12romis/esp32-elrs-rover/README.md

# ESP32-ELRS-Rover
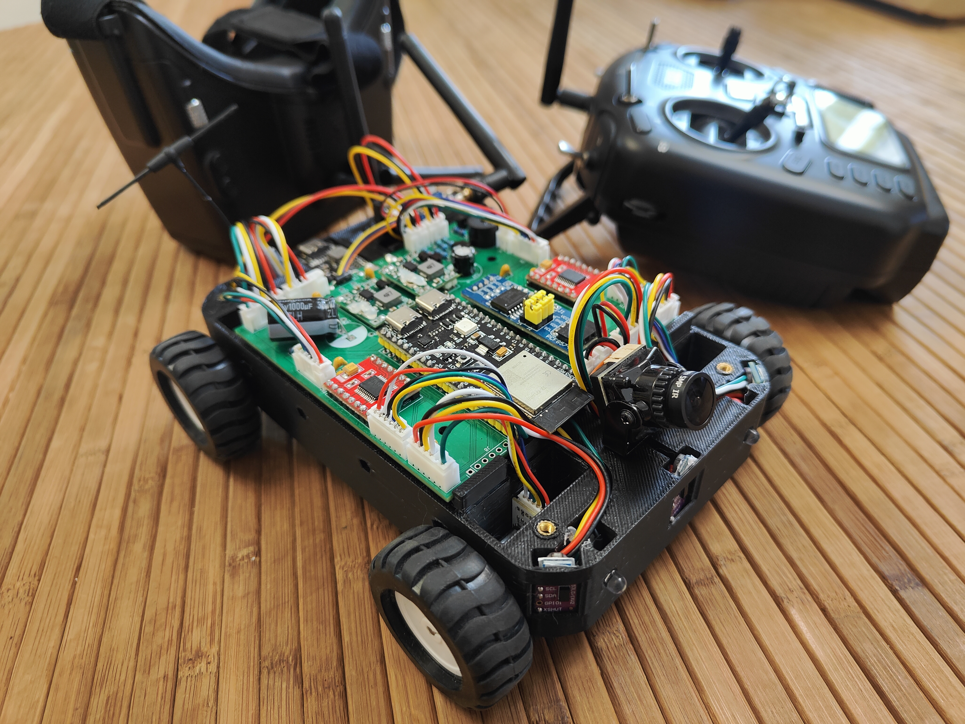
[picture p1: IMG20261026125321.jpg]

Ровер на ESP32-S3 (YD-ESP32-S3 N16R8) з керуванням через ExpressLRS/CRSF. ESP-IDF v6.1, C. Танковий привід: два борти по два колеса,
енкодери на кожному колесі, регулятор швидкості бортів, чотири далекоміри VL53L0X, світло, зумер, вбудований RGB-індикатор плати.

## Що вміє ровер

- Їде за правим стіком пульта (тяга й поворот), озброюється тумблером (канал 5), тримає швидкість бортів регулятором.
- Зупиняється при втраті звʼязку довше за 0.5 с, при напрузі акумулятора нижче 6.0 В і перед перешкодою (стан OBSTACLE_HOLD).
- Повертає на пульт напругу акумулятора (телеметрія) і показує стан утримання звуком, кольором індикатора й блиманням світла.
- Тумблер CH9 вмикає й вимикає контроль перешкод; зеленуватий індикатор плати показує, що контроль ввімкнений і реально охороняє.
- Після кожної сесії (озброєння → вихід з руху) надсилає на сервер власника звіт (JSON, MQTT поверх TLS) лише в DISARMED; невдалі
  звіти (до двох) зберігаються в пам'яті плати.
- Консоль через USB: стан, команди руху (стендовий режим), світло, зумер, енкодери, регулятор, далекоміри, звіти.

## Структура репозиторію

- `docs/` — контекст заліза й прошивки (`01-ASSEMBLY-BRINGUP.md`, `02-FIRMWARE-CONTEXT.md`), конституція (`constitution.md`),
  журнал вимірювань (`measured.md`), блок-схема (`architecture.md`), чекліст самоперевірки (`self-check.md`), дорожня карта
  (`roadmap.md`), специфікації фаз у `docs/features/<фаза>/`.
- `kicad-rover/` — схема й плата (лише читання).
- `main/`, `components/` — прошивка. Кожен компонент ділиться на `<name>_core.c` (чиста логіка, без ESP-IDF) і `<name>_hal.c`.
- `test/host/` — хостові тести чистої логіки і перевірки правил проєкту.
- `tools/bringup/` — діагностичні прошивки P0–P7 (результати — у `docs/measured.md`).

Усі номери ліній GPIO — лише в `components/board/include/board_pins.h`.

## Збірка, прошивка, тести

Збірка (потрібне середовище ESP-IDF v6.1):

```bash
source ~/.espressif/tools/activate_idf_v6.1.sh
idf.py build
```

Прошивку на плату робить Розробник через розширення ESP-IDF у VS Code (ціль `esp32s3`); агент лише збирає. Після прошивки відкрити
монітор, консоль відповідає на `help`.

Хостові тести й перевірки правил (звичайний gcc, без плати):

```bash
test/host/run_tests.sh
```

Опис перевірок — у `test/host/README.md`. Перевірки з правками захищених файлів на гілці фази: `ALLOW_PROTECTED=1 test/host/check_protected.sh`.

## Інтерфейси

### Консоль (USB)

Повний список — команда `help`. Права команд залежать від стану автомата (`status` показує стан і історію переходів).

| Команда | Призначення |
|---|---|
| `help`, `status` | довідка; стан, час роботи, пам'ять, причина скидання, сховище, світло, індикатор, пульт, **час кроку керування**, енкодери, історія переходів |
| `arm`, `drive <тяга> <поворот>` | озброєння і рух (`drive` діє 2 с) — з консолі лише в стендовому режимі, до появи пульта |
| `disarm` | роззброєння — у будь-якому стані |
| `light`, `beep` | світло й зумер: `light` у DISARMED (в ARMED лише `light head`), `beep` у DISARMED і ARMED; в OBSTACLE_HOLD обидві відхиляються |
| `enc [reset]` | знімок енкодерів |
| `pid ...` | регулятор швидкості бортів |
| `tof [reinit]` | далекоміри, сектори, поріг; `reinit` лише в DISARMED |
| `report` | звіти сесій: черга (до двох), режим контролю перешкод, мережа; у DISARMED запускає спробу передачі негайно, в інших станах лише показує стан. Пароль і SSID не друкуються: «задано / не задано» |
| `reboot`, `wdt-test` | службові (лише в безпечних станах) |

### Пульт

Канали CRSF: 1 — поворот, 2 — тяга, 5 — ARM/DISARM (тумблер), **9 — режим контролю перешкод** (див. нижче), 8 — трипозиційний перемикач, за P5 призначений під фари (у прошивці поки не використовується; докладно: `docs/02-FIRMWARE-CONTEXT.md` §1.3 і `docs/measured.md`).

**CH9 — контроль перешкод.** Значення каналу вище середини (> 992) — контроль **увімкнено**, інакше — **вимкнено** (далекоміри лише міряють,
ровер не зупиняється перед перешкодою; відсічка по напрузі, втрата зв'язку, STBY, I²C діють без змін). Поки пульт не передав
кадр або зв'язок втрачено — контроль **увімкнено** (`status` пише «за замовчуванням, пульт не підтвердив»). У мікшері EdgeTX
виведіть вибраний тумблер (SB, SC, SE чи SF) на канал CH9. Два положення цього тумблера **ще не виміряні**: Розробник записує їх у
`docs/measured.md` (spec OQ-6); до заміру канал без призначеного тумблера стоїть на 992 і вимикає захист.

### Телеметрія на пульт

Раз на 200 мс ровер надсилає кадр датчика батареї CRSF: **напруга з розв'язністю 0.1 В**. **Струм, ємність і відсоток заряду нульові
й означають «немає даних»** (датчиків немає): пульт може показувати «0 А» чи «0 %» — це не вимір. Якщо свіжого виміру напруги немає,
кадр не надсилається. На пульті датчик має знайтися автоматично (на модулі передавача співвідношення телеметрії не «вимкнено»).

### Індикація станів

| Стан | Зумер | Індикатор плати | Світло |
|---|---|---|---|
| DISARMED | короткий сигнал на вході | **зеленуватий**, якщо контроль перешкод ввімкнений і хоч один далекомір охороняє; інакше погашений | задні ліхтарі червоні, фари вручну |
| ARMED | короткий сигнал на вході | те саме (зеленуватий лише за ввімкненого контролю й охорони) | фари автоматично, задні ліхтарі: жовтий уперед, зелений назад |
| OBSTACLE_HOLD | подвійний біп на вході; на виході в ARMED — один сигнал 200 мс | **жовтий** | передній сектор зайнятий — блимають фари; задній — блимають задні ліхтарі |
| FAILSAFE | сигнал на вході, писк кожні 2 с | червоний | задні ліхтарі блимають червоним |

Пріоритет кольорів: червоний (FAILSAFE) > жовтий (OBSTACLE_HOLD) > зеленуватий > погашений. У BOOT, SELFTEST і FAULT індикатор
погашений. Консоль при вході в утримання називає **кожен** датчик сектора, що бачить перешкоду, з відстанню.

### Звіт сесії

Сесія — від озброєння до виходу з ARMED/OBSTACLE_HOLD у DISARMED чи FAILSAFE. Після неї ровер у DISARMED вмикає Wi-Fi лише на
коротку спробу (до 30 с), публікує один JSON-звіт на сервер (`rover/<mac>/session`, QoS 1) і одразу вимикає Wi-Fi. Озброєння
перериває спробу. Якщо доставити не вдалось, до двох останніх звітів лежать у пам'яті плати (переживають перезапуск, зокрема FAILSAFE
через напругу) і йдуть при наступному DISARMED або командою `report`. Поля звіту — [contracts/events.md](docs/features/phase8-session-report/contracts/events.md).

Налаштування мережі (**секрети не потрапляють у git**):

1. Скопіюйте `components/report/report_secrets.example.h` у `components/report/report_secrets.h` (файл у `.gitignore`) і заповніть
   SSID та пароль Wi-Fi, адресу й порт сервера (8883), ім'я користувача й пароль сервера. Пароль із чату вважайте скомпрометованим.
2. Покладіть кореневий сертифікат власника в `components/report/certs/root_ca.pem` (публічний, може бути в git). Дані не
   надсилаються без перевірки сертифіката сервера.
3. Після появи файлів виконайте `idf.py fullclean`. Без них збірка проходить, а передача вимкнена з одним поясненням у журналі.

Після оновлення `sdkconfig.defaults` (більший розділ застосунку, lwip на core 0) видаліть згенерований `sdkconfig` і зберіть та прошийте
заново — таблиця розділів змінюється (NVS лишається на місці).

### Відомі обмеження звіту сесії

- TP3 під Wi-Fi **не виміряно** (spec OQ-5): до заміру спроби передачі проводьте на повному акумуляторі чи живленні, що тримає межу.
- Положення CH9 на TX12 **не виміряні** (spec OQ-6, див. вище).
- Час підключення Wi-Fi і TLS, тривалість запису в пам'ять, вплив на `crc_fail` приймача **не виміряні** — чекліст приймання:
  [acceptance.md](docs/features/phase8-session-report/acceptance.md).
- Абсолютного часу немає: звіти без дат, сервер ставить мітку отримання.
- Пробіг рахується за лічильниками коліс при діаметрі 44 мм; проковзування не враховано.
## Безпека

Інваріанти (конституція, п. 7): STBY піднімається тільки в стані руху й свідомо; втрата кадрів CRSF довше за 0.5 с — ШІМ у нуль і
STBY вниз; перша операція на шині I²C — запис нуля в розширювач; напруга нижче 6.0 В — мотори не запускаються. Телеметрія й індикація
їх не змінюють і не затримують керування.

## Статус перевірки

Що перевірено на залізі, а що ні, — у `docs/self-check.md`. Приймання на залізі записує Розробник.
