12romis/esp32-elrs-rover/docs/features/phase8-session-report/_review/review-2026-10-22.md

# Рев'ю phase8-session-report — 2026-10-22

**Scope:** робоче дерево гілки `feature/phase8-session-report` проти `main` (зміни не закомічені), 55 змінених файлів + нові `components/session`, `components/report`, чотири нові хостові тести.
**Рецензент:** sdd:reviewer, чистий контекст, лише читання.
**Хостові перевірки рецензента:** `run_tests.sh` 15601/15601; усі `check_*.sh` чисті.
**Gate:** PASS (усі stage-1 розв'язано; єдина відкладена знахідка — stage-2 № 5, OQ-7). Після виправлень: `run_tests.sh` 15610/15610, усі `check_*.sh` чисті, `idf.py build` без попереджень компіляції, окрема збірка з TLS-гілкою — теж.

## Знахідки

| # | Стадія | Заголовок | Вердикт |
|---|---|---|---|
| 1 | stage-1 | Гонка: підсумок сесії з'являється на ~20 мс пізніше за вхід у DISARMED — звіт не надсилається (AC-10, AC-24) | Fixed: `report_entry_pending/ready` у `report_queue_core` (+тест), `report_hal` розв'язує вхід, коли сесія закрита; `session_hal` ставить `active=false` після відправки підсумку |
| 2 | stage-1 | OQ-6: положення CH9 не записані; 992 = «вимкнено» (AC-01, AC-04, AC-05) | Fixed (у межах агента): AC-01…AC-05 позначено у `acceptance.md` і spec OQ-6 як неприйнятні до заміру; сам замір — за Розробником (п. 13 конституції) |
| 3 | stage-1 | events.md: `mac` у таблиці на верхньому рівні, у прикладах і SAD §5 — у `fw{}` (AC-11) | Fixed: events.md (приклади) і SAD §5 вирівняно за кодом (`mac` — верхній рівень); запис в api-sync-report |
| 4 | stage-1 | AC-21/A9 «звіт це пояснює» — лише `null`, пробіг за одним бортом не позначено | Fixed: поле `encoders{left,right}` у звіті (+тести), events.md; `schema_version` лишено 1 (адитивна зміна) |
| 5 | stage-2 | Спробу не перервати озброєнням під час TCP-з'єднання/DNS (блокуючий select до 10 с) (AC-18, AC-19) | Deferred: spec §8 OQ-7, owner Розробник/Агент, due before acceptance; перевірка в кроках 12 і 20 acceptance |
| 6 | stage-2 | Класифікація «сертифікат не довірений» порівнює не ту змінну (AC-22) | Fixed: класифікація за `esp_err_t last` з `esp_tls_get_and_clear_last_error`; збірка з сертифікатом чиста |
| 7 | stage-2 | Стрибок пробігу, коли колесо стає недоступним посеред сесії (AC-20) | Fixed: приріст пробігу по колесах, доступних на двох кроках поспіль (`session_hal.c`) |
| 8 | stage-2 | Хибний рядок журналу при виході з утримання вимкненням CH9 (AC-02) | Fixed: рядок «контроль перешкод вимкнено — повернення в ARMED» |
| 9 | stage-2 | Правки bc4aedd і measured.md:17 (170 мм) змішані з фазою 8 | Fixed: measured.md:17 виправлено; відокремлення правок bc4aedd — окремим комітом під час коміту (див. handoff) |

Деталі, `file:line` і пропозиції — у звіті рецензента (див. розмову); кожна знахідка нижче доповнюється вердиктом після розв'язання.
