12romis/esp32-elrs-rover/docs/roadmap.md

---
status: living
updated_at: "2026-10-21"
---

# Roadmap — ESP32-ELRS-Rover

> **Декомпозиція, а не обіцянка.** Ідея розбита на інкрементальні кроки: що кожен крок собою являє, звідки походить, наскільки великий, і в якому порядку їх проходити. **Без дат** (крім історії завершеного), **без оцінок пріоритету** — порядок і є пріоритетом. *Рішення* для кожного кроку живе у його специфікації `docs/features/<slug>/spec.md`, не тут. Джерело вимог — `docs/02-FIRMWARE-CONTEXT.md`, розділ 7.

## Destination

Ровер на ESP32-S3 їде за стіками пульта ELRS танковим приводом з регулюванням швидкості, зупиняється при втраті звʼязку, розряді батареї чи перед перешкодою й повертає телеметрію на пульт.

## Pre-phases (P0–P7) — outside SDD

<!-- Це НЕ кроки SDD: діагностичні прошивки, вимірювальні інструменти. Для них немає ні специфікації, ні плану, ні задач; не проходять рев'ю якості коду. Живуть у `tools/bringup/` (перемикач BRINGUP_TEST). Результат — число в `docs/measured.md`; передфаза пройдена, лише коли число записане там. -->

Це діагностичні прошивки. Вони **не проходять цикл SDD**: у них немає специфікації, плану й задач. Їхній єдиний результат — числа в `docs/measured.md`, які закривають «?» у розділі 9 документа 02 (`docs/02-FIRMWARE-CONTEXT.md`, §7.0).

| ID | Передфаза | Залізо | Що закриває | Стан |
|---|---|---|---|---|
| P0 | тулчейн, чіп, PSRAM | плата з U3, USB | `sdkconfig` під N16R8 | пройдено |
| P1 | скан I²C | + U6, далекоміри від'єднані | `PCF8574_ADDR` | пройдено |
| P2 | виходи PCF8574 і світло | + фари J2/J3, ліхтарі J5/J6 | карта бітів §2.1 | пройдено |
| P3 | ADC батареї, двоточкове калібрування | акумулятор або блок на J1 | `VBAT_SCALE`, `VBAT_OFFSET`, `VBAT_CUTOFF_MV` | одна точка з двох знята (8.26 В), друга потрібна до фази 1 |
| P4 | далекоміри і перепризначення адрес | + U7…U10 на шлейфах | `TOF_OBSTACLE_MM`, драйвер VL53L0X (§10.3) | пройдено (послідовність 10/10, драйвер підтверджено); `TOF_OBSTACLE_MM` — на шасі |
| P5 | приймання CRSF | + приймач у J7 | `CRSF_BAUD`, карта каналів §1.3 | пройдено (420000, карта каналів підтверджена, CH8 = фари) |
| P6 | енкодери, обертання рукою | + мотори на шлейфах | `ENC_PULSES_PER_REV`, `ENC_NEEDS_PULLUP` | пройдено (2772 імп/оберт, підтяжки не потрібні) |
| P7 | мотори на мінімальному ШІМ і знак енкодера | усе, колеса в повітрі | `ENC_DIR_SIGN[4]`, прив'язка §2.2 | пройдено (знак +1, −1, +1, −1); FR повільний, причину перевірити |

Без прошивки вимірюються `WHEEL_DIAMETER_MM` і `WHEEL_BASE_MM` (штангенциркуль, лінійка); `MOTOR_MAX_PWM` лишається 0.75 до фази 5.

### Gates

Яка фаза не починається, доки не пройдено які передфази (`docs/02-FIRMWARE-CONTEXT.md`, §7.0):

| Фаза | Не починати, доки не пройдено |
|---|---|
| Фаза 0 — скелет | P0 |
| Фаза 1 — мотори | P0, P3, P7 |
| Фаза 2 — I²C, світло | P1, P2 |
| Фаза 3 — ELRS | P5 |
| Фази 4–5 — енкодери, PID | P6, P7 |
| Фаза 6 — далекоміри | P4 |

Фаза 7 власних воріт не має, її обмежують залежності від фаз 3, 5 і 6 (див. граф).

## Steps

<!-- Фази прошивки: проходять цикл SDD, одна фаза = одна фіча зі своїм слагом і специфікацією в docs/features/<slug>/. Слаг у колонці Step. -->

| # | Step | Source | Size | Status |
|---|---|---|:---:|---|
| 0 | `phase0-skeleton` — прошивається, консоль відповідає, WDT зареєстрований, стан BOOT друкується | `docs/02-FIRMWARE-CONTEXT.md` §7, «Фаза 0 — скелет» | S | shipped — [spec](features/phase0-skeleton/spec.md) |
| 1 | `phase1-drive` — `drive 0.3 0` крутить борти, `disarm` зупиняє, при VBAT < 6.0 В мотори не стартують | `docs/02-FIRMWARE-CONTEXT.md` §7, «Фаза 1 — живлення і мотори» | M | shipped — [spec](features/phase1-drive/spec.md) |
| 2 | `phase2-io` — світло й зумер керуються з консолі, при старті світла немає | `docs/02-FIRMWARE-CONTEXT.md` §7, «Фаза 2 — I²C, PCF8574, світло, зумер» | S | shipped — [spec](features/phase2-io/spec.md) |
| 3 | `phase3-crsf` — стіки пульта рухають мотори, вимкнення пульта зупиняє за 500 мс | `docs/02-FIRMWARE-CONTEXT.md` §7, «Фаза 3 — ELRS / CRSF» | S | shipped — [spec](features/phase3-crsf/spec.md) |
| 4 | `phase4-encoders` — чотири лічильники дають стабільні оберти зі знаком і без зривів | `docs/02-FIRMWARE-CONTEXT.md` §7, «Фаза 4 — енкодери» | S | shipped — [spec](features/phase4-encoders/spec.md) |
| 5 | `phase5-pid` — борт тримає задану швидкість під навантаженням, коефіцієнти міняються з консолі | `docs/02-FIRMWARE-CONTEXT.md` §7, «Фаза 5 — PID» | S | shipped — [spec](features/phase5-pid/spec.md) |
| 6 | `phase6-tof` — ровер зупиняється перед перешкодою, дозволяє здати назад, переживає відмову сенсора | `docs/02-FIRMWARE-CONTEXT.md` §7, «Фаза 6 — далекоміри й протизіткнення» | S | shipped — [spec](features/phase6-tof/spec.md) |
| 7 | `phase7-telemetry` — пульт бачить напругу батареї, OBSTACLE_HOLD чути й видно (подвійний біп, жовтий індикатор, блимання фар і ліхтарів), є README, блок-схема й заповнений чекліст | `docs/02-FIRMWARE-CONTEXT.md` §7, «Фаза 7 — телеметрія, інтеграція, документація»; запит Розробника 2026-10-21 (індикація OBSTACLE_HOLD) | S | shipped — [spec](features/phase7-telemetry/spec.md) |
| 8 | `phase8-session-report` — тумблер CH9 вмикає/вимикає контроль перешкод (зеленуватий індикатор), консоль називає всі датчики, що бачать перешкоду; після роззброєння ровер надсилає звіт сесії (JSON) через Wi-Fi і MQTT, Wi-Fi вимикається одразу, при невдачі лишаються дві останні сесії | запит Розробника 2026-10-22 | M | spec'd — [spec](features/phase8-session-report/spec.md) |

## Not yet specified

<!-- Туман з'явився 2026-10-20: захист від заклинення і підняття межі потужності винесено з фази 5. -->

| Area | What we'd have to learn | Blocks | How it gets sharpened |
|---|---|:---:|---|
| Захист від заклинення борту і підняття межі потужності вище 0.75 | поріг часу заклинення на 0.75 і безпечну межу вище 0.75 (заміри OQ-1, OQ-2 зі `features/phase5-pid/spec.md`); межа не піднімається, доки захисту немає | — | винесено з фази 5 рішенням Розробника 2026-10-20; оформити окремим кроком після фази 5 через `/sdd:roadmap`, коли Розробник візьметься за заміри |

## Out of scope

- — (джерела нічого не виносять за межі проєкту)

## Open decisions

| # | Question | Type | Owner | Blocks |
|---|---|:---:|:---:|:---:|
| D2 | `CRSF_BAUD`: 420000 чи 416666 (§10.2) | prototype | human | 3 |

## Decisions so far

- `PCF8574_ADDR` = `0x20`, на шині рівно один пристрій → [`docs/measured.md`](measured.md)
- Конституція проєкту з 14 пунктів (core/HAL, заборона вигадувати константи, інваріанти безпеки) → [`docs/constitution.md`](constitution.md)
- Передфази P0–P7 поза циклом SDD, один проєкт `tools/bringup` з перемикачем → [`docs/02-FIRMWARE-CONTEXT.md`](02-FIRMWARE-CONTEXT.md) §7.0
- Поточна архітектура: 1 реальний компонент і 9 заглушок → [`docs/architecture-map.md`](architecture-map.md)
- Прозвонка моторних шлейфів пройдена (піни 1–2 обмотка ≈ 12 Ом, ізоляція до пінів 3–6) → [`docs/measured.md`](measured.md)
- D3 закрито: вихід енкодера не відкритий колектор, усі чотири енкодери рахують без підтяжок, переробка плати не потрібна (`ENC_NEEDS_PULLUP` = 0, P6, 2026-10-17) → [`docs/measured.md`](measured.md)
- D4 закрито: драйвер VL53L0X — мінімальний власний (варіант 3 з §10.3), підтверджено P4 (2026-10-16) і реалізовано у `components/tof/tof_hal.c` → [`docs/measured.md`](measured.md)
- `TOF_OBSTACLE_MM` = 170 мм (вибіг ≤ 30 мм + реакція ≈ 86 + похибка датчика ≈ 12, рішення Розробника, 2026-10-21) → [`docs/measured.md`](measured.md)

## Dependency graph

```mermaid
flowchart LR
  P0["P0 · chip psram"]
  P1["P1 · i2c scan"]
  P2["P2 · pcf light"]
  P3["P3 · adc vbat"]
  P4["P4 · tof"]
  P5["P5 · crsf"]
  P6["P6 · encoders"]
  P7["P7 · motors sign"]
  s0["0 · skeleton"]
  s1["1 · drive"]
  s2["2 · io"]
  s3["3 · crsf"]
  s4["4 · encoders"]
  s5["5 · pid"]
  s6["6 · tof"]
  s7["7 · telemetry"]
  s8["8 · session report"]
  P0 -->|sdkconfig N16R8| s0
  P0 -->|sdkconfig N16R8| s1
  P3 -->|VBAT cutoff| s1
  P7 -->|ENC_DIR_SIGN, wiring| s1
  P1 -->|PCF8574_ADDR| s2
  P2 -->|bit map| s2
  P5 -->|CRSF_BAUD, channel map| s3
  P6 -->|pulses per rev, pullup| s4
  P7 -->|ENC_DIR_SIGN| s4
  P6 -->|pulses per rev| s5
  P7 -->|ENC_DIR_SIGN| s5
  P4 -->|TOF driver, threshold| s6
  P1 -->|needs working I2C scan| P4
  P6 -->|wheel to connector map| P7
  s0 -->|board_pins, build, WDT, states| s1
  s0 -->|board_pins, build, WDT, states| s2
  s1 -->|drive_set and arm disarm| s3
  s2 -->|buzzer for failsafe| s3
  s1 -->|motors wired| s4
  s4 -->|speed feedback| s5
  s2 -->|PCF8574 XSHUT, I2C mutex| s6
  s1 -->|obstacle limits drive| s6
  s3 -->|CRSF telemetry back| s7
  s5 -->|loop timing in telemetry| s7
  s6 -->|integration| s7
  s7 -->|indicator, hold line| s8
  s3 -->|CH9 switch| s8
  s5 -->|board speeds| s8
  s6 -->|ToF off switch, sensors| s8
```

## Execution path

Хвилі йдуть послідовно, одна фаза за раз, без паралельних ліній (рішення власника). Передфази з колонки Gates мають бути пройдені до початку відповідної хвилі.

| Wave | Steps | Zone per step (why parallel-safe) | Unlocks |
|:---:|---|---|---|
| 1 | 0 | 0: `main/`, `components/board/` | 1, 2 |
| 2 | 1 | 1: `components/drive/`, `components/battery/`, `main/` | 3, 4 |
| 3 | 2 | 2: `components/ioexp/`, `components/ui/` | 3, 6 |
| 4 | 3 | 3: `components/crsf/` | 7 |
| 5 | 4 | 4: `components/encoders/` | 5 |
| 6 | 5 | 5: `components/pid/` | 7 |
| 7 | 6 | 6: `components/tof/` | 7 |
| 8 | 7 | 7: `components/telemetry/`, `README.md` | 8 |
| 9 | 8 | 8: нові компоненти сесії й звіту (назви визначить design), `components/ui/`, `components/tof/`, `components/drive/`, `components/rover_console/` | — |

## Shipped

| Step | Shipped | Link |
|---|---|---|
| 0 `phase0-skeleton` | 2026-10-18 | [changelog](features/phase0-skeleton/changelog.md) |
| 1 `phase1-drive` | 2026-10-18 | [changelog](features/phase1-drive/changelog.md) (AC-13, AC-15, AC-22 чекають OQ-1) |
| 2 `phase2-io` | 2026-10-18 | [changelog](features/phase2-io/changelog.md) (AC-14, AC-15 на залізі не перевірені: розширювач запаяний) |
| 3 `phase3-crsf` | 2026-10-18 | [changelog](features/phase3-crsf/changelog.md) (AC-14 і NFR ≤ 50 мс на залізі не показані; T13–T18 на залізі не прогнані) |
| 4 `phase4-encoders` | 2026-10-19 | [changelog](features/phase4-encoders/changelog.md) (крок 2 для FL і RL поза ±2 % — прийнято як похибку ручного обертання) |
| 5 `phase5-pid` | 2026-10-20 | [changelog](features/phase5-pid/changelog.md) (приймання на залізі AC-01, -02, -05, -06, -10, -13, -14 і KPI відкладено Розробником — `acceptance.md`) |
| 6 `phase6-tof` | 2026-10-21 | [changelog](features/phase6-tof/changelog.md) (приймання на залізі AC-01…AC-12, AC-14…AC-16, KPI і OQ-2 відкладено Розробником — `acceptance.md`) |
| 7 `phase7-telemetry` | 2026-10-21 | [changelog](features/phase7-telemetry/changelog.md) (приймання на залізі AC-01…AC-16, KPI, OQ-1, OQ-3, OQ-4 чекають Розробника — `acceptance.md`) |
