12romis/esp32-elrs-rover/docs/self-check.md

# Чекліст самоперевірки

Складений за таблицею документа 02 §5 «Обсяг прошивки — що має бути реалізовано» (phase7-telemetry, AC-18). Кожен рядок має статус і
посилання на доказ. Статуси:

- **виконано** — властивість не залежить від заліза й доведена статичною перевіркою чи хостовим тестом (структура коду, таблиця переходів, правила проєкту), або поведінку на залізі прийнято Розробником (запис у журналі вимірювань);
- **частково** — частина доведена, решта названа у стовпці «Доказ і застереження»; «лише хост» означає, що поведінку на залізі не перевіряли;
- **не перевірено на залізі** — код і хостові тести є, приймання на залізі Розробник ще не записав.

Жоден пункт не позначено виконаним без доказу. Приймання на залізі записує лише Розробник.

| # | Підсистема (документ 02 §5) | Статус | Доказ і застереження |
|---|---|---|---|
| 1 | Задачі: FreeRTOS, розділення по ядрах | виконано | `control` (core 1), `crsf_rx` (core 1), `sensors`, `ui`, `battery`, `telemetry` (core 0), задача трасування `pid`: `components/*/*_hal.c`; документ 02 §6.1. Приймання фаз 0–4 — у журналі вимірювань; фази 5–7 на залізі не перевірені |
| 2 | Планування: без блокуючих затримок | виконано | `test/host/check_delays.sh` чистий; винятки (очікування готовності регістра в `battery_hal.c`, `tof_hal.c`) названо в `test/host/README.md` |
| 3 | Стани: таблиця переходів, лог переходів | виконано | `components/app_state/app_state_core.c`, 12 дозволених пар із 49, `test/host/test_app_state.c`; історія переходів у `status`. Приймання фаз 0–3 на залізі — [phase0](features/phase0-skeleton/changelog.md), [phase3](features/phase3-crsf/changelog.md) |
| 4 | Модульність: компонент на підсистему, GPIO лише в `board_pins.h` | виконано | `test/host/check_pins.sh`, `check_core_headers.sh`; `components/board/include/board_pins.h` |
| 5 | Аналогове: ADC батареї, LEDC (мотори, зумер) | частково | ADC: двоточкове калібрування в `docs/measured.md` (P3), `test/host/test_battery.c`. Мотори: [phase1](features/phase1-drive/changelog.md) — AC-13, AC-15, AC-22 чекають OQ-1. Зумер: прийнято на залізі у фазі 2 (`docs/measured.md`) |
| 6 | Цифрове: UART (CRSF), I²C (ToF, PCF8574) | частково | UART: приймання фази 3 — [changelog](features/phase3-crsf/changelog.md) (AC-14 і NFR ≤ 50 мс на залізі не показані). I²C 100 кГц: `check_bus_rules.sh`; розширювач запаяний, кроки 13–14 фази 2 не виконані ([phase2](features/phase2-io/changelog.md)); далекоміри на залізі — [phase6](features/phase6-tof/acceptance.md), не перевірено |
| 7 | Переривання: PCNT watch-point, UART event queue | частково | PCNT: приймання фази 4 — [changelog](features/phase4-encoders/changelog.md) (крок 2 для FL і RL поза ±2 % прийнято як похибку ручного обертання). Подієва черга UART — фаза 3 |
| 8 | Обмін між задачами: черги, без глобальних змінних | частково | Для знімків використано `portMUX` (ADR-0001 фази 4), для команд моторів — черга; це відступ від «лише черги» документа 02, зафіксований у ADR фаз 1–6 ([phase4 ADR-0001](features/phase4-encoders/adr/)) |
| 9 | Синхронізація: мʼютекс шини, спільна памʼять під захистом | виконано | `i2c_bus_lock` (ADR-0001 фази 2), `m_ui` у `ui_hal.c`, знімки під `portMUX`; `check_bus_rules.sh` |
| 10 | Зворотний звʼязок: енкодери → швидкість борту | не перевірено на залізі | Фаза 4 прийнято на залізі ([changelog](features/phase4-encoders/changelog.md)); використання в регуляторі — фаза 5, приймання відкладено ([changelog](features/phase5-pid/changelog.md)) |
| 11 | Регулювання: PID по швидкості на борт | не перевірено на залізі | `test/host/test_pid.c`; приймання AC-01, -02, -05, -06, -10, -13, -14 і KPI відкладено Розробником ([phase5 acceptance](features/phase5-pid/acceptance.md)) |
| 12 | Налаштування: коефіцієнти PID у NVS + консольні команди | не перевірено на залізі | `pid ...` у `help`, тести `test_console.c`; збереження в NVS на залізі не показано ([phase5](features/phase5-pid/changelog.md)) |
| 13 | Граничні умови: saturation, anti-windup, PCNT, кліп CRSF | частково (лише хост) | На залізі не перевірено (PID — фаза 5, відкладено). Хостові тести `test_pid.c`, `test_encoders.c`, `test_crsf.c` (межі, кліп, переповнення лічильників) |
| 14 | Watchdog: Task WDT, підписані періодичні задачі | частково | Фаза 0: перезавантаження після `wdt-test` ≈ 4.67 с (`docs/measured.md`). Задача `sensors` свідомо без Task WDT ([phase6 SAD §1](features/phase6-tof/sad.md)); `ui` і `telemetry` працюють і без нього, якщо підписка не вдалася |
| 15 | Помилки периферії: `esp_err_t` скрізь, деградація, таймаут CRSF | частково | Деградація без розширювача й відмова далекоміра покриті хостовими тестами; на залізі не перевірено ([phase2](features/phase2-io/changelog.md), [phase6](features/phase6-tof/acceptance.md)) |
| 16 | Валідація вводу: CRC8, довжина, діапазон каналів, відсів викидів ToF | частково (лише хост) | CRC8 і довжина кадру CRSF прийнято на залізі у фазі 3; відсів викидів ToF на залізі не перевірено (фаза 6). Хостові тести: `test_crsf.c`, `test_tof.c` (медіана з трьох, відлік «поза діапазоном») |
| 17 | Поведінка при збої: FAILSAFE/FAULT, ніколи `abort()` | частково | FAILSAFE: приймання фази 3 (кроки 4–12, «ок»). OBSTACLE_HOLD і відмова далекоміра на ходу — не перевірено на залізі |

## Що додає фаза 7

| Пункт | Статус | Доказ і застереження |
|---|---|---|
| Телеметрія напруги на пульт | не перевірено на залізі | `test/host/test_telemetry.c`; приймання — [acceptance.md](features/phase7-telemetry/acceptance.md), spec OQ-1 |
| Час кроку керування в `status` | не перевірено на залізі | `test_telemetry.c`; значення після 60 с руху — у `acceptance.md` |
| Індикація OBSTACLE_HOLD (подвійний біп, жовтий, блимання) | не перевірено на залізі | `test/host/test_ui.c`; колір і дребезг — spec OQ-3, OQ-4 |
| README, блок-схема, чекліст | виконано | `README.md`, [architecture.md](architecture.md), цей файл |

## Відкладені приймання фаз 1–6 (за дорожньою картою)

Фаза 1: AC-13, AC-15, AC-22 · фаза 2: AC-14, AC-15 · фаза 3: AC-14 і NFR ≤ 50 мс, кроки T13–T18 · фаза 4: крок 2 для FL і RL поза ±2 % ·
фаза 5: AC-01, -02, -05, -06, -10, -13, -14 і KPI · фаза 6: AC-01…AC-12, AC-14…AC-16, KPI і OQ-2. Джерело: розділ «Shipped» у
`docs/roadmap.md`. Цим чекліст їх не закриває.
