12romis/esp32-elrs-rover/docs/constitution.md

# Конституція проєкту ESP32-ELRS-Rover

Правила, які **не підлягають обговоренню агентом** ні на якій стадії SDD. Пункти 1–9 — з `docs/02-FIRMWARE-CONTEXT.md`, розділ 7.0.2, «Проєкт конституції»; пункти 10–14 додані за погодженням із користувачем. Ці правила підключені в `CLAUDE.md` (`@docs/constitution.md`), тож їх читає кожна сесія і кожна стадія.

1. Джерело істини про залізо — `kicad-rover/kicad-rover.net`. Якщо документ і нетліст розходяться, правий нетліст, і про розходження треба сказати вголос.

2. Номери GPIO існують рівно в одному файлі: `components/board/include/board_pins.h`. Літерал номера піна будь-де ще — дефект, навіть якщо значення правильне.

3. Величини з розділу 9 документа `02-FIRMWARE-CONTEXT.md` не вигадуються. Якщо потрібна константа, якої немає в `docs/measured.md` — зупинитись і назвати, якого заміру бракує. Підставити «типове значення» заборонено.

4. Специфікація фази не пишеться, доки її вхідні константи невідомі.

5. ESP-IDF v6.1, тільки нові драйвери: `esp_adc`, `gptimer`, `pulse_cnt`, `i2c_master`. Legacy-заголовки `driver/adc.h`, `driver/timer.h`, `driver/pcnt.h` у v6.0 видалені; `driver/i2c.h` застарілий. Код, що їх використовує, не компілюється — це не стильова преференція.

6. Кожен компонент ділиться на `<name>_core.c` (без жодного заголовка ESP-IDF) і `<name>_hal.c`. Логіка живе в core і покривається тестами на хості. Для HAL тести на моках не пишуться: критерій приймання — перевірка на залізі, записана в журнал bring-up.

7. Інваріанти безпеки, сильніші за будь-яку функціональність:
   - STBY піднімається тільки в стані ARMED і тільки свідомо;
   - втрата кадрів CRSF довша за 500 мс → ШІМ у нуль, STBY вниз;
   - перша операція по I²C після старту — запис `0x00` у PCF8574;
   - VBAT < 6.0 В → мотори не запускаються.

8. Будь-яка задача вважається завершеною лише якщо `idf.py build` проходить без помилок і без нових попереджень.

9. Мова коментарів і комітів — українська; ідентифікатори — англійська.

10. Канонічні файли проєкту не змінюються без явної згоди користувача: кореневий `CMakeLists.txt`, `.vscode/`, `sdkconfig.defaults`. Від них залежать IntelliSense (розширення ESP-IDF) і конфігурація octal PSRAM.

11. Каталог `kicad-rover/` агент не редагує: залізо читається, але не змінюється. Розбіжність між документом і нетлістом озвучується (пункт 1), а не «виправляється» правкою файлів проєкту плати.

12. Мотори вмикаються лише після прозвонювання розпіновки моторних шлейфів (розділ 4 документа `01-ASSEMBLY-BRINGUP.md`). До того жодна діагностична чи основна прошивка не подає ШІМ і не піднімає STBY.

13. Результат кожної передфази записується в `docs/measured.md` до того, як будь-який код чи специфікація використає це значення. Незаписане число для пунктів 3 і 4 не існує.

14. Шина I²C працює на 100 кГц, підвищувати до 400 кГц заборонено (розділ 4.6 документа `02-FIRMWARE-CONTEXT.md`). Усі періодичні задачі використовують `vTaskDelayUntil`, а не `vTaskDelay` (розділ 8.5).
