12romis/esp32-elrs-rover/docs/features/phase5-pid/_review/review-2026-10-20-r3.md

---
feature: phase5-pid
stage: review
date: 2026-10-20
round: 3
feature_size: "S"
route: quick
gate: CHANGES REQUESTED
---

# Review — phase5-pid (2026-10-20, раунд 3)

## Scope

Повторне рев'ю після виправлень T17–T20 за раундом 2 (`review-2026-10-20-r2.md`, N1–N4). Незакомічене робоче дерево на гілці `feature/phase5-pid` поверх `df1e5f0` (`git diff HEAD` + невідстежувані файли); трейлерів `SDD-AC` немає, заявлені AC — з `tasks.json`. Рев'юер: `sdd:reviewer` (opus), чистий контекст, обидві стадії, уся фіча.

Перевірки рев'юера:
- `test/host/run_tests.sh`: 6689 з 6689, 4.36 с (NFR — 5 с); покриття пар станів 49/49, команда×стан 63/63, форма pid×стан 49/49, команда×стан×режим 140/140, light канал×стан 21/21.
- `check_*.sh` (7 скриптів) і `selftest_tools.sh` — чисті.
- `idf.py build` начисто в окремий каталог: rc=0, жодного `warning:` компілятора; 5 попереджень CMake `component_validation` — з ESP-IDF, існували до фази 5.

Трасування: US-01…US-09 → AC → потоки 1–5 `sad.md` §6 — повне; US-07, AC-11, AC-17 винесено (§3). Апаратні AC (AC-01, -02, -05, -06, -10, -13, -14) приймаються лише через T10/`acceptance.md` (AC-20). Інваріанти конституції п. 7 і межа 0.75 не змінені. Регресій F1–F9 немає.

### Стан N1–N4

| # | Вердикт | Доказ |
|---|---|---|
| N1 | FIXED | `tasks.json`: T12 `["AC-03","AC-12"]`, T15 `["AC-16","AC-18"]`, T10 містить AC-05 і AC-06; `acceptance.md:3`, `:22` узгоджені |
| N2 | FIXED | `pid_core.c:456-464` (`pid_save_mark`); тест `test_pid.c:474-481` зі стартовим `saved=true` |
| N3 | FIXED | `pid_hal.c:160-164`: під `s_mux` лише позначка й `s_load`, текст — поза секцією |
| N4 | FIXED | `pid_hal.c:103-127`: ознака під `s_mux`, `app_state_get` поза секцією під ознакою, рішення в `pid_mode_change` (`pid_core.c:76-81`), ознака знімається на кожному шляху; тест `test_pid.c:535-553` |

## Findings

- **R1 [stage-2] Ознаку «триває збереження» тримає й зміна режиму, а тексти відмови й коментарі описують лише збереження.** `components/pid/pid_hal.c:105-108`; `components/drive/drive_core.c:159`, `:471`, `:549`, `:650`; `components/drive/drive_hal.c:350`, `:355`; `components/pid/include/pid_hal.h:15`, `:20`, `:27`, `:30`; `components/pid/include/pid_core.h:92-99`. AC: AC-15.
  - Сценарій: `pid off` у DISARMED і в ту ж мить тумблер ARM → озброєння відхиляється з текстом «триває збереження набору регулятора», хоча в памʼять нічого не пишеться; фронт тумблера витрачено (`drive_core.c:545`). Безпечно (DISARMED, вікно — мікросекунди), але текст неточний; коментарі заголовків застарілі (`pid_hal.h:20`, `:27`, сирота `:30`; `pid_core.h:92`).
  - **Verdict: Fix now:** окрема ознака зміни режиму в `pid_guard_t` і окрема причина відмови озброєння («триває зміна режиму регулятора»); оновити коментарі в `pid_hal.h` і `pid_core.h`.

## Gate

**CHANGES REQUESTED.** Stage-1 зауважень немає; N1–N4 виправлено, регресій F1–F9 немає. Єдине зауваження R1 [stage-2] — з рішенням Fix now. Відкладених немає, `spec.md` не змінено.

Після виправлення (`/sdd:implement phase5-pid`) треба повторно переглянути змінене: `pid_core.c`/`pid_core.h` (ознака), `pid_hal.c`/`pid_hal.h`, `drive_core.c`/`drive_hal.c` (причина відмови озброєння), `test_pid.c`, `test_drive.c`.
