12romis/esp32-elrs-rover/docs/features/phase5-pid/_review/review-2026-10-20-r4.md

---
feature: phase5-pid
stage: review
date: 2026-10-20
round: 4
feature_size: "S"
route: quick
gate: CHANGES REQUESTED
---

# Review — phase5-pid (2026-10-20, раунд 4)

## Scope

Повторне рев'ю після T21 за раундом 3 (`review-2026-10-20-r3.md`, R1). Незакомічене робоче дерево на гілці `feature/phase5-pid` поверх `3fd8c33` (`git diff HEAD` + невідстежувані файли); заявлені AC — з `tasks.json`. Рев'юер: `sdd:reviewer` (opus), чистий контекст, обидві стадії, уся фіча.

Перевірки рев'юера:
- `test/host/run_tests.sh`: 6697 з 6697, 4.27 с (NFR — 5 с); покриття пар станів 49/49, команда×стан 63/63, форма pid×стан 49/49, команда×стан×режим 140/140, light канал×стан 21/21.
- `check_*.sh` (7 скриптів) і `selftest_tools.sh` (28 перевірок) — чисті.
- `idf.py build` начисто в окремий каталог: rc=0, жодного `warning:` компілятора; 5 попереджень CMake `component_validation` — з ESP-IDF, існували до фази 5; `rover.bin` 0x54c60, 67 % розділу вільно.

Трасування: US-01…US-09 → AC → потоки 1–5 `sad.md` §6 — повне; US-07, AC-11, AC-17 винесено (§3). Апаратні AC (AC-01, -02, -05, -06, -10, -13, -14) — лише в T7, T8, T10 (`review`) і `acceptance.md` (AC-20). Інваріанти конституції п. 7 і межа 0.75 не змінені. Регресій F1–F9, N1–N4 немає.

### Стан R1

| # | Вердикт | Доказ |
|---|---|---|
| R1 | FIXED | `pid_core.h:94` (`changing`), `pid_core.c:213`, `:223-241` (`pid_guard_try_mode`, `pid_busy_t` у `pid_guard_try_arm`); `pid_hal.c:103-127`; `drive_hal.c:351`, `:356`; тексти `drive_core.c:160`, `:653-655`; коментарі `pid_hal.h:15-33`, `pid_core.h:88-108`; тест `test_pid.c:518-545` ловить мутації ознак |

## Findings

- **S1 [stage-2] Логіка відмови озброєння (зокрема вибір причини SAVE/MODE) живе в HAL і на хості не перевіряється.** `components/drive/drive_hal.c:346-357`. Правило: конституція п. 6; AC-15, AC-18.
  - Сценарій: мутація, що міняє гілки тернарних операторів у `:351`/`:356` чи губить `out.events &= ~DRIVE_EVT_REMOTE_ARMED`, проходить усі 6697 тестів і збірку; мікросекундну гонку на залізі не відтворити. `test_pid_mode_change_reason` (`test_drive.c:1284-1292`) перевіряє лише тексти.
  - **Verdict: Fix now:** винести блок у `drive_core` (`drive_arm_refused(o, have_req, busy)`), HAL лише викликає; тест на обидва `pid_busy_t` × консоль/пульт.
- **S2 [stage-2] Застарілі коментарі й цифра після R1.** `components/pid/pid_hal.c:25`, `components/pid/pid_core.c:202` (немає зміни режиму у взаємному виключенні); `docs/features/phase5-pid/acceptance.md:24` (образ 0x54510, збірка дає 0x54c60).
  - **Verdict: Fix now:** дописати «…і зміна режиму», оновити розмір образу.

## Gate

**CHANGES REQUESTED.** Stage-1 зауважень немає; R1 виправлено, регресій немає. S1 і S2 [stage-2] — з рішенням Fix now. Відкладених немає, `spec.md` не змінено.

Після виправлень (`/sdd:implement phase5-pid`) треба повторно переглянути змінене: `drive_core.c`/`drive_core.h` (`drive_arm_refused`), `drive_hal.c`, `test_drive.c`, `pid_hal.c:25`, `pid_core.c:202`, `acceptance.md`.
