12romis/esp32-elrs-rover/docs/features/phase5-pid/_review/review-2026-10-20-r5.md

---
feature: phase5-pid
stage: review
date: 2026-10-20
round: 5
feature_size: "S"
route: quick
gate: PASS
---

# Review — phase5-pid (2026-10-20, раунд 5)

## Scope

Повторне рев'ю після T22–T23 за раундом 4 (`review-2026-10-20-r4.md`, S1, S2). Незакомічене робоче дерево на гілці `feature/phase5-pid` поверх `fa5f885` (`git diff HEAD` + невідстежувані файли); заявлені AC — з `tasks.json`. Рев'юер: `sdd:reviewer` (opus), чистий контекст, обидві стадії, уся фіча.

Перевірки рев'юера:
- `test/host/run_tests.sh`: 6704 з 6704, 4.45 с (NFR — 5 с); покриття пар станів 49/49, команда×стан 63/63, форма pid×стан 49/49, команда×стан×режим 140/140, light канал×стан 21/21.
- `check_*.sh` (7 скриптів) і `selftest_tools.sh` — чисті.
- `idf.py build` начисто в новий каталог: rc=0, 1051 C-обʼєкт, жодного `warning:` компілятора; 5 попереджень CMake `component_validation` — з ESP-IDF, існували до фази 5; `rover.bin` 0x54c70, 67 % розділу вільно.

Трасування: US-01…US-09 → AC → потоки `sad.md` §6 — повне; US-07, AC-11, AC-17 винесено (§3). Апаратні AC (AC-01, -02, -05, -06, -10, -13, -14) — лише в T7, T8, T10 (`review`), приймаються за `acceptance.md` (AC-20). `tasks.json`, `tracker.md` і frontmatter T1–T23 узгоджені. Інваріанти конституції п. 7 і межа 0.75 (`DRIVE_PWM_MAX_PERMILLE 750`) не змінені. Регресій F1–F9, N1–N4, R1 немає.

### Стан S1, S2

| # | Вердикт | Доказ |
|---|---|---|
| S1 | FIXED | `drive_arm_refused` — `drive_core.c:698-711`, `drive_core.h:193-196`; HAL лише викликає (`drive_hal.c:342-349`); тест `test_pid_arm_refused` (`test_drive.c:1294-1320`) ловить мутації: переставлені гілки причини/`arm_block`, вилучене зняття події, запиту чи `accepted` |
| S2 | FIXED | `pid_hal.c:25`, `pid_core.c:202` згадують зміну режиму; `acceptance.md:22`, `:24` — 6704 тести, образ 0x54c70 |

## Findings

REVIEW_CLEAN — нових зауважень немає.

## Gate

**PASS.** Stage-1 і stage-2 зауважень немає; усі зауваження раундів 1–4 закриті (F7 — Not an issue). Відкладених немає, `spec.md` не змінено.

Лишається поза рев'ю коду: апаратне приймання T7, T8, T10 Розробником за `acceptance.md` (AC-20); реалізація й правка `docs/constitution.md` (F7) досі не закомічені — за рішенням Розробника.
