12romis/esp32-elrs-rover/docs/features/phase4-encoders/_review/review-2026-10-19-r2.md

# Review (повторний) — phase4-encoders — 2026-10-19

- **Gate:** PASS — F1–F5 закрито (F4 — разом з OQ-2); нові N1, N2 виправлено
- **Reviewer:** незалежний `sdd:reviewer` (clean context, read-only), модель opus, effort high (розмір S, маршрут quick)
- **Base:** `0dcca1c` (HEAD першого огляду, `review-2026-10-19.md`) → `033a786` (HEAD гілки `feature/phase4-encoders`)

## Scope

Diff `0dcca1c..033a786`: 17 файлів, +431 / −31. Задачі-виправлення T9–T12 (знахідки F1–F5 першого огляду).

Код і тести: `components/encoders/encoders_core.c`, `encoders_hal.c`, `include/encoders_core.h`, `components/rover_console/console_core.c`, `console_hal.c`, `include/console_core.h`, `test/host/test_encoders.c`, `test_console.c`. Документи: `acceptance.md`, `spec.md` (лише §8), `tasks.json`, `tasks/`, `_review/review-2026-10-19.md`.

Перевірено рецензентом: `run_tests.sh` тричі — 5622/5622, 140/140 пар, 3.20–3.32 с; усі `check_*.sh` і `selftest_tools.sh` чисті; чиста `idf.py build` у scratch — exit 0, 0 попереджень компілятора (5 попереджень CMake з ESP-IDF, були до фази); `git status` чистий. Крім діапазону фіксів, ще раз пройдено весь ланцюжок US-01…US-07 → AC-01…AC-12 на `2870d32..033a786` — жоден AC не випав.

## Статус знахідок першого огляду

| # | Статус | Підстава |
|---|---|---|
| F1 | RESOLVED | `encoders_core.c:36` (інтервал лише за `dt ≥ ENC_MIN_INTERVAL_US`), `:43-47` (рух у `pending`, швидкість = `pending / dt`), `:52` (мітка лише на інтервалі); тест `test_speed_catchup_burst` (`test_encoders.c:264-299`) |
| F2 | RESOLVED | `console_core.c:477-492` (`console_parse_enc`), `:137-152` (`console_msg_enc_error` — текст за причиною з обома формами), `console_hal.c:206`; тест `test_enc_error_reason` (`test_console.c:523-547`) |
| F3 | RESOLVED | `acceptance.md`, крок 13 — AC-03 у FAILSAFE |
| F4 | DEFERRED-OK | spec §8 OQ-2 (owner, due); час прогону в `acceptance.md` |
| F5 | RESOLVED | `encoders_core.h:20` (`const char *reason`), `encoders_core.c:72`; усі виклики — рядки статичного часу життя (`encoders_hal.c:106,134,143`); `_Static_assert` `encoders_hal.c:36`, 184 байти на цілі; тест `test_reason_not_copied` |

## Findings

<!-- Знахідки дописуються по одній після рішення власника. -->

### N1 — [stage-2] SAD не описує правило мінімального інтервалу

- **Де:** `docs/features/phase4-encoders/sad.md:113`; `encoders_core.c:36,43-52`, ADR-0001.
- **Суть:** SAD досі каже «швидкість = приріст останнього інтервалу / (мітка − попередня мітка)»; після T9 вибірка з `dt < ENC_MIN_INTERVAL_US` інтервалом не є, її рух іде в наступний інтервал, мітка й лічильник інтервалів не змінюються. Фаза 5 проєктуватиме регулятор за SAD.
- **Verdict:** Fix now (документ) — sad.md §4 доповнено порогом `ENC_PERIOD_US / 2`, накопиченням у `pending` і тим, що мітка й лічильник змінюються лише на інтервалі (посилання на F1, T9).

### N2 — [stage-2] Коментар `last_us` неточний

- **Де:** `components/encoders/include/encoders_core.h:31`; пов'язане `contracts/cli.md:26`.
- **Суть:** «мітка попередньої вибірки», а тепер це мітка останнього інтервалу; різниця в заголовку знімка ≤ 10 мс, на допуски не впливає.
- **Verdict:** Fix now (коментар) — «мітка останнього інтервалу вимірювання … (короткі вибірки її не змінюють)»; контракт без змін. Раннер 5622/5622, `idf.py build` без попереджень.

### OQ-2 — час хостового прогону (рішення власника поза знахідками)

- **Суть:** повторний огляд намірив 3.20–3.32 с, Агент — 3.3–3.7 с при NFR «≤ 5 с»; 6.1 с першого огляду — навантаження машини.
- **Verdict:** spec §8 OQ-2 закрито виміром; поріг і раннер без змін; `acceptance.md` оновлено.

## Gate

**PASS** — F1, F2, F3, F5 RESOLVED; F4 закрито разом з OQ-2; N1 і N2 виправлено (документ і коментар). Відкритих знахідок stage-1 немає.

## Залишки приймання на залізі (не блокують огляд)

- Кроки 1–13 `acceptance.md`, зокрема скидання апаратного лічильника на ±30000 (крок 5, ADR-0002) і AC-03 у FAILSAFE (крок 13). T5, T6, T8 лишаються `review` до запису Розробника.
