12romis/esp32-elrs-rover/docs/features/phase4-encoders/tasks/t1-encoders-core-accumulate.md

---
id: T1
title: "Створити encoders_core: приріст за модулем 30000, знак колеса, 64-бітний накопичувач, обнулення через зсув"
layer: "domain"
deps: []
blocks: ["T2"]
acs: ["AC-04", "AC-09"]
files_hint: ["components/encoders/encoders_core.c", "components/encoders/include/encoders_core.h", "components/encoders/include/encoders_calib.h", "test/host/test_encoders.c", "components/encoders/CMakeLists.txt"]
owner: "Агент"
estimate: "M"
context_budget: "M"
status: "done"
step: "COMMIT"
---

<!-- To the executing agent: work from what is inlined here. If a slice is insufficient, ambiguous, or contradicts the code in front of you, open the named file for the full text and follow that. Do not invent the missing part. -->

# T1 — Створити encoders_core: приріст за модулем 30000, знак колеса, 64-бітний накопичувач, обнулення через зсув

## Place in the sequence

- **Blocked by:** — · **Blocks:** T2 — Додати в encoders_core швидкість колеса: приріст на фактичний час, нуль на порожньому інтервалі, лічильник інтервалів · **Wave:** 1.
- **Lane:** спільні файли з T2, T3, T5 — серіалізовано.

## Why (user story)

> **As a** Розробник
> **I want** щоб лічильник колеса рахував без стрибків і втрат на найбільшій дозволеній потужності й довгому русі, а нерухоме колесо не набирало хибних імпульсів
> **So that** швидкість, на яку спиратиметься фаза 5, правдива
>
> — `spec.md §4, US-03, verbatim` · full text: [spec.md](../spec.md)

Чиста функція, яка робить лічильник колеса безперервним через межу апаратного лічильника і дає знак «вперед = плюс».

## Inlined context

> Накопичення — різниця за модулем у core — апаратний лічильник з межами ±30000 сам скидається в нуль; `encoders_core` обчислює приріст за модулем 30000 у межах (−15000, 15000], множить на знак колеса і додає до 64-бітного накопичувача. Без переривань і без watch-point (ADR-0002).
>
> — `sad.md §4, стратегічний вибір 2, verbatim` · full text: [sad.md](../sad.md)

> `encoders_calib.h`: `ENC_PULSES_PER_REV 2772`, `ENC_DIR_SIGN {+1, −1, +1, −1}` (FL, FR, RL, RR), `WHEEL_DIAMETER_MM 44` — кожна з позначкою «виміряно: дата» і посиланням на `docs/measured.md`.
> Обнулення: `encoders_reset()` під `portMUX` встановлює зсув = накопичувач для доступних коліс (накопичувач і швидкість не змінюються, тож стрибка швидкості немає, spec AC-09); показ = накопичувач − зсув.
>
> — `sad.md §4, журнал припущень, abridged` · full text: [sad.md](../sad.md)

> | Діапазон накопичення | без переповнення щонайменше 10^15 імпульсів у кожен бік (на 20 000 імпульсів/с — понад 1500 років безперервного обертання) | хостовий тест накопичення біля граничних значень |
>
> — `spec.md §6, «Діапазон накопичення», verbatim` · full text: [spec.md](../spec.md)

> **Chosen:** варіант 1. Уся логіка переходу через межу стає чистою функцією з вичерпними тестами на хості (перехід вгору й вниз, багаторазовий, з одночасним рухом, граничні значення накопичувача), без переривань і без спільного стану з ISR.
>
> — `adr/0002, Decision outcome, abridged` · full text: [0002-accumulate-counts-by-modular-difference-in-encoders-core.md](../adr/0002-accumulate-counts-by-modular-difference-in-encoders-core.md)

> **Hard rule:** Кожен компонент ділиться на `<name>_core.c` (без жодного заголовка ESP-IDF) і `<name>_hal.c`. Логіка живе в core і покривається тестами на хості.
>
> — `constitution.md, п. 6, abridged` · full text: [constitution.md](../../../constitution.md)

> **Hard rule:** Величини з розділу 9 документа `02-FIRMWARE-CONTEXT.md` не вигадуються. Якщо потрібна константа, якої немає в `docs/measured.md` — зупинитись і назвати, якого заміру бракує.
>
> — `constitution.md, п. 3, abridged` · full text: [constitution.md](../../../constitution.md)

**Fallback:** insufficient or contradicted by the code → read the named file in full ([spec.md](../spec.md) · [sad.md](../sad.md) · [contracts/cli.md](../contracts/cli.md) · [adr/](../adr/)) and follow it. Do not guess.

## Data delta

No DB changes.

## API contract

Internal — no API surface.

## Acceptance criteria

### AC-04 (US-03) — domain invariant

> **Given** ровер озброєний з пульта, колеса в повітрі, лічильники обнулено
> **When** Розробник тримає стік повністю вперед (обидва борти на обмеженні потужності 0.75) безперервно, доки лічильник кожного колеса не перевищить 100 000 імпульсів (понад три повні діапазони апаратного лічильника ±32767), але не менше 10 с і не довше 60 с, кілька разів показуючи знімок енкодерів, а потім так само повністю назад
> **Then** лічильник кожного колеса за час руху вперед лише зростає і проходить 100 000 імпульсів без стрибка, скидання чи зміни знака (колесо, що за 60 с не набрало 100 000, — несправність заліза за AC-02, записується в журнал bring-up); приріст лічильника між сусідніми знімками дорівнює середньому швидкостей цих двох знімків, помноженому на різницю часу від старту між ними, з точністю 5 %; під час руху назад лічильник так само лише спадає; швидкість у жодному знімку не має «викидів» понад 10 % від сусідніх знімків при незмінному стіку
>
> — `spec.md §5, AC-04, verbatim` · full text: [spec.md](../spec.md)

### AC-09 (US-02) — domain invariant

> **Given** ровер у будь-якому стані, зокрема в ARMED під час руху з пульта
> **When** Розробник обнуляє лічильники командою енкодерів
> **Then** лічильники й пройдена відстань усіх чотирьох коліс стають нулем одночасно, а консоль це підтверджує; швидкість не стрибає (вона рахується з різниці за інтервал), стан автомата, озброєння й команди бортам не змінюються; обнулити лічильники можна лише з консолі — пульт такої дії не має, а жодна консольна команда не змінює виміряні величини (імпульси на оберт, знак коліс, діаметр)
>
> — `spec.md §5, AC-09, verbatim` · full text: [spec.md](../spec.md)

## Checklist

- [ ] Створити `encoders_calib.h` з трьома константами, датами виміру й посиланням на `docs/measured.md` — `components/encoders/include/encoders_calib.h`
- [ ] Оголосити стан колеса (накопичувач `int64_t`, зсув, попереднє сире значення, ознака першої вибірки) і функції кроку та обнулення — `components/encoders/include/encoders_core.h`
- [ ] Реалізувати приріст за модулем 30000 у (−15000, 15000], множення на знак колеса, накопичення; перша вибірка лише запам'ятовує сире значення — `components/encoders/encoders_core.c`
- [ ] Реалізувати обнулення через зсув (показ = накопичувач − зсув), без зміни накопичувача — `encoders_core.c`
- [ ] Додати `encoders_core.c` у SRCS компонента — `components/encoders/CMakeLists.txt` (лише SRCS core; HAL — T5)
- [ ] Тести: перехід вгору й вниз через межу, багаторазовий перехід, рух 14999 і 15000 за вибірку, знак кожного колеса, накопичувач біля ±10^15, обнулення без зміни накопичувача — `test/host/test_encoders.c`

## Edge cases

| Case | Behaviour |
|---|---|
| приріст рівно +15000 чи −15000 | +15000 (межа включена зверху), −15000 зводиться до +15000 — задокументувати в тесті |
| перша вибірка після старту | приріст 0, лише запам'ятовується сире значення |
| обнулення під час руху | показ стає 0, далі росте від нуля; накопичувач не змінюється |
| накопичувач понад 10^15 | без переповнення; тест біля граничних значень |

## Definition of Done

- [ ] `test/host/run_tests.sh` зелений, серед тестів — усі випадки з чекліста; `check_core_headers.sh` чистий для `encoders_core.c`; `idf.py build` без помилок і нових попереджень
- [ ] every Hard Rule inlined above still holds
- [ ] lint + vet clean (для C: збірка без нових попереджень і хостові скрипти)
