12romis/esp32-elrs-rover/docs/features/phase4-encoders/tasks/t5-encoders-hal-task.md

---
id: T5
title: "Створити encoders_hal: 4 блоки лічильника з watch-point без callback, фільтр 1000 нс, задача 20 мс, стан під portMUX"
layer: "infra"
deps: ["T3"]
blocks: ["T6"]
acs: ["AC-04", "AC-05", "AC-08"]
files_hint: ["components/encoders/encoders_hal.c", "components/encoders/include/encoders_hal.h", "components/encoders/CMakeLists.txt"]
owner: "Агент (код); Розробник (приймання на залізі)"
estimate: "M"
context_budget: "M"
status: "done"
step: "COMMIT"
---

<!-- To the executing agent: work from what is inlined here. If a slice is insufficient, ambiguous, or contradicts the code in front of you, open the named file for the full text and follow that. Do not invent the missing part. -->

# T5 — Створити encoders_hal: 4 блоки лічильника з watch-point без callback, фільтр 1000 нс, задача 20 мс, стан під portMUX

## Place in the sequence

- **Blocked by:** T3 — Додати в encoders_core одиниці (оберти, об/хв, см, см/с), доступність коліс і тексти знімка, enc reset та рядка status · **Blocks:** T6 — Підключити encoders_start у main і колбеки enc_snapshot, enc_reset, enc_status у консоль · **Wave:** 4.
- **Lane:** спільні файли з T1 — серіалізовано.

## Why (user story)

> **As a** Розробник
> **I want** щоб лічильник колеса рахував без стрибків і втрат на найбільшій дозволеній потужності й довгому русі, а нерухоме колесо не набирало хибних імпульсів
> **So that** швидкість, на яку спиратиметься фаза 5, правдива
>
> — `spec.md §4, US-03, verbatim` · full text: [spec.md](../spec.md)

Тонкий HAL, що читає апаратні лічильники кожні 20 мс і подає їх у `encoders_core`.

## Inlined context

> - Задача `encoders`: пріоритет 4, ядро 1 (поруч із `control` і `crsf_rx`, нижче за них), стек 3072 байти, період 20 мс через `vTaskDelayUntil`, підписана на Task WDT.
> - Блок лічильника на колесо: межі ±30000, без `accum_count`, з watch-point на +30000 і −30000 без callback (вони лише вмикають апаратні порівнювачі меж, як у P6, тож лічильник скидається в нуль на межі; переривань немає); два канали з діями фронтів і рівнів як у P6 (×4, той самий напрямок, що дав виміряні знаки); фільтр завад 1000 нс; підтяжки не вмикаються.
> - Якщо між двома вибірками минуло понад 0.75 с, задача пише рядок у журнал.
> - Недоступність по колесу: помилка створення блоку, каналу, фільтра чи старту позначає лише своє колесо; задача працює, поки доступне хоча б одне колесо. Якщо задачу не вдалося створити, усі колеса недоступні з причиною «задача encoders не запущена».
>
> — `sad.md §4, журнал припущень, abridged` · full text: [sad.md](../sad.md)

> Шаблон каналів і дій — `tools/bringup/main/p6_encoders.c`, `enc_init()` (без `accum_count`, з watch-point; `P6_PULLUP 0`).
>
> — `tools/bringup/main/p6_encoders.c, enc_init, abridged` · full text: [p6_encoders.c](../../../../tools/bringup/main/p6_encoders.c)

> **Chosen:** варіант 1 (рішення власника, 2026-10-19). Енкодери стають самостійною підсистемою: рахують і показуються, навіть якщо `control` не запустилася, а їх збій нічого не ламає в керуванні (spec AC-08).
>
> — `adr/0001, Decision outcome, abridged` · full text: [0001-sample-encoders-in-a-dedicated-20ms-task-and-publish-a-snapshot.md](../adr/0001-sample-encoders-in-a-dedicated-20ms-task-and-publish-a-snapshot.md)

> **Hard rule:** Номери GPIO існують рівно в одному файлі: `components/board/include/board_pins.h`. Літерал номера піна будь-де ще — дефект, навіть якщо значення правильне.
>
> — `constitution.md, п. 2, verbatim` · full text: [constitution.md](../../../constitution.md)

> **Hard rule:** Усі періодичні задачі використовують `vTaskDelayUntil`, а не `vTaskDelay` (розділ 8.5).
>
> — `constitution.md, п. 14, abridged` · full text: [constitution.md](../../../constitution.md)

**Fallback:** insufficient or contradicted by the code → read the named file in full ([spec.md](../spec.md) · [sad.md](../sad.md) · [contracts/cli.md](../contracts/cli.md) · [adr/](../adr/)) and follow it. Do not guess.

## Data delta

No DB changes.

## API contract

Internal — no API surface.

## Acceptance criteria

### AC-04 (US-03) — domain invariant

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

### AC-05 (US-03) — domain invariant

> **Given** ровер озброєний з консолі в стендовому режимі, колеса в повітрі, лічильники обнулено
> **When** Розробник командою руху з тягою 0.375 і поворотом 0.375 (лівий борт на 0.75, правий отримує нуль) протягом 10 с, повторюючи команду, крутить лише лівий борт і показує знімки до й після; потім так само з тягою 0.375 і поворотом −0.375 (правий борт на 0.75, лівий отримує нуль)
> **Then** сумарна зміна лічильника кожного колеса нерухомого борту між знімками до й після — не більше 4 імпульсів (один повний цикл енкодера), а його швидкість у знімках дорівнює нулю: наведення від моторних дротів у тому самому шлейфі не дає хибних імпульсів; якщо нерухоме колесо від вібрації помітно провернулось (видно оком), це справжній рух, а не дефект прошивки, — так і записують у журнал bring-up; колеса, що крутилися, показують швидкість і лічильник за AC-04
>
> — `spec.md §5, AC-05, verbatim` · full text: [spec.md](../spec.md)

### AC-08 (US-05) — error

> **Given** при старті плати хоча б один енкодер не вдалося налаштувати (збій ініціалізації лічильника чи фільтра завад)
> **When** плата завершує старт, а Розробник показує стан, знімок енкодерів і озброює ровер
> **Then** недоступним вважається лише колесо, енкодер якого не налаштувався: журнал старту називає це колесо і причину збою, показ стану — скільки енкодерів доступно і які колеса недоступні (без причини), а у знімку енкодерів рядок такого колеса пише недоступність і причину замість значень (жодних хибних нулів, що виглядають як виміряні), тоді як решта коліс показують свої значення як звичайно; обнулення лічильників обнуляє доступні колеса і нагадує, які недоступні; ровер не перезавантажується, озброюється й їздить як у фазі 3, бо в цій фазі енкодери не беруть участі в керуванні. Викликати такий збій на залізі нічим, тож цей критерій приймається хостовим тестом логіки показу й оглядом коду, а не на залізі
>
> — `spec.md §5, AC-08, verbatim` · full text: [spec.md](../spec.md)

## Checklist

- [ ] Оголосити `encoders_start()`, `encoders_state_get()`, `encoders_reset()` і текстові функції для консолі — `encoders_hal.h`
- [ ] Налаштувати 4 блоки за шаблоном P6 з лініями `PIN_ENC_*`; помилка — недоступне колесо з `esp_err_to_name` — `encoders_hal.c`
- [ ] Задача `encoders` (prio 4, core 1, стек 3072, Task WDT, `vTaskDelayUntil` 20 мс): читання 4 лічильників, мітка, крок core, публікація під `portMUX`, журнал пропуску понад 0.75 с — `encoders_hal.c`
- [ ] `encoders_reset()` під `portMUX` — `encoders_hal.c`
- [ ] Додати `encoders_hal.c` у SRCS, `REQUIRES board esp_driver_pcnt esp_timer` — `components/encoders/CMakeLists.txt`

## Edge cases

| Case | Behaviour |
|---|---|
| один блок не налаштувався | лише його колесо недоступне, решта працює |
| задачу не створено | усі колеса недоступні з причиною; `encoders_start` повертає помилку, `main` продовжує старт |
| Task WDT не прийняв підписку | рядок у журнал, задача працює без сторожового таймера (як `crsf_rx`) |

## Definition of Done

- [ ] `idf.py build` без помилок і нових попереджень; `check_pins.sh`, `check_delays.sh` чисті; приймання на залізі — у T8
- [ ] every Hard Rule inlined above still holds
- [ ] lint + vet clean (для C: збірка без нових попереджень і хостові скрипти)
