12romis/esp32-elrs-rover/docs/features/phase2-io/tasks/t1-i2c-bus-core.md

---
id: T1
title: "Створити i2c_bus_core: оцінка результату скану й рядок журналу"
layer: "domain"
deps: []
blocks: ["T6", "T13"]
acs: ["AC-01", "AC-02"]
files_hint: ["components/i2c_bus/i2c_bus_core.c", "components/i2c_bus/include/i2c_bus_core.h", "test/host/test_i2c_bus.c"]
owner: "Агент (код і хостові тести)"
estimate: "S"
context_budget: "S"
status: "done"
step: "COMMIT"
---

# T1 — Створити i2c_bus_core: оцінка результату скану й рядок журналу

## Place in the sequence

- **Blocked by:** — · **Blocks:** T6 — Створити i2c_bus_hal і ioexp_hal: шина 100 кГц, мʼютекс, нуль першим, скан, T13 — Зібрати хостовий раннер і перевірки конституції для phase2-io · **Wave:** 1, за графом залежностей.
- **Lane:** власна.

## Why (user story)

> **As a** Розробник
> **I want** щоб після кожного старту й перезапуску світло було вимкнене без жодної моєї команди
> **So that** плата не світить з першої секунди і я знаю стартовий стан розширювача
>
> — `spec.md §4, US-01, verbatim` · full text: [spec.md](../spec.md)

Цей task дає частину цієї історії: створити i2c_bus_core: оцінка результату скану й рядок журналу.

## Inlined context

> **Hard rule:** Кожен компонент ділиться на `<name>_core.c` (без жодного заголовка ESP-IDF) і `<name>_hal.c`. Логіка живе в core і покривається тестами на хості. Для HAL тести на моках не пишуться: критерій приймання — перевірка на залізі, записана в журнал bring-up.
>
> — `constitution.md, п. 6, verbatim` · full text: [constitution.md](../../../constitution.md)

> **ADR-0001 (окремий компонент):** Окремий компонент `i2c_bus`: HAL дає шину 100 кГц і мʼютекс `m_i2c`, `i2c_bus_core` розбирає результат скану (чи є очікувана адреса, рядок журналу) і тестується на хості.
>
> — `adr/0001-*.md, Decision outcome, abridged` · full text: [adr](../adr/)

> `i2c_bus_core.c` — результат скану: чи є очікувана адреса, рядок журналу. Сканування лише журналить знайдені адреси й перевіряє, що серед них є розширювач; адресу визначає виміряне значення, не скан.
>
> — `sad.md §5, §5 decomposition + §1 ¶4 spec, abridged` · full text: [sad.md](../sad.md)

**Fallback:** insufficient or contradicted by the code → read the named file in full ([spec.md](../spec.md) · [sad.md](../sad.md) · [cli.md](../contracts/cli.md) · [adr/](../adr/) · [constitution](../../../constitution.md)) and follow it. Do not guess.

## Data delta

No DB changes.

## API contract

Internal — no API surface.

## Acceptance criteria

### AC-01 — happy path

> **Given** плату щойно ввімкнено або перезапущено, розширювач портів на шині відповідає, а до цього моменту його виходи могли тримати світло ввімкненим
> **When** прошивка завершує старт
> **Then** усі три канали світла вимкнені, вбудований індикатор плати не світить (світло може горіти лише до першого запису нуля: це вікно прийнято, OQ-1), і так лишається, доки Розробник не ввімкне якийсь канал або ровер не опиниться в ARMED чи FAILSAFE; лінії скидання далекомірів утримуються в стані скидання; консоль повідомляє, що розширювач знайдено, і друкує адреси, знайдені на шині
>
> — `spec.md §5, AC-01, verbatim` · full text: [spec.md](../spec.md)

### AC-02 — domain invariant

> **Given** старт прошивки
> **When** прошивка вперше звертається до шини периферії
> **Then** першою операцією на шині є запис нульового значення в розширювач; жодного сканування, читання чи запису в інший пристрій до неї немає; сканування шини і журнал знайдених адрес виконуються лише після цього запису; адресу розширювача взято з виміряного значення (передфаза P1, журнал вимірювань), а не з результату сканування
>
> — `spec.md §5, AC-02, verbatim` · full text: [spec.md](../spec.md)

## Checklist

- [x] Створити `components/i2c_bus/` (CMakeLists, `include/i2c_bus_core.h`, `i2c_bus_core.c` без заголовків ESP-IDF).
- [x] Функція оцінки: вхід — масив знайдених адрес (діапазон `0x08`–`0x77`), очікувана адреса; вихід — чи знайдена, чи є інші адреси, рядок журналу з переліком.
- [x] Хостовий тест `test/host/test_i2c_bus.c`: порожній скан, лише очікувана, очікувана й сторонні, лише сторонні, межі діапазону.
- [x] Підключити тест у хостовий раннер `test/host/`.

## Edge cases

| Case | Behaviour |
|---|---|
| Скан нічого не знайшов | очікувана відсутня, рядок журналу це називає |
| Знайдено лише очікувану | очікувана присутня, сторонніх немає |
| Знайдено сторонні адреси | журналяться як інформація, не помилка |

## Definition of Done

- [x] Хостові тести `i2c_bus_core` проходять.
- [x] `i2c_bus_core.c` не підключає заголовків ESP-IDF.
- [x] Рішення про доступність розширювача скан не приймає (лише журнал).
- [x] lint + vet clean
