12romis/esp32-elrs-rover/docs/features/phase2-io/tasks/t6-i2c-bus-ioexp-hal.md

---
id: T6
title: "Створити i2c_bus_hal і ioexp_hal: шина 100 кГц, мʼютекс, нуль першим, скан"
layer: "infra"
deps: ["T1", "T2"]
blocks: ["T8", "T12", "T14"]
acs: ["AC-01", "AC-02", "AC-03", "AC-14"]
files_hint: ["components/i2c_bus/i2c_bus_hal.c", "components/i2c_bus/include/i2c_bus_hal.h", "components/i2c_bus/CMakeLists.txt", "components/ioexp/ioexp_hal.c", "components/ioexp/include/ioexp_hal.h", "components/ioexp/CMakeLists.txt"]
owner: "Агент (код), Розробник (приймання на залізі)"
estimate: "M"
context_budget: "M"
status: "done"
step: "COMMIT — AC-14, AC-15 апаратно не перевірені (кроки 13–14 пропущено)"
---

# T6 — Створити i2c_bus_hal і ioexp_hal: шина 100 кГц, мʼютекс, нуль першим, скан

## Place in the sequence

- **Blocked by:** T1 — Створити i2c_bus_core: оцінка результату скану й рядок журналу, T2 — Створити ioexp_core: тіньовий регістр, маска розрядів світла, підтвердження запису, доступність · **Blocks:** T8 — Створити ui_hal: задача ui, мʼютекс m_ui, опитування стану й бортів, запис розширювача, T12 — Підключити колбеки світла й зумера в console_hal і порядок старту в main, T14 — Підготувати чекліст приймання фази 2 на залізі і запис у журнал bring-up · **Wave:** 2, за графом залежностей.
- **Lane:** власна.

## Why (user story)

> **As a** Розробник
> **I want** щоб після кожного старту й перезапуску світло було вимкнене без жодної моєї команди
> **So that** плата не світить з першої секунди і я знаю стартовий стан розширювача
>
> — `spec.md §4, US-01, verbatim` · full text: [spec.md](../spec.md)

> **As a** Розробник
> **I want** щоб ровер стартував, озброювався й їхав навіть тоді, коли розширювач не відповідає
> **So that** несправний шлейф світла не позбавляє мене керування моторами й шляху «зупинити»
>
> — `spec.md §4, US-05, verbatim` · full text: [spec.md](../spec.md)

Цей task дає частину цієї історії: створити i2c_bus_hal і ioexp_hal: шина 100 кГц, мʼютекс, нуль першим, скан.

## Inlined context

> **Hard rule:** Кожен компонент ділиться на `<name>_core.c` (без жодного заголовка ESP-IDF) і `<name>_hal.c`. Логіка живе в core і покривається тестами на хості. Для HAL тести на моках не пишуться: критерій приймання — перевірка на залізі, записана в журнал bring-up.
>
> — `constitution.md, п. 6, verbatim` · full text: [constitution.md](../../../constitution.md)

> **Hard rule:** перша операція по I²C після старту — запис `0x00` у PCF8574; ШІМ обмежений 0.75 до завершення фази 5.
>
> — `constitution.md, п. 7, abridged` · full text: [constitution.md](../../../constitution.md)

> **Hard rule:** Шина I²C працює на 100 кГц, підвищувати до 400 кГц заборонено. Усі періодичні задачі використовують `vTaskDelayUntil`, а не `vTaskDelay`.
>
> — `constitution.md, п. 14, verbatim` · full text: [constitution.md](../../../constitution.md)

> **Hard rule:** Номери GPIO існують рівно в одному файлі: `components/board/include/board_pins.h`. Літерал номера піна будь-де ще — дефект, навіть якщо значення правильне.
>
> — `constitution.md, п. 2, verbatim` · full text: [constitution.md](../../../constitution.md)

> **ADR-0003 (нуль першим):** `main` викликає `ioexp_start` одразу після ліній моторів; до двох спроб; доступний лише за підтвердженням запису; скан після й лише журналиться; при відмові — деградація; скан при відмові пропускається.
>
> — `adr/0003-*.md, Decision outcome, abridged` · full text: [adr](../adr/)

> Шина: `i2c_master_bus` на `PIN_I2C_SCL`/`PIN_I2C_SDA`, 100 кГц, внутрішні підтяжки вимкнено; таймаут запису 20 мс, зонда скану 10 мс; один `i2c_master_dev` для розширювача. Старт: до двох спроб запису нуля, сума в межах 1 с від входу в `app_main`.
>
> — `sad.md §4, §4 ledger, abridged` · full text: [sad.md](../sad.md)

**Fallback:** insufficient or contradicted by the code → read the named file in full ([spec.md](../spec.md) · [sad.md](../sad.md) · [cli.md](../contracts/cli.md) · [adr/](../adr/) · [constitution](../../../constitution.md)) and follow it. Do not guess.

## Data delta

No DB changes.

## API contract

Internal — no API surface.

## Acceptance criteria

### AC-01 — happy path

> **Given** плату щойно ввімкнено або перезапущено, розширювач портів на шині відповідає, а до цього моменту його виходи могли тримати світло ввімкненим
> **When** прошивка завершує старт
> **Then** усі три канали світла вимкнені, вбудований індикатор плати не світить (світло може горіти лише до першого запису нуля: це вікно прийнято, OQ-1), і так лишається, доки Розробник не ввімкне якийсь канал або ровер не опиниться в ARMED чи FAILSAFE; лінії скидання далекомірів утримуються в стані скидання; консоль повідомляє, що розширювач знайдено, і друкує адреси, знайдені на шині
>
> — `spec.md §5, AC-01, verbatim` · full text: [spec.md](../spec.md)

### AC-02 — domain invariant

> **Given** старт прошивки
> **When** прошивка вперше звертається до шини периферії
> **Then** першою операцією на шині є запис нульового значення в розширювач; жодного сканування, читання чи запису в інший пристрій до неї немає; сканування шини і журнал знайдених адрес виконуються лише після цього запису; адресу розширювача взято з виміряного значення (передфаза P1, журнал вимірювань), а не з результату сканування
>
> — `spec.md §5, AC-02, verbatim` · full text: [spec.md](../spec.md)

### AC-03 — happy path

> **Given** фари (або, у DISARMED, червоний чи зелений задній ліхтар) ввімкнені командою, ровер у DISARMED
> **When** Розробник перезапускає плату командою перезапуску
> **Then** після нового старту світло вимкнене без жодної команди Розробника, хоча розширювач не скидається разом з керуючою платою: вимкнення забезпечує лише перший запис нуля (AC-02)
>
> — `spec.md §5, AC-03, verbatim` · full text: [spec.md](../spec.md)

### AC-14 — cross-context

> **Given** розширювач не відповідає при старті (шлейф відʼєднано або шина несправна)
> **When** прошивка проходить старт
> **Then** ровер доходить до DISARMED, як в AC-01 фази 0; консоль друкує, що розширювач не відповів, світло недоступне, решту функцій збережено; озброєння, команда руху й роззброєння працюють як у фазі 1 і не блокуються; команда світла відхиляється з поясненням, що розширювач недоступний, команда зумера працює; розширювач вважається доступним лише якщо перший запис нуля підтверджено (дозволено до двох спроб у межах 1 с), сканування шини цього не вирішує, а лише журналить знайдені адреси; не підтверджений на старті розширювач вважається недоступним до перезапуску плати
>
> — `spec.md §5, AC-14, verbatim` · full text: [spec.md](../spec.md)

## Checklist

- [x] `i2c_bus_hal`: створення шини `i2c_master` (100 кГц, без внутрішніх підтяжок), мʼютекс `m_i2c`, запис байта, зонд адреси; лише нові драйвери IDF, пін-номери з `board_pins.h`.
- [x] `ioexp_hal`: `ioexp_start` — нуль першим (дві спроби, ≤ 1 с від входу в основну функцію), статус із `ioexp_core`, скан `0x08`–`0x77` і журнал через `i2c_bus_core` лише після успіху, при відмові скан пропускається з причиною в журналі; запис байта під `m_ui`-незалежним мʼютексом шини.
- [x] Журнал: мітка часу першого запису, знайдені адреси, одне повідомлення на збій і одне на відновлення.
- [x] Оновити `CMakeLists` обох компонентів (`esp_driver_i2c`, `board`).

## Edge cases

| Case | Behaviour |
|---|---|
| Запис нуля не підтверджено двічі | розширювач недоступний до перезапуску, скан пропущено, старт не затримано понад 1 с |
| Перезапуск при ввімкненому світлі | світло гасне першим записом нуля |
| Скан знайшов сторонню адресу | журнал, не помилка |

## Definition of Done

- [x] `idf.py build` без помилок і нових попереджень.
- [x] Перша транзакція на шині — запис нуля (огляд коду), шина 100 кГц.
- [x] Приймання на залізі записує Розробник у журнал bring-up (AC-01, AC-02, AC-03, AC-14); Hard rules вище виконуються.
- [x] lint + vet clean
