12romis/esp32-elrs-rover/docs/features/phase1-drive/tasks/t1-battery-core.md

---
id: T1
title: "Створити battery_core: відліки в мВ, поріг 6000 мВ, свіжість знімка"
layer: "domain"
deps: []
blocks: ["T3", "T6"]
acs: ["AC-13", "AC-14", "AC-22"]
files_hint: ["components/battery/", "test/host/test_battery.c"]
owner: "Агент"
estimate: "M"
context_budget: "M"
status: "done"
step: "GATE (без коміту — за вказівкою)"
---

<!-- Самодостатня задача: працюй із вкладеного; джерело завжди перемагає (див. підпис кожного уривка). -->

# T1 — Створити battery_core: відліки в мВ, поріг 6000 мВ, свіжість знімка

## Place in the sequence

- **Blocked by:** — · **Blocks:** T3 — Додати drive_ctl: запити arm/disarm/drive, дозволи, причини відмов, T6 — Створити battery_hal: АЦП з калібруванням, задача battery, знімок напруги · **Wave:** 1.
- **Lane:** own lane (каталог battery спільний із T6 — послідовно).

## Why (user story)

> **As a** Розробник  
> **I want** щоб при напрузі нижче 6.0 В мотори не стартували, а в русі зупинялися  
> **So that** розряджений акумулятор не пошкоджується і не дає хибних результатів приймання
>
> — `spec.md §4, US-05, verbatim` · full text: [spec.md](../spec.md)

Дає чисту логіку вимірювання напруги: перерахунок усередненого відліку АЦП у мВ, перевірка порога 6000 мВ, свіжість знімка і «немає першого вимірювання». Рішення про озброєння й зупинку приймає `drive_core` (T3, T4), а не цей модуль.

## Inlined context

> Окрема задача `battery` (200 мс) публікує знімок «мВ, час, валідність»; `battery_core` рахує мВ і порівнює з порогом 6000 мВ. Знімок старший за 600 мс (три періоди) або невалідний: `arm` відхиляється, а в ARMED `control` зупиняє мотори й просить FAILSAFE.
>
> — `adr/0003, Decision outcome, abridged` · full text: [adr/0003](../adr/0003-measure-battery-in-own-task-with-stale-reading-failsafe.md)

> Калібрування напруги — константи в `battery_calib.h` з позначкою «виміряно: дата» (коефіцієнт 4.047, зсув 0, поріг 6000 мВ), без сховища налаштувань і команди перекалібрування. Усереднення — пакет з 16 відліків АЦП за такт, усереднення в core.
>
> — `sad.md §4, журнал припущень, abridged` · full text: [sad.md](../sad.md)

> Частота вимірювання напруги ≤ 5 Гц, усереднення 16–64 відліків. Затримка відсічки: вимкнення моторів ≤ 1 с після того, як напруга опустилася під 6.0 В; озброєння відхиляється, доки немає першого вимірювання.
>
> — `spec.md §6, NFR, abridged` · full text: [spec.md](../spec.md)

> VBAT_SCALE / VBAT_OFFSET (точка 1 з 2, попередньо): коефіцієнт k 4.033 → 4.047, зсув 0. Друга точка нижче 7 В ще не знята, приймання ±50 мВ на 6.0–8.4 В не закрите.
>
> — `measured.md, рядок P3, abridged` · full text: [measured.md](../../../measured.md)

> Величини з розділу 9 документа 02 не вигадуються. Якщо потрібна константа, якої немає в `docs/measured.md` — зупинитись і назвати, якого заміру бракує.
>
> — `constitution.md, п. 3, abridged` · full text: [constitution.md](../../../constitution.md)

> Файли `*_core.c` не підключають жодного заголовка ESP-IDF чи FreeRTOS; вся логіка тут, її тести — на звичайному gcc у `test/host/`; для HAL моки не пишуться, критерій приймання — перевірка на залізі, записана в журнал bring-up.
>
> — `constitution.md, п. 6, abridged` · full text: [constitution.md](../../../constitution.md)

> Будь-яка задача вважається завершеною лише якщо `idf.py build` проходить без помилок і без нових попереджень. Мова коментарів і комітів — українська; ідентифікатори — англійська.
>
> — `constitution.md, п. 8–9, abridged` · full text: [constitution.md](../../../constitution.md)

**Fallback:** недостатньо або суперечить коду → прочитати названий файл повністю ([spec.md](../spec.md) · [sad.md](../sad.md) · [adr/](../adr/)) і діяти за ним. Не вигадувати.

## Data delta

No DB changes.

## API contract

Internal — no API surface.

## Acceptance criteria

### AC-13 (US-05) — domain invariant

> **Given** автомат у DISARMED, а виміряна напруга акумулятора нижча за 6.0 В, або батареї немає (плата живиться лише від USB), або першого вимірювання напруги після старту ще немає
**When** Розробник вводить команду озброєння
**Then** озброєння відхилено з поясненням, яка напруга виміряна і який поріг (або що вимірювання ще немає), автомат лишається в DISARMED, а STBY низька
>
> — `spec.md §5, AC-13, verbatim` · full text: [spec.md](../spec.md)

### AC-14 (US-05) — cross-context

> **Given** ровер озброєно (їде за командою руху чи ще ні), а напруга акумулятора падає нижче 6.0 В
**When** вимірювання напруги фіксує значення нижче порога, і це відбувається не пізніше 1 с після того, як напруга опустилася під поріг
**Then** борти зупиняються (якщо їхали), STBY опускається, автомат переходить у FAILSAFE, консоль називає причину й виміряну напругу, а подальше озброєння відхиляється з поясненням, що вихід з FAILSAFE можливий лише апаратним скиданням плати або перемиканням живлення (команда перезавантаження в цьому стані не діє)
>
> — `spec.md §5, AC-14, verbatim` · full text: [spec.md](../spec.md)

### AC-22 (US-05) — cross-context

> **Given** автомат у DISARMED, а напруга акумулятора опускається нижче 6.0 В
**When** вимірювання напруги фіксує значення нижче порога
**Then** автомат лишається в DISARMED, моторів не запущено, а команда озброєння відхиляється з поясненням (AC-13); щойно напруга знову не нижча за поріг, озброєння знову можливе без скидання плати
>
> — `spec.md §5, AC-22, verbatim` · full text: [spec.md](../spec.md)

## Checklist

- [ ] `components/battery/CMakeLists.txt`: `idf_component_register(SRCS "battery_core.c" INCLUDE_DIRS "include")` (HAL-файл додасть T6)
- [ ] `components/battery/include/battery_calib.h`: `BATTERY_SCALE_PPM 4047`, `BATTERY_OFFSET_MV 0`, `BATTERY_CUTOFF_MV 6000`, `BATTERY_STALE_MS 600` з коментарем «виміряно: 2026-10-16, попередньо, spec OQ-1»
- [ ] `components/battery/include/battery_core.h` і `battery_core.c`: `battery_avg_mv(const uint16_t *samples, size_t n)`, `battery_adc_to_mv(adc_mv)`, `battery_is_below_cutoff(mv)`, `battery_snapshot_t {mv, t_ms, valid}`, `battery_snapshot_usable(snap, now_ms)` (валідний і не старший за 600 мс, віднімання беззнакове)
- [ ] `test/host/test_battery.c`: 5999/6000/6001 мВ; свіжість 600/601 мс; невалідний знімок; перехід лічильника мс через нуль; усереднення 16 відліків; k = 4.047
- [ ] `run_tests.sh` і `check_core_headers.sh` чисті

## Edge cases

| Case | Behaviour |
|---|---|
| Напруга рівно 6000 мВ | не нижче порога, озброєння дозволене |
| Знімок невалідний (вимірювання ще не було) | непридатний; озброєння відхиляється з поясненням «вимірювання ще немає» |
| Знімок 601 мс | застарілий, непридатний |
| Лічильник мс перетнув 2^32 | свіжість рахується беззнаковою різницею, без хибної застарілості |
| Нульова батарея (живлення лише від USB) | напруга значно нижча за поріг, непридатна для озброєння |

## Definition of Done

- [ ] Хостові тести battery_core проходять (межі порога, свіжість, усереднення)
- [ ] `check_core_headers.sh` чистий
- [ ] Константи калібрування мають позначку «виміряно: дата» і не вигадані
- [ ] `idf.py build` без помилок і без нових попереджень; Hard rules вище виконано
