12romis/esp32-elrs-rover/docs/features/phase1-drive/tasks/t8-console-hal-motor-commands.md

---
id: T8
title: "Підключити arm, disarm, drive і розширений status до console_hal"
layer: "ports"
deps: ["T5", "T7"]
blocks: ["T9"]
acs: ["AC-01", "AC-16"]
files_hint: ["components/rover_console/"]
owner: "Агент"
estimate: "S"
context_budget: "S"
status: "done"
step: "ПРИЙНЯТО на залізі (без коміту — за вказівкою)"
---

<!-- Самодостатня задача: працюй із вкладеного; джерело завжди перемагає (див. підпис кожного уривка). -->

# T8 — Підключити arm, disarm, drive і розширений status до console_hal

## Place in the sequence

- **Blocked by:** T5 — Розширити console_core: arm, disarm, drive, суворий розбір чисел, матриця дозволів, T7 — Створити drive_hal: LEDC і GPIO моторів, задача control, черга запитів, Task WDT · **Blocks:** T9 — Скласти main.c: порядок старту фази 1 і REQUIRES · **Wave:** 5.
- **Lane:** lane rover_console (T5 → T8 — послідовно).

## Why (user story)

> **As a** Розробник  
> **I want** бачити в консолі напругу, стан моторів і застосовані значення бортів  
> **So that** я розумію, чому ровер їде, стоїть або відмовив
>
> — `spec.md §4, US-06, verbatim` · full text: [spec.md](../spec.md)

Підключає виконання нових команд у задачі консолі: колбеки `arm`, `disarm`, `drive`, `motor_status`, `battery_mv` у `console_ops_t`, вивід відповіді control і розширеного `status`.

## Inlined context

> Задача `control` (`vTaskDelayUntil`, 20 мс, core 1, пріоритет 5) єдина пише в лінії моторів і єдина запитує переходи ARMED, DISARMED та FAILSAFE у фазі 1; консоль надсилає запити через чергу довжини 4 і чекає відповіді до 200 мс; запит старший за 150 мс `control` відкидає. Кожен такт задача перевіряє стан автомата й примусово вимикає виходи, якщо стан не ARMED.
>
> — `adr/0001, Decision outcome, abridged` · full text: [adr/0001](../adr/0001-run-motor-safety-logic-in-a-dedicated-control-task.md)

> Консоль не залежить від `drive` і `battery`: потрібні дії їй передає `main` колбеками. `console_ops_t` розширюється колбеками arm, disarm, drive і звіту про стан моторів; при тайм-ауті відповіді 200 мс консоль друкує «керування не відповіло» та вважає команду неприйнятою.
>
> — `sad.md §4–§5, abridged` · full text: [sad.md](../sad.md)

> `status` додатково до даних фази 0 виводить напругу акумулятора в мВ, рівень, який прошивка подала на лінію STBY, застосовані значення лівого й правого борту та скільки лишилося діяти команді руху.
>
> — `spec.md §5, AC-16, abridged` · full text: [spec.md](../spec.md)

> Будь-яка задача вважається завершеною лише якщо `idf.py build` проходить без помилок і без нових попереджень. Мова коментарів і комітів — українська; ідентифікатори — англійська.
>
> — `constitution.md, п. 8–9, abridged` · full text: [constitution.md](../../../constitution.md)

**Fallback:** недостатньо або суперечить коду → прочитати названий файл повністю ([spec.md](../spec.md) · [sad.md](../sad.md) · [adr/](../adr/)) і діяти за ним. Не вигадувати.

## Data delta

No DB changes.

## API contract

Командний інтерфейс консолі: `arm`, `disarm`, `drive <тяга> <поворот>`, розширений `status`, `help` із 7 командами — за матрицею дозволів і форматами з T5.

## Acceptance criteria

### AC-01 (US-01) — happy path

> **Given** автомат у стані DISARMED, напруга акумулятора не нижча за поріг, консоль активна
**When** Розробник вводить команду озброєння
**Then** консоль підтверджує, що ровер озброєно, записує перехід у ARMED, а колеса лишаються нерухомими, доки не надійде команда руху
>
> — `spec.md §5, AC-01, verbatim` · full text: [spec.md](../spec.md)

### AC-16 (US-06) — happy path

> **Given** автомат у довільному стані і консоль активна
**When** Розробник вводить команду показу стану, а потім команду довідки
**Then** показ стану додатково до даних фази 0 виводить напругу акумулятора в мВ (ціле число), рівень, який прошивка подала на лінію STBY, застосовані значення лівого й правого борту (два знаки після крапки, округлення до найближчого; 0.00 після зупинки) та скільки лишилося діяти команді руху в мс (0, якщо команди немає); довідка перелічує команди: help, status, reboot, wdt-test, arm, disarm, drive; дозволи команд reboot і wdt-test не змінюються (обидві відхиляються в ARMED із поясненням)
>
> — `spec.md §5, AC-16, verbatim` · full text: [spec.md](../spec.md)

## Checklist

- [ ] `console.h`: нові поля `console_ops_t` — `arm`, `disarm`, `drive`, `motor_status`, `battery_mv`
- [ ] `console_hal.c`: виконання `ARM`/`DISARM`/`DRIVE` через колбеки, друк відповіді (застосовані значення бортів, причина відмови), розширений `status`
- [ ] тайм-аут відповіді → «керування не відповіло»; reboot і wdt-test поведінка фази 0 без змін
- [ ] `CMakeLists.txt` без нових залежностей (консоль не залежить від `drive` і `battery`); `idf.py build` без нових попереджень

## Edge cases

| Case | Behaviour |
|---|---|
| control не відповів за 200 мс | «керування не відповіло», команда неприйнята |
| Колбек не заданий (NULL) | команда відхиляється з поясненням, без падіння |
| status у стані без команди руху | залишок 0 мс, значення бортів 0.00 |

## Definition of Done

- [ ] `idf.py build` без помилок і нових попереджень
- [ ] Приймання на залізі: `arm`, `drive 0.3 0`, `status`, `disarm` дають очікувані відповіді (запис у журнал bring-up)
- [ ] Консоль не підключає заголовки `drive` і `battery`
- [ ] `idf.py build` без помилок і без нових попереджень; Hard rules вище виконано
