12romis/esp32-elrs-rover/docs/features/phase0-skeleton/_review/review-2026-10-17.md

# Review — phase0-skeleton (2026-10-17)

**Scope:** `git diff 0a17531..HEAD`, гілка `feature/phase0-skeleton`, 54 файли, коміти T1–T9. Рецензент: `sdd:reviewer` (чистий контекст, лише читання). Перевірено: 450 хостових тестів, три скрипти перевірок, `idf.py build` (0 попереджень компілятора, 5 CMake-попереджень самого IDF — baseline). Ланцюжок spec → sad §6 → задача → код → тест пройдено для AC-01…AC-13 і US-01…US-07; блокерів немає.

## Знахідки і рішення

| # | Етап | Знахідка | Рішення |
|---|---|---|---|
| 1 | stage-1 | `watchdog_hal.c`: збій підписки heartbeat на TWDT мовчазний, `watchdog_start()` повертає OK, `wdt-test` обіцяє неіснуюче перезавантаження (AC-04) | Fix now: підписка з `watchdog_start()`, помилка → `main` лишає BOOT |
| 2 | stage-1 | Монітор шле CR LF → зайвий порожній рядок після кожної команди (AC-03) | Fix now: `console_core` ігнорує LF після CR; хостові тести |
| 3 | stage-1 | Драйвер USB-Serial-JTAG без `usb_serial_jtag_vfs_use_driver()`, ризик ехо/виводу перед рестартом (AC-01/02/13) | Fix now (рішення Розробника): увімкнено `usb_serial_jtag_vfs_use_driver()`, `usb_serial_jtag_wait_tx_done` перед рестартом; на залізі перевіряється за `acceptance.md` §2 |
| 4 | stage-2 | `check_protected.sh` бачить лише незакомічене (AC-10) | Fix now: додатково `git diff BASE...HEAD`, тест закоміченої зміни, `ALLOW_PROTECTED` |
| 5 | stage-2 | `check_pins.sh` пропускає каст, бітову маску, `#define *PIN*` (AC-11) | Fix now: розширені шаблони, фікстури в `selftest_tools.sh` |
| 6 | stage-2 | `main.c`: логіка форматування, спільний статичний буфер, прапорці без синхронізації | Fix now: `storage_status_report(buf,n)` у `storage_hal`, `volatile`-прапорці, `main.c` без логіки |
| 7 | stage-2 | Baseline попереджень ніде не записано (AC-08/09) | Fix now: записано в spec §7 |
| 8 | stage-2 | Імена в документах розходяться з кодом (`console`/`rover_console`, `storage_after_retry`) | Fix now: sad, T4, T7, T8 виправлено |

## Gate

**PASS** — стадія 1 без відкритих знахідок, усі вісім виправлено в цьому ж циклі (повторна перевірка: 456 хостових тестів, `selftest_tools` чисто, збірка без попереджень). Не перевірено на залізі: консоль через USB, TWDT, STBY — Розробник за `acceptance.md`.
