12romis/esp32-elrs-rover/docs/features/phase8-session-report/spec.md

---
status: Draft
owner: "Розробник проєкту"
reviewers: ["Розробник проєкту"]
updated_at: "2026-10-22"
feature_size: "M"
---

# Spec — phase8-session-report

> **Glossary:** [CONTEXT](../../../CONTEXT.md)
> **Reference module / docs / channels used:** `docs/constitution.md` (пп. 1–3, 5–10, 12–14), `docs/measured.md` (карта каналів CRSF, `WHEEL_DIAMETER_MM` = 44, P8: порядок байтів і рівень індикатора плати, вільна памʼять, `TOF_OBSTACLE_MM`), `docs/roadmap.md` (кроки 3, 6, 7), `docs/01-ASSEMBLY-BRINGUP.md` (§5.4–5.5: межі живлення при Wi-Fi), `docs/02-FIRMWARE-CONTEXT.md` (§6.1 розподіл задач по ядрах, Wi-Fi-стек на core 0), `docs/features/phase6-tof/spec.md` і `phase7-telemetry/spec.md` (OBSTACLE_HOLD, індикація, матриця дозволів), `docs/architecture-map.md`; код: `components/drive/` (`drive_core.c`, `drive_hal.c`), `components/tof/` (`tof_core.c`, `tof_view_t`, `tof_fmt_hold_line`), `components/ui/` (індикатор), `components/crsf/` (канали), `components/encoders/`, `components/pid/`, `components/battery/`, `components/storage/`, `components/app_state/`, `kicad-rover/kicad-rover.net` (лише читання: вхід напруги акумулятора на ADC1).

## 1. Context

Після фази 7 ровер їздить за пультом, зупиняється перед перешкодою й повідомляє про це звуком і світлом, але три речі лишаються незручними. По-перше, захист далекомірами завжди ввімкнений: щоб підʼїхати впритул до стіни, обʼїхати предмет чи виїхати з тісного місця, Розробник мусить роззброювати ровер або чекати, поки перешкода зникне, а вимкнути захист у польових умовах нічим. По-друге, коли спрацьовує утримання, консоль називає лише найближчий датчик сектора, тоді як спереду їх три (ліво-вперед, прямо, право-вперед) і Розробник хоче знати, які саме бачать перешкоду. По-третє, після виїзду ровер не лишає по собі жодних даних: напруга акумулятора до і після, скільки проїхав, чи не просідала одна сторона, скільки разів і чому зупинявся, зникають разом із живленням або разом із консоллю, якої на виїзді немає.

Тригер: Розробник перейшов від налагодження на стенді до виїздів і хоче бачити історію виїздів, не підключаючи USB, а також керувати захистом з пульта (запит від 2026-10-22).

Обраний підхід. (1) Окремий канал пульта вмикає й вимикає режим контролю перешкод; ввімкнений режим показує індикатор плати зеленуватим світлом; при вимкненому режимі далекоміри не зупиняють ровер. (2) При кожному утриманні перед перешкодою консоль називає всі датчики, що бачать перешкоду, з відстанями. (3) Ровер веде статистику сесії (від озброєння до виходу з озброєного стану) і після переходу в DISARMED на короткий час вмикає Wi-Fi, надсилає по одному повідомленню на сесію на сервер повідомлень власника, одразу вимикає Wi-Fi, а при невдачі зберігає не більше двох останніх сесій для наступного разу.

Traceability: вимоги — запит Розробника 2026-10-22. Рішення власника в цій сесії: розмір M, маршрут standard, глибина easy; канал режиму — CH9; секрети (SSID і пароль Wi-Fi, пароль MQTT) — у локальному файлі поза git; один JSON на сесію; Wi-Fi вимикається одразу після передачі; при невдачі зберігаються дві сесії; склад даних звіту — шість груп із запиту (див. нижче). Мережеві вимоги власника, що мають вигляд технологій (формат JSON, протокол MQTT із захищеним з'єднанням, порт 8883, адреса сервера), зафіксовані як обмеження власника, а не як рішення цієї специфікації. Список припущень агента (A1–A22) нижче; власник може скасувати будь-яке одним повідомленням:

- A1. **Режим контролю перешкод.** Ввімкнений, коли значення каналу CH9 вище середини діапазону (як у тумблера озброєння: більше 992 — «увімкнено»). За замовчуванням ввімкнений: від старту плати, у стендовому режимі, поки пульт не передав жодного кадру, і після втрати зв'язку, доки не прийде новий кадр (небезпечніше помилково вимкнений захист, ніж помилково ввімкнений). Розробник підтвердив, що виведе перемикач на CH9 і запише два положення в журнал вимірювань (OQ-6). Положення CH9 на TX12 ще не виміряні (у журналі CH9 = 992 у спокої, перемикача не призначено): «вище середини» — пропозиція, яку Розробник підтверджує заміром двох положень у `docs/measured.md` до `design` (п. 13; OQ-6); до заміру прошивка без призначеного перемикача бачить 992 як «вимкнено». Змінювати режим можна в будь-якому стані; консоль режим не змінює, а лише показує його в `status`.
- A2. **Вимкнений режим.** Сектори не вважаються зайнятими: обмеження тяги в бік перешкоди не діє, утримання перед перешкодою не наступає, а якщо ровер уже в OBSTACLE_HOLD, він одразу повертається в ARMED. Далекоміри й далі міряють і показуються командою `tof`; відмова далекоміра так само пишеться в журнал. Усі інваріанти безпеки конституції (п. 7: STBY лише в ARMED, втрата кадрів понад 500 мс, перша операція I²C, VBAT < 6.0 В) і відсічка по напрузі діють без змін. Це свідомо доповнює фазу 6, де захист не мав вимикача; відповідна частина ADR-0004 phase6-tof доповнюється рішенням `design` (A14).
- A3. **Індикатор плати.** Зеленуватий = зелений канал на перевіреному рівні 40 (порядок байтів із журналу вимірювань P8, байти (40,0,0)), без червоного. Світить у DISARMED і ARMED, коли режим ввімкнений **і** принаймні один сектор реально охороняється (хоч один працюючий далекомір і свіжий знімок). Якщо режим ввімкнений, але жоден далекомір не працює, зелений не світить, щоб не обіцяти захисту, якого немає (консоль уже пише попередження «озброєно без захисту»). Пріоритет кольорів: червоний у FAILSAFE, потім жовтий в OBSTACLE_HOLD, потім зелений; у BOOT, SELFTEST і FAULT індикатор лишається погашеним, як у фазі 7. Працює й тоді, коли розширювач портів недоступний. Консоль пише одне попередження «захист від зіткнень не діє» при кожному переході «охороняє → не охороняє» (зокрема коли знімок далекомірів застарів під час руху) у DISARMED чи ARMED і одне «захист відновлено» при зворотному; в інший час не повторює.
- A4. **Консоль при перешкоді.** Рядок утримання перед перешкодою (існує з фази 6) тепер називає **кожен** датчик сектора, чия відстань менша за поріг перешкоди (`TOF_OBSTACLE_MM`, 170 мм), з його відстанню, а не лише найближчий; назви беруться з наявного іменування датчиків. Рядок з'являється один раз при вході в утримання; зміна складу датчиків усередині утримання нового рядка не дає (щоб не шуміти на межі порога). Для сектора позаду це один датчик. Якщо на вході зайняті обидва сектори, рядок називає датчики обох секторів, кожен із позначкою свого сектора.
- A5. **Сесія.** Одна сесія — від переходу в ARMED з DISARMED до наступного виходу з ARMED/OBSTACLE_HOLD у DISARMED або FAILSAFE (у FAULT з ARMED автомат не веде: він досяжний лише з SELFTEST). Перехід ARMED ↔ OBSTACLE_HOLD сесії не перериває. Сесії, у яких ровер озброївся, але жодного разу не отримав ненульової потужності, теж звітуються (час руху 0). Кожна сесія має порядковий номер, що не повторюється навіть після перезапуску плати, і тривалість: без цього два збережені звіти неможливо розрізнити, а повторну передачу — виявити.
- A6. **Причина завершення сесії** — одне з: роззброєння (тумблером, консоллю чи зі стану, що вимагає роззброєння), FAILSAFE через втрату зв'язку, FAILSAFE через напругу. Це розширення запиту «LINK_LOST чи VOLTAGE чи ін»: «ін» зводиться до роззброєння, бо інших причин завершення сесії автомат не має. Чи відбувся вихід із FAILSAFE, звіт не фіксує (звіт записується один раз, у момент завершення).
- A7. **Напруга** — зі знімка компонента батареї, у мілівольтах: на моменті входу в ARMED і на моменті виходу з ARMED/OBSTACLE_HOLD (для FAILSAFE через напругу — останнє значення перед відсічкою); додатково мінімум за сесію, бо він показує просадку під навантаженням (це понад запит, коштує один лічильник).
- A8. **Утримання перед перешкодою** у звіті: кількість входів, сумарний час утримання (мс), мінімальна відстань, зафіксована при вході (`hold_mm`), датчик, що її дав (`hold_nearest`), і для кожного з чотирьох датчиків — у скількох утриманнях він був нижче порога **на вході в утримання** (так само, як у рядку консолі). Час режиму, коли контроль був вимкнений, теж у звіті (мс), щоб нуль утримань можна було відрізнити від вимкненого захисту.
- A9. **Пробіг і час руху.** Пробіг — сума модулів зміщення центру ровера за сесію лише на інтервалах часу руху, тобто коли хоча б один борт отримує ненульову потужність (півсума пройдених відстаней лівого й правого бортів на кожному інтервалі вимірювання; розворот на місці пробігу не додає; штовхання вручну й рух накатом не рахуються), у сантиметрах; береться з лічильників коліс при `WHEEL_DIAMETER_MM` = 44 мм (журнал вимірювань, 2026-10-19). Час руху — час, коли хоча б один борт отримував ненульову потужність; порога швидкості не вигадується (п. 3 конституції). Якщо в борту немає жодного доступного енкодера, пробіг рахується за доступним бортом, а звіт це позначає.
- A10. **Швидкість бортів.** Середня — модуль швидкості борту в обертах колеса за хвилину, усереднений за час руху; пікова — найбільший модуль за сесію; окремо лівий і правий борт. **Дисбаланс** = (середня лівого − середня правого) / півсума середніх, у відсотках, зі знаком (плюс — лівий швидший), лише за ті інтервали, де задані швидкості обох бортів однакові й ненульові (їзда по прямій; мікшер дає точну рівність, коли поворот у мертвій зоні). Немає таких інтервалів — «немає даних», не нуль. Борт без доступного енкодера теж «немає даних». Метрика діагностична, а не критерій приймання (відома особливість: FR повільний, див. P7).
- A11. **Версія і ідентифікація.** Версія прошивки й git-хеш беруться з даних образу, які збірка вже вбудовує, версія IDF — з середовища виконання, MAC — з чипа. Прапорець «збірка з незафіксованими змінами» додається, якщо збірка його дає без правки захищених файлів; якщо не дає, його немає (не вигадується).
- A12. **Формат.** Один документ JSON на сесію, укладений у ≤ 1024 байти, послідовні поля зі стабільними назвами англійською (ідентифікатори — англійська, п. 9), одиниці в назвах полів; відсутні дані — явне «немає даних», не нуль. Топіки, QoS і точні назви полів визначає `design`/`api` (Розробник довірив вибір агентові, 2026-10-22).
- A13. **Wi-Fi і MQTT лише в DISARMED.** Радіо вмикається тільки при вході в DISARMED, якщо є хоча б один невідправлений звіт; у BOOT, SELFTEST, ARMED, OBSTACLE_HOLD, FAILSAFE і FAULT радіо вимкнене. Вхід у DISARMED включає перший вхід після старту плати (SELFTEST → DISARMED), тоді відправляються звіти, збережені до перезапуску. Спроба передає звіти по черзі від найстаршого: якщо поточний не доставлено (немає підтвердження, відмова сервера, недовірений сертифікат), спроба зупиняється, Wi-Fi вимикається, решта лишається в черзі в тому ж порядку. Повторних спроб у межах того ж DISARMED немає (щоб не тримати радіо ввімкненим): наступна спроба — при наступному вході в DISARMED або за командою консолі (A16).
- A14. **Озброєння має пріоритет над передачею.** Якщо під час спроби прийшов запит на озброєння, спробу негайно перериває: з'єднання закривається, Wi-Fi вимикається, звіт лишається невідправленим, озброєння відбувається у звичайний спосіб і темпі. Передача виконується в окремій низькопріоритетній задачі на core 0 разом із Wi-Fi-стеком (документ 02 §6.1), керування лишається на core 1; жоден такт керування, зумер, світло і консоль не чекають на мережу. Ця специфікація свідомо доповнює фазу 6 (ADR-0004 phase6-tof про «захист завжди увімкнений») і фазу 7 (індикатор): відповідні рішення оформить `design`.
- A15. **Передача.** Успіх — коли сервер підтвердив прийом повідомлення; відсутність підтвердження — невдача. Одна спроба обмежена в часі: від входу в DISARMED до вимкнення Wi-Fi не більше 30 с (пропозиція агента; реального часу підключення ще не виміряно). Після спроби, успішної чи ні, Wi-Fi вимикається одразу. Сервер (сертифікат власний, підписаний власником; кореневий сертифікат кладеться в проєкт) — адреса, порт і ім'я користувача з запиту Розробника (захищене з'єднання, порт 8883), перевірка сертифіката сервера за цим кореневим сертифікатом обовʼязкова; без перевірки дані не надсилаються. Адреса й порт не є секретом, але лежать у тому самому локальному файлі налаштувань, що й секрети.
- A16. **Консоль.** Нова команда показує стан звітів (скільки невідправлено, які сесії, результат останньої спроби, режим контролю) і в DISARMED запускає спробу передачі негайно зі своїми 30 с від моменту команди; якщо спроба вже йде, команда відхиляється з поясненням «передача вже триває»; якщо черга порожня — повідомляє «нічого надсилати» і Wi-Fi не вмикає; в інших станах відхиляється з поясненням. Команда потрібна для приймання на залізі без виїзду; пароль вона ніколи не показує (A19).
- A17. **Черга звітів.** Невідправлені звіти зберігаються у памʼяті плати (переживають перезапуск і вимкнення живлення), не більше двох; при появі третього найстаріший видаляється з рядком у журналі, який номер видалено. Це не лише кращий буфер: FAILSAFE через напругу виходить лише перезапуском плати, тож у ОЗП такий звіт втратився б. Звіти надсилаються в порядку створення. Успішно надісланий звіт видаляється з памʼяті. Записів у памʼять на сесію не більше двох: створення (у момент завершення сесії) і видалення після підтвердження доставки; плюс оновлення постійного лічильника номерів сесій разом зі створенням (не окремий запис). Усі записи — поза тактом керування. Дублікат, якщо позначка «надіслано» не встигла записатись, відсікається номером сесії на сервері.
- A18. **FAILSAFE.** Радіо у FAILSAFE не вмикається (низька напруга, піки Wi-Fi, документ 01 §5.4); звіт зберігається в памʼять у момент входу, а надсилається при першому DISARMED: після виходу з FAILSAFE через втрату зв'язку або після перезапуску. 
- A19. **Секрети.** SSID і пароль Wi-Fi та пароль сервера зберігаються у локальному файлі налаштувань компонента, який у `.gitignore`; у репозиторії лише шаблон-приклад без значень. Збірка без цього файлу не ламається, а передача вимикається з одним пояснювальним рядком в журналі. Пароль не потрапляє в консоль, `status`, журнал, звіт і в git. Пароль, що прозвучав у чаті,: рекомендовано замінити його справжнім лише у локальному файлі й вважати чат-значення скомпрометованим (OQ-1).
- A20. **Деградації.** Немає локального файлу налаштувань, Wi-Fi недоступний, сервер відхиляє дані чи сертифікат не довірений — ровер працює, як і раніше, звіт лишається в черзі, у журналі одне повідомлення про причину на спробу. Дані звіту, яких немає (енкодер борту, далекомір), позначаються «немає даних». Помилка передачі не змінює стан автомата, моторів і світла.
- A21. **Критерії приймання §6** (30 с, ±5 %, 4096 байт, 1024 байти, 200 мс) — пропозиції агента, як і в фазі 7.
- A22. **Залежності й гілка.** Фаза спирається на фази 3 (канали CRSF), 4–5 (енкодери, швидкість бортів), 6 (далекоміри) і 7 (індикатор плати, рядок утримання), яка злита в `main` (підтверджено Розробником 2026-10-22): реалізація фази 8 стартує від `main`. Правки захищених файлів (`sdkconfig.defaults`, кореневий `CMakeLists.txt`) для Wi-Fi, захищеного з'єднання й сховища дозволені Розробником 2026-10-22 (п. 10), лише в обсязі, потрібному цій фазі, і кожна фіксується в журналі змін фази.

Розбіжності, озвучені за пунктом 1 конституції:
- **Фаза 6 проти запиту.** Фаза 6 (ADR-0004) не мала вимикача захисту; запит вводить його. Реалізується запит (A2, A14).
- **Глосарій.** Записи «Індикатор плати» («у решті станів погашений») і «Утримання перед перешкодою» оновлюються разом із цією специфікацією; нові терміни — режим контролю перешкод, сесія, звіт сесії, черга звітів.
- **Живлення.** Документ 01 §5.4 зазначає: нижче 4.6 В на шині +5 В 3.3 В-стабілізатор плати може просідати на піках Wi-Fi. Заміру TP3 під Wi-Fi в журналі ще немає (OQ-5); до нього приймання передачі виконується на повному акумуляторі або живленні, яке тримає межу.
- **Вхід напруги.** За нетлістом напруга акумулятора заходить на ADC1 (`/VBAT_SENSE`, GPIO 1 за `board_pins.h`), тож Wi-Fi не заважає АЦП батареї (на ESP32-S3 Wi-Fi ламає лише ADC2).
- `docs/architecture-map.md` описує компоненти до фази 7; оновлення карти — справа `survey`.

## 2. Goals

- Розробник вмикає й вимикає захист далекомірами з пульта під час руху й завжди бачить на платі, чи він ввімкнений і чи справді охороняє.
- Розробник з одного рядка консолі знає, які датчики бачать перешкоду, і відрізняє її бік і ширину.
- Після кожного виїзду Розробник отримує на сервері підсумок сесії (напруга, причина завершення, зупинки перед перешкодами, пробіг, швидкості бортів, версія прошивки) без підключення USB, а зібрані дані не втрачаються, коли мережі немає.
- Мережа ніколи не впливає на безпеку: Wi-Fi працює тільки в DISARMED, озброєння має пріоритет над передачею, а секрети не потрапляють у git, консоль чи журнал.

## 3. Non-goals

- Керування ровером, зміна налаштувань (PID, режим контролю) чи оновлення прошивки через мережу — лише відправка звіту; вхідного каналу з сервера немає, щоб не відкривати ровер для віддаленого впливу.
- Безперервна телеметрія в реальному часі під час руху — Wi-Fi тримається вимкненим в усіх станах, крім DISARMED (безпека, живлення, зайняте радіо поряд із приймачем ELRS).
- Пробіг у метрах із поправкою на проковзування, одометрія положення і карта маршруту — є лише лічильники коліс; поправка потребує заміру радіуса кочення (фаза 4).
- Абсолютний час сесій (дата і година) — на платі немає годинника, а синхронізація часу не просилась; сервер ставить власну мітку отримання.
- Консольна команда зміни режиму контролю і налаштування звіту (склад полів, період, топіки) з консолі — режим міняє лише пульт, решта є константами прошивки.
- Заміри Wi-Fi та енергоспоживання (TP3 під навантаженням, скільки секунд тримається радіо) — окремий замір Розробника, не частина коду.
- Зміна порога перешкоди чи логіки секторів — лише вимикач і краща діагностика.

## 4. User stories

### US-01: Вимикати контроль перешкод з пульта

**As a** Розробник
**I want** вмикати й вимикати контроль і автозупинку по далекомірах окремим тумблером пульта
**So that** я можу підʼїхати впритул чи виїхати з тісного місця, не роззброюючи ровер

### US-02: Бачити, що контроль працює

**As a** Розробник
**I want** щоб індикатор плати світив зеленуватим, коли контроль ввімкнений і реально охороняє
**So that** я з одного погляду знаю стан захисту й не покладаюся на нього, коли він вимкнений чи не працює

### US-03: Знати, який датчик бачить перешкоду

**As a** Розробник
**I want** щоб консоль при утриманні називала всі датчики, що бачать перешкоду, з відстанями
**So that** я розумію, з якого боку й наскільки широка перешкода, особливо спереду, де три датчики

### US-04: Отримати звіт після виїзду

**As a** Розробник
**I want** щоб після роззброєння ровер сам надсилав на сервер підсумок сесії
**So that** я бачу історію виїздів і стан акумулятора без підключення USB

### US-05: Не втратити сесії без мережі

**As a** Розробник
**I want** щоб невідправлені звіти зберігались і йшли пізніше
**So that** відсутність мережі чи збій сервера не стирають дані виїзду

### US-06: Не ризикувати керуванням через мережу

**As a** Розробник
**I want** щоб Wi-Fi працював лише в DISARMED, не заважав озброєнню і вимикався одразу після передачі
**So that** радіо ніколи не впливає на безпеку й живлення під час руху

### US-07: Знати пробіг і швидкості бортів

**As a** Розробник
**I want** бачити у звіті пробіг, час руху, середню й пікову швидкість бортів і їхній дисбаланс
**So that** я оцінюю виїзд і помічаю повільний чи слабкий борт

### US-08: Тримати секрети поза git і консоллю

**As a** Розробник
**I want** щоб паролі Wi-Fi і сервера були лише в локальному файлі і ніколи не показувались
**So that** репозиторій і журнал можна безпечно ділити

### US-09: Перевіряти логіку на хості

**As a** Агент
**I want** збирати прошивку й запускати хостові тести логіки сесії, статистики, черги й режиму контролю
**So that** я підтверджую правила без заліза й не пускаю в збірку нові попередження

## 5. Acceptance criteria

### AC-01 (US-01) — happy path

**Given** ровер озброєний, зв'язок з пультом живий, контроль перешкод ввімкнений, а перед ровером у переднього сектора перешкода ближча за поріг
**When** Розробник переводить тумблер контролю в положення «вимкнено»
**Then** ровер перестає вважати сектор зайнятим, рух уперед знову дозволений, консоль пише один рядок про вимкнення контролю, а інваріанти безпеки діють без змін

### AC-02 (US-01) — happy path

**Given** ровер у стані утримання перед перешкодою, контроль ввімкнений
**When** Розробник вимикає тумблер контролю
**Then** ровер одразу повертається в ARMED і їде за стіками, навіть якщо перешкода досі перед ним, а обліковий час цього утримання закривається

### AC-03 (US-01) — domain invariant violation

**Given** контроль вимкнений і ровер їде
**When** зв'язок з пультом зникає на понад пів секунди або напруга акумулятора падає нижче порога відсічки
**Then** ровер зупиняється і переходить у FAILSAFE, як і при ввімкненому контролі: вимкнення захисту перешкод не послаблює жодного інваріанта безпеки

### AC-04 (US-01) — error handling

**Given** плата щойно стартувала й пульт не передав жодного кадру, або зв'язок з пультом втрачено
**When** Розробник дивиться на стан ровера командою `status`
**Then** контроль перешкод показаний як ввімкнений зі згадкою, що це значення за замовчуванням, поки пульт не підтвердить інше

### AC-05 (US-02) — happy path

**Given** контроль ввімкнений, ровер у DISARMED або ARMED і хоча б один сектор охороняється
**When** Розробник дивиться на індикатор плати
**Then** індикатор світить зеленуватим, а після вимкнення контролю тумблером гасне

### AC-06 (US-02) — domain invariant violation

**Given** контроль ввімкнений, але ровер у FAILSAFE або в утриманні перед перешкодою
**When** Розробник дивиться на індикатор плати
**Then** у FAILSAFE він червоний, в утриманні жовтий, зелений не показується: аварійні та попереджувальні кольори мають пріоритет

### AC-07 (US-02) — cross-context

**Given** контроль ввімкнений, але жоден далекомір не працює (усі в стані відмови або знімок застарів)
**When** Розробник дивиться на індикатор плати
**Then** зелений не світить, і консоль каже, що захист від зіткнень не діє, щоб індикатор не обіцяв захисту, якого немає

### AC-08 (US-03) — happy path

**Given** контроль ввімкнений, перед ровером перешкода, яку бачать два з трьох передніх датчиків ближче за поріг
**When** ровер входить в утримання перед перешкодою
**Then** консоль один раз називає передній сектор і обидва датчики, що бачать перешкоду, з відстанню кожного, і не називає третій датчик, який перешкоди не бачить

### AC-09 (US-03) — error handling

**Given** контроль ввімкнений, один із передніх датчиків у стані відмови, а перешкоду бачить інший
**When** ровер входить в утримання
**Then** консоль називає лише справний датчик, що бачить перешкоду, і не називає несправний як такий, що бачить перешкоду

### AC-10 (US-04) — happy path

**Given** Wi-Fi і сервер доступні, ровер озброївся з напругою на старті сесії, проїхав і роззброївся
**When** ровер входить у DISARMED
**Then** він вмикає Wi-Fi, надсилає один звіт цієї сесії, чекає підтвердження сервера, одразу вимикає Wi-Fi і пише в консоль, що звіт доставлено

### AC-11 (US-04) — cross-context

**Given** сесія завершилась і звіт готовий до відправлення
**When** Розробник дивиться на вміст звіту на сервері
**Then** звіт містить напругу на старті й на роззброєнні, причину завершення сесії (роззброєння, втрата зв'язку чи напруга), кількість утримань перед перешкодою з сумарним часом, мінімальною відстанню і датчиком, пробіг і час руху, середню й пікову швидкість лівого та правого борту з дисбалансом, версію прошивки, git-хеш, версію IDF і MAC плати

### AC-12 (US-04) — cross-context

**Given** сесію завершив FAILSAFE через втрату зв'язку, а потім Розробник повернув ровер у DISARMED
**When** ровер входить у DISARMED
**Then** звіт цієї сесії позначає причину «втрата зв'язку» і надсилається так само, як після звичайного роззброєння

### AC-13 (US-04) — cross-context

**Given** сесію завершив FAILSAFE через напругу, вихід із якого можливий лише перезапуском плати
**When** ровер перезапускається і входить у DISARMED
**Then** звіт цієї сесії з причиною «напруга» збережений у памʼяті плати, надсилається при цьому першому DISARMED, а під час самого FAILSAFE Wi-Fi не вмикався

### AC-14 (US-05) — error handling

**Given** Wi-Fi недоступний, сервер не відповідає або відхиляє дані
**When** ровер входить у DISARMED зі звітом у черзі
**Then** спроба завершується вимкненням Wi-Fi до кінця ліміту часу, звіт лишається в черзі, консоль називає причину невдачі, а ровер працює й озброюється як звичайно

### AC-15 (US-05) — domain invariant violation

**Given** у черзі вже два невідправлені звіти, а мережі немає
**When** завершується третя сесія
**Then** найстарший звіт видаляється з поясненням у журналі, у черзі лишаються два новіші: невідправлених звітів ніколи не більше двох

### AC-16 (US-05) — happy path

**Given** у черзі два невідправлені звіти і мережа знову доступна
**When** ровер входить у DISARMED
**Then** обидва звіти надсилаються в порядку створення, кожен видаляється з черги після підтвердження, а Wi-Fi вимикається після останнього

### AC-17 (US-05) — authorization

**Given** ровер озброєний, в утриманні перед перешкодою або у FAILSAFE
**When** Розробник вводить команду показу й негайної передачі звітів
**Then** команда показує стан черги, але передачу не запускає й пояснює, що передача можлива лише в DISARMED

### AC-18 (US-06) — domain invariant violation

**Given** триває спроба передачі звіту в DISARMED
**When** Розробник озброює ровер
**Then** передачу негайно перервано, Wi-Fi вимкнено, звіт лишився в черзі, озброєння відбулось у звичайний спосіб і в звичайний час, не чекаючи закриття з'єднання

### AC-19 (US-06) — cross-context

**Given** ровер у будь-якому стані, крім DISARMED
**When** Розробник перевіряє стан радіо
**Then** Wi-Fi вимкнений у BOOT, SELFTEST, ARMED, OBSTACLE_HOLD, FAILSAFE і FAULT, а сама передача не затримує жодного такту керування і не змінює стан автомата

### AC-20 (US-07) — happy path

**Given** контроль ввімкнений, на підлозі позначено один метр, діаметр колеса — значення з журналу вимірювань
**When** Розробник проїжджає цей метр прямо і роззброює ровер
**Then** пробіг у звіті відрізняється від виміряного рулеткою не більше ніж на п'ять відсотків

### AC-21 (US-07) — error handling

**Given** у одного борту немає жодного доступного енкодера, або ровер за сесію не їхав по прямій
**When** формується звіт
**Then** швидкості недоступного борту й дисбаланс позначені як «немає даних», а не нулем, і звіт це пояснює

### AC-22 (US-08) — authorization

**Given** сервер пред'являє сертифікат, який ровер не вважає довіреним
**When** ровер намагається надіслати звіт
**Then** дані не надсилаються, звіт лишається в черзі, консоль пише, що сертифікат сервера не довірений

### AC-23 (US-08) — authorization

**Given** локальний файл із паролями заповнений
**When** Розробник вводить будь-яку команду консолі чи дивиться журнал, `status` і звіт на сервері
**Then** пароль Wi-Fi і пароль сервера ніде не показані, а в репозиторії є лише шаблон без значень

### AC-24 (US-08) — error handling

**Given** локального файлу з паролями немає
**When** збирається прошивка й ровер входить у DISARMED зі звітом у черзі
**Then** збірка проходить без помилок і нових попереджень, передача не починається, а консоль один раз на кожен вхід у DISARMED із непорожньою чергою пояснює, що налаштування мережі не задано

### AC-25 (US-04) — happy path

**Given** сесія зі збереженим номером, мінімальною напругою, утриманнями за двома датчиками, часом із вимкненим контролем і тривалістю
**When** Розробник дивиться на звіт цієї сесії
**Then** звіт містить порядковий номер сесії, тривалість, мінімальну напругу, лічильник утримань для кожного датчика і час, коли контроль був вимкнений

### AC-26 (US-09) — happy path

**Given** логіка сесії, статистики, черги звітів і режиму контролю реалізована в частинах без заголовків ESP-IDF
**When** Агент запускає хостові тести й збирає прошивку
**Then** усі хостові тести проходять, збірка завершується без помилок і без нових попереджень

## 6. Non-functional requirements

| Aspect | Target | Measurement |
|---|---|---|
| Реакція індикації на тумблер контролю | ≤ 200 мс від зміни значення каналу до зміни світла індикатора | стенд, відео або мітки журналу |
| Тривалість спроби передачі | ≤ 30 с від входу в DISARMED до вимкнення Wi-Fi, успішної чи ні | мітки журналу |
| Wi-Fi вимкнено після спроби | 100 % спроб (успішних, невдалих і перерваних озброєнням) | `status` + журнал |
| Вплив на керування | 0 нових кроків керування довших за період 20 мс під час спроби; озброєння не затримується; виняток — моменти запису в памʼять плати (≤ 2 на сесію), коли крок і озброєння можуть затриматись на тривалість запису (як `pid save`) | `status` (час кроку) до і після спроби |
| Вільна внутрішня памʼять після вимкнення Wi-Fi | не менше за значення до спроби мінус 4096 байт; поріг ≥ 345000 байт зберігається | `status` |
| Памʼять сховища | ≤ 2 звіти в черзі; ≤ 2 записи в памʼять плати на сесію (створення і видалення після доставки) | журнал, лічильник записів |
| Розмір звіту | ≤ 1024 байти | довжина в журналі |
| Точність пробігу | ±5 % на 1 м по рулетці (як у фазі 4) | замір на підлозі |
| Точність напруги у звіті | ±0.1 В щодо `status` у той самий момент | звірка консолі й звіту |
| Витік секретів | 0 входжень паролів у git, консоль, журнал, `status`, звіт | пошук по репозиторію й виводу |
| Збірка | без помилок і нових попереджень (п. 8) | `idf.py build` |
| Покриття логікою на хості | 0 заголовків ESP-IDF у `*_core.c` нових компонентів; кожне правило A1–A10 і A17 має ≥ 1 хостовий тест (п. 6) | `test/host/` |

## 6.1 Security / privacy

- **Data classification:** confidential — мережеві паролі та облікові дані сервера; сам звіт (напруга, пробіг, швидкості) — internal, ідентифікує лише пристрій.
- **Personal data touched:** none. MAC плати — ідентифікатор пристрою, а не особи; геопозиції, імен і точних дат у звіті немає.
- **AuthZ/AuthN impact:** ровер автентифікується на сервері іменем користувача й паролем; сервер автентифікується сертифікатом, який ровер перевіряє, без перевірки не надсилає. Вхідних команд із мережі немає (non-goal). Консоль лишається єдиним місцем керування звітами.
- **Abuse cases:**
  - Підміна сервера (перехоплення мережі): сертифікат не довірений — дані не надсилаються, звіт лишається в черзі.
  - Витік паролів через git, журнал чи консоль: файл налаштувань у `.gitignore`, у репозиторії лише шаблон, пароль маскується скрізь.
  - Розсилка на чужий Wi-Fi: ровер підключається лише до мережі, заданої локальним файлом; з відкритими мережами не працює.
  - Тримання радіо ввімкненим (зависання, безкінечні спроби): жорстка межа 30 с на спробу, повторів у межах одного DISARMED немає.
  - Віддалений вплив на ровер: вхідного каналу немає.
- **Security review:** Required (нова мережева межа, облікові дані, перевірка сертифіката).

## 7. Metrics / KPIs

- **Частка сесій, доставлених із першої спроби на домашній мережі** — baseline: 0 (даних немає), target: ≥ 9 із 10 підряд сесій протягом перших двох тижнів після прошивки.
- **Втрачені сесії при недоступній мережі** — baseline: 100 % (дані зникають), target: 0 втрат, поки послідовних недоставлених сесій не більше двох.
- **Кроки керування довші за 20 мс під час передачі** — baseline: 0 (передачі немає), target: 0 за всі спроби приймання.
- **Час від входу в DISARMED до доставки** — baseline: немає, target: ≤ 30 с на кожній успішній спробі.

## 8. Open questions

- [x] OQ-1. SSID і пароль Wi-Fi та справжній пароль сервера (пароль із чату вважається скомпрометованим). Рішення: Розробник надасть значення в локальний файл налаштувань поза git. — owner: Розробник, due: before sdd:implement (значення ще не передані)
- [x] OQ-2. Сертифікат сервера: власний, підписаний власником. Рішення: кореневий сертифікат потрібен у проєкті; Розробник надає його файл. — owner: Розробник, due: before sdd:implement (файл ще не переданий)
- [x] OQ-3. Правки захищених файлів для Wi-Fi, захищеного з'єднання й сховища: дозволено Розробником 2026-10-22 (A22).
- [x] OQ-4. Назви топіків і рівень гарантії доставки: рішення за агентом на етапі `design` (default: один топік на пристрій з MAC, доставка «принаймні раз», дублікат відсікає номер сесії).
- [ ] OQ-5. TP3 під Wi-Fi (≥ 3.25 В, документ 01 §5.5): Розробник виміряє й запише в `docs/measured.md`. Default now: умови зняття Wi-Fi на низькій напрузі немає. — owner: Розробник, due: before acceptance
- [ ] OQ-6. Два положення перемикача CH9 (значення каналу) і який перемикач TX12 виведено на канал: Розробник запише в `docs/measured.md`. Default now: «вище середини» = увімкнено. Рев'ю 2026-10-22: не закрито, AC-01…AC-05 не приймаються, доки не записано. — owner: Розробник, due: before acceptance
- [ ] OQ-7. Спробу передачі не можна перервати озброєнням під час TCP-з'єднання й DNS: `esp_tls_conn_new_async` у IDF v6.1 блокує `select` до `timeout_ms` (10 с), а межа 30 с може бути перевищена (рев'ю 2026-10-22, знахідка 5; AC-14, AC-18, AC-19). Рішення: відкласти до заліза — виміряти на прийманні (кроки 12 і 20 `acceptance.md`); якщо проблема підтвердиться, переписати connect власним неблокуючим сокетом з `esp_tls_set_conn_sockfd()`. — owner: Розробник/Агент, due: before acceptance
