12romis/esp32-elrs-rover/docs/features/phase6-tof/spec.md

---
status: Draft
owner: "Розробник проєкту"
reviewers: ["Розробник проєкту"]
updated_at: "2026-10-20"
feature_size: "S"
---

# Spec — phase6-tof

> **Glossary:** [CONTEXT](../../../CONTEXT.md)
> **Reference module / docs / channels used:** `docs/02-FIRMWARE-CONTEXT.md` (§4.7, §5, §6.1–6.3, §7 «Фаза 6», §8.5, §9, §10.3), `docs/constitution.md` (пп. 1–4, 6–8, 12–14), `docs/roadmap.md` (крок 6, ворота «Фаза 6 — P4», рішення D4), `docs/measured.md` (P4: послідовність XSHUT 10 з 10, драйвер, реакція на долоню, розташування далекомірів, фон над підлогою, точність на 100 мм; фаза 4: діаметр колеса, затримка «кадр → борти», вільна памʼять), `docs/features/phase5-pid/spec.md` (стиль, матриця дозволів, правила регулятора без зворотної потужності, `pid trace` лише в ARMED, таблиця переходів з 11 пар), `docs/features/phase3-crsf/spec.md` (інваріанти ARMED: втрата звʼязку, відсічка), поточний код `components/app_state/` (таблиця переходів), `components/drive/drive_core.c` (інваріанти перевіряються лише в ARMED), `components/board/include/board_pins.h` (біти XSHUT), `tools/bringup/main/p4_tof.c` (діагностичний драйвер), `kicad-rover/kicad-rover.net` (лише читання).

## 1. Context

Після фази 5 ровер тримає задану швидкість бортів, але про перешкоди не знає: стік уперед на стіну означає удар на повній швидкості. Чотири далекоміри на шасі вже працюють: передфаза P4 підтвердила послідовність скидання й перепризначення адрес (10 запусків з 10), мінімальний власний драйвер, реакцію всіх чотирьох на долоню та відсутність хибних відліків над підлогою. Прошивка їх не читає. Проблема стосується двох ролей: Розробника (їздить пультом і з консолі, не хоче розбити ровер об стіну й не хоче, щоб відмова одного датчика на ходу зупинила чи повісила прошивку) і Агента (збирає прошивку й перевіряє логіку на хості).

Чому зараз: ворота фази 6 (P4) пройдено, драйвер підтверджено. Фази 1–5 дали озброєння, мікшер, відсічку по напрузі, втрату звʼязку, зумер і світло, енкодери та регулятор швидкості; автомат станів уже має стан OBSTACLE_HOLD, але він недосяжний (жодна фаза в нього не веде). Фаза 7 (телеметрія, інтеграція) чекає на повний набір станів. Фаза 6 — перша, що змінює таблицю переходів автомата після фази 3 і поширює інваріанти безпеки ARMED на новий стан.

Обраний підхід. Прошивка раз на 50 мс опитує чотири далекоміри, фільтрує відліки медіаною і зводить їх у два сектори: передній (три передні далекоміри) і задній (один). Сектор зайнятий, коли його відстань менша за поріг перешкоди. У бік зайнятого сектора складова «тяга» мікшера дорівнює нулю, складова «поворот» не змінюється, а рух у протилежний бік дозволений. Поки хоч один сектор зайнятий, озброєний ровер перебуває в OBSTACLE_HOLD і повертається в ARMED, коли сектори вільні. Відмова далекоміра не є аварією: його сектор не вважається зайнятим через нього, у журнал іде попередження, а повернути датчик у роботу можна лише командою консолі в DISARMED. Поріг — одна константа калібрування зі значенням із журналу вимірювань.

Traceability: вимоги — `docs/02-FIRMWARE-CONTEXT.md` §7 «Фаза 6» і крок 6 у `docs/roadmap.md`. Рішення власника в цій сесії (2026-10-20): розмір S, маршрут quick, глибина easy (roadmap оцінював крок як L; оцінку в roadmap оновлено); специфікацію пишемо до заміру порогу, поріг — відкрите питання (OQ-1, див. override нижче); поворот на місці при зайнятому секторі дозволений, обнуляється лише тяга (A5); таблиця переходів отримує дванадцяту пару OBSTACLE_HOLD → DISARMED; відмовивший далекомір повертається в роботу лише командою в DISARMED; поріг — константа компіляції, консоль його не змінює. Список припущень агента (A1–A12) наведено нижче; власник може скасувати будь-яке одним повідомленням:

- A1. Передній сектор — далекоміри U7 (ліворуч-вперед, 45°), U8 (прямо вперед), U9 (праворуч-вперед, 45°); задній — U10. Відстань сектору — мінімум відфільтрованих відстаней його працюючих далекомірів.
- A2. Один поріг для всіх секторів і далекомірів. Діагональні далекоміри геометричної корекції не мають: вони бачать перешкоду вздовж свого променя.
- A3. Фільтр — медіана з трьох останніх відліків далекоміра (документ 02 §7 допускає 3–5). Відлік «поза діапазоном» (значення 8190 мм у P4) входить у медіану як велике число і означає «перешкоди немає».
- A4. Сектор стає зайнятим, щойно медіана менша за поріг (строго менше); звільнення підтверджується трьома поспіль оновленнями відстані сектору, що не менші за поріг (≈ 150 мс). Без гістерезису по відстані, бо його значення не виміряно (пункт 3 конституції).
- A5. Тягу до нуля обмежує знизу (передній сектор зайнятий) або зверху (задній); «поворот» мікшера не змінюється, тож у зайнятому секторі ровер може розвертатися на місці. Обмеження стоїть до плавного розгону й регулятора, зупинка діє одразу (правило фази 5).
- A6. OBSTACLE_HOLD залежить від наявності зайнятого сектора, а не від напрямку, якого просить стік. Вихід з нього не вимагає нейтралі стіка (плавний розгін фази 5 пом'якшує старт). Захист однаково діє для пульта й стендової команди руху з консолі.
- A7. Відмова далекоміра — відсутність відповіді при старті або 250 мс без валідного відліку (п'ять періодів опитування). Відмова не веде в FAULT, не блокує озброєння; якщо справних далекомірів немає зовсім, озброєння дозволене, а журнал на старті й при кожному озброєнні попереджає, що захист вимкнено.
- A8. Команда `tof` показує стан у будь-якому стані автомата й нічого не змінює; поріг не задається з консолі.
- A9. Повторна ініціалізація — одна команда на всі відмовлені далекоміри, лише в DISARMED, без зміни світла й без порушення решти далекомірів.
- A10. Сам перехід станів STBY не піднімає (ні в OBSTACLE_HOLD, ні назад); STBY піднімає лише свідома команда руху — стік пульта чи `drive` — у стані ARMED або OBSTACLE_HOLD, бо це той самий озброєний ровер. Це тлумачення пункту 7 конституції; власник підтвердив його в OQ-3 і уточнив на review (2026-10-21).
- A11. Критерії приймання §6 (250 мс, ≤ 20 мс, 345000 байт, 10 заїздів з 10) — пропозиції агента.
- A12. Окремої індикації перешкоди немає: у OBSTACLE_HOLD задні ліхтарі показують рух як в ARMED, зумер мовчить, а перехід між ARMED і OBSTACLE_HOLD не вмикає фари примусово й не дає сигналу переходу; інформація — у журналі консолі.

Розбіжності, озвучені за пунктом 1 конституції:
- Документ 02 §6.3 не має виходу OBSTACLE_HOLD → DISARMED, а глосарій і фази 1–3 кажуть, що роззброїти ровер можна завжди. Рішення власника: додати пару до таблиці (12 пар із 49); тест «рівно 11 пар» і §6.3 документа 02 оновлюються разом із кодом.
- Документ 02 §9 дає для `TOF_OBSTACLE_MM` лише «~200», а в журналі вимірювань числа немає. Пункт 3 конституції забороняє підставляти «типове значення», тому це число в специфікації й у коді не з'являється (OQ-1).
- Документ 02 §6.3 відправляє критичну відмову самоперевірки у FAULT. Для далекомірів це не так: за §7 «Фаза 6» відмова датчика — деградація, а не FAULT.
- У фазах 1–5 усе, що стосується руху, прив'язане до ARMED, бо OBSTACLE_HOLD був недосяжним. Перевірено в коді; тепер кожне з цих місць має діяти й в OBSTACLE_HOLD (AC-12, AC-14, AC-15), інакше відповідні критерії хибні: у `drive_core.c` поза ARMED виходи вимкнені й STBY внизу (отже, у OBSTACLE_HOLD ровер не зміг би здати назад, а STBY піднімався б заново при поверненні в ARMED, усупереч AC-13 і пункту 7 конституції), скидається регулятор, запит роззброєння й тумблер DISARM діють лише в ARMED, відсічка по напрузі, втрата звʼязку й нове зʼявлення пульта також; у `console_core.c` команда руху приймається лише в ARMED; у `ui_core.c` автоматичний режим задніх ліхтарів діє лише в ARMED і FAILSAFE (у OBSTACLE_HOLD вони згасли б), кожен вхід в ARMED примусово вмикає фари й дає сигнал переходу (при частих ARMED ↔ OBSTACLE_HOLD це було б блиманням і писком), а ручні команди світла й зумера в OBSTACLE_HOLD відхилені.
- Журнал вимірювань: P4 дав U7 = 118 мм при стіні на 100 мм, тоді як для 45° очікується ≈ 141 мм; не пояснено. Помилка в бік «ближче», тобто безпечна для порогу, але причина не досліджена.
- `docs/architecture-map.md` досі описує компоненти фаз 1–6 як заглушки; оновлення карти — справа `survey`.

**Decision override (2026-10-20): специфікацію написано до заміру `TOF_OBSTACLE_MM` попри пункти 3–4 конституції — rationale:** власник обрав «писати з порогом як відкрите питання». Критерії посилаються на поріг за іменем без числа; число з'явиться в журналі вимірювань до `/sdd:tasks` (OQ-1). Значення «~200» з документа 02 §9 не використовується.

## 2. Goals

- Ровер на ходу не в'їжджає в перешкоду: зупиняється перед нею, лишає вільні напрямки (назад, поворот на місці) і сам повертається до руху, коли сектор звільнився.
- Відмова чи вийняття далекоміра, у тому числі на ходу, ніколи не зупиняє і не вішає прошивку; Розробник бачить її в консолі й повертає датчик у роботу в DISARMED.
- Усі інваріанти безпеки ARMED (відсічка по напрузі, втрата звʼязку, STBY, роззброєння) діють і в OBSTACLE_HOLD; роззброїти ровер можна завжди.
- Уся логіка (фільтр, сектори, обмеження тяги, відмова, переходи автомата, дозволи й розбір команд) перевіряється на хості без плати.

## 3. Non-goals

- Бокове покриття й розворот без ризику зачепити перешкоду збоку — датчиків на боках немає (журнал вимірювань, P4), тож розворот на місці дозволений, і кути корпусу можуть зачепити непокриту зону.
- Перешкоди, яких промінь далекоміра не бачить (прозорі, дзеркальні, дуже темні, дуже вузькі, нижче чи вище променя) і край підлоги — це особливість датчиків; на шасі не вимірювалося.
- Активне гальмування — регулятор фази 5 не подає зворотної потужності, ровер зупиняється вибігом; поріг має покривати цей вибіг (OQ-1), а не код.
- Поріг, що залежить від швидкості, окремі пороги для діагональних далекомірів і геометрична корекція 45° — одна константа для всіх (A2), бо інших виміряних чисел немає.
- Автоматичний обʼїзд і повернення ровера без Розробника — ровер лише обнуляє тягу в зайнятий бік (A5).
- Повернення відмовившого далекоміра на ходу чи автоматично — лише команда в DISARMED (рішення власника): повторна ініціалізація торкається ліній скидання на розширювачі портів, який тримає й світло.
- Консольна зміна порогу — рішення власника: поріг, як межа потужності, змінюється лише правкою прошивки після запису в журнал вимірювань.
- Звукова чи світлова індикація перешкоди й передача на пульт — індикація OBSTACLE_HOLD лишається в журналі (A12), пульт — телеметрія фази 7.
- Захист, коли сектор лишився без працюючих далекомірів: сектор вважається вільним (вимога документа 02 §7 «Фаза 6»), ровер їде в цей бік наосліп, єдиний сигнал — попередження в журналі (AC-06, AC-07).
- Поведінка далекоміра на відстані менше 40 мм не оброблена й не виміряна (OQ-2).

## 4. User stories

### US-01: Ровер зупиняється перед перешкодою

**As a** Розробник
**I want** щоб озброєний ровер, який їде вперед, зупинявся перед стіною чи предметом, навіть якщо я тримаю стік уперед
**So that** ровер не б'ється об перешкоди, коли я не встигаю відпустити стік

### US-02: Можна здати назад і розвернутися

**As a** Розробник
**I want** щоб при зайнятому секторі ровер виїжджав у вільний бік і розвертався на місці, а сам повертався до руху вперед, коли сектор звільнився
**So that** я вибираюся з-перед перешкоди тим самим стіком, без роззброєння

### US-03: Ровер переживає відмову далекоміра

**As a** Розробник
**I want** щоб вийнятий, непідключений чи завислий далекомір не зупиняв і не вішав прошивку, а я бачив це в консолі й міг повернути датчик у роботу в DISARMED
**So that** одна відмова не виводить ровер з ладу, а сліпу зону я бачу і виправляю

### US-04: Бачити далекоміри в консолі

**As a** Розробник
**I want** командою консолі бачити стан і відстань кожного далекоміра, відстань секторів, поріг і чи діє захист
**So that** я перевіряю датчики на шасі й підбираю поріг за заміром

### US-05: Інваріанти безпеки діють і в утриманні

**As a** Розробник
**I want** щоб у OBSTACLE_HOLD діяли відсічка по напрузі, втрата звʼязку, роззброєння та вся решта правил ARMED, а світло й регулятор працювали як зазвичай
**So that** новий стан не стає лазівкою в захисті ровера

### US-06: Перевірювана логіка

**As a** Агент
**I want** покрити логіку далекомірів і протизіткнення хостовими тестами та зібрати прошивку без попереджень
**So that** помилки фільтра, секторів і переходів ловляться без плати, а залізо перевіряє лише те, чого хост не бачить

### US-07: Межі роботи Агента

**As a** Агент
**I want** чітко знати, що поріг перешкоди і приймання на залізі належать Розробникові
**So that** я не вигадую поріг і не позначаю виконаним неперевірене

## 5. Acceptance criteria

### AC-01 (US-01) — happy path

**Given** ровер озброєний з пульта, колеса на підлозі, напруга не нижче 7.4 В, показ далекомірів називає всі чотири справними, а поріг перешкоди записано в журнал вимірювань і прошито; перед ровером на відстані понад 1 м стоїть плоска стіна (картон), перпендикулярна напрямку руху
**When** Розробник тримає стік рівно вперед і їде до стіни; потім повторює заїзд на стіку 60 % і 30 % ходу
**Then** у кожному заїзді ровер зупиняється, не торкнувшись стіни, а автомат переходить в OBSTACLE_HOLD; консоль одним рядком називає зайнятий сектор («передній»), відстань і поріг; обидва борти отримують нуль не пізніше ніж через 250 мс після першого відліку, меншого за поріг (мітки часу в журналі); поки Розробник тримає стік уперед, ровер не рухається вперед; відстань від переднього краю ровера до стіни після зупинки Розробник міряє рулеткою й записує в журнал вимірювань

### AC-02 (US-01) — happy path

**Given** та сама підготовка, що в AC-01, але стіни прямо попереду немає; на шляху ліворуч-вперед стоїть коробка так, що її бачить лише лівий передній далекомір, а прямий далекомір її не бачить
**When** Розробник їде вперед стіком, поки коробка не опиниться в зоні лівого переднього далекоміра, а потім так само з коробкою праворуч-вперед і правим переднім далекоміром
**Then** в обох заїздах ровер зупиняється в OBSTACLE_HOLD, консоль називає передній сектор і далекомір, що побачив перешкоду, і ровер не торкається коробки; прямий далекомір, який перешкоди не бачить, зупинку не блокує й не запускає

### AC-03 (US-02) — happy path

**Given** ровер у OBSTACLE_HOLD після AC-01, стік утримується вперед, ззаду вільно (задній сектор не зайнятий)
**When** Розробник відводить стік назад
**Then** ровер їде назад; щойно передній сектор вільний три оновлення поспіль (≈ 150 мс), автомат повертається в ARMED, консоль повідомляє про звільнення сектору, а рух назад триває; коли Розробник знову їде вперед до перешкоди, ровер знову зупиняється за AC-01

### AC-04 (US-02) — happy path

**Given** ровер у OBSTACLE_HOLD, передній сектор зайнятий, ззаду вільно
**When** Розробник тримає стік уперед і праворуч одночасно, а потім лише праворуч
**Then** у першому випадку складова «тяга» дорівнює нулю, а «поворот» лишається: ровер розвертається на місці праворуч (лівий борт уперед, правий назад, однакові за модулем швидкості); у другому — так само; коли після повороту передній сектор вільний, автомат повертається в ARMED і стік уперед знову везе ровер уперед

### AC-05 (US-02) — domain invariant

**Given** ровер озброєний, зайнятий задній сектор (стіна позаду ближче за поріг), передній вільний; окремо — зайняті обидва сектори
**When** Розробник відводить стік назад, потім уперед, потім стік тільки вбік
**Then** при зайнятому задньому секторі рух назад заборонений (нуль обом бортам), а рух уперед дозволений; при двох зайнятих секторах тяга в обидва боки дорівнює нулю, а поворот на місці працює; заборона рухатися в бік зайнятого сектора ніколи не виконується частково — ні плавним гальмуванням до порогу, ні дозволом проїхати «ще трохи»

### AC-06 (US-03) — error

**Given** ровер їде вперед, озброєний з пульта, усі чотири далекоміри справні, перед ровером немає перешкод
**When** Розробник на ходу виймає шлейф одного далекоміра, в окремих заїздах — по черзі кожного з чотирьох; в одному з заїздів після відмови одного переднього далекоміра ровер їде до стіни, яку бачить інший, справний передній
**Then** прошивка не зависає й не перезавантажується (час від старту плати в `status` не скидається), затримка «кадр пульта → борти» лишається в межах §6, стіки, мотори й озброєння працюють; не пізніше ніж через 0.5 с у журналі зʼявляється одне попередження з назвою далекоміра та його місцем, команда `tof` показує «відмова», а сектор не вважається зайнятим через цей далекомір; перешкода перед справним далекоміром усе ще зупиняє ровер (AC-01); якщо ровер був у OBSTACLE_HOLD через цей далекомір, він повертається в ARMED без дій Розробника; поки сектор лишається без жодного справного далекоміра, попередження каже, що сектор не охороняється

### AC-07 (US-03) — error

**Given** плату вмикають, коли один (в іншому прогоні — усі чотири) далекомір відʼєднано
**When** Розробник чекає, поки прошивка дійде до DISARMED
**Then** журнал старту називає результат кожного далекоміра; відсутні названо відмовою з попередженням; автомат не переходить у FAULT і доходить до DISARMED, озброєння не блокується; якщо жоден далекомір не справний, журнал на старті й при кожному озброєнні каже, що захист від зіткнень вимкнено, а ровер їздить без нього

### AC-08 (US-03) — cross-context

**Given** ровер у DISARMED, один далекомір у відмові (AC-06 чи AC-07), шлейф підключено назад; фари увімкнено вручну, а задній ліхтар вимкнено
**When** Розробник подає команду повторної ініціалізації далекомірів
**Then** далекомір повертається в роботу: консоль підтверджує, показ називає його справним з відстанню, а фари не гаснуть і не блимають, ліхтар не змінюється; на час команди (до 3 с, ровер стоїть) опитування решти справних далекомірів призупиняється, а після її завершення вони знову дають відстані без хибних відмов; якщо далекомір досі не відповідає, консоль називає його відмовившим, а все інше лишається без змін

### AC-09 (US-03) — authorization

**Given** ровер у будь-якому стані, крім DISARMED (BOOT, SELFTEST, ARMED, OBSTACLE_HOLD, FAILSAFE, FAULT)
**When** Розробник подає команду повторної ініціалізації далекомірів
**Then** команду відхилено з поясненням, що перезапуск далекомірів можливий лише в DISARMED, бо торкається ліній скидання на розширювачі портів; жоден далекомір, стан автомата, світло й команди бортам не змінюються

### AC-10 (US-04) — happy path

**Given** ровер у будь-якому стані автомата
**When** Розробник подає команду показу далекомірів
**Then** консоль друкує для кожного з чотирьох далекомірів його місце (ліворуч-вперед, вперед, праворуч-вперед, назад), стан (працює, поза діапазоном, відмова) і відфільтровану відстань у міліметрах; для кожного сектору — відстань, і чи він зайнятий, вільний чи не охороняється; поріг перешкоди в міліметрах; чи діє захист; стан автомата, озброєння й команди бортам не змінюються

### AC-11 (US-04) — error

**Given** ровер у будь-якому стані автомата
**When** Розробник подає команду далекомірів з невідомою формою, зайвими словами, нечисловим чи числовим аргументом (спроба задати поріг), або з комою замість крапки
**Then** команду відхилено з поясненням, які форми допустимі (показ і повторна ініціалізація) і що поріг з консолі не змінюється; поріг, стан далекомірів, автомат і команди бортам не змінюються

### AC-12 (US-05) — domain invariant

**Given** ровер у OBSTACLE_HOLD, передній сектор зайнятий
**When** по черзі в окремих прогонах: напруга акумулятора падає нижче 6.0 В; зв'язок з пультом зникає понад 0.5 с; у стендовому режимі зʼявляється пульт; Розробник вимикає тумблер озброєння чи подає з консолі команду роззброєння; у стендовому режимі команда руху сплила (2 с без повтору)
**Then** при напрузі нижче 6.0 В ровер переходить у FAILSAFE з причиною «напруга», мотори нуль, STBY внизу, вихід лише апаратним скиданням; при втраті зв'язку — у FAILSAFE з причиною «втрата зв'язку» не пізніше ніж через 0.52 с, як у фазі 3; зʼявлення пульта й спливання команди руху закінчують консольне керування й роззброюють, як в ARMED; роззброєння виконується одним переходом у DISARMED, STBY внизу; жодна з цих реакцій не залежить від того, чи справні далекоміри

### AC-13 (US-05) — domain invariant

**Given** автомат станів із таблицею переходів
**When** перевіряють кожну пару з семи станів
**Then** у таблиці рівно 12 дозволених пар із 49: пари фаз 0–3 плюс OBSTACLE_HOLD → DISARMED; в OBSTACLE_HOLD можна потрапити лише з ARMED, а вийти — в ARMED, DISARMED і FAILSAFE; з BOOT, SELFTEST, DISARMED, FAILSAFE і FAULT переходу в OBSTACLE_HOLD немає; команда озброєння в OBSTACLE_HOLD відхиляється, як в ARMED; жоден перехід станів не піднімає STBY (ні в OBSTACLE_HOLD, ні з нього); піднімає його лише свідома команда руху — стік пульта чи `drive` — в ARMED або OBSTACLE_HOLD

### AC-14 (US-05) — cross-context

**Given** ровер у OBSTACLE_HOLD (передній сектор зайнятий), регулятор швидкості увімкнено, трасування регулятора ввімкнене, пульт керує
**When** Розробник їде назад стіком, а потім намагається зберегти набір коефіцієнтів регулятора
**Then** регулятор тримає задану швидкість назад із допуском фази 5 (±5 % після розгону); рядки трасування виводяться раз на 100 мс, як в ARMED (зміна відносно фази 5, де рядки йшли лише в ARMED); задні ліхтарі показують напрямок руху, як в ARMED; фари лишаються такими, якими були (перехід між ARMED і OBSTACLE_HOLD не вмикає їх примусово), і сигнал переходу не звучить; збереження набору відхилено так само, як в ARMED, з поясненням, що ровер озброєний

### AC-15 (US-05) — cross-context

**Given** стендовий режим (пульта немає), ровер озброєний з консолі, передній сектор зайнятий
**When** Розробник подає команду руху вперед, а потім команду руху назад
**Then** на команду вперед обидва борти лишаються з нулем, консоль один раз пояснює, що напрямок заблоковано перешкодою (а не на кожен повтор); на команду назад ровер їде, команда діє 2 с і сама гасне, як у фазі 1; стендове керування захищене тим самим правилом, що й пульт

### AC-16 (US-05) — cross-context

**Given** ровер озброєний, фари й задні ліхтарі працюють, далекоміри опитуються
**When** Розробник їде 60 с, кілька разів зупиняючись перед перешкодою, і робить кілька повторних ініціалізацій у DISARMED
**Then** світло не блимає без причини, у журналі немає жодного попередження про помилку шини чи розширювача портів, а затримка «кадр пульта → борти» не перевищує межу §6; шина працює на 100 кГц

### AC-17 (US-06) — happy path

**Given** Агент завершив зміну в межах фази 6
**When** Агент запускає збірку проєкту і прогін хостових тестів
**Then** збірка завершується без помилок і без нових попереджень, а прогін повідомляє кількість тестів і що всі пройдені; серед них перевірено: медіану з трьох відліків (зокрема викид, відлік поза діапазоном, перші відліки після старту); відстань сектору за мінімумом справних далекомірів і сектор без жодного справного; зайнятий сектор строго за порогом і звільнення за трьома поспіль відліками; обмеження тяги знизу й зверху з незмінним поворотом, розворот на місці, два зайняті сектори; вибір відмови за 250 мс без відліку; перехід ARMED ↔ OBSTACLE_HOLD і відсутність переходу, коли захист вимкнено; таблицю переходів з 12 пар і відсутність входу в OBSTACLE_HOLD з інших станів; дозволи команд далекомірів за станом; розбір форм команди (показ, повторна ініціалізація, відхилення зайвого й спроби задати поріг); збереження інваріантів ARMED у OBSTACLE_HOLD (напруга, втрата звʼязку, нове зʼявлення пульта, спливання команди руху)

### AC-18 (US-06) — error

**Given** у зміні файл чистої логіки (з суфіксом core) підключив заголовок ESP-IDF чи FreeRTOS, або номер лінії зʼявився літералом поза єдиним файлом розпіновки, або поріг перешкоди заданий літералом поза файлом калібрування чи числом, якого немає в журналі вимірювань, або частота шини вища за 100 кГц, або періодична задача чекає звичайною затримкою замість очікування до моменту, або зʼявилося нове попередження збірки
**When** Агент запускає збірку і хостові перевірки
**Then** задачу не вважають завершеною, Агент називає файл і причину та не позначає задачу виконаною

### AC-19 (US-07) — authorization

**Given** задача фази 6 стосується поведінки на залізі (зупинка перед перешкодою, відмова далекоміра на ходу, повернення датчика, світло під час повторної ініціалізації) або вибору порогу
**When** Агент закінчив код і хостовий прогін зелений
**Then** Агент не позначає задачу виконаною, доки Розробник не запише приймання на залізі в журнал bring-up; Агент не підставляє поріг перешкоди (ні «типовий» з документа 02, ні вгаданий) і не записує число в журнал вимірювань від себе, не прошиває плату, не фіксує зміни в історії без прямої вказівки, не змінює захищені файли без явної згоди Розробника і не редагує каталог проєкту плати взагалі

### Поведінка захисту

Уточнення агента, прийняті разом зі списком A1–A12 (§1); хостові тести AC-17 перевіряють кожне.

- **Опитування.** Кожен справний далекомір вимірюється безперервно, відстань оновлюється раз на 50 мс. Відліки лише для читання; опитування не змінює станів автомата саме по собі.
- **Фільтр.** Медіана з трьох останніх відліків одного далекоміра. Поки відліків менше трьох після старту чи повернення датчика, далекомір вважається таким, що ще не дав відстані, і сектор через нього не зайнятий.
- **Відстань сектору.** Мінімум відфільтрованих відстаней справних далекомірів сектору. Сектор без жодного справного далекоміра «не охороняється» і вільний.
- **Зайнятість.** Сектор зайнятий, коли відстань строго менша за поріг. Сектор вільний після трьох поспіль оновлень відстані, не менших за поріг.
- **Обмеження руху.** Передній сектор зайнятий → «тяга» мікшера не менша за нуль; задній → не більша за нуль; «поворот» не змінюється. Обмежений вихід мікшера далі йде через стелю заданої швидкості, плавний розгін і регулятор як у фазі 5, тож зупинка негайна, а старт плавний.
- **Автомат.** ARMED → OBSTACLE_HOLD, коли будь-який сектор стає зайнятим; OBSTACLE_HOLD → ARMED, коли обидва вільні; OBSTACLE_HOLD → DISARMED при роззброєнні; OBSTACLE_HOLD → FAILSAFE за тими ж причинами, що й ARMED → FAILSAFE. Переходи пишуться в історію й в журнал з відстанню, що їх викликала.
- **Відмова.** Далекомір, що не відповів при старті чи не дав валідного відліку 250 мс, у відмові; попередження — один рядок на кожну зміну (відмова, повернення), без повторів на кожен такт. Відстань, яку він віддав раніше, більше не враховується.
- **Повторна ініціалізація.** Лише DISARMED; торкається ліній скидання лише відмовивших далекомірів; зберігає стан світла й адреси справних.
- **Гальмування.** Захист обнуляє команду. Додаткового гальмування ззовні немає (фаза 5); шлях від зайняття сектору до зупинки покриває поріг (OQ-1).

### Матриця дозволів консольних команд за станом

Зміни відносно фази 5: нові рядки команд далекомірів; команда руху з консолі (`drive`) тепер приймається й в OBSTACLE_HOLD за правилом AC-15 (раніше лише в ARMED); дозвіл `pid trace` не змінюється, але рядки трасування виводяться тепер і в OBSTACLE_HOLD (раніше лише в ARMED). Ручні команди світла й зумера в OBSTACLE_HOLD, як і раніше, відхиляються (фаза 2). Решта рядків без змін.

| Команда | BOOT | SELFTEST | DISARMED | ARMED | OBSTACLE_HOLD | FAILSAFE | FAULT |
|---|:---:|:---:|:---:|:---:|:---:|:---:|:---:|
| tof (показ) | так | так | так | так | так | так | так |
| tof reinit (повторна ініціалізація) | ні | ні | так | ні | ні | ні | ні |

*Примітка до перевірки:* фільтр, сектори, обмеження тяги, відмову, перехід станів, таблицю з 12 пар, дозволи й розбір команд перевіряють хостові тести з підставним годинником. Зупинку перед перешкодою, відмову на ходу, повернення датчика, світло під час повторної ініціалізації й відсутність збоїв шини приймає Розробник на залізі, результат — у журнал bring-up (пункт 6 конституції).

## 6. Non-functional requirements

| Aspect | Target | Measurement |
|---|---|---|
| Період опитування далекоміра | 50 мс | огляд коду; хостовий тест із підставним годинником |
| Реакція на перешкоду | обидва борти отримують нуль ≤ 250 мс після першого відліку, меншого за поріг (опитування ≤ 50 мс, медіана з 3, такт керування 20 мс) | мітки часу в журналі, приймання AC-01 |
| Виявлення відмови | 250 мс без валідного відліку (п'ять періодів опитування); одне попередження на зміну | хостовий тест; журнал, AC-06 |
| Звільнення сектору | три поспіль оновлення відстані, не менші за поріг (≈ 150 мс) | хостовий тест; AC-03 |
| Таблиця переходів автомата | рівно 12 дозволених пар із 49 | хостовий тест, AC-13 |
| Затримка «кадр пульта → борти» | ≤ 20 мс максимум, зокрема з опитуванням далекомірів і трасуванням (фаза 4: макс 15 мс) | діагностичні мітки часу фази 3 в журналі монітора |
| Шина периферії | 100 кГц, один мʼютекс на всі пристрої; опитування далекомірів не викликає попереджень про помилки шини за 60 с | журнал монітора, AC-16 |
| Повторна ініціалізація | світло не змінюється; опитування решти далекомірів призупиняється на час команди (≤ 3 с, лише DISARMED) і відновлюється без хибних відмов (послаблено на design 2026-10-21: ініціалізація датчика містить очікування до 500 мс) | приймання AC-08 |
| Періодичні задачі | 0 викликів звичайної затримки: лише очікування до моменту (пункт 14 конституції) | огляд коду + пошук викликів затримки в нових файлах |
| Хостовий прогін тестів | ≤ 5 с, 100 % тестів пройдено | вивід хостового раннера |
| Збірка | 0 помилок, 0 нових попереджень | вивід збірки проєкту |
| Вільна внутрішня памʼять після старту | baseline 353635 байт (фаза 4, журнал вимірювань); ≥ 345000 байт | `status`, запис у журнал вимірювань |

Джерела чисел: 50 мс — період задачі `sensors` (документ 02 §6.1); 20 мс — такт керування (фаза 5); 100 кГц — пункт 14 конституції; 6.0 В і 0.5 с — пункт 7 конституції; 353635 байт і 15 мс — фаза 4 (журнал вимірювань). Критерії 250 мс, 150 мс, 345000 байт, 10 заїздів з 10 і відсутність помилок шини за 60 с — пропозиції агента (A11), які власник приймає або змінює. Число порогу перешкоди в таблиці відсутнє навмисно (OQ-1).

## 6.1 Security / privacy

- **Data classification:** internal — відстані до перешкод навчального ровера, видимі лише в консолі через USB.
- **Personal data touched:** none.
- **AuthZ/AuthN impact:** нових меж доступу немає; команди далекомірів доступні лише з консолі за матрицею §5; пульт не має дій над далекомірами; поріг змінюється лише правкою прошивки; повторна ініціалізація лише в DISARMED.
- **Abuse cases:**
  - Спроба виставити поріг 0 чи завеликий з консолі: команда з числом відхиляється (AC-11), порогу в консолі немає.
  - Відмова, що вводить ровер в оману: відмовивший далекомір ніколи не робить сектор зайнятим, але й не блокує рух; попередження в журналі й показ у `tof` (AC-06, AC-07).
  - Перешкода, якої далекомір не бачить: ровер її не виявляє (§3).
  - Повторна ініціалізація під час руху: заборонена матрицею (AC-09), бо торкається ліній скидання на розширювачі портів і світла.
  - Завислий обмін по шині: після 250 мс без відліку далекомір у відмові, керування не чекає (AC-06).
- **Security review:** N/A — фаза не додає зовнішніх інтерфейсів; нові шляхи керування моторами обмежені тими самими інваріантами безпеки (AC-12, AC-13).

## 7. Metrics / KPIs

- **Зупинка перед перешкодою** — baseline: захисту немає, ровер на повному стіку їде в стіну; target: 10 заїздів з 10 на стіну (стік 100 %, 60 %, 30 %) зупиняються без дотику, відстані зупинки записано в журнал вимірювань при прийманні фази 6.
- **Час реакції** — baseline: не вимірюється; target: ≤ 250 мс від першого відліку, меншого за поріг, до нуля бортам при прийманні (AC-01).
- **Відмова далекоміра** — baseline: далекомірів у прошивці немає; target: 4 вийнятих шлейфи з 4 (по одному на далекомір) на ходу без зависання чи перезапуску, 4 повернення з 4 командою в DISARMED при прийманні (AC-06, AC-08).
- **Поріг перешкоди** — baseline: у журналі вимірювань порожньо; target: значення записане з датою й способом заміру до `/sdd:tasks` (OQ-1).

## 8. Open questions

- [x] OQ-1 (закрито 2026-10-21: вибіг ≤ 30 мм, поріг 170 мм за рішенням Розробника, запис у журналі вимірювань; нижче — початкове формулювання): Яке значення порогу перешкоди (`TOF_OBSTACLE_MM`)? Замір чинною прошивкою фази 5 (захисту ще немає): розмітити підлогу; їхати прямо до риски на стіку 100 %, 60 % і 30 % (≈ 150, 90 і 45 обертів колеса за хвилину), на риску повернути стік у нейтраль; рулеткою виміряти вибіг понад риску, по 5 заїздів на швидкість; взяти найгірший вибіг. Поріг має бути не меншим за найгірший вибіг + шлях за час реакції 250 мс (на 150 обертах колеса за хвилину швидкість ≈ 345 мм/с, тобто ≈ 86 мм) + похибка далекоміра (P4: +12…−7 мм на 100 мм) + запас на власний розсуд. Default now: числа немає — критерії посилаються на поріг за іменем, код і задачі не пишуться. — owner: Розробник, due: до `/sdd:tasks`
- [ ] OQ-2: Що показує далекомір ближче за 40 мм від стіни? P4 міряв долонею від 41 мм (журнал вимірювань); нижче невідомо, а датчики цього типу ближче за ≈ 30 мм можуть віддавати хибне «далеко». Замір діагностичною прошивкою P4 (режим 1): долоня чи картон на 10, 20, 30 мм від кожного далекоміра. Default now: поведінка менше 40 мм не оброблена (§3), хибне «далеко» при вплотну поставленому ровері означає, що захисту немає. — owner: Розробник, due: до приймання фази 6 на залізі
- [x] OQ-3 (закрито 2026-10-21: Розробник підтвердив, STBY лишається піднятим в OBSTACLE_HOLD): Чи тлумачити пункт 7 конституції («STBY піднімається тільки в стані ARMED і тільки свідомо») так, що в OBSTACLE_HOLD STBY лишається піднятим після входу з ARMED і не піднімається заново? Інакше рух назад з OBSTACLE_HOLD неможливий. Default now: STBY лишається піднятим, піднімається лише свідомою командою руху (A10, AC-13). — owner: Розробник, due: до `/sdd:design` Уточнено на review 2026-10-21 (R1): свідома команда руху (стік пульта чи `drive`) може підняти STBY у ARMED і в OBSTACLE_HOLD; сам перехід станів STBY не піднімає.
