12romis/esp32-elrs-rover/docs/features/phase8-session-report/tasks/t12-report-net-hal.md

---
id: T12
title: "Створити report_net_hal: підключення Wi-Fi, TLS із закріпленим сертифікатом і обмін MQTT з таймаутом 100 мс на крок"
layer: "infra"
deps: ["T8", "T11"]
blocks: ["T13"]
acs: ["AC-22"]
files_hint: ["components/report/report_net_hal.c", "components/report/include/report_net_hal.h"]
owner: "Агент"
estimate: "M"
context_budget: "S"
status: "done"
step: "COMMIT"
---

# T12 — Створити report_net_hal: підключення Wi-Fi, TLS із закріпленим сертифікатом і обмін MQTT з таймаутом 100 мс на крок

## Place in the sequence

- **Blocked by:** T8 — Створити mqtt_core: кодування CONNECT, PUBLISH (QoS 1), DISCONNECT і розбір CONNACK та PUBACK для MQTT 3.1.1, T11 — Створити report_store_hal і налаштування мережі: NVS-кільце звітів одним записом, версія й git образу, локальний файл секретів, сертифікат, зміни сборки · **Blocks:** T13 — Створити report_hal: задачу report на core 0 з спробою передачі при вході в DISARMED, скасуванням озброєнням і записом результатів · **Wave:** 7.
- **Lane:** shares `components/report/report_net_hal.c` with T0 — serialized.

## Why (user story)

> **As a** Розробник
> **I want** щоб паролі Wi-Fi і сервера були лише в локальному файлі і ніколи не показувались
> **So that** репозиторій і журнал можна безпечно ділити
>
> — `spec.md §4, US-08, verbatim` · full text: [spec.md](../spec.md)

Задача дає частину історії: створити report_net_hal: підключення Wi-Fi, TLS із закріпленим сертифікатом і обмін MQTT з таймаутом 100 мс на крок.

## Inlined context

> A15. **Передача.** Успіх — коли сервер підтвердив прийом повідомлення; відсутність підтвердження — невдача. Одна спроба обмежена в часі: від входу в DISARMED до вимкнення Wi-Fi не більше 30 с (пропозиція агента; реального часу підключення ще не виміряно). Після спроби, успішної чи ні, Wi-Fi вимикається одразу. Сервер (сертифікат власний, підписаний власником; кореневий сертифікат кладеться в проєкт) — адреса, порт і ім'я користувача з запиту Розробника (захищене з'єднання, порт 8883), перевірка сертифіката сервера за цим кореневим сертифікатом обовʼязкова; без перевірки дані не надсилаються. Адреса й порт не є секретом, але лежать у тому самому локальному файлі налаштувань, що й секрети.
>
> — `spec.md §1, A15, verbatim` · full text: [spec.md](../spec.md)

> A20. **Деградації.** Немає локального файлу налаштувань, Wi-Fi недоступний, сервер відхиляє дані чи сертифікат не довірений — ровер працює, як і раніше, звіт лишається в черзі, у журналі одне повідомлення про причину на спробу. Дані звіту, яких немає (енкодер борту, далекомір), позначаються «немає даних». Помилка передачі не змінює стан автомата, моторів і світла.
>
> — `spec.md §1, A20, verbatim` · full text: [spec.md](../spec.md)

> **Chosen:** варіант 1. `esp_netif` і цикл подій створюються один раз при старті задачі (лічені кілобайти), а самі буфери Wi-Fi створюються й повністю звільняються на спробу; повернення памʼяті перевіряється `status`. Ліміти (пропозиція агента, spec A21): підключення Wi-Fi ≤ 15 с, TLS+MQTT ≤ 10 с, усього ≤ 30 с. Задача запускається подією «вхід у DISARMED» (опитування стану раз на 100 мс) і командою консолі. Видалення відправленого звіту з NVS виконується після вимкнення Wi-Fi.
>
> — `adr/0003-bring-wi-fi-up-and-down-per-delivery-attempt-in-a-dedicated-core-0-task-that-yields-to-arming.md, Decision outcome, verbatim` · full text: [adr/](../adr/)

> **Chosen:** варіант 1 (рішення Розробника, 2026-10-22). Кодер/розбірник пакетів — чисті функції, перевіряються хостовими тестами на еталонних байтах; HAL лише відкриває TLS-зʼєднання, пише й читає байти з таймаутом 100 мс на крок (щоб `report` перевіряв стан не рідше ніж раз на 100 мс). Топік `rover/<mac>/session`, QoS 1, `retain` вимкнено, client id `rover-<mac>`, чиста сесія, keepalive не потрібен (зʼєднання коротке); номер сесії у документі відсікає дублікати (spec A12, A17).
>
> — `adr/0002-implement-a-minimal-mqtt-3-1-1-publisher-in-report-core-over-esp-tls.md, Decision outcome, verbatim` · full text: [adr/](../adr/)

> Автентифікація: ім'я користувача й пароль із локального файлу налаштувань; сервер перевіряється власним кореневим сертифікатом (ADR-0006). Пароль у документі, журналі й `status` не з'являється.
>
> — `contracts/events.md, «Channel», abridged` · full text: [events.md](../contracts/events.md)

> Конституція, п. 7: STBY піднімається тільки в ARMED; втрата кадрів CRSF довша за 500 мс → ШІМ у нуль, STBY вниз; перша операція по I²C після старту — запис 0x00 у PCF8574; VBAT < 6.0 В → мотори не запускаються. Інваріанти сильніші за будь-яку функціональність.
>
> — `docs/constitution.md, п. 7, abridged` · full text: [constitution.md](../../../constitution.md)

**Fallback:** insufficient or contradicted by the code → read the named file in full ([spec.md](../spec.md) · [sad.md](../sad.md) · [contracts/](../contracts/) · [adr/](../adr/)) and follow it. Do not guess.

## Data delta

No DB changes.

## API contract

Зовнішній обмін: Wi-Fi → TLS → MQTT з сервером власника (events.md, «Channel»).

## Acceptance criteria

### AC-22 — authorization

> **Given** сервер пред'являє сертифікат, який ровер не вважає довіреним
> **When** ровер намагається надіслати звіт
> **Then** дані не надсилаються, звіт лишається в черзі, консоль пише, що сертифікат сервера не довірений
>
> — `spec.md §5, AC-22, verbatim` · full text: [spec.md](../spec.md)

## Checklist

- [ ] `report_net_hal.c`: `net_up()` (створення `esp_netif`/циклу подій один раз; `esp_wifi_init`/`start`/`connect` з таймаутом ≤ 15 с), `net_publish(doc,len,&outcome)` (TLS через `esp-tls` із `cacert_buf` та перевіркою імені сервера; CONNECT → CONNACK → PUBLISH → PUBACK → DISCONNECT через `mqtt_core`; кожен I/O з таймаутом 100 мс і колбеком «чи ще дозволено» для переривання), `net_down()` (повне `esp_wifi_stop`/`deinit`, звільнення буферів).
- [ ] Результати: доставлено, немає мережі, сертифікат недовірений, відмова/немає підтвердження, перервано; сертифікат недовірений → нічого не надсилається, CONNECT не відправляється.
- [ ] Ліміти спроби: Wi-Fi ≤ 15 с, TLS+MQTT ≤ 10 с, усього ≤ 30 с (пропозиція агента, spec A21). Пароль не логується.

## Edge cases

| Case | Behaviour |
|---|---|
| сертифікат сервера не довірений | дані не надсилаються, результат «сертифікат не довірений» |
| Wi-Fi недоступний | результат «немає мережі» у межах ліміту |
| колбек «дозволено» повертає ні | зʼєднання закривається не пізніше ніж за 100 мс + закриття, Wi-Fi вимикається |
| CONNACK з відмовою | результат «відмова сервера», PUBLISH не надсилається |

## Definition of Done

- [ ] `idf.py build` без нових попереджень
- [ ] вільна памʼять після `net_down` повертається до значення до спроби мінус 4096 байт (перевірка T17)
- [ ] кожне Hard Rule вище лишається дійсним
