12romis/esp32-elrs-rover/docs/features/phase8-session-report/tasks/t14-console-report-command.md

---
id: T14
title: "Додати в консоль команду report та поля status про режим контролю й звіти, з підключенням у main"
layer: "ports"
deps: ["T10", "T13"]
blocks: ["T15", "T16"]
acs: ["AC-17", "AC-24"]
files_hint: ["components/rover_console/console_core.c", "components/rover_console/include/console_core.h", "components/rover_console/console_hal.c", "main/main.c", "test/host/test_console.c"]
owner: "Агент"
estimate: "M"
context_budget: "S"
status: "done"
step: "COMMIT"
---

# T14 — Додати в консоль команду report та поля status про режим контролю й звіти, з підключенням у main

## Place in the sequence

- **Blocked by:** T10 — Підʼєднати session до drive_hal: виклик session_step наприкінці кроку керування, подачу підсумку в чергу й логування подій режиму, T13 — Створити report_hal: задачу report на core 0 з спробою передачі при вході в DISARMED, скасуванням озброєнням і записом результатів · **Blocks:** T15 — Додати хостові перевірки: гігієна секретів у git, повний прогін збірки й тестів, захищені файли дозволені лише в межах фази, T16 — Оновити README, архітектурну діаграму й самоперевірку: режим CH9, індикатор, звіт сесії, налаштування мережі, відомі обмеження · **Wave:** 9.
- **Lane:** own lane.

## Why (user story)

> **As a** Розробник
> **I want** щоб після роззброєння ровер сам надсилав на сервер підсумок сесії
> **So that** я бачу історію виїздів і стан акумулятора без підключення USB
>
> — `spec.md §4, US-04, verbatim` · full text: [spec.md](../spec.md)

> **As a** Розробник
> **I want** щоб невідправлені звіти зберігались і йшли пізніше
> **So that** відсутність мережі чи збій сервера не стирають дані виїзду
>
> — `spec.md §4, US-05, verbatim` · full text: [spec.md](../spec.md)

Задача дає частину історії: додати в консоль команду report та поля status про режим контролю й звіти, з підключенням у main.

## Inlined context

> A16. **Консоль.** Нова команда показує стан звітів (скільки невідправлено, які сесії, результат останньої спроби, режим контролю) і в DISARMED запускає спробу передачі негайно зі своїми 30 с від моменту команди; якщо спроба вже йде, команда відхиляється з поясненням «передача вже триває»; якщо черга порожня — повідомляє «нічого надсилати» і Wi-Fi не вмикає; в інших станах відхиляється з поясненням. Команда потрібна для приймання на залізі без виїзду; пароль вона ніколи не показує (A19).
>
> — `spec.md §1, A16, verbatim` · full text: [spec.md](../spec.md)

> | Ситуація | Що робить `report` |
> | DISARMED, черга непорожня, налаштування задані | показує стан і запускає спробу з власним лімітом 30 с від моменту команди |
> | DISARMED, спроба вже триває | показує стан і пише «передача вже триває» |
> | DISARMED, черга порожня | показує стан і пише «нічого надсилати»; Wi-Fi не вмикає |
> | DISARMED, налаштувань немає | показує стан і пише «налаштування мережі не задано, передача не починається» |
> | ARMED, OBSTACLE_HOLD, FAILSAFE | показує стан черги; передачу не запускає й пояснює, що вона можлива лише в DISARMED |
> | BOOT, SELFTEST, FAULT | показує стан черги; передача відхиляється з тим самим поясненням |
>
> — `contracts/cli.md, «Права за станом», abridged` · full text: [cli.md](../contracts/cli.md)

> `status`: «контроль перешкод» — «увімкнено»/«вимкнено» (для увімкненого за замовчуванням — «(за замовчуванням, пульт не підтвердив)»), «охороняє»/«не охороняє»; «звіти» — кількість у черзі, результат останньої спроби, налаштування «задано/не задано», стан радіо. Паролі й SSID ніколи не друкуються. `help` отримує рядок `report`.
>
> — `contracts/cli.md, «status: нові поля», «help», abridged` · full text: [cli.md](../contracts/cli.md)

> Конституція, п. 6: кожен компонент ділиться на `<name>_core.c` (без жодного заголовка ESP-IDF) і `<name>_hal.c`; логіка живе в core і покривається тестами на хості. Пп. 8–9: збірка без помилок і без нових попереджень; коментарі й коміти — українською, ідентифікатори — англійською.
>
> — `docs/constitution.md, пп. 6, 8, 9, abridged` · full text: [constitution.md](../../../constitution.md)

**Fallback:** insufficient or contradicted by the code → read the named file in full ([spec.md](../spec.md) · [sad.md](../sad.md) · [contracts/](../contracts/) · [adr/](../adr/)) and follow it. Do not guess.

## Data delta

No DB changes.

## API contract

`report` (без аргументів): стан черги → режим → мережа → результат дії; зайві аргументи — клас «зайві аргументи»; права за станом — cli.md «Права за станом».

## Acceptance criteria

### AC-17 — authorization

> **Given** ровер озброєний, в утриманні перед перешкодою або у FAILSAFE
> **When** Розробник вводить команду показу й негайної передачі звітів
> **Then** команда показує стан черги, але передачу не запускає й пояснює, що передача можлива лише в DISARMED
>
> — `spec.md §5, AC-17, verbatim` · full text: [spec.md](../spec.md)

### AC-24 — error handling

> **Given** локального файлу з паролями немає
> **When** збирається прошивка й ровер входить у DISARMED зі звітом у черзі
> **Then** збірка проходить без помилок і нових попереджень, передача не починається, а консоль один раз на кожен вхід у DISARMED із непорожньою чергою пояснює, що налаштування мережі не задано
>
> — `spec.md §5, AC-24, verbatim` · full text: [spec.md](../spec.md)

## Checklist

- [ ] `console_core.h/.c`: `CONSOLE_CMD_REPORT`; форматування рядків (`report_fmt_status`, перелік причин) — у core; відмова за станом через існуючу матрицю прав.
- [ ] `console_hal.c` і `main/main.c`: колбеки `report_status`/`report_now` (з `report_hal`), рядки `status` про режим (`drive_status`) і звіти; `help`.
- [ ] Хостові тести `test/host/test_console.c`: парсинг, всі сім станів, п'ять ситуацій DISARMED, паролі й SSID відсутні у виводі.

## Edge cases

| Case | Behaviour |
|---|---|
| аргумент після report | «зайві аргументи», нічого не змінюється |
| ARMED | стан черги показується, передача не запускається, пояснення |
| DISARMED, спроба вже йде | «передача вже триває», друга не запускається |
| налаштувань немає | «налаштування мережі не задано», без падіння |
| вивід містить рядки з паролем | неприпустимо: тест шукає SSID і паролі у виводі |

## Definition of Done

- [ ] хостові тести console проходять; `console_core.c` без заголовків ESP-IDF
- [ ] `idf.py build` без нових попереджень
- [ ] кожне Hard Rule вище лишається дійсним
