12romis/esp32-elrs-rover/docs/features/phase8-session-report/tasks/t17-acceptance-checklist.md

---
id: T17
title: "Скласти чекліст приймання на залізі для Розробника: CH9, індикатор, список датчиків, доставка, черга, переривання озброєнням, FAILSAFE, замір запису в памʼять"
layer: "tests"
deps: ["T15", "T16"]
blocks: []
acs: ["AC-05", "AC-18", "AC-19", "AC-20", "AC-22"]
files_hint: ["docs/features/phase8-session-report/acceptance.md"]
owner: "Розробник"
estimate: "M"
context_budget: "S"
status: "done"
step: "COMMIT"
---

# T17 — Скласти чекліст приймання на залізі для Розробника: CH9, індикатор, список датчиків, доставка, черга, переривання озброєнням, FAILSAFE, замір запису в памʼять

## Place in the sequence

- **Blocked by:** T15 — Додати хостові перевірки: гігієна секретів у git, повний прогін збірки й тестів, захищені файли дозволені лише в межах фази, T16 — Оновити README, архітектурну діаграму й самоперевірку: режим CH9, індикатор, звіт сесії, налаштування мережі, відомі обмеження · **Blocks:** — · **Wave:** 11 (Виконує Розробник; Агент лише складає чекліст.).
- **Lane:** own lane.

## Why (user story)

> **As a** Розробник
> **I want** щоб невідправлені звіти зберігались і йшли пізніше
> **So that** відсутність мережі чи збій сервера не стирають дані виїзду
>
> — `spec.md §4, US-05, verbatim` · full text: [spec.md](../spec.md)

> **As a** Розробник
> **I want** бачити у звіті пробіг, час руху, середню й пікову швидкість бортів і їхній дисбаланс
> **So that** я оцінюю виїзд і помічаю повільний чи слабкий борт
>
> — `spec.md §4, US-07, verbatim` · full text: [spec.md](../spec.md)

> **As a** Розробник
> **I want** щоб паролі Wi-Fi і сервера були лише в локальному файлі і ніколи не показувались
> **So that** репозиторій і журнал можна безпечно ділити
>
> — `spec.md §4, US-08, verbatim` · full text: [spec.md](../spec.md)

Задача дає частину історії: скласти чекліст приймання на залізі для Розробника: CH9, індикатор, список датчиків, доставка, черга, переривання озброєнням, FAILSAFE, замір запису в памʼять.

## Inlined context

> A21. **Критерії приймання §6** (30 с, ±5 %, 4096 байт, 1024 байти, 200 мс) — пропозиції агента, як і в фазі 7.
>
> — `spec.md §1, A21, verbatim` · full text: [spec.md](../spec.md)

> | Вільна внутрішня памʼять після вимкнення Wi-Fi | не менше за значення до спроби мінус 4096 байт; поріг ≥ 345000 байт зберігається | `status` |
> | Тривалість спроби передачі | ≤ 30 с від входу в DISARMED до вимкнення Wi-Fi, успішної чи ні | мітки журналу |
> | Точність пробігу | ±5 % на 1 м по рулетці (як у фазі 4) | замір на підлозі |
>
> — `spec.md §6, три рядки, verbatim` · full text: [spec.md](../spec.md)

> Конституція, п. 7: STBY піднімається тільки в ARMED; втрата кадрів CRSF довша за 500 мс → ШІМ у нуль, STBY вниз; перша операція по I²C після старту — запис 0x00 у PCF8574; VBAT < 6.0 В → мотори не запускаються. Інваріанти сильніші за будь-яку функціональність.
>
> — `docs/constitution.md, п. 7, abridged` · full text: [constitution.md](../../../constitution.md)

**Fallback:** insufficient or contradicted by the code → read the named file in full ([spec.md](../spec.md) · [sad.md](../sad.md) · [contracts/](../contracts/) · [adr/](../adr/)) and follow it. Do not guess.

## Data delta

No DB changes.

## API contract

Internal — no API surface.

## Acceptance criteria

### AC-05 — happy path

> **Given** контроль ввімкнений, ровер у DISARMED або ARMED і хоча б один сектор охороняється
> **When** Розробник дивиться на індикатор плати
> **Then** індикатор світить зеленуватим, а після вимкнення контролю тумблером гасне
>
> — `spec.md §5, AC-05, verbatim` · full text: [spec.md](../spec.md)

### AC-18 — domain invariant violation

> **Given** триває спроба передачі звіту в DISARMED
> **When** Розробник озброює ровер
> **Then** передачу негайно перервано, Wi-Fi вимкнено, звіт лишився в черзі, озброєння відбулось у звичайний спосіб і в звичайний час, не чекаючи закриття з'єднання
>
> — `spec.md §5, AC-18, verbatim` · full text: [spec.md](../spec.md)

### AC-19 — cross-context

> **Given** ровер у будь-якому стані, крім DISARMED
> **When** Розробник перевіряє стан радіо
> **Then** Wi-Fi вимкнений у BOOT, SELFTEST, ARMED, OBSTACLE_HOLD, FAILSAFE і FAULT, а сама передача не затримує жодного такту керування і не змінює стан автомата
>
> — `spec.md §5, AC-19, verbatim` · full text: [spec.md](../spec.md)

### AC-20 — happy path

> **Given** контроль ввімкнений, на підлозі позначено один метр, діаметр колеса — значення з журналу вимірювань
> **When** Розробник проїжджає цей метр прямо і роззброює ровер
> **Then** пробіг у звіті відрізняється від виміряного рулеткою не більше ніж на п'ять відсотків
>
> — `spec.md §5, AC-20, verbatim` · full text: [spec.md](../spec.md)

### AC-22 — authorization

> **Given** сервер пред'являє сертифікат, який ровер не вважає довіреним
> **When** ровер намагається надіслати звіт
> **Then** дані не надсилаються, звіт лишається в черзі, консоль пише, що сертифікат сервера не довірений
>
> — `spec.md §5, AC-22, verbatim` · full text: [spec.md](../spec.md)

## Checklist

- [ ] `acceptance.md`: кроки з очікуваним результатом і місцем запису доказу: CH9 у двох положеннях (записати в `docs/measured.md`, OQ-6); зелений/жовтий/червоний індикатор; рядок консолі з двома датчиками; сесія → доставка на реальний сервер; відключений роутер → черга 2; перезапуск після FAILSAFE через напругу; озброєння під час спроби; TP3 під Wi-Fi (OQ-5); `crc_fail` приймача до/під час спроби; тривалість запису в NVS; пробіг 1 м.
- [ ] Не позначати пункт виконаним без доказу (журнал, `status`, замір).

## Edge cases

| Case | Behaviour |
|---|---|
| сервер недоступний | пункт про доставку перевіряється з черги (AC-14), а не пропускається |
| немає акумулятора, живлення від USB | передача можлива (умови напруги для Wi-Fi немає, OQ-5), але TP3-замір обов'язковий окремо |

## Definition of Done

- [ ] кожен пункт має очікування й місце запису доказу
- [ ] кожне Hard Rule вище лишається дійсним
