12romis/esp32-elrs-rover/docs/features/phase8-session-report/tasks/t2-tof-below-mask-and-hold-line.md

---
id: T2
title: "Додати в tof_core маску датчиків нижче порога й розширити рядок утримання переліком усіх таких датчиків"
layer: "domain"
deps: []
blocks: ["T5"]
acs: ["AC-08", "AC-09"]
files_hint: ["components/tof/tof_core.c", "components/tof/include/tof_core.h", "test/host/test_tof.c"]
owner: "Агент"
estimate: "M"
context_budget: "S"
status: "done"
step: "COMMIT"
---

# T2 — Додати в tof_core маску датчиків нижче порога й розширити рядок утримання переліком усіх таких датчиків

## Place in the sequence

- **Blocked by:** — · **Blocks:** T5 — Створити session_core: межі сесії за станом, причина завершення, напруга, утримання за датчиками, час із вимкненим контролем, номер і тривалість · **Wave:** 1.
- **Lane:** own lane.

## Why (user story)

> **As a** Розробник
> **I want** щоб консоль при утриманні називала всі датчики, що бачать перешкоду, з відстанями
> **So that** я розумію, з якого боку й наскільки широка перешкода, особливо спереду, де три датчики
>
> — `spec.md §4, US-03, verbatim` · full text: [spec.md](../spec.md)

Задача дає частину історії: додати в tof_core маску датчиків нижче порога й розширити рядок утримання переліком усіх таких датчиків.

## Inlined context

> A4. **Консоль при перешкоді.** Рядок утримання перед перешкодою (існує з фази 6) тепер називає **кожен** датчик сектора, чия відстань менша за поріг перешкоди (`TOF_OBSTACLE_MM`, 170 мм), з його відстанню, а не лише найближчий; назви беруться з наявного іменування датчиків. Рядок з'являється один раз при вході в утримання; зміна складу датчиків усередині утримання нового рядка не дає (щоб не шуміти на межі порога). Для сектора позаду це один датчик. Якщо на вході зайняті обидва сектори, рядок називає датчики обох секторів, кожен із позначкою свого сектора.
>
> — `spec.md §1, A4, verbatim` · full text: [spec.md](../spec.md)

> Flow 7: знімок далекомірів доходить до control; сектор зайнятий → запит OBSTACLE_HOLD; control запитує, які датчики сектора нижче порога; рядок консолі називає передній сектор і кожен датчик нижче порога з відстанню, або задній сектор з одним датчиком, або датчики обох секторів з позначкою сектора; несправний датчик не називається; один рядок на вхід в утримання; у звіт сесії йдуть лічильник утримань, датчики нижче порога на вході й мінімум відстані.
>
> — `sad.md §6, «Flow 7», abridged` · full text: [sad.md](../sad.md)

> Конституція, п. 6: кожен компонент ділиться на `<name>_core.c` (без жодного заголовка ESP-IDF) і `<name>_hal.c`; логіка живе в core і покривається тестами на хості. Пп. 8–9: збірка без помилок і без нових попереджень; коментарі й коміти — українською, ідентифікатори — англійською.
>
> — `docs/constitution.md, пп. 6, 8, 9, abridged` · full text: [constitution.md](../../../constitution.md)

**Fallback:** insufficient or contradicted by the code → read the named file in full ([spec.md](../spec.md) · [sad.md](../sad.md) · [contracts/](../contracts/) · [adr/](../adr/)) and follow it. Do not guess.

## Data delta

No DB changes.

## API contract

Внутрішнє: рядок журналу події OBSTACLE_HOLD (cli.md «Рядки журналу»): сектор + кожен датчик нижче порога з відстанню; для обох секторів — позначка сектора; несправний датчик не називається.

## Acceptance criteria

### AC-08 — happy path

> **Given** контроль ввімкнений, перед ровером перешкода, яку бачать два з трьох передніх датчиків ближче за поріг
> **When** ровер входить в утримання перед перешкодою
> **Then** консоль один раз називає передній сектор і обидва датчики, що бачать перешкоду, з відстанню кожного, і не називає третій датчик, який перешкоди не бачить
>
> — `spec.md §5, AC-08, verbatim` · full text: [spec.md](../spec.md)

### AC-09 — error handling

> **Given** контроль ввімкнений, один із передніх датчиків у стані відмови, а перешкоду бачить інший
> **When** ровер входить в утримання
> **Then** консоль називає лише справний датчик, що бачить перешкоду, і не називає несправний як такий, що бачить перешкоду
>
> — `spec.md §5, AC-09, verbatim` · full text: [spec.md](../spec.md)

## Checklist

- [ ] `tof_core.h/.c`: `uint8_t tof_below_mask(const tof_view_t *v, tof_sector_t s)` — біти `tof_id_t` датчиків сектора зі станом `TOF_S_OK` і `mm < TOF_OBSTACLE_MM` (170).
- [ ] Розширити `tof_fmt_hold_line` (або додати `tof_fmt_hold_sensors`): перелік усіх датчиків маски з відстанню; для двох зайнятих секторів — обидва переліки з позначкою сектора; зберегти наявні поля (відстань сектора, поріг, різниця часу).
- [ ] Хостові тести `test/host/test_tof.c`: два з трьох передніх нижче порога → обидва в рядку, третій відсутній; один справний + один у відмові → лише справний; задній один; обидва сектори; жоден (порожня маска).

## Edge cases

| Case | Behaviour |
|---|---|
| два передні датчики нижче порога | рядок називає обидва з відстанями, не називає третій |
| датчик у стані відмови | не потрапляє в маску й у рядок |
| зайняті обидва сектори | датчики обох секторів, кожен з позначкою сектора |
| відстань рівно 170 мм | не нижче порога (як і сектор зайнятий лише при `mm < TOF_OBSTACLE_MM`) |

## Definition of Done

- [ ] хостові тести tof проходять; `tof_core.c` без заголовків ESP-IDF
- [ ] `idf.py build` без нових попереджень
- [ ] кожне Hard Rule вище лишається дійсним
