12romis/esp32-elrs-rover/docs/features/phase8-session-report/tasks/t4-ui-green-indicator.md

---
id: T4
title: "Додати в ui зелений індикатор за режимом контролю й охороною з пріоритетом червоний > жовтий > зелений"
layer: "app"
deps: ["T3"]
blocks: []
acs: ["AC-05", "AC-06", "AC-07"]
files_hint: ["components/ui/ui_core.c", "components/ui/include/ui_core.h", "components/ui/ui_hal.c", "test/host/test_ui.c"]
owner: "Агент"
estimate: "M"
context_budget: "S"
status: "done"
step: "COMMIT"
---

# T4 — Додати в ui зелений індикатор за режимом контролю й охороною з пріоритетом червоний > жовтий > зелений

## Place in the sequence

- **Blocked by:** T3 — Додати в drive_core вхід «режим контролю» і подавити зайнятість секторів, коли режим вимкнено, з подіями зміни режиму й охорони · **Blocks:** — · **Wave:** 3.
- **Lane:** own lane.

## Why (user story)

> **As a** Розробник
> **I want** щоб індикатор плати світив зеленуватим, коли контроль ввімкнений і реально охороняє
> **So that** я з одного погляду знаю стан захисту й не покладаюся на нього, коли він вимкнений чи не працює
>
> — `spec.md §4, US-02, verbatim` · full text: [spec.md](../spec.md)

Задача дає частину історії: додати в ui зелений індикатор за режимом контролю й охороною з пріоритетом червоний > жовтий > зелений.

## Inlined context

> A3. **Індикатор плати.** Зеленуватий = зелений канал на перевіреному рівні 40 (порядок байтів із журналу вимірювань P8, байти (40,0,0)), без червоного. Світить у DISARMED і ARMED, коли режим ввімкнений **і** принаймні один сектор реально охороняється (хоч один працюючий далекомір і свіжий знімок). Якщо режим ввімкнений, але жоден далекомір не працює, зелений не світить, щоб не обіцяти захисту, якого немає (консоль уже пише попередження «озброєно без захисту»). Пріоритет кольорів: червоний у FAILSAFE, потім жовтий в OBSTACLE_HOLD, потім зелений; у BOOT, SELFTEST і FAULT індикатор лишається погашеним, як у фазі 7. Працює й тоді, коли розширювач портів недоступний. Консоль пише одне попередження «захист від зіткнень не діє» при кожному переході «охороняє → не охороняє» (зокрема коли знімок далекомірів застарів під час руху) у DISARMED чи ARMED і одне «захист відновлено» при зворотному; в інший час не повторює.
>
> — `spec.md §1, A3, verbatim` · full text: [spec.md](../spec.md)

> **Chosen:** варіант 1. Читання CH9 — `crsf_core`: нова функція «значення вище середини» поруч із `crsf_switch_arm`; стан за замовчуванням (немає кадру або зв'язку) — ввімкнено. Вимкнення в OBSTACLE_HOLD дає ту саму умову виходу, що й звільнення сектора (`!occ_front && !occ_rear`), тож окремого переходу не потрібно. `ui_core` отримує зелений індикатор (`UI_IND_GREEN`) за режимом, охороною (`tof_view_t.protection`) і станом: пріоритет червоний > жовтий > зелений.
>
> — `adr/0005-gate-tof-occupancy-in-drive-core-by-the-ch9-switch-with-default-on.md, Decision outcome, verbatim` · full text: [adr/](../adr/)

> | Стан і умова | Колір |
> | FAILSAFE | червоний |
> | OBSTACLE_HOLD | жовтий |
> | DISARMED або ARMED, контроль ввімкнено, хоч один сектор охороняється | зелений (зелений канал, рівень 40, порядок байтів GRB із P8) |
> | DISARMED або ARMED, контроль вимкнено | погашений |
> | DISARMED або ARMED, контроль ввімкнено, жоден далекомір не працює | погашений (+ рядок журналу «захист не діє») |
> | BOOT, SELFTEST, FAULT | погашений |
>
> — `contracts/cli.md, «Індикатор плати», abridged` · full text: [cli.md](../contracts/cli.md)

> Конституція, п. 6: кожен компонент ділиться на `<name>_core.c` (без жодного заголовка ESP-IDF) і `<name>_hal.c`; логіка живе в core і покривається тестами на хості. Пп. 8–9: збірка без помилок і без нових попереджень; коментарі й коміти — українською, ідентифікатори — англійською.
>
> — `docs/constitution.md, пп. 6, 8, 9, abridged` · full text: [constitution.md](../../../constitution.md)

**Fallback:** insufficient or contradicted by the code → read the named file in full ([spec.md](../spec.md) · [sad.md](../sad.md) · [contracts/](../contracts/) · [adr/](../adr/)) and follow it. Do not guess.

## Data delta

No DB changes.

## API contract

Зовнішній інтерфейс — колір індикатора (див. «Inlined context»).

## Acceptance criteria

### AC-05 — happy path

> **Given** контроль ввімкнений, ровер у DISARMED або ARMED і хоча б один сектор охороняється
> **When** Розробник дивиться на індикатор плати
> **Then** індикатор світить зеленуватим, а після вимкнення контролю тумблером гасне
>
> — `spec.md §5, AC-05, verbatim` · full text: [spec.md](../spec.md)

### AC-06 — domain invariant violation

> **Given** контроль ввімкнений, але ровер у FAILSAFE або в утриманні перед перешкодою
> **When** Розробник дивиться на індикатор плати
> **Then** у FAILSAFE він червоний, в утриманні жовтий, зелений не показується: аварійні та попереджувальні кольори мають пріоритет
>
> — `spec.md §5, AC-06, verbatim` · full text: [spec.md](../spec.md)

### AC-07 — cross-context

> **Given** контроль ввімкнений, але жоден далекомір не працює (усі в стані відмови або знімок застарів)
> **When** Розробник дивиться на індикатор плати
> **Then** зелений не світить, і консоль каже, що захист від зіткнень не діє, щоб індикатор не обіцяв захисту, якого немає
>
> — `spec.md §5, AC-07, verbatim` · full text: [spec.md](../spec.md)

## Checklist

- [ ] `ui_core.h`: `UI_IND_GREEN` у `ui_indicator_t`; у вході `ui_core` — `tof_control_on`, `tof_guarding` (з `drive_ctl_out_t`/статусу drive, T3).
- [ ] `ui_core.c`: пріоритет червоний (FAILSAFE) > жовтий (OBSTACLE_HOLD) > зелений (DISARMED/ARMED, режим і охорона) > погашений.
- [ ] `ui_hal.c` (`indicator_set`): зелений = канал G на рівні `UI_INDICATOR_LEVEL` (40), порядок байтів GRB, без червоного (байти (40,0,0)); колір застосовується не пізніше наступного кроку `ui` (100 мс).
- [ ] Хостові тести `test/host/test_ui.c`: усі рядки таблиці; зміна режиму → колір на наступному кроці.

## Edge cases

| Case | Behaviour |
|---|---|
| FAILSAFE при ввімкненому режимі | червоний, не зелений |
| OBSTACLE_HOLD | жовтий |
| режим ввімкнений, але охорони немає | погашений, не зелений |
| BOOT, SELFTEST, FAULT | погашений |
| розширювач портів недоступний | індикатор працює, бо керується не через нього |

## Definition of Done

- [ ] хостові тести ui проходять; `ui_core.c` без заголовків ESP-IDF
- [ ] `idf.py build` без нових попереджень
- [ ] кожне Hard Rule вище лишається дійсним
