12romis/esp32-elrs-rover/docs/features/phase8-session-report/tasks/t9-report-queue-core.md

---
id: T9
title: "Створити report_queue_core: кільце з двох слотів, порядок передачі, вихід зі спроби при першій невдачі й правила дозволу передачі за станом"
layer: "domain"
deps: ["T7"]
blocks: ["T11", "T13"]
acs: ["AC-15", "AC-16", "AC-17"]
files_hint: ["components/report/report_queue_core.c", "components/report/include/report_queue_core.h", "test/host/test_report_queue.c"]
owner: "Агент"
estimate: "M"
context_budget: "S"
status: "done"
step: "COMMIT"
---

# T9 — Створити report_queue_core: кільце з двох слотів, порядок передачі, вихід зі спроби при першій невдачі й правила дозволу передачі за станом

## Place in the sequence

- **Blocked by:** T7 — Створити report_core: документ звіту сесії у форматі events.md з явними null і межею 1024 байти · **Blocks:** T11 — Створити report_store_hal і налаштування мережі: NVS-кільце звітів одним записом, версія й git образу, локальний файл секретів, сертифікат, зміни сборки, T13 — Створити report_hal: задачу report на core 0 з спробою передачі при вході в DISARMED, скасуванням озброєнням і записом результатів · **Wave:** 5.
- **Lane:** shares `components/report/report_queue_core.c` with T0 — serialized.

## Why (user story)

> **As a** Розробник
> **I want** щоб невідправлені звіти зберігались і йшли пізніше
> **So that** відсутність мережі чи збій сервера не стирають дані виїзду
>
> — `spec.md §4, US-05, verbatim` · full text: [spec.md](../spec.md)

Задача дає частину історії: створити report_queue_core: кільце з двох слотів, порядок передачі, вихід зі спроби при першій невдачі й правила дозволу передачі за станом.

## Inlined context

> A13. **Wi-Fi і MQTT лише в DISARMED.** Радіо вмикається тільки при вході в DISARMED, якщо є хоча б один невідправлений звіт; у BOOT, SELFTEST, ARMED, OBSTACLE_HOLD, FAILSAFE і FAULT радіо вимкнене. Вхід у DISARMED включає перший вхід після старту плати (SELFTEST → DISARMED), тоді відправляються звіти, збережені до перезапуску. Спроба передає звіти по черзі від найстаршого: якщо поточний не доставлено (немає підтвердження, відмова сервера, недовірений сертифікат), спроба зупиняється, Wi-Fi вимикається, решта лишається в черзі в тому ж порядку. Повторних спроб у межах того ж DISARMED немає (щоб не тримати радіо ввімкненим): наступна спроба — при наступному вході в DISARMED або за командою консолі (A16).
>
> — `spec.md §1, A13, verbatim` · full text: [spec.md](../spec.md)

> A16. **Консоль.** Нова команда показує стан звітів (скільки невідправлено, які сесії, результат останньої спроби, режим контролю) і в DISARMED запускає спробу передачі негайно зі своїми 30 с від моменту команди; якщо спроба вже йде, команда відхиляється з поясненням «передача вже триває»; якщо черга порожня — повідомляє «нічого надсилати» і Wi-Fi не вмикає; в інших станах відхиляється з поясненням. Команда потрібна для приймання на залізі без виїзду; пароль вона ніколи не показує (A19).
>
> — `spec.md §1, A16, verbatim` · full text: [spec.md](../spec.md)

> A17. **Черга звітів.** Невідправлені звіти зберігаються у памʼяті плати (переживають перезапуск і вимкнення живлення), не більше двох; при появі третього найстаріший видаляється з рядком у журналі, який номер видалено. Це не лише кращий буфер: FAILSAFE через напругу виходить лише перезапуском плати, тож у ОЗП такий звіт втратився б. Звіти надсилаються в порядку створення. Успішно надісланий звіт видаляється з памʼяті. Записів у памʼять на сесію не більше двох: створення (у момент завершення сесії) і видалення після підтвердження доставки; плюс оновлення постійного лічильника номерів сесій разом зі створенням (не окремий запис). Усі записи — поза тактом керування. Дублікат, якщо позначка «надіслано» не встигла записатись, відсікається номером сесії на сервері.
>
> — `spec.md §1, A17, verbatim` · full text: [spec.md](../spec.md)

> **Chosen:** варіант 1. Одна операція запису — один `nvs_commit`, у який входять і блоб звіту, і метадані (номер сесії, голова, лічильник); створення й видалення — по одному коміту, разом ≤ 2 на сесію; при завантаженні невалідні слоти ігноруються, а номер відновлюється як максимальний із слотів плюс 1. Третій звіт витісняє найстарший з рядком у журналі. Запис ініціює задача `report` у DISARMED чи FAILSAFE (двигуни вже вимкнені); керування не чекає на запис, але озброєння, що збіглося із записом, затримується на його тривалість (мілісекунди) — як і при `pid save`.
>
> — `adr/0004-persist-unsent-reports-in-nvs-as-a-two-slot-ring-written-by-the-report-task.md, Decision outcome, verbatim` · full text: [adr/](../adr/)

> Flow 4: новий підсумок → якщо в черзі вже два звіти, видалити найстарший і записати новий одним записом (рядок журналу: який номер сесії видалено); спроба передає по черзі від найстаршого; немає підтвердження → зупинити спробу, решта лишається в порядку; доставлені слоти видаляються після вимкнення Wi-Fi; повторних спроб у межах одного DISARMED немає.
>
> — `sad.md §6, «Flow 4», abridged` · full text: [sad.md](../sad.md)

> Конституція, п. 6: кожен компонент ділиться на `<name>_core.c` (без жодного заголовка ESP-IDF) і `<name>_hal.c`; логіка живе в core і покривається тестами на хості. Пп. 8–9: збірка без помилок і без нових попереджень; коментарі й коміти — українською, ідентифікатори — англійською.
>
> — `docs/constitution.md, пп. 6, 8, 9, abridged` · full text: [constitution.md](../../../constitution.md)

> Конституція, п. 7: STBY піднімається тільки в ARMED; втрата кадрів CRSF довша за 500 мс → ШІМ у нуль, STBY вниз; перша операція по I²C після старту — запис 0x00 у PCF8574; VBAT < 6.0 В → мотори не запускаються. Інваріанти сильніші за будь-яку функціональність.
>
> — `docs/constitution.md, п. 7, abridged` · full text: [constitution.md](../../../constitution.md)

**Fallback:** insufficient or contradicted by the code → read the named file in full ([spec.md](../spec.md) · [sad.md](../sad.md) · [contracts/](../contracts/) · [adr/](../adr/)) and follow it. Do not guess.

## Data delta

No DB changes.

## API contract

Внутрішнє: політика черги й дозволу передачі; консольні рядки — T14 (cli.md, «Права за станом»).

## Acceptance criteria

### AC-15 — domain invariant violation

> **Given** у черзі вже два невідправлені звіти, а мережі немає
> **When** завершується третя сесія
> **Then** найстарший звіт видаляється з поясненням у журналі, у черзі лишаються два новіші: невідправлених звітів ніколи не більше двох
>
> — `spec.md §5, AC-15, verbatim` · full text: [spec.md](../spec.md)

### AC-16 — happy path

> **Given** у черзі два невідправлені звіти і мережа знову доступна
> **When** ровер входить у DISARMED
> **Then** обидва звіти надсилаються в порядку створення, кожен видаляється з черги після підтвердження, а Wi-Fi вимикається після останнього
>
> — `spec.md §5, AC-16, verbatim` · full text: [spec.md](../spec.md)

### AC-17 — authorization

> **Given** ровер озброєний, в утриманні перед перешкодою або у FAILSAFE
> **When** Розробник вводить команду показу й негайної передачі звітів
> **Then** команда показує стан черги, але передачу не запускає й пояснює, що передача можлива лише в DISARMED
>
> — `spec.md §5, AC-17, verbatim` · full text: [spec.md](../spec.md)

## Checklist

- [ ] `report_queue_core.h/.c`: `report_q_t` (до 2 слотів із `seq`), `report_q_push` (при повній черзі повертає номер витісненого), `report_q_next`, `report_q_mark_sent`, `report_q_count`; `report_attempt_plan_t` для порядку спроби; `report_allow_send(app_state_t)` — істина лише для DISARMED; `report_attempt_outcome_t` (доставлено, немає мережі, сертифікат, немає підтвердження, перервано, немає налаштувань).
- [ ] Хостові тести `test/host/test_report_queue.c`: третій витісняє найстарший, порядок A→B, невдача першого зупиняє спробу й лишає порядок, дозвіл за кожним із семи станів, порожня черга → «нічого надсилати».

## Edge cases

| Case | Behaviour |
|---|---|
| у черзі два звіти, приходить третій | найстарший видалено, номер названо, залишаються два новіші |
| перший звіт не підтверджено | спроба зупиняється, другий не надсилається |
| стан не DISARMED | передача не дозволена; стан черги показується |
| черга порожня | Wi-Fi не вмикається, «нічого надсилати» |

## Definition of Done

- [ ] хостові тести queue проходять; `report_queue_core.c` без заголовків ESP-IDF
- [ ] `idf.py build` без нових попереджень
- [ ] кожне Hard Rule вище лишається дійсним
