12romis/esp32-elrs-rover/docs/features/phase8-session-report/adr/0001-accumulate-session-statistics-in-the-control-task-and-hand-off-a-summary-through-a-bounded-queue.md

---
status: Accepted
owner: "Розробник проєкту"
reviewers: ["Розробник проєкту"]
updated_at: "2026-10-22"
feature_size: "M"
ticket: "phase8-session-report"
---

# 0001 — Accumulate session statistics in the control task and hand off a summary through a bounded queue

- **Status:** Accepted
- **Date:** 2026-10-22
- **Deciders:** Розробник, Агент (design, рівень easy)

## Context

Звіт сесії (spec A5–A10) потребує даних, які щойно доступні задачі `control` (20 мс): стан автомата, потужність бортів, швидкості й лічильники коліс, події утримання, знімок далекомірів, напруга. Опитувати ті самі джерела окремою задачею означало б дублювати доступ до знімків і ловити стани «по краях» з похибкою. Конституція вимагає, щоб логіка жила в `*_core.c` і покривалась хостовими тестами (п. 6), а крок керування не отримував нових блокувань (п. 14, spec NFR).

## Decision drivers

- Нуль нових кроків керування довших за 20 мс під час передачі (spec §6).
- Вся статистика — чиста функція від входів кроку: тестується на хості (spec §6, п. 6).
- Мережева задача не читає мотор-стан і не тримає спільних мʼютексів з керуванням.

## Considered options

1. **Накопичувач у `control`, передача копії підсумку через чергу довжиною 2** — `session_core` викликається в кінці кроку керування з вже зібраних входів; наприкінці сесії копія `session_summary_t` кладеться в чергу без очікування.
2. **Окрема задача `session` опитує знімки кожні 20 мс** — не торкається `control`, але дублює читання знімків і може пропустити коротке утримання.
3. **Хук у `app_state` + підписка** — автомат не має колбеків; потрібна зміна компонента, яким користуються всі фази.

## Decision outcome

**Chosen:** варіант 1. Статистика рахується там, де дані вже є, без нових блокувань; приймач у черзі (задача `report`) отримує готову копію. Якщо черга повна (переповнення за ≤ 2 сесії), нова копія затирає найстарішу в черзі, як і правило з двох звітів.

## Consequences

**Positive**
- Жодних нових мʼютексів на гарячому шляху; витрати на крок — кілька арифметичних операцій.
- Точні межі сесії: вхід і вихід бачить той самий код, що виконує перехід.
- Весь `session_core` тестується на хості без заголовків ESP-IDF.

**Negative**
- Додатковий виклик у кроці керування; потрібно стежити за бюджетом часу (вимірюється існуючою статистикою кроку).
- `drive_hal` знає про компонент `session` (нова залежність).

**Neutral**
- Перехід на окрему задачу пізніше можливий: інтерфейс `session_core` не залежить від того, хто його викликає.

## Links

- Spec: [[../spec.md]] A5–A10
- SAD: [[../sad.md]] §4, §5
- Related ADR: [[0004-persist-unsent-reports-in-nvs-as-a-two-slot-ring-written-by-the-report-task]]
