12romis/esp32-elrs-rover/docs/features/phase8-session-report/adr/0004-persist-unsent-reports-in-nvs-as-a-two-slot-ring-written-by-the-report-task.md

---
status: Accepted
owner: "Розробник проєкту"
reviewers: ["Розробник проєкту"]
updated_at: "2026-10-22"
feature_size: "M"
ticket: "phase8-session-report"
---

# 0004 — Persist unsent reports in NVS as a two-slot ring written by the report task

- **Status:** Accepted
- **Date:** 2026-10-22
- **Deciders:** Розробник, Агент (design, рівень easy)

## Context

Spec A17–A18: невідправлені звіти (≤ 2) переживають перезапуск; FAILSAFE через напругу виходить лише перезапуском, тож звіт мусить бути збережений у момент завершення сесії. NVS-розділ уже є (0x6000 = 24 КБ, `storage_init`), PID займає там 28 байтів; запис флешу короткочасно зупиняє виконання коду з флешу на обох ядрах (як при `pid save`).

## Decision drivers

- Звіти не втрачаються при перезапуску й відсутності мережі (spec KPI «втрачені сесії»).
- Не більше 2 записів у памʼять на сесію (створення, видалення після доставки), поза тактом керування (spec §6).
- Розмір звіту ≤ 1024 байти (spec §6); два слоти + лічильник — близько 2.1 КБ з 24 КБ.

## Considered options

1. **Кільце з двох слотів у просторі імен `report` (два блоби + малий блоб метаданих: наступний номер сесії, голова, лічильник), запис робить задача `report`**, а `control` лише кладе підсумок у чергу (ADR-0001).
2. **Окремий розділ флешу під журнал** — не залежить від NVS, але потребує нової таблиці розділів і власного коду зносостійкості.
3. **Одна черга в одному блобі (обидва звіти разом, перезапис цілком)** — один ключ і простіше відновлення, але кожна зміна переписує до 2 КБ і торкається обох звітів.

## Decision outcome

**Chosen:** варіант 1. Одна операція запису — один `nvs_commit`, у який входять і блоб звіту, і метадані (номер сесії, голова, лічильник); створення й видалення — по одному коміту, разом ≤ 2 на сесію; при завантаженні невалідні слоти ігноруються, а номер відновлюється як максимальний із слотів плюс 1. Третій звіт витісняє найстарший з рядком у журналі. Запис ініціює задача `report` у DISARMED чи FAILSAFE (двигуни вже вимкнені); керування не чекає на запис, але озброєння, що збіглося із записом, затримується на його тривалість (мілісекунди) — як і при `pid save`.

## Consequences

**Positive**
- Існуюча інфраструктура NVS і її тести; зносостійкість NVS безкоштовна.
- Звіт FAILSAFE через напругу доживає до першого DISARMED після перезапуску.

**Negative**
- Два записи флешу на сесію; кожен коротко зупиняє виконання коду з флешу.
- Метадані й блоби не атомарні: відновлення при завантаженні мусить бути обережним.

**Neutral**
- Зміна кількості слотів — константа, формат блоба версіонований (як `PID_RECORD_VERSION`).

## Links

- Spec: [[../spec.md]] A17, A18, §6
- SAD: [[../sad.md]] §5, §8, §11
- Related ADR: [[0001-accumulate-session-statistics-in-the-control-task-and-hand-off-a-summary-through-a-bounded-queue]]
