12romis/esp32-elrs-rover/docs/features/phase8-session-report/adr/0005-gate-tof-occupancy-in-drive-core-by-the-ch9-switch-with-default-on.md

---
status: Accepted
owner: "Розробник проєкту"
reviewers: ["Розробник проєкту"]
updated_at: "2026-10-22"
feature_size: "M"
ticket: "phase8-session-report"
---

# 0005 — Gate ToF occupancy in drive core by the CH9 switch with default on

- **Status:** Accepted
- **Date:** 2026-10-22
- **Deciders:** Розробник, Агент (design, рівень easy)

## Context

Фаза 6 (ADR-0001/0004 phase6-tof) робить сектори зайнятими в `drive_core` з знімка далекомірів (`occ_front`, `occ_rear`) і від них залежать обмеження тяги та перехід у OBSTACLE_HOLD. Spec A1–A3: режим контролю перемикається каналом CH9 (індекс 8), за замовчуванням ввімкнений, індикатор плати показує його зеленим; інваріанти безпеки не змінюються.

## Decision drivers

- Вимкнення захисту не послаблює жодного інваріанта конституції (п. 7; spec AC-03).
- Решітка рішень про рух живе в `drive_core` і покрита хостовими тестами (п. 6).
- Індикатор і консоль лише відображають стан режиму; керування ним не мають.

## Considered options

1. **Вхід `tof_control_on` у `drive_ctl_in_t` (з каналу CH9 у кроці керування), `occ_*` обчислюються як `tof_ok && tof_control_on && occupied`; режим публікується в статусі drive для `ui` і консолі.**
2. **Вимикач усередині `tof_core`** — далекоміри перестають повідомляти про зайнятість; але тоді втрачається діагностика (`tof` показує «поза діапазоном» замість реальних відстаней) і змінюється поведінка іншої фази.
3. **Обробляти CH9 в `ui`/окремому компоненті і підміняти знімок далекомірів** — розмазує рішення між компонентами.

## Decision outcome

**Chosen:** варіант 1. Читання CH9 — `crsf_core`: нова функція «значення вище середини» поруч із `crsf_switch_arm`; стан за замовчуванням (немає кадру або зв'язку) — ввімкнено. Вимкнення в OBSTACLE_HOLD дає ту саму умову виходу, що й звільнення сектора (`!occ_front && !occ_rear`), тож окремого переходу не потрібно. `ui_core` отримує зелений індикатор (`UI_IND_GREEN`) за режимом, охороною (`tof_view_t.protection`) і станом: пріоритет червоний > жовтий > зелений.

## Consequences

**Positive**
- Одна точка рішення; діагностика далекомірів і журнал відмов не змінюються.
- Поведінка при вимкненому режимі повністю покривається хостовими тестами `drive_core`.

**Negative**
- Змінює припущення фази 6 «захист завжди»: тести фази 6 і її ADR-0004 про перехід у OBSTACLE_HOLD доповнюються умовою режиму.
- Помилково призначений канал CH9 на TX12 (значення 992) вимкне захист (спек §8 OQ-6).

**Neutral**
- Додавання консольної команди зміни режиму пізніше не змінює архітектуру (spec §3 її виключає).

## Links

- Spec: [[../spec.md]] A1–A3, AC-01…AC-07
- SAD: [[../sad.md]] §4, §5, §11
- Related ADR: phase6-tof ADR-0001, ADR-0004
