12romis/esp32-elrs-rover/docs/features/phase8-session-report/tasks/t1-crsf-ch9-tof-control.md

---
id: T1
title: "Додати в crsf_core канал CH9 і функцію «контроль перешкод увімкнено» зі значенням за замовчуванням"
layer: "domain"
deps: []
blocks: ["T3"]
acs: ["AC-01", "AC-04"]
files_hint: ["components/crsf/crsf_core.c", "components/crsf/include/crsf_core.h", "test/host/test_crsf.c"]
owner: "Агент"
estimate: "S"
context_budget: "S"
status: "todo"
step: ""
---

# T1 — Додати в crsf_core канал CH9 і функцію «контроль перешкод увімкнено» зі значенням за замовчуванням

## Place in the sequence

- **Blocked by:** — · **Blocks:** T3 — Додати в drive_core вхід «режим контролю» і подавити зайнятість секторів, коли режим вимкнено, з подіями зміни режиму й охорони · **Wave:** 1.
- **Lane:** own lane.

## Why (user story)

> **As a** Розробник
> **I want** вмикати й вимикати контроль і автозупинку по далекомірах окремим тумблером пульта
> **So that** я можу підʼїхати впритул чи виїхати з тісного місця, не роззброюючи ровер
>
> — `spec.md §4, US-01, verbatim` · full text: [spec.md](../spec.md)

Задача дає частину історії: додати в crsf_core канал CH9 і функцію «контроль перешкод увімкнено» зі значенням за замовчуванням.

## Inlined context

> A1. **Режим контролю перешкод.** Ввімкнений, коли значення каналу CH9 вище середини діапазону (як у тумблера озброєння: більше 992 — «увімкнено»). За замовчуванням ввімкнений: від старту плати, у стендовому режимі, поки пульт не передав жодного кадру, і після втрати зв'язку, доки не прийде новий кадр (небезпечніше помилково вимкнений захист, ніж помилково ввімкнений). Розробник підтвердив, що виведе перемикач на CH9 і запише два положення в журнал вимірювань (OQ-6). Положення CH9 на TX12 ще не виміряні (у журналі CH9 = 992 у спокої, перемикача не призначено): «вище середини» — пропозиція, яку Розробник підтверджує заміром двох положень у `docs/measured.md` до `design` (п. 13; OQ-6); до заміру прошивка без призначеного перемикача бачить 992 як «вимкнено». Змінювати режим можна в будь-якому стані; консоль режим не змінює, а лише показує його в `status`.
>
> — `spec.md §1, A1, verbatim` · full text: [spec.md](../spec.md)

> **Chosen:** варіант 1. Читання CH9 — `crsf_core`: нова функція «значення вище середини» поруч із `crsf_switch_arm`; стан за замовчуванням (немає кадру або зв'язку) — ввімкнено. Вимкнення в OBSTACLE_HOLD дає ту саму умову виходу, що й звільнення сектора (`!occ_front && !occ_rear`), тож окремого переходу не потрібно. `ui_core` отримує зелений індикатор (`UI_IND_GREEN`) за режимом, охороною (`tof_view_t.protection`) і станом: пріоритет червоний > жовтий > зелений.
>
> — `adr/0005-gate-tof-occupancy-in-drive-core-by-the-ch9-switch-with-default-on.md, Decision outcome, verbatim` · full text: [adr/](../adr/)

> Канал: CH9 (індекс 8) у кадрі CRSF. Інтерпретація: значення вище середини (> 992, як у тумблера озброєння) — «контроль увімкнено», інакше «вимкнено». За замовчуванням «увімкнено»: від старту плати, у стендовому режимі, при втраті зв'язку, доки не прийде новий кадр.
>
> — `contracts/cli.md, «Канал пульта CH9», abridged` · full text: [cli.md](../contracts/cli.md)

> Конституція, п. 6: кожен компонент ділиться на `<name>_core.c` (без жодного заголовка ESP-IDF) і `<name>_hal.c`; логіка живе в core і покривається тестами на хості. Пп. 8–9: збірка без помилок і без нових попереджень; коментарі й коміти — українською, ідентифікатори — англійською.
>
> — `docs/constitution.md, пп. 6, 8, 9, abridged` · full text: [constitution.md](../../../constitution.md)

**Fallback:** insufficient or contradicted by the code → read the named file in full ([spec.md](../spec.md) · [sad.md](../sad.md) · [contracts/](../contracts/) · [adr/](../adr/)) and follow it. Do not guess.

## Data delta

No DB changes.

## API contract

Зовнішній інтерфейс — канал CH9 пульта (див. «Inlined context»); консольних змін немає.

## Acceptance criteria

### AC-01 — happy path

> **Given** ровер озброєний, зв'язок з пультом живий, контроль перешкод ввімкнений, а перед ровером у переднього сектора перешкода ближча за поріг
> **When** Розробник переводить тумблер контролю в положення «вимкнено»
> **Then** ровер перестає вважати сектор зайнятим, рух уперед знову дозволений, консоль пише один рядок про вимкнення контролю, а інваріанти безпеки діють без змін
>
> — `spec.md §5, AC-01, verbatim` · full text: [spec.md](../spec.md)

### AC-04 — error handling

> **Given** плата щойно стартувала й пульт не передав жодного кадру, або зв'язок з пультом втрачено
> **When** Розробник дивиться на стан ровера командою `status`
> **Then** контроль перешкод показаний як ввімкнений зі згадкою, що це значення за замовчуванням, поки пульт не підтвердить інше
>
> — `spec.md §5, AC-04, verbatim` · full text: [spec.md](../spec.md)

## Checklist

- [ ] `components/crsf/include/crsf_core.h`: `#define CRSF_IDX_TOF_CONTROL 8` поруч з `CRSF_IDX_ARM`.
- [ ] `crsf_core.c`: `bool crsf_tof_control_on(uint16_t raw)` — істина, коли `raw > CRSF_RAW_CENTER`; `bool crsf_tof_control_effective(const crsf_snapshot_t *s, bool link_alive)` — істина, якщо кадру ще не було, зв'язок не живий, або канал вище середини.
- [ ] Хостові тести в `test/host/test_crsf.c`: 992 → вимкнено, 993 → увімкнено, 172 → вимкнено, 1811 → увімкнено, немає кадру → увімкнено, зв'язок втрачено → увімкнено.

## Edge cases

| Case | Behaviour |
|---|---|
| значення рівно 992 (CH9 без призначеного тумблера) | «вимкнено»; прошивка не вгадує призначення, див. OQ-6 і sad.md §11 |
| немає жодного кадру або зв'язок не живий | «увімкнено» (безпечніше помилково ввімкнений захист) |
| канал виходить за межі 172…1811 | клампується, як решта каналів у `crsf_snapshot_t` |

## Definition of Done

- [ ] хостові тести CRSF проходять, у `crsf_core.c` немає заголовків ESP-IDF
- [ ] `idf.py build` без нових попереджень
- [ ] кожне Hard Rule вище лишається дійсним
