12romis/esp32-elrs-rover/docs/features/phase8-session-report/tasks/t13-report-task.md

---
id: T13
title: "Створити report_hal: задачу report на core 0 з спробою передачі при вході в DISARMED, скасуванням озброєнням і записом результатів"
layer: "app"
deps: ["T9", "T10", "T12"]
blocks: ["T14"]
acs: ["AC-10", "AC-14", "AC-18"]
files_hint: ["components/report/report_hal.c", "components/report/include/report_hal.h"]
owner: "Агент"
estimate: "M"
context_budget: "M"
status: "todo"
step: ""
---

# T13 — Створити report_hal: задачу report на core 0 з спробою передачі при вході в DISARMED, скасуванням озброєнням і записом результатів

## Place in the sequence

- **Blocked by:** T9 — Створити report_queue_core: кільце з двох слотів, порядок передачі, вихід зі спроби при першій невдачі й правила дозволу передачі за станом, T10 — Підʼєднати session до drive_hal: виклик session_step наприкінці кроку керування, подачу підсумку в чергу й логування подій режиму, T12 — Створити report_net_hal: підключення Wi-Fi, TLS із закріпленим сертифікатом і обмін MQTT з таймаутом 100 мс на крок · **Blocks:** T14 — Додати в консоль команду report та поля status про режим контролю й звіти, з підключенням у main · **Wave:** 8.
- **Lane:** shares `components/report/report_hal.c` with T0 — serialized.

## Why (user story)

> **As a** Розробник
> **I want** щоб після роззброєння ровер сам надсилав на сервер підсумок сесії
> **So that** я бачу історію виїздів і стан акумулятора без підключення USB
>
> — `spec.md §4, US-04, verbatim` · full text: [spec.md](../spec.md)

> **As a** Розробник
> **I want** щоб невідправлені звіти зберігались і йшли пізніше
> **So that** відсутність мережі чи збій сервера не стирають дані виїзду
>
> — `spec.md §4, US-05, verbatim` · full text: [spec.md](../spec.md)

> **As a** Розробник
> **I want** щоб Wi-Fi працював лише в DISARMED, не заважав озброєнню і вимикався одразу після передачі
> **So that** радіо ніколи не впливає на безпеку й живлення під час руху
>
> — `spec.md §4, US-06, verbatim` · full text: [spec.md](../spec.md)

Задача дає частину історії: створити report_hal: задачу report на core 0 з спробою передачі при вході в DISARMED, скасуванням озброєнням і записом результатів.

## Inlined context

> A13. **Wi-Fi і MQTT лише в DISARMED.** Радіо вмикається тільки при вході в DISARMED, якщо є хоча б один невідправлений звіт; у BOOT, SELFTEST, ARMED, OBSTACLE_HOLD, FAILSAFE і FAULT радіо вимкнене. Вхід у DISARMED включає перший вхід після старту плати (SELFTEST → DISARMED), тоді відправляються звіти, збережені до перезапуску. Спроба передає звіти по черзі від найстаршого: якщо поточний не доставлено (немає підтвердження, відмова сервера, недовірений сертифікат), спроба зупиняється, Wi-Fi вимикається, решта лишається в черзі в тому ж порядку. Повторних спроб у межах того ж DISARMED немає (щоб не тримати радіо ввімкненим): наступна спроба — при наступному вході в DISARMED або за командою консолі (A16).
>
> — `spec.md §1, A13, verbatim` · full text: [spec.md](../spec.md)

> A14. **Озброєння має пріоритет над передачею.** Якщо під час спроби прийшов запит на озброєння, спробу негайно перериває: з'єднання закривається, Wi-Fi вимикається, звіт лишається невідправленим, озброєння відбувається у звичайний спосіб і темпі. Передача виконується в окремій низькопріоритетній задачі на core 0 разом із Wi-Fi-стеком (документ 02 §6.1), керування лишається на core 1; жоден такт керування, зумер, світло і консоль не чекають на мережу. Ця специфікація свідомо доповнює фазу 6 (ADR-0004 phase6-tof про «захист завжди увімкнений») і фазу 7 (індикатор): відповідні рішення оформить `design`.
>
> — `spec.md §1, A14, verbatim` · full text: [spec.md](../spec.md)

> A15. **Передача.** Успіх — коли сервер підтвердив прийом повідомлення; відсутність підтвердження — невдача. Одна спроба обмежена в часі: від входу в DISARMED до вимкнення Wi-Fi не більше 30 с (пропозиція агента; реального часу підключення ще не виміряно). Після спроби, успішної чи ні, Wi-Fi вимикається одразу. Сервер (сертифікат власний, підписаний власником; кореневий сертифікат кладеться в проєкт) — адреса, порт і ім'я користувача з запиту Розробника (захищене з'єднання, порт 8883), перевірка сертифіката сервера за цим кореневим сертифікатом обовʼязкова; без перевірки дані не надсилаються. Адреса й порт не є секретом, але лежать у тому самому локальному файлі налаштувань, що й секрети.
>
> — `spec.md §1, A15, verbatim` · full text: [spec.md](../spec.md)

> **Chosen:** варіант 1. `esp_netif` і цикл подій створюються один раз при старті задачі (лічені кілобайти), а самі буфери Wi-Fi створюються й повністю звільняються на спробу; повернення памʼяті перевіряється `status`. Ліміти (пропозиція агента, spec A21): підключення Wi-Fi ≤ 15 с, TLS+MQTT ≤ 10 с, усього ≤ 30 с. Задача запускається подією «вхід у DISARMED» (опитування стану раз на 100 мс) і командою консолі. Видалення відправленого звіту з NVS виконується після вимкнення Wi-Fi.
>
> — `adr/0003-bring-wi-fi-up-and-down-per-delivery-attempt-in-a-dedicated-core-0-task-that-yields-to-arming.md, Decision outcome, verbatim` · full text: [adr/](../adr/)

> | Вплив на керування | 0 нових кроків керування довших за період 20 мс під час спроби; озброєння не затримується; виняток — моменти запису в памʼять плати (≤ 2 на сесію), коли крок і озброєння можуть затриматись на тривалість запису (як `pid save`) | `status` (час кроку) до і після спроби |
>
> — `spec.md §6, «Вплив на керування», verbatim` · full text: [spec.md](../spec.md)

> Конституція, п. 7: STBY піднімається тільки в ARMED; втрата кадрів CRSF довша за 500 мс → ШІМ у нуль, STBY вниз; перша операція по I²C після старту — запис 0x00 у PCF8574; VBAT < 6.0 В → мотори не запускаються. Інваріанти сильніші за будь-яку функціональність.
>
> — `docs/constitution.md, п. 7, abridged` · full text: [constitution.md](../../../constitution.md)

> Конституція, п. 14: усі періодичні задачі використовують vTaskDelayUntil, а не vTaskDelay; шина I²C працює на 100 кГц.
>
> — `docs/constitution.md, п. 14, abridged` · full text: [constitution.md](../../../constitution.md)

> Flow 2: ARM під час спроби → control озброюється у звичайному темпі, не чекаючи на мережу; report перевіряє стан щонайменше раз на 100 мс; стан не DISARMED → перервати спробу, закрити зʼєднання, вимкнути Wi-Fi; звіт лишається в черзі, нічого не видалено; рядок в консолі: спробу перервано озброєнням.
>
> — `sad.md §6, «Flow 2», abridged` · full text: [sad.md](../sad.md)

**Fallback:** insufficient or contradicted by the code → read the named file in full ([spec.md](../spec.md) · [sad.md](../sad.md) · [contracts/](../contracts/) · [adr/](../adr/)) and follow it. Do not guess.

## Data delta

No DB changes.

## API contract

Внутрішнє: результати спроби в журнал і для консолі (cli.md «Рядки журналу»).

## Acceptance criteria

### AC-10 — happy path

> **Given** Wi-Fi і сервер доступні, ровер озброївся з напругою на старті сесії, проїхав і роззброївся
> **When** ровер входить у DISARMED
> **Then** він вмикає Wi-Fi, надсилає один звіт цієї сесії, чекає підтвердження сервера, одразу вимикає Wi-Fi і пише в консоль, що звіт доставлено
>
> — `spec.md §5, AC-10, verbatim` · full text: [spec.md](../spec.md)

### AC-14 — error handling

> **Given** Wi-Fi недоступний, сервер не відповідає або відхиляє дані
> **When** ровер входить у DISARMED зі звітом у черзі
> **Then** спроба завершується вимкненням Wi-Fi до кінця ліміту часу, звіт лишається в черзі, консоль називає причину невдачі, а ровер працює й озброюється як звичайно
>
> — `spec.md §5, AC-14, verbatim` · full text: [spec.md](../spec.md)

### AC-18 — domain invariant violation

> **Given** триває спроба передачі звіту в DISARMED
> **When** Розробник озброює ровер
> **Then** передачу негайно перервано, Wi-Fi вимкнено, звіт лишився в черзі, озброєння відбулось у звичайний спосіб і в звичайний час, не чекаючи закриття з'єднання
>
> — `spec.md §5, AC-18, verbatim` · full text: [spec.md](../spec.md)

## Checklist

- [ ] `report_hal.c`: задача `report` (core 0, низький пріоритет, період опитування стану 100 мс через `vTaskDelayUntil`); читає підсумки з черги T10, будує документ (T7), кладе в NVS (T11) у DISARMED або FAILSAFE; на вході в DISARMED (включно з першим після SELFTEST) із непорожньою чергою й заданими налаштуваннями запускає спробу (T9 план, T12 мережа); видалення доставлених слотів — після `net_down`.
- [ ] Під час спроби перевіряє `app_state_get()` не рідше ніж раз на 100 мс: не DISARMED → переривання; у FAILSAFE/ARMED/OBSTACLE_HOLD/BOOT/SELFTEST/FAULT радіо вимкнене.
- [ ] Результат спроби — один рядок журналу; `report_hal_status()`/`report_hal_attempt_now()` для консолі (T14).
- [ ] Спроба повторно не запускається в тому ж DISARMED.

## Edge cases

| Case | Behaviour |
|---|---|
| ARM під час спроби | спроба перервана ≤ 100 мс + закриття; Wi-Fi вимкнено; звіт у черзі; озброєння не чекає |
| немає налаштувань мережі | спроба не починається; один пояснювальний рядок на вхід у DISARMED із непорожньою чергою |
| FAILSAFE через напругу | Wi-Fi не вмикається; після перезапуску перший DISARMED запускає спробу |
| черга порожня | Wi-Fi не вмикається |

## Definition of Done

- [ ] `idf.py build` без нових попереджень
- [ ] спроби не затримують крок керування (перевірка T17)
- [ ] кожне Hard Rule вище лишається дійсним
