12romis/esp32-elrs-rover/docs/features/phase8-session-report/tasks/t3-drive-core-tof-mode-gate.md

---
id: T3
title: "Додати в drive_core вхід «режим контролю» і подавити зайнятість секторів, коли режим вимкнено, з подіями зміни режиму й охорони"
layer: "app"
deps: ["T1"]
blocks: ["T4", "T10"]
acs: ["AC-01", "AC-02", "AC-03"]
files_hint: ["components/drive/drive_core.c", "components/drive/include/drive_core.h", "test/host/test_drive.c"]
owner: "Агент"
estimate: "M"
context_budget: "S"
status: "todo"
step: ""
---

# T3 — Додати в drive_core вхід «режим контролю» і подавити зайнятість секторів, коли режим вимкнено, з подіями зміни режиму й охорони

## Place in the sequence

- **Blocked by:** T1 — Додати в crsf_core канал CH9 і функцію «контроль перешкод увімкнено» зі значенням за замовчуванням · **Blocks:** T4 — Додати в ui зелений індикатор за режимом контролю й охороною з пріоритетом червоний > жовтий > зелений, T10 — Підʼєднати session до drive_hal: виклик session_step наприкінці кроку керування, подачу підсумку в чергу й логування подій режиму · **Wave:** 2.
- **Lane:** own lane.

## Why (user story)

> **As a** Розробник
> **I want** вмикати й вимикати контроль і автозупинку по далекомірах окремим тумблером пульта
> **So that** я можу підʼїхати впритул чи виїхати з тісного місця, не роззброюючи ровер
>
> — `spec.md §4, US-01, verbatim` · full text: [spec.md](../spec.md)

Задача дає частину історії: додати в drive_core вхід «режим контролю» і подавити зайнятість секторів, коли режим вимкнено, з подіями зміни режиму й охорони.

## Inlined context

> A1. **Режим контролю перешкод.** Ввімкнений, коли значення каналу CH9 вище середини діапазону (як у тумблера озброєння: більше 992 — «увімкнено»). За замовчуванням ввімкнений: від старту плати, у стендовому режимі, поки пульт не передав жодного кадру, і після втрати зв'язку, доки не прийде новий кадр (небезпечніше помилково вимкнений захист, ніж помилково ввімкнений). Розробник підтвердив, що виведе перемикач на CH9 і запише два положення в журнал вимірювань (OQ-6). Положення CH9 на TX12 ще не виміряні (у журналі CH9 = 992 у спокої, перемикача не призначено): «вище середини» — пропозиція, яку Розробник підтверджує заміром двох положень у `docs/measured.md` до `design` (п. 13; OQ-6); до заміру прошивка без призначеного перемикача бачить 992 як «вимкнено». Змінювати режим можна в будь-якому стані; консоль режим не змінює, а лише показує його в `status`.
>
> — `spec.md §1, A1, verbatim` · full text: [spec.md](../spec.md)

> A2. **Вимкнений режим.** Сектори не вважаються зайнятими: обмеження тяги в бік перешкоди не діє, утримання перед перешкодою не наступає, а якщо ровер уже в OBSTACLE_HOLD, він одразу повертається в ARMED. Далекоміри й далі міряють і показуються командою `tof`; відмова далекоміра так само пишеться в журнал. Усі інваріанти безпеки конституції (п. 7: STBY лише в ARMED, втрата кадрів понад 500 мс, перша операція I²C, VBAT < 6.0 В) і відсічка по напрузі діють без змін. Це свідомо доповнює фазу 6, де захист не мав вимикача; відповідна частина ADR-0004 phase6-tof доповнюється рішенням `design` (A14).
>
> — `spec.md §1, A2, verbatim` · full text: [spec.md](../spec.md)

> A3. **Індикатор плати.** Зеленуватий = зелений канал на перевіреному рівні 40 (порядок байтів із журналу вимірювань P8, байти (40,0,0)), без червоного. Світить у DISARMED і ARMED, коли режим ввімкнений **і** принаймні один сектор реально охороняється (хоч один працюючий далекомір і свіжий знімок). Якщо режим ввімкнений, але жоден далекомір не працює, зелений не світить, щоб не обіцяти захисту, якого немає (консоль уже пише попередження «озброєно без захисту»). Пріоритет кольорів: червоний у FAILSAFE, потім жовтий в OBSTACLE_HOLD, потім зелений; у BOOT, SELFTEST і FAULT індикатор лишається погашеним, як у фазі 7. Працює й тоді, коли розширювач портів недоступний. Консоль пише одне попередження «захист від зіткнень не діє» при кожному переході «охороняє → не охороняє» (зокрема коли знімок далекомірів застарів під час руху) у DISARMED чи ARMED і одне «захист відновлено» при зворотному; в інший час не повторює.
>
> — `spec.md §1, A3, verbatim` · full text: [spec.md](../spec.md)

> **Chosen:** варіант 1. Читання CH9 — `crsf_core`: нова функція «значення вище середини» поруч із `crsf_switch_arm`; стан за замовчуванням (немає кадру або зв'язку) — ввімкнено. Вимкнення в OBSTACLE_HOLD дає ту саму умову виходу, що й звільнення сектора (`!occ_front && !occ_rear`), тож окремого переходу не потрібно. `ui_core` отримує зелений індикатор (`UI_IND_GREEN`) за режимом, охороною (`tof_view_t.protection`) і станом: пріоритет червоний > жовтий > зелений.
>
> — `adr/0005-gate-tof-occupancy-in-drive-core-by-the-ch9-switch-with-default-on.md, Decision outcome, verbatim` · full text: [adr/](../adr/)

> Flow 5: тумблер CH9 → crsf → control; режим вимкнений: сектори не вважаються зайнятими; якщо ровер в OBSTACLE_HOLD — запит ARMED, утримання закрито; якщо в ARMED — рух уперед до перешкоди дозволено; в журнал один рядок; відсічка, втрата зв'язку, STBY, I²C діють без змін; при втраті зв'язку з вимкненим режимом — FAILSAFE як зазвичай.
>
> — `sad.md §6, «Flow 5», abridged` · full text: [sad.md](../sad.md)

> Конституція, п. 7: STBY піднімається тільки в ARMED; втрата кадрів CRSF довша за 500 мс → ШІМ у нуль, STBY вниз; перша операція по I²C після старту — запис 0x00 у PCF8574; VBAT < 6.0 В → мотори не запускаються. Інваріанти сильніші за будь-яку функціональність.
>
> — `docs/constitution.md, п. 7, abridged` · full text: [constitution.md](../../../constitution.md)

> Конституція, п. 6: кожен компонент ділиться на `<name>_core.c` (без жодного заголовка ESP-IDF) і `<name>_hal.c`; логіка живе в core і покривається тестами на хості. Пп. 8–9: збірка без помилок і без нових попереджень; коментарі й коміти — українською, ідентифікатори — англійською.
>
> — `docs/constitution.md, пп. 6, 8, 9, abridged` · full text: [constitution.md](../../../constitution.md)

**Fallback:** insufficient or contradicted by the code → read the named file in full ([spec.md](../spec.md) · [sad.md](../sad.md) · [contracts/](../contracts/) · [adr/](../adr/)) and follow it. Do not guess.

## Data delta

No DB changes.

## API contract

Внутрішнє: події журналу «контроль перешкод вимкнено/ввімкнено» (один на зміну) і «захист від зіткнень не діє / відновлено» (один на перехід) — cli.md «Рядки журналу».

## Acceptance criteria

### AC-01 — happy path

> **Given** ровер озброєний, зв'язок з пультом живий, контроль перешкод ввімкнений, а перед ровером у переднього сектора перешкода ближча за поріг
> **When** Розробник переводить тумблер контролю в положення «вимкнено»
> **Then** ровер перестає вважати сектор зайнятим, рух уперед знову дозволений, консоль пише один рядок про вимкнення контролю, а інваріанти безпеки діють без змін
>
> — `spec.md §5, AC-01, verbatim` · full text: [spec.md](../spec.md)

### AC-02 — happy path

> **Given** ровер у стані утримання перед перешкодою, контроль ввімкнений
> **When** Розробник вимикає тумблер контролю
> **Then** ровер одразу повертається в ARMED і їде за стіками, навіть якщо перешкода досі перед ним, а обліковий час цього утримання закривається
>
> — `spec.md §5, AC-02, verbatim` · full text: [spec.md](../spec.md)

### AC-03 — domain invariant violation

> **Given** контроль вимкнений і ровер їде
> **When** зв'язок з пультом зникає на понад пів секунди або напруга акумулятора падає нижче порога відсічки
> **Then** ровер зупиняється і переходить у FAILSAFE, як і при ввімкненому контролі: вимкнення захисту перешкод не послаблює жодного інваріанта безпеки
>
> — `spec.md §5, AC-03, verbatim` · full text: [spec.md](../spec.md)

## Checklist

- [ ] `drive_core.h`: у `drive_ctl_in_t` додати `bool tof_control_on`; у `drive_ctl_out_t` — `bool tof_control_on`, `bool tof_guarding` (режим ввімкнений і `tof.protection` і знімок свіжий) і події `DRIVE_EVT_TOF_CONTROL_ON`, `DRIVE_EVT_TOF_CONTROL_OFF`, `DRIVE_EVT_PROTECTION_LOST`, `DRIVE_EVT_PROTECTION_RESTORED` (наступні вільні біти).
- [ ] `drive_core.c` (близько `occ_front`/`occ_rear`, рядки 386–387): `occ_* = tof_ok && in->tof_control_on && sector.occupied`; вимкнений режим у OBSTACLE_HOLD дає ту саму умову виходу (`!occ_front && !occ_rear`) без нового переходу; обмеження тяги (`tof_limit_sides`) і `hold_*` не діють при вимкненому режимі.
- [ ] Події: зміна `tof_control_on` між кроками → одна подія; перехід `tof_guarding` true→false і назад → одна подія кожен (не на кожен крок).
- [ ] Хостові тести `test/host/test_drive.c`: фазові тести 6 запускаються з `tof_control_on = true` і не змінюються; нові — вимкнено → тяга вперед до зайнятого сектора дозволена; вимкнено в OBSTACLE_HOLD → запит ARMED; вимкнено + втрата зв'язку/напруга нижче порога → FAILSAFE як раніше; події один раз.

## Edge cases

| Case | Behaviour |
|---|---|
| режим вимкнений, сектор зайнятий | тяга в його бік не обрізається, OBSTACLE_HOLD не наступає |
| режим вимкнений у OBSTACLE_HOLD | запит ARMED на тому ж кроці |
| режим вимкнений, зв'язок втрачено понад 0.5 с | FAILSAFE, як при ввімкненому |
| режим вимкнений, VBAT нижче порога | відсічка діє |
| перемикач дребезжить між кадрами | кожна зміна — одна подія; рух і безпека не залежать від кількості подій |

## Definition of Done

- [ ] хостові тести drive (з новими) проходять; тести фази 6 без змін у поведінці
- [ ] `idf.py build` без нових попереджень
- [ ] кожне Hard Rule вище лишається дійсним
