12romis/esp32-elrs-rover/docs/features/phase8-session-report/tasks/t6-session-core-motion-stats.md

---
id: T6
title: "Додати в session_core пробіг, час руху, середню й пікову швидкість бортів і дисбаланс із явним «немає даних»"
layer: "domain"
deps: ["T5"]
blocks: ["T7", "T10"]
acs: ["AC-20", "AC-21"]
files_hint: ["components/session/session_core.c", "components/session/include/session_core.h", "test/host/test_session.c"]
owner: "Агент"
estimate: "M"
context_budget: "S"
status: "todo"
step: ""
---

# T6 — Додати в session_core пробіг, час руху, середню й пікову швидкість бортів і дисбаланс із явним «немає даних»

## Place in the sequence

- **Blocked by:** T5 — Створити session_core: межі сесії за станом, причина завершення, напруга, утримання за датчиками, час із вимкненим контролем, номер і тривалість · **Blocks:** T7 — Створити report_core: документ звіту сесії у форматі events.md з явними null і межею 1024 байти, T10 — Підʼєднати session до drive_hal: виклик session_step наприкінці кроку керування, подачу підсумку в чергу й логування подій режиму · **Wave:** 3.
- **Lane:** shares `components/session/session_core.c` with T0, T5 — serialized.

## Why (user story)

> **As a** Розробник
> **I want** бачити у звіті пробіг, час руху, середню й пікову швидкість бортів і їхній дисбаланс
> **So that** я оцінюю виїзд і помічаю повільний чи слабкий борт
>
> — `spec.md §4, US-07, verbatim` · full text: [spec.md](../spec.md)

Задача дає частину історії: додати в session_core пробіг, час руху, середню й пікову швидкість бортів і дисбаланс із явним «немає даних».

## Inlined context

> A9. **Пробіг і час руху.** Пробіг — сума модулів зміщення центру ровера за сесію лише на інтервалах часу руху, тобто коли хоча б один борт отримує ненульову потужність (півсума пройдених відстаней лівого й правого бортів на кожному інтервалі вимірювання; розворот на місці пробігу не додає; штовхання вручну й рух накатом не рахуються), у сантиметрах; береться з лічильників коліс при `WHEEL_DIAMETER_MM` = 44 мм (журнал вимірювань, 2026-10-19). Час руху — час, коли хоча б один борт отримував ненульову потужність; порога швидкості не вигадується (п. 3 конституції). Якщо в борту немає жодного доступного енкодера, пробіг рахується за доступним бортом, а звіт це позначає.
>
> — `spec.md §1, A9, verbatim` · full text: [spec.md](../spec.md)

> A10. **Швидкість бортів.** Середня — модуль швидкості борту в обертах колеса за хвилину, усереднений за час руху; пікова — найбільший модуль за сесію; окремо лівий і правий борт. **Дисбаланс** = (середня лівого − середня правого) / півсума середніх, у відсотках, зі знаком (плюс — лівий швидший), лише за ті інтервали, де задані швидкості обох бортів однакові й ненульові (їзда по прямій; мікшер дає точну рівність, коли поворот у мертвій зоні). Немає таких інтервалів — «немає даних», не нуль. Борт без доступного енкодера теж «немає даних». Метрика діагностична, а не критерій приймання (відома особливість: FR повільний, див. P7).
>
> — `spec.md §1, A10, verbatim` · full text: [spec.md](../spec.md)

> **Chosen:** варіант 1. Статистика рахується там, де дані вже є, без нових блокувань; приймач у черзі (задача `report`) отримує готову копію. Якщо черга повна (переповнення за ≤ 2 сесії), нова копія затирає найстарішу в черзі, як і правило з двох звітів.
>
> — `adr/0001-accumulate-session-statistics-in-the-control-task-and-hand-off-a-summary-through-a-bounded-queue.md, Decision outcome, verbatim` · full text: [adr/](../adr/)

> Flow 9: кожен крок хоч один борт з ненульовою потужністю → час руху, пробіг (півсума відстаней бортів), швидкість; задані швидкості бортів однакові й ненульові → інтервал прямої їзди для дисбалансу; потужності немає → пробіг не росте; борт без жодного доступного енкодера → швидкості цього борту й дисбаланс «немає даних».
>
> — `sad.md §6, «Flow 9», abridged` · full text: [sad.md](../sad.md)

> `WHEEL_DIAMETER_MM` = 44 мм; ≈ 2772 імпульси на оберт; довжина кола ≈ 138.2 мм; AC-06 фази 4: 1 м по рулетці дав 98.9 см (−1.1 %), допуск ±5 %.
>
> — `docs/measured.md, «WHEEL_DIAMETER_MM» і «Фаза 4: відстань 1 м», abridged` · full text: [measured.md](../../../measured.md)

> Конституція, п. 6: кожен компонент ділиться на `<name>_core.c` (без жодного заголовка ESP-IDF) і `<name>_hal.c`; логіка живе в core і покривається тестами на хості. Пп. 8–9: збірка без помилок і без нових попереджень; коментарі й коміти — українською, ідентифікатори — англійською.
>
> — `docs/constitution.md, пп. 6, 8, 9, abridged` · full text: [constitution.md](../../../constitution.md)

**Fallback:** insufficient or contradicted by the code → read the named file in full ([spec.md](../spec.md) · [sad.md](../sad.md) · [contracts/](../contracts/) · [adr/](../adr/)) and follow it. Do not guess.

## Data delta

No DB changes.

## API contract

Внутрішнє: поля `distance_cm`, `moving_ms`, `speed.*` (events.md) — `null` при відсутніх даних.

## Acceptance criteria

### AC-20 — happy path

> **Given** контроль ввімкнений, на підлозі позначено один метр, діаметр колеса — значення з журналу вимірювань
> **When** Розробник проїжджає цей метр прямо і роззброює ровер
> **Then** пробіг у звіті відрізняється від виміряного рулеткою не більше ніж на п'ять відсотків
>
> — `spec.md §5, AC-20, verbatim` · full text: [spec.md](../spec.md)

### AC-21 — error handling

> **Given** у одного борту немає жодного доступного енкодера, або ровер за сесію не їхав по прямій
> **When** формується звіт
> **Then** швидкості недоступного борту й дисбаланс позначені як «немає даних», а не нулем, і звіт це пояснює
>
> — `spec.md §5, AC-21, verbatim` · full text: [spec.md](../spec.md)

## Checklist

- [ ] `session_in_t` отримує: `left_permille`, `right_permille`, `left_rpm`/`right_rpm` (+ `*_valid`), `left_dist_cm`/`right_dist_cm` приріст за інтервал (з `enc_state_t`, `WHEEL_DIAMETER_MM` з `encoders_calib.h`), `target_left_rpm`/`target_right_rpm`.
- [ ] `session_step`: рух = хоч один борт з потужністю ≠ 0; пробіг += |півсума приростів| лише на таких інтервалах; середня |швидкість| за час руху; пік; дисбаланс = (лівий − правий)/півсума, % зі знаком, лише на інтервалах, де задані швидкості обох бортів однакові й ненульові; недоступний борт → `null`; `moving_ms` = 0 → швидкості `null`.
- [ ] Хостові тести: прямо 1 м, розворот на місці (пробіг 0), штовхання без потужності (пробіг 0), недоступний борт, дисбаланс зі знаком, відсутність прямої ділянки.

## Edge cases

| Case | Behaviour |
|---|---|
| розворот на місці | пробіг не росте (півсума приростів = 0) |
| штовхання вручну, накат, потужність 0 | пробіг і час руху не ростуть |
| борт без енкодера | швидкості цього борту й дисбаланс `null`, не нуль |
| ніколи не було прямої їзди | `imbalance_pct` = `null` |

## Definition of Done

- [ ] хостові тести session (з новими) проходять; `session_core.c` без заголовків ESP-IDF
- [ ] `idf.py build` без нових попереджень
- [ ] кожне Hard Rule вище лишається дійсним
