12romis/esp32-elrs-rover/docs/features/phase8-session-report/tasks/tracker.md

# Tracker — phase8-session-report

> Статус кожної задачі епіку. `implement` оновлює **Status** і **Step** після кожного підагента й комітить їх із задачею (у цьому проєкті — без коміту без вказівки Розробника).
> Status: `todo` · `in_progress` · `blocked` · `review` · `done`.
> Step: `SELECT` · `RED` · `GREEN` · `REFACTOR` · `GATE` · `REVIEW` · `COMMIT` (`—` до початку).

| # | Task | Layer | Owner | Estimate | Blocked by | Status | Step |
|---|---|---|---|---|---|---|---|
| T0 | Створити каркаси компонентів session і report: CMake, заголовки й порожні заглушки core/hal, що збираються без попереджень | wiring | Агент | S | — | todo | — |
| T1 | Додати в crsf_core канал CH9 і функцію «контроль перешкод увімкнено» зі значенням за замовчуванням | domain | Агент | S | — | todo | — |
| T2 | Додати в tof_core маску датчиків нижче порога й розширити рядок утримання переліком усіх таких датчиків | domain | Агент | M | — | todo | — |
| T3 | Додати в drive_core вхід «режим контролю» і подавити зайнятість секторів, коли режим вимкнено, з подіями зміни режиму й охорони | app | Агент | M | T1 | todo | — |
| T4 | Додати в ui зелений індикатор за режимом контролю й охороною з пріоритетом червоний > жовтий > зелений | app | Агент | M | T3 | todo | — |
| T5 | Створити session_core: межі сесії за станом, причина завершення, напруга, утримання за датчиками, час із вимкненим контролем, номер і тривалість | domain | Агент | M | T0, T2 | todo | — |
| T6 | Додати в session_core пробіг, час руху, середню й пікову швидкість бортів і дисбаланс із явним «немає даних» | domain | Агент | M | T5 | todo | — |
| T7 | Створити report_core: документ звіту сесії у форматі events.md з явними null і межею 1024 байти | domain | Агент | M | T6 | todo | — |
| T8 | Створити mqtt_core: кодування CONNECT, PUBLISH (QoS 1), DISCONNECT і розбір CONNACK та PUBACK для MQTT 3.1.1 | domain | Агент | M | T0 | todo | — |
| T9 | Створити report_queue_core: кільце з двох слотів, порядок передачі, вихід зі спроби при першій невдачі й правила дозволу передачі за станом | domain | Агент | M | T7 | todo | — |
| T10 | Підʼєднати session до drive_hal: виклик session_step наприкінці кроку керування, подачу підсумку в чергу й логування подій режиму | wiring | Агент | M | T3, T6 | todo | — |
| T11 | Створити report_store_hal і налаштування мережі: NVS-кільце звітів одним записом, версія й git образу, локальний файл секретів, сертифікат, зміни сборки | infra | Агент | M | T7, T9 | todo | — |
| T12 | Створити report_net_hal: підключення Wi-Fi, TLS із закріпленим сертифікатом і обмін MQTT з таймаутом 100 мс на крок | infra | Агент | M | T8, T11 | todo | — |
| T13 | Створити report_hal: задачу report на core 0 з спробою передачі при вході в DISARMED, скасуванням озброєнням і записом результатів | app | Агент | M | T9, T10, T12 | todo | — |
| T14 | Додати в консоль команду report та поля status про режим контролю й звіти, з підключенням у main | ports | Агент | M | T10, T13 | todo | — |
| T15 | Додати хостові перевірки: гігієна секретів у git, повний прогін збірки й тестів, захищені файли дозволені лише в межах фази | tests | Агент | S | T14 | todo | — |
| T16 | Оновити README, архітектурну діаграму й самоперевірку: режим CH9, індикатор, звіт сесії, налаштування мережі, відомі обмеження | docs | Агент | S | T14 | todo | — |
| T17 | Скласти чекліст приймання на залізі для Розробника: CH9, індикатор, список датчиків, доставка, черга, переривання озброєнням, FAILSAFE, замір запису в памʼять | tests | Розробник | M | T15, T16 | todo | — |

**Total:** 18 задач, ≈ 16.0 людино-днів.
