12romis/esp32-elrs-rover/docs/features/phase3-crsf/contracts/api-sync-report.md

# api-sync-report — phase3-crsf (контракт консолі)

Форма контракту: `contracts/cli.md` (target_surfaces: `[cli]`, прочитано з sad.md, не виведено заново). `data-model.md` відсутній — **легальний пропуск** (зміни схеми немає: прошивка без сховища, стан автомата — у пам'яті; sad.md §6 «Позначки для інших стадій»). Подій для зовнішніх споживачів немає (`events.md` не потрібен: асинхронність — лише між задачами всередині прошивки).

## Field-origins

| Поле | Походження | Confidence |
|---|---|---|
| режими «стенд» / «пульт» для `arm`, `drive` | spec AC-13…AC-15, матриця дозволів; `CONTEXT.md` «Стендовий режим» | high |
| клас 3 «керує пульт» і його місце після кроків 1–2 | spec AC-15; ADR-0003 (відповідь задачі керування); порядок «спершу стан» — фаза 1 (`console_core.c`) | high |
| клас 4 «напруга» лише в стенді | фаза 1 AC-13; spec AC-13 («як у фазі 1») | high |
| `disarm` у ARMED: підказка про тумблер | spec AC-16, AC-04 | high |
| `disarm` у FAILSAFE: пояснення за причиною | spec AC-08, AC-09 (консоль називає умову або пояснює скидання); те, що це саме відповідь `disarm`, — виведення контракту | medium |
| `help`: «лише в стендовому режимі» | spec AC-15; формат рядків — поточний `console_help_text` | medium |
| поля `status` (джерело, зв'язок, час, лічильники, сирі CH1/CH2/CH5, тяга й поворот, тумблер, причина FAILSAFE) | spec AC-12 (після clarify) | high |
| поле `status` «озброєння: що блокує» | spec AC-04 (після clarify: «показ стану називає умову, яка блокує озброєння зараз») | high |
| лічильники «інші типи», «переповнення буфера» | sad.md §4 (журнал припущень design, прийнятий власником) | high |
| тумблер «невідомо» | sad.md §4, §12 «База фронту» | high |
| рядки журналу | spec AC-03, AC-04, AC-05, AC-07, AC-08, AC-09, AC-14, §6; sad.md §4 | high |

## Forward drift checklist

| Перевірка | Результат |
|---|---|
| Команда ↔ модель/схема | ✓ схеми немає; нових команд немає, синтаксис фаз 0–2 без змін |
| Клас відмови ↔ AC | ✓ клас 1 → матриця; клас 2 → фаза 1; клас 3 → AC-15; клас 4 → AC-13 (фаза 1) |
| Валідація ↔ обмеження | ✓ межі `drive` (−1…+1) і порогу напруги — фаза 1; нових меж немає |
| Контракт ↔ послідовності | ✓ потік 6 (стенд, поява пульта, відмова «керує пульт»), потік 3 (роззброєння з консолі з підказкою), потік 4 (відмова виходу з причиною «напруга»), потік 7 (поля `status`, три варіанти) |

## Back-feed (покриття)

| AC | Де в контракті |
|---|---|
| AC-03 | журнал: озброєння/роззброєння з пульта |
| AC-04 | журнал: відхилений фронт; `status` «озброєння»; `disarm` у ARMED |
| AC-05 | журнал: втрата зв'язку в ARMED |
| AC-07 | журнал: втрата/відновлення в DISARMED; клас 3 для консольного `arm` |
| AC-08, AC-09 | `disarm` у FAILSAFE; журнал виходу і відсічки у FAILSAFE |
| AC-12 | `status`, нові поля |
| AC-13 | `arm`, `drive` у стенді (успіх як у фазі 1, джерело «стенд») |
| AC-14 | журнал: поява пульта |
| AC-15 | клас 3, матриця |
| AC-16 | `disarm` у ARMED |
| AC-01, 02, 06, 10, 11, 17 | не командна поверхня: поведінка пульта й приймача; на рівні контракту — лише спостережувані наслідки в `status` і журналі |
| AC-18, 19, 20 | не контракт (процес роботи Агента) |

Кожна змінена операція мапиться на історію: `arm`/`drive` — US-07; `disarm` — US-02, US-04; `status` — US-06. Жодної AC без місця в контракті й жодної операції без AC. **Прогалин у послідовностях немає**: кожна відмова класів 1–4 і кожна змінена відповідь `disarm` мають гілку в потоках 3, 4 або 6.

## Прапорці й припущення

- Відповідь `disarm` у FAILSAFE з поясненням за причиною — виведення контракту (medium): spec вимагає, щоб консоль пояснювала, але не каже, якою командою; `disarm` — природне місце, бо саме ним Розробник пробує «вийти». Ветується на `tasks`.
- Окремий клас «drive в ARMED з пульта» не введено: такий стан можливий лише в режимі «пульт», тож його покриває клас 3.
- Лінтера для текстового контракту немає (`spectral` не застосовується).

Підсумок: 4 з 4 перевірок ✓, core-знахідок немає, 1 прапорець (medium).
