12romis/esp32-elrs-rover/CONTEXT.md

---
status: Living
updated_at: "2026-10-22"
---

# Domain Context — ESP32-ELRS-Rover

<!--
CONTEXT.md is the domain glossary — not a spec and not a scratch pad. NO implementation
detail here (no datastore/broker/framework names, no API contracts) — only domain words
and the boundaries between them. Implementation choices live in the SAD and ADRs; behaviour
lives in spec.md.

Terms get fixed inline, the moment they surface in an interview / spec / review — never
batched «I'll consolidate later». Empty H2 → prune before commit; keep only the sections
that carry real content. ## Glossary is mandatory; the other two are optional.
-->

## Glossary

- Автомат станів — набір станів ровера (BOOT, SELFTEST, DISARMED, ARMED, OBSTACLE_HOLD, FAILSAFE, FAULT) і таблиця дозволених переходів між ними. NOT довільний прапорець «увімкнено/вимкнено»: перехід, якого немає в таблиці, неможливий.
- Агент — програмний помічник, який у цьому проєкті збирає прошивку і запускає хостові тести. NOT Розробник: Агент не прошиває плату, не фіксує зміни в історії без прямої вказівки і не змінює захищені файли без явної згоди.
- Консоль — текстовий канал «Розробник ↔ плата» через USB, у якому Розробник вводить службові команди і бачить журнал та відповіді. NOT пульт: з фази 3 консоль задає рух лише в стендовому режимі, а роззброїти ровер може завжди.
- Пульт — радіопульт Розробника, з якого він озброює ровер тумблером і керує рухом правим стіком; його команди доходять до плати через приймач. NOT консоль: пульт не бачить журналу й службових команд.
- Звʼязок з пультом — стан, у якому від приймача надходять валідні кадри каналів (правильна довжина й контрольна сума) з проміжком не більше 0.5 с. NOT будь-які кадри від приймача: службові кадри статистики радіоканалу приймач шле ще кілька секунд після вимкнення пульта, і звʼязку вони не підтримують.
- Втрата звʼязку — понад 0.5 с без валідного кадру каналів після того, як звʼязок уже був. NOT відсутність пульта від самого старту: це стендовий режим.
- Тумблер озброєння — двопозиційний перемикач пульта (канал 5) з положеннями ARM і DISARM; озброює лише перемикання з DISARM у ARM, а положення DISARM роззброює. NOT кнопка і не саме положення ARM: тумблер, що вже стоїть у ARM, ровер не озброює.
- Нейтраль стіків — положення, у якому тяга й поворот лежать у мертвій зоні (±5 % ходу від центру), тож ровер стоїть. NOT рівно центральне значення: у спокої стіки дають трохи зміщені значення.
- Стендовий режим — режим від старту плати, доки не прийшов жоден валідний кадр каналів: озброєння й рух задаються з консолі, як у фазі 1. NOT резервне керування після втрати звʼязку: щойно пульт зʼявився, консоль до перезапуску рух не задає.
- Причина аварійної зупинки — чому ровер опинився у FAILSAFE: втрата звʼязку або напруга нижче порога відсічки. NOT журнал подій: від причини залежить, чи можна вийти з FAILSAFE без скидання плати (лише після втрати звʼязку).
- Борт — лівий або правий бік ровера: два колеса одного боку, що завжди отримують однакову команду. NOT окреме колесо: незалежне керування колесом фізично неможливе.
- Відсічка по напрузі — заборона запуску моторів і примусова зупинка, коли напруга акумулятора нижча за поріг 6.0 В. NOT захист самого акумулятора від глибокого розряду і не вимкнення плати: консоль і решта прошивки лишаються живими.
- Захищені файли — канонічні файли проєкту, що не змінюються без явної згоди Розробника: кореневий файл збірки, каталог налаштувань редактора, файл типових налаштувань збірки; окремо — каталог проєкту плати, який Агент не редагує взагалі. NOT будь-який файл конфігурації: від цих залежать підказки редактора і налаштування пам'яті плати.
- Команда руху — команда консолі `drive` із тягою і поворотом, що діє обмежений час (2 с) і сама гасне, якщо її не повторити. NOT постійне завдання швидкості: без повтору ровер не їде далі.
- Мікшер — перетворення пари «тяга + поворот» на команди лівому і правому борту (танковий привід: ліве = тяга + поворот, праве = тяга − поворот). NOT регулятор швидкості: він працює без зворотного звʼязку і нічого не вимірює.
- Розробник — власник проєкту, який прошиває плату через редактор, читає консоль і заносить результати приймання в журнал bring-up. NOT Агент: лише Розробник вирішує, що прошивається і фіксується.
- Розширювач портів — мікросхема на шині периферії з вісьмома дискретними виходами, що тримає світло і лінії скидання чотирьох далекомірів; після подачі живлення вона піднімає всі виходи, поки прошивка не запише в неї нуль, і не скидається разом з керуючою платою. NOT окремий пристрій світла: світло — лише три з її восьми виходів.
- Канал світла — один із трьох незалежних світлових виходів розширювача: фари, червоний задній ліхтар, зелений задній ліхтар. NOT лінія скидання далекоміра, що сидить на тому самому розширювачі, але світлом не є.
- Задні ліхтарі — червоний і зелений ліхтарі ззаду ровера (два кристали одного світлодіода: разом дають жовте світло); в ARMED і OBSTACLE_HOLD автоматично показують напрямок руху, у FAILSAFE блимають червоним, в OBSTACLE_HOLD блимають кольором руху, якщо зайнятий задній сектор, у DISARMED керуються вручну. NOT фари.
- Індикатор плати — вбудований RGB-світлодіод керуючої плати; світить червоним у FAILSAFE, жовтим (червоний і зелений канали разом) увесь час OBSTACLE_HOLD, зеленуватим у DISARMED і ARMED, коли режим контролю перешкод ввімкнений і хоч один сектор охороняється, у решті станів погашений. NOT задні ліхтарі і не частина розширювача портів: працює й тоді, коли розширювач недоступний.
- Зумер — пасивний звуковий випромінювач ровера: звучить лише на частоті, яку задає прошивка, а під постійною напругою не звучить і гріється. NOT активний зумер із власним генератором.
- Діапазон зумера — допустимі частота (200–5000 Гц) і тривалість (1–2000 мс) сигналу, межі входять. NOT фізична резонансна частота зумера: її ще не виміряно.
- Деградація — режим, у якому розширювач портів недоступний: світло не працює, а мотори, озброєння, консоль, зумер і індикатор плати діють як зазвичай. NOT FAULT: ровер не зупиняється і озброєння не блокується.
- Енкодер колеса — датчик обертання на валу мотора з двома лініями, що дає 2772 імпульси на оберт колеса; кожне з чотирьох коліс (FL, FR, RL, RR) має свій. NOT датчик руху ровера відносно підлоги: колесо, що проковзує чи крутиться в повітрі, енкодер рахує так само.
- Лічильник колеса — накопичене число імпульсів енкодера зі знаком від старту плати або від останнього обнулення; рух ровера вперед збільшує лічильник кожного з чотирьох коліс. NOT сирий апаратний лічильник: той обмежений за діапазоном, а його знак залежить від борту.
- Швидкість колеса — приріст лічильника колеса за інтервал вимірювання (номінально 20 мс), поділений на фактичний час між вибірками; в обертах колеса за хвилину і в сантиметрах за секунду; додатна при русі вперед. NOT швидкість ровера: у розвороті борти мають протилежні швидкості, а при проковзуванні колесо крутиться, коли ровер стоїть.
- Пройдена відстань колеса — лічильник колеса, перерахований через довжину кола колеса. NOT шлях ровера: у поворотах танковий привід проковзує, тож відстань колеса більша за переміщення ровера.
- Зрив лічильника — втрата або хибний приріст імпульсів: лічильник стоїть, стрибає на межі апаратного лічильника чи змінює знак, поки колесо крутиться в один бік, або нерухоме колесо набирає імпульси від наведення моторних дротів. NOT розбіжність ±2 % між прогонами ручного обертання — це неточність руки, а не прошивки.
- Знімок енкодерів — одноразовий вивід у консоль на запит Розробника: час від старту плати, лічильник інтервалів вимірювання, а для кожного з чотирьох коліс — лічильник, оберти, швидкість, пройдену відстань і лінійну швидкість (або недоступність колеса з причиною). NOT безперервний журнал: між двома знімками консоль про енкодери нічого не пише.
- Журнал вимірювань — файл `docs/measured.md`, куди Розробник записує кожну виміряну величину заліза з датою й способом заміру; прошивка й специфікації спираються лише на записані там числа. NOT журнал bring-up: той фіксує приймання фаз на залізі, а не константи.
- Регулятор швидкості — регулятор зі зворотним звʼязком на кожен борт: змінює потужність борту за різницею заданої швидкості борту і швидкості борту, щоб борт тримав задану швидкість під навантаженням. NOT мікшер: мікшер лише ділить тягу й поворот між бортами і нічого не вимірює.
- Швидкість борту — середнє швидкостей коліс борту, енкодери яких доступні; якщо доступне одне колесо, швидкість борту дорівнює його швидкості. NOT швидкість колеса і не швидкість ровера: у розвороті борти мають протилежні знаки.
- Задана швидкість борту — швидкість, яку тримає регулятор: вихід мікшера для борту, помножений на стелю заданої швидкості, після плавного розгону; в обертах колеса за хвилину, зі знаком напрямку. NOT швидкість борту: задана — це ціль, швидкість борту — вимір.
- Стеля заданої швидкості — задана швидкість борту на повному стіку: 150 обертів колеса за хвилину (рішення Розробника за паспортом моторів). NOT виміряна найбільша швидкість: на межі потужності чи низькій напрузі борт може її не досягати.
- Межа потужності — найбільша частка ШІМ, яку прошивка будь-коли подає на борт: 0.75, доки замір безпечної межі не записано в журнал вимірювань; змінюється лише правкою прошивки після такого запису. NOT стеля заданої швидкості і не набір коефіцієнтів: консоль межу не змінює.
- Набір коефіцієнтів — чотири числа регулятора, спільні для обох бортів: Kp, Ki, Kd і темп плавного розгону; похибка — в обертах колеса за хвилину, вихід — частка повної потужності, Ki і Kd рахуються на секунду, а не на такт; задаються з консолі, діють одразу і зберігаються в памʼяті плати разом із режимом регулятора лише окремою командою збереження. NOT межа потужності: та не налаштовується з консолі.
- Плавний розгін — обмеження темпу, з яким зростає модуль заданої швидкості борту (обертів колеса за хвилину за секунду). NOT плавна зупинка: зменшення заданої швидкості і будь-яка зупинка діють одразу.
- Режим без регулятора — режим, у якому потужність борту пропорційна виходу мікшера, як у фазах 1–4; діє, коли регулятор вимкнений, не налаштований або в борту немає жодного доступного енкодера. NOT аварійний стан: ровер озброюється і їздить як зазвичай.
- Заклинення борту — (захист від заклинення винесено з фази 5 разом із підняттям межі потужності, 2026-10-20; термін лишається для майбутнього кроку) стан, у якому вихід регулятора борту безперервно довше за поріг часу стоїть на межі потужності (модуль виходу ≥ 98 % межі), а швидкість борту менша за 10 % заданої після розгону; борт вимикається, доки задана швидкість не повернеться в нуль. NOT короткочасне навантаження (притиснення пальцем) і не FAILSAFE: ровер лишається озброєним.
- Трасування регулятора — потоковий вивід у консоль раз на 100 мс, поки ровер озброєний: для кожного борту задана швидкість, швидкість борту і вихід регулятора. NOT знімок енкодерів: той одноразовий і про колеса, а трасування безперервне і про борти.
- Далекомір — оптичний датчик відстані ровера; їх чотири: ліворуч-вперед під 45°, прямо вперед, праворуч-вперед під 45° і прямо назад. NOT датчик на боках: бокового покриття немає, тож ровер не бачить перешкод збоку.
- Сектор — напрямок руху, який стереже група далекомірів: передній (три передні далекоміри) або задній (один). NOT бік ровера: бокових секторів немає.
- Відстань сектору — найменша з відфільтрованих відстаней працюючих далекомірів сектору; «поза діапазоном» означає, що перешкоди немає. NOT сирий відлік одного далекоміра: поодинокий викид її не змінює.
- Поріг перешкоди — відстань (`TOF_OBSTACLE_MM`), ближче якої сектор вважається зайнятим; одна для всіх секторів, береться з журналу вимірювань і не змінюється з консолі. NOT гальмівний шлях: поріг має бути більшим за шлях, який ровер долає за час реакції та до зупинки.
- Зайнятий сектор — сектор, відстань якого менша за поріг перешкоди; рух у його бік заборонений, у протилежний бік і поворот на місці дозволені. NOT FAILSAFE: ровер лишається озброєним і керованим.
- Утримання перед перешкодою — стан автомата OBSTACLE_HOLD: ровер озброєний, режим контролю перешкод ввімкнений і принаймні один сектор зайнятий; тяга в бік зайнятого сектора дорівнює нулю, а всі інваріанти безпеки ARMED діють без змін. Супроводжується індикацією утримання. NOT аварійна зупинка і не роззброєння: вихід — коли сектор звільнився або вимкнено режим контролю перешкод.
- Відмова далекоміра — далекомір не відповів при старті або не дав валідного відліку понад 250 мс; його сектор не вважається зайнятим через нього, у журнал іде попередження, а прошивка не зупиняється. NOT «поза діапазоном»: це справний відлік, що каже «перешкоди немає».
- Індикація утримання — сигнали, що відрізняють OBSTACLE_HOLD від поломки: подвійний біп на вході й на виході в ARMED, жовтий індикатор плати, блимання фар при зайнятому передньому секторі й задніх ліхтарів при зайнятому задньому. NOT керування: індикація лише відображає стан і ніколи не впливає на мотори, STBY чи автомат станів.
- Подвійний біп — два звуки по 100 мс із паузою 100 мс на частоті автоматичних сигналів (1000 Гц), що не накладається на інший подвійний біп і поступається сигналам DISARMED і FAILSAFE. NOT одинарний сигнал переходу: той триває 100 мс і лунає на DISARMED, FAILSAFE та озброєнні.
- Телеметрія — кадр датчика батареї, який ровер раз на 200 мс надсилає на пульт через приймач: напруга акумулятора з розв'язністю 0.1 В; струм, ємність і відсоток заряду нульові й означають «немає даних». NOT консоль: консоль — USB-канал, а телеметрія йде радіоканалом на екран пульта.
- Час кроку керування — тривалість виконання одного кроку керування (без очікування наступного періоду); від старту плати збираються останнє, середнє й найбільше значення та число кроків, що перевищили період 20 мс; показується командою `status`. NOT період кроку: період — 20 мс, і тримається очікуванням до моменту.
- Режим контролю перешкод — перемикається тумблером пульта (канал 9, значення вище середини — «увімкнено»): ввімкнений — сектори, зайняті за порогом перешкоди, зупиняють ровер; вимкнений — сектори зайнятими не вважаються, далекоміри лише міряють. За замовчуванням ввімкнений. NOT відмова далекоміра і не FAILSAFE: інваріанти безпеки (втрата зв'язку, відсічка по напрузі) діють в обох режимах.
- Сесія — відрізок від входу в ARMED з DISARMED до виходу з ARMED/OBSTACLE_HOLD у DISARMED, FAILSAFE чи FAULT; перехід ARMED ↔ OBSTACLE_HOLD її не перериває. NOT час роботи плати і не один рух: сесія може містити кілька зупинок і утримань.
- Звіт сесії — один структурований документ з підсумком сесії (напруга на старті й на виході, причина завершення, утримання перед перешкодою, пробіг і час руху, швидкості бортів, версія прошивки, git-хеш, версія IDF, MAC). NOT журнал консолі і не безперервна телеметрія: звіт один на сесію, надсилається після входу в DISARMED.
- Черга звітів — невідправлені звіти, збережені в памʼяті плати; не більше двох, найстарший видаляється при появі третього. NOT архів: успішно надісланий звіт з черги видаляється.
- Пробіг — сума модулів зміщення центру ровера за сесію лише на інтервалах руху, коли хоч один борт отримує ненульову потужність (півсума пройдених відстаней колес лівого й правого бортів на кожному інтервалі вимірювання). NOT пройдена відстань колеса: розворот на місці пробігу не додає.
- Дисбаланс бортів — різниця середніх швидкостей лівого й правого бортів, віднесена до їхньої півсуми, у відсотках зі знаком (плюс — лівий швидший), лише на інтервалах прямої їзди (однакові ненульові задані швидкості). NOT різниця швидкостей у повороті: поворот не рахується.
