12romis/esp32-elrs-rover/docs/features/phase4-encoders/acceptance.md

# Приймання фази 4 на залізі — чек-лист Розробника

Виконує **Розробник**: прошиває основну прошивку (корінь проєкту) через розширення ESP-IDF у VS Code, крутить колеса, керує пультом і консоллю, читає монітор. Агент нічого не прошиває й не комітить без вказівки. Результати йдуть у журнал bring-up (дата, результат, значення); виміри — у `docs/measured.md`. Агент не позначає задачі T5, T6 і T8 виконаними, доки Розробник не запише приймання (spec AC-12). Приймання записано 2026-10-19 — T5, T6, T8 виконано.

**Безпека.** Ровер на підставці, **колеса в повітрі** на всіх кроках, крім 9. Акумулятор 2S підключений. Під рукою вимикач живлення, на консолі готовий рядок `disarm`. Монітор відкритий **до** подачі живлення.

**Що таке знімок.** `enc` друкує рядок «енкодери: вибірка T мс від старту, інтервалів N» і по рядку на колесо FL, FR, RL, RR: «імп, об, об/хв, см, см/с» (contracts/cli.md). Рух ровера вперед дає плюс на всіх колесах.

## Статус хостових перевірок (Агент, 2026-10-19, після виправлень T9–T12 за `_review/review-2026-10-19.md`)

- `test/host/run_tests.sh`: 5622 тести, 5622 пройдено; покриття: 140 з 140 пар «команда × стан × режим керування» (додано `enc`).
- **Час хостового прогону (spec §6, «≤ 5 с»; review F4, spec §8 OQ-2):** 3.3–3.7 с у трьох прогонах поспіль (8 ядер, машина без іншого навантаження). Рецензент на тій самій машині намірив 6.1–6.2 с, а на базі фази `2870d32` — 5.36 с; вимір залежить від навантаження машини. Повторний огляд — 3.20–3.32 с; OQ-2 закрито 2026-10-19 виміром (у межах NFR, поріг без змін).
- `check_core_headers.sh`, `check_pins.sh`, `check_delays.sh`, `check_bus_rules.sh`, `check_protected.sh`, `check_calib.sh` — чисті; `selftest_tools.sh` — усе гаразд.
- `idf.py build`: без помилок і без компіляторних попереджень (5 попереджень CMake походять із самого ESP-IDF — `esp_wifi`, `wpa_supplicant` — і були до фази 4).
- Хостові тести покривають: приріст за модулем межі ±30000, перехід через межу в обидва боки, 120 000 імпульсів без стрибків, знак кожного колеса, накопичувач біля 10^15 (AC-04); швидкість як приріст на фактичний час, нуль на другій вибірці після останнього імпульсу, 500 інтервалів за 10 с, вибірки наздоганяння після паузи задачі (коротші за 10 мс) без викиду швидкості й без втрати руху (AC-02, AC-04, §6; review F1); оберти, об/хв, см, см/с, формати, недоступне колесо поруч із доступними, три відповіді `enc reset` і рядок `status` (AC-01, AC-06, AC-08); розбір `enc` і хибних форм — окремий текст на невідоме слово, помилку в `reset` і зайве слово (AC-07; review F2); обнулення без стрибка швидкості (AC-09).
- **AC-08 на залізі не перевіряється:** викликати збій налаштування лічильника нічим; приймається хостовими тестами (T3) і оглядом коду (spec AC-08).

## Що перевіряється лише на залізі

| # | Дія Розробника | Очікування | AC | Запис у журнал |
|---|---|---|---|---|
| 1 | Подати живлення; `status`, `help`, `enc` | у журналі старту «енкодери: 4 з 4 доступні, вибірка кожні 20 мс»; `status` — рядок «енкодери: 4 з 4 доступні»; `help` має рядок `enc [reset]`; `enc` — заголовок і 4 рядки коліс, усі нулі, швидкість 0.0 | AC-08, cli.md | вільна памʼять зі `status` (поріг ≥ 345000 байт) |
| 2 | DISARMED. Для **кожного** колеса: `enc reset`; прокрутити колесо рукою **рівно 10 обертів** у напрямку «ровер їде вперед»; `enc`; прокрутити те саме колесо 10 обертів назад; `enc` | після руху вперед лише це колесо ≈ **+27720 імп (від 27166 до 28274), 10.00 об ± 0.20**, ≈ 138 см; три інші — 0; після руху назад — знову ≈ 0 (± 2 %); назва колеса в рядку відповідає його місцю на шасі | AC-01, AC-03 | 4 значення «вперед» і 4 «назад» |
| 3 | Пульт: озброїти тумблером, стік **повністю вперед** і тримати; `enc` двічі під час руху з проміжком кілька секунд; відпустити стік, коли колеса зупиняться — `enc` | під час руху всі чотири швидкості **додатні**, між двома знімками відрізняються ≤ 10 %; після зупинки швидкість кожного колеса **0.0**, лічильники зберегли значення | AC-02 | швидкості коліс (об/хв) у двох знімках |
| 4 | ARMED з пульта: стік повністю назад, `enc`; потім стік праворуч (розворот на місці), `enc` | назад — усі чотири швидкості **відʼємні**; праворуч — FL і RL **додатні**, FR і RR **відʼємні** | AC-03 | знаки |
| 5 | ARMED з пульта: `enc reset`; стік **повністю вперед** і тримати, доки **кожне** колесо в `enc` не покаже **≥ 100 000 імп** (не менше 10 с і не довше 60 с), викликаючи `enc` кожні кілька секунд; потім так само повністю назад | лічильник кожного колеса під час руху вперед лише зростає, проходить 100 000 без стрибків, скидань і зміни знака; під час руху назад лише спадає. Для двох сусідніх знімків: приріст імпульсів ≈ (середнє швидкостей двох знімків, імп/с = об/хв × 2772 / 60) × (різниця «вибірка … мс» / 1000) **± 5 %** | AC-04 | знімки; час до 100 000 для кожного колеса |
| 6 | Перезапуск плати **з вимкненим пультом** (стендовий режим). `arm`; `enc reset`; `enc`; **5 разів поспіль** `drive 0.375 0.375` (кожна діє 2 с, разом ≈ 10 с: крутиться лише лівий борт на 0.75); `enc`. Потім `enc reset` і так само `drive 0.375 -0.375` (лише правий борт) | у знімку після руху лівого борту FR і RR змінилися **не більше ніж на 4 імп** і мають швидкість 0.0; і навпаки для правого борту (FL, RL ≤ 4 імп). Якщо нерухоме колесо помітно провернулось від вібрації (видно оком) — записати як справжній рух, а не дефект | AC-05 | зміна лічильників нерухомих коліс |
| 7 | Будь-який стан: `enc`, почекати **не менше 10 с**, `enc` | різниця «інтервалів» між знімками = (різниця «вибірка … мс») / 20 **± 1** | spec §6 | обидва знімки |
| 8 | ARMED з пульта, рух стіком: `enc reset` **під час руху** | консоль: «лічильники й відстань обнулено: FL, FR, RL, RR»; лічильники стають 0 і далі ростуть; швидкість у наступному знімку без стрибка; ровер їде далі, стан ARMED | AC-09 | результат |
| 9 | Ровер **на підлозі** на початку відрізка **1 м** по рулетці. `enc reset`; з пульта проїхати по прямій на **малій тязі** до кінця відрізка; `enc` | кожне колесо показує см і см/с; **середнє** пройдених відстаней чотирьох коліс — **від 95.0 до 105.0 см** | AC-06 | 4 відстані й середнє |
| 10 | Стендовий режим (пульт вимкнений): `arm`; `drive 0.25 0`, під час руху `enc`; так само `drive 0.5 0` і `drive 0.75 0` | у кожному знімку — швидкість кожного колеса | spec §7 KPI | **швидкість кожного колеса (об/хв) на 0.25, 0.5, 0.75 і найбільша на 0.75 — у `docs/measured.md`** |
| 11 | Будь-який стан: `enc foo`, `enc Reset`, `enc reset x` | кожну відхилено, і текст називає причину: `enc foo` — «невідоме друге слово», `enc Reset` — «схоже на reset… (регістр має значення)», `enc reset x` — «зайве третє слово»; у кожному — «Допустимо: «enc» — знімок…, «enc reset» — …»; лічильники не змінились | AC-07 | результат |
| 12 | ARMED з пульта, 30 с безперервно рухати стік | рядки журналу «затримка кадр → борти: …, макс Z мс» — **макс ≤ 50 мс** (як у фазі 3; задача encoders не погіршує відгук керування) | spec §6 | найбільше «макс» |
| 13 | Пульт: озброїти тумблером (ARMED), відпустити стік; **вимкнути пульт** — ровер іде у FAILSAFE; `enc reset`; прокрутити одне колесо рукою на кілька обертів уперед; `enc`; `status` | `status` показує стан **FAILSAFE**; у знімку лічильник прокрученого колеса **змінився** (додатний, ≈ 2772 імп на оберт), інші — ≈ 0: енкодери рахують і в FAILSAFE | AC-03 (review F3) | стан і зміна лічильника |

Додатково записати в `docs/measured.md`: вільну внутрішню памʼять зі `status` після старту (поріг ≥ 345000 байт), швидкості коліс з кроку 10 (KPI фази 4) і середню відстань з кроку 9.

**Повільне FR (P7).** Якщо на повному стіку FR не рушив або крутиться так повільно, що дає менше 20 імпульсів за інтервал (≈ 22 об/хв), — це несправність заліза: записати в журнал bring-up, а для FR кроки 3 і 5 позначити «залізо», не «провал прошивки» (spec AC-02, AC-04).

**Скидання лічильника на межі.** Крок 5 — єдина перевірка того, що апаратний лічильник скидається в нуль на ±30000 при ввімкнених watch-point (ADR-0002, sad.md §11). Стрибок у лічильнику на кроці 5 — сигнал повернутися до варіанта watch-point з накопиченням у перериванні (ADR-0002, варіант 2).

## Що не виконує Агент

Прошивання, живлення, обертання коліс, керування пультом і консоллю, запис у журнал bring-up і `docs/measured.md`. Задачі T5, T6 і T8 лишалися у статусі `review`, доки Розробник не записав приймання (2026-10-19).

## Результати приймання (Розробник)

Підсумок (Розробник, 2026-10-19; журнал монітора; докладно — у `docs/measured.md`, рядки «Фаза 4: …»): кроки 1–13 виконано, фазу прийнято. Крок 2 для FL і RL вийшов за допуск ±2 %; Розробник прийняв його як похибку ручного обертання (див. відхилення 1).

| # | Результат | AC |
|---|---|---|
| 1 | `status`: «енкодери: 4 з 4 доступні», вільна памʼять 353635 байт (≥ 345000); `help` має `enc [reset]`; `enc` — 4 колеса, нулі, 0.0 об/хв | AC-08, cli.md |
| 2 | вперед / назад, імп: RR +27728 / −26, FR +27736 / −99 — у допуску; RL +28431 (10.26 об, +2.6 %) / 794, FL +29128 (10.51 об, +5.1 %) / 1309 — поза ±2 %. Знак «вперед = плюс» на всіх чотирьох; інші колеса — 0 (FL раз 1 імп) | AC-01, AC-03 |
| 3 | повний стік уперед: FL 155.8 / 156.9, FR 136.4 / 136.4, RL 153.7 / 153.7, RR 138.5 / 145.0 об/хв (найбільша різниця 4.7 %); після зупинки всі 0.0, лічильники збереглися; приріст FL між знімками 59024 імп проти розрахункових 59087 (0.1 %) | AC-02, AC-04 |
| 4 | назад: усі чотири швидкості відʼємні; розворот праворуч: FL +156.6, RL +153.3, FR −138.0, RR −144.6 об/хв | AC-03 |
| 5 | вперед: кожне колесо понад 100 000 імп за 17.9 с (FL 124656, FR 111381, RL 123725, RR 112692), лише зростання, ≈ 10 переходів межі ±30000 без стрибків; приріст між знімками — у межах 1.5 % від розрахунку; назад: лише спадання до −139034 / −120882 / −137318 / −123449. Скидання апаратного лічильника на межі (ADR-0002) підтверджено | AC-04 |
| 6 | лише лівий борт (5 × `drive 0.375 0.375`): FR, RR — 0 імп, 0.0 об/хв; лише правий (5 × `drive 0.375 -0.375`): FL, RL — 0 імп | AC-05 |
| 7 | 169113 → 209933 мс (40.8 с): інтервалів +2041 = 40820 / 20 рівно | spec §6 |
| 8 | `enc reset` під час руху: «лічильники й відстань обнулено: FL, FR, RL, RR», лічильники з нуля ростуть, швидкість без стрибка (118.0 → 116.9 об/хв), переходів стану немає | AC-09 |
| 9 | 1 м на підлозі: FL 99.7, FR 97.8, RL 99.4, RR 98.6 см, середнє **98.9 см** (−1.1 %) | AC-06 |
| 10 | KPI, об/хв (FL, FR, RL, RR): 0.25 — 48.7, 30.3, 45.5, 30.3; 0.5 — 101.7, 80.1, 98.5, 86.6; 0.75 — 155.8, 134.2, 153.7, 140.7 | spec §7 |
| 11 | `enc foo`, `enc Reset`, `enc reset x` — три різні тексти з причиною й обома формами | AC-07 |
| 12 | ≈ 51 с руху з пульта: «затримка кадр → борти» макс 15 мс (≤ 50); за всі кроки — не більше 20 мс | spec §6 |
| 13 | ARMED → FAILSAFE («втрата звʼязку»), `enc reset`, колесо рукою: RR +2436 імп (0.88 об), інші 0; `status` — FAILSAFE, «енкодери: 4 з 4 доступні» | AC-03 |

### Відхилення і залишки

1. **Крок 2, FL і RL поза ±2 %.** Рух назад в обох ≈ 10.0 об (FL 27819, RL 27637 імп), тобто зайве пішло на руху вперед: ≈ 0.5 і 0.26 об. На підлозі (крок 9) FL і RL проходять 99.7 і 99.4 см — нарівні з FR і RR (97.8 і 98.6), а ліві колеса на однаковій команді дають близькі між собою швидкості. Тож лічильник рахує правильно, а відхилення — це похибка ручного обертання. **Рішення Розробника (2026-10-19): прийнято як є, без повтору.**
2. **Рядок журналу старту** «енкодери: 4 з 4 доступні, вибірка кожні 20 мс» у надісланому журналі відсутній. Доступність підтверджує `status` (крок 1, крок 13).
3. **Спостереження: двічі «Невідома команда»** (кроки 9 і 12). Рядок журналу розірвав набраний `enc`, Розробник набрав `enc` ще раз, не надіславши першого, і консоль отримала `encenc` / `eenc`. Дефекту прошивки тут немає; повторний `enc` відповідав.
4. **Спостереження: мітка знімка іноді раніша за попередній рядок журналу** — на кроці 8 до ≈ 0.6 с, на кроці 4 ≈ 0.25 с. Знімок береться в момент обробки команди, а друкує його консольна задача з найнижчим пріоритетом, тож друк відстає. На допуски це не впливає.
5. **Розкид бортів (KPI, для фази 5):** правий борт повільніший за лівий на 0.75 на ≈ 11 % (137.5 проти 154.8 об/хв), на 0.5 — на ≈ 17 %, на 0.25 — на ≈ 36 %. FR на 0.25 дає ≈ 28 імп за інтервал (≥ 20), тож це не несправність за AC-02.
