12romis/esp32-elrs-rover/docs/features/phase0-skeleton/acceptance.md

# Приймання фази 0 на залізі — чек-лист Розробника

Виконує **Розробник**: прошиває плату через розширення ESP-IDF у VS Code, читає монітор, вимірює мультиметром. Агент нічого не прошиває й не комітить без вказівки. Результати йдуть у журнал bring-up (дата, результат, значення); виміри — у `docs/measured.md`. Агент ці два файли не редагує.

Підготовка: плата з модулем мікроконтролера (моторні шлейфи не підключені — пункт 12 конституції), USB-кабель до порту консолі (USB-Serial-JTAG), монітор відкритий **до** подачі живлення, щоб не втратити початок журналу (AC-01 від цього не залежить, але зручніше).

## 1. Старт і стан (AC-01) — запис 1 з 4

1. Подайте живлення або скиньте плату.
2. Очікування в журналі: стан BOOT, далі переходи `BOOT -> SELFTEST` і `SELFTEST -> DISARMED`, повідомлення про сховище («в порядку»), «консоль готова».
3. Введіть `status`: стан DISARMED, у «історії переходів» ті самі два переходи.
4. Запишіть: дата, «старт до DISARMED — так/ні».

## 2. Консоль (AC-02, AC-03, AC-13) — запис 2 з 4

| Крок | Введіть | Очікування |
|---|---|---|
| 1 | `help` | список: help, status, reboot, wdt-test |
| 2 | `status` | стан, час роботи, вільна внутрішня памʼять, причина скидання, сховище, історія |
| 3 | `foo` | «Невідома команда…», консоль працює |
| 4 | `HELP` | «Невідома команда…» (регістр розрізняється) |
| 5 | `status foo` | відмова: команда не приймає аргументів |
| 6 | порожній рядок / лише пробіли | нічого не друкується |
| 7 | рядок із 65 символів | «Рядок задовгий (максимум 64)…», нічого не виконано |
| 8 | `reboot` | попередження, плата перезавантажується, повторний старт до DISARMED, `status` називає причину `SW` (AC-13) |

Додатково перевірте (ризик USB-Serial-JTAG, sad §11): введені символи видно (ехо), після кожної команди немає зайвого порожнього рядка, повідомлення «Перезавантаження плати...» встигає з'явитися до рестарту. Якщо ні — повідомте: можливо, потрібно змінити спосіб читання/виводу в `console_hal.c`.

Запишіть: усі кроки як очікувалось / відхилення.

## 3. Сторожовий таймер (AC-04) — запис 3 з 4

1. У стані DISARMED введіть `wdt-test`.
2. Консоль попереджає про перезавантаження; зафіксуйте за часовими мітками журналу монітора час від команди до нового старту (секундомір).
3. Очікування: перезавантаження ≤ 6 с (таймаут 5 с); у журналі панічне повідомлення Task WDT і, після старту, `причина останнього скидання: TASK_WDT`; `status` називає ту саму причину.
4. Запишіть: час у секундах, причина скидання.

Примітка: стани, відмінні від DISARMED, на залізі недосяжні, тому відмова `wdt-test`/`reboot` за станом (AC-05) перевіряється лише хостовим тестом (`test/host/run_tests.sh`).

## 4. STBY низький (AC-07) — запис 4 з 4

1. Мультиметром виміряйте напругу на лінії STBY (GPIO21, притяжка R16) під час роботи у стані DISARMED і під час виконання `help`, `status`, `reboot`, `wdt-test`.
2. Очікування: ~0 В весь час. Прошивка не налаштовує ліній моторів (огляд коду: `grep -rnE "gpio_config|ledc|i2c|PIN_" main components/{app_state,rover_console,watchdog,storage}` порожній).
3. Запишіть: напруга, «STBY низький — так/ні».

## 5. Стабільність 10 хвилин (NFR)

Залиште плату в DISARMED на 10 хв з відкритим монітором. Очікування: жодного неочікуваного скидання. Запишіть результат.

## 6. Вільна памʼять → `docs/measured.md` (NFR, spec §7)

Значення «вільна внутрішня памʼять» зі `status` після старту запишіть у `docs/measured.md` (baseline P0: 393135 байт). Поріг прийнятності — відкрите питання OQ-1 специфікації.

## 7. Пошкоджене сховище (AC-12) — очікує OQ-6

Спосіб відтворити «пошкоджене сховище» на залізі ще не визначений (spec §8, OQ-6). Крок відкладено: AC-12 на залізі приймається, коли спосіб буде погоджено. Хостовий тест політики очищення (`test/host/test_storage.c`) уже покриває рішення.

## Що не виконує Агент

Прошивання, мультиметр, секундомір, запис у журнал bring-up і `docs/measured.md`, фіксація змін в історії.
