12romis/esp32-elrs-rover/docs/features/phase7-telemetry/adr/0002-derive-hold-indication-in-ui-core-from-state-and-control-sector-flags.md

---
status: Accepted
owner: "Розробник проєкту"
reviewers: ["Розробник проєкту"]
updated_at: "2026-10-21"
feature_size: "S"
ticket: "phase7-telemetry"
---

# 0002 — Derive the hold indication in ui_core from the state and the control sector flags

- **Status:** Accepted
- **Date:** 2026-10-21
- **Deciders:** Розробник, Агент (design, рівень easy)

## Context

Індикацію утримання перед перешкодою (spec US-03, US-04) показують три виконавці: зумер, індикатор плати і світло. Задача `ui` (100 мс) знає лише стан автомата й застосовані значення бортів. Сектори — передній чи задній зайнятий — вона не знає. Фаза 6 (ADR-0004 phase6-tof, припущення A12) навмисно зробила перехід ARMED ↔ OBSTACLE_HOLD беззвучним, без примусових фар і без сигналу; запит Розробника 2026-10-21 це змінює частково: сигнал і блимання з'являються, примусового вмикання фар не з'являється.

## Decision drivers

- Індикація лише відображає стан і не керує ровером (spec Goals; QG-2).
- Сектор, що блимає, збігається з тим, що обмежило тягу: розбіжності «світло каже одне, ровер робить інше» бути не повинно.
- Логіка (послідовність біпа, фаза блимання, пріоритети) тестується на хості (конституція, п. 6).
- Мінімум нових залежностей між компонентами.

## Considered options

1. **`control` публікує у `drive_status_t` два прапорці зайнятості секторів (`occ_front`, `occ_rear`) — ті, що вона сама використала в такті, без умови стану (умову «лише в OBSTACLE_HOLD» накладає `ui_core`); `ui_hal` читає їх разом із бортами, `ui_core` ухвалює все показане.**
2. **`ui_hal` читає знімок `tof_snapshot_get` сам:** другий незалежний читач; прапорці можуть розійтися з рішенням `control` на такт.
3. **`control` прямо командує `ui` (черга подій «вхід/вихід/сектор»):** подія може загубитися або запізнитись, зв'язує `drive` із `ui` у зворотний бік.

## Decision outcome

**Chosen:** варіант 1. `drive_hal` кладе `ctl.occ_front` і `ctl.occ_rear` у знімок статусу; `ui_hal` додає їх до `ui_in_t`. У `ui_core`: подвійний біп як автоматичний сигнал (послідовність за часом від старту, нова подія не стартує, поки звучить попередня), жовтий індикатор у стані OBSTACLE_HOLD, фаза блимання від входу в стан з півперіодом 250 мс; блимання перекриває вихід фар або задніх ліхтарів, а ручний стан фар зберігається й повертається. Ця зміна заміщає в ADR-0004 phase6-tof лише правила «ARMED ↔ OBSTACLE_HOLD без сигналу» і «DISARMED → OBSTACLE_HOLD дає сигнал як озброєння»; правило «не вмикає фари примусово» лишається.

## Consequences

**Positive**
- Одне джерело істини про сектор; жодних нових залежностей `ui` від `tof`.
- Уся логіка індикації у `ui_core`, покривається хостовими тестами з підставним годинником.

**Negative**
- Змінюється `drive_status_t` (поле читають `ui` і консоль) і низка тестів `test_ui.c`.
- Прапорці належать до такту `control` (20 мс), а `ui` опитує раз на 100 мс: короткі зайнятості (< 100 мс) можуть бути не видні.

**Neutral**
- Таблиця переходів автомата не змінюється (12 пар).

## Links

- Spec: [[../spec.md]] US-03, US-04, US-05; AC-06…AC-16; A5–A12, A14
- SAD: [[../sad.md]] §4, §5, §6, §8
- Related ADR: phase6-tof ADR-0004 (частково заміщається), phase2-io ADR-0002 (ui_core, задні ліхтарі)
