12romis/esp32-elrs-rover/docs/features/phase7-telemetry/tasks/t2-ui-core-double-beep-and-yellow-indicator.md

---
id: T2
title: "Навчити ui_core подвійному біпу на вході в OBSTACLE_HOLD і на виході в ARMED, жовтому індикатору й пріоритетам сигналів"
layer: "domain"
deps: []
blocks: ["T3", "T7"]
acs: ["AC-06", "AC-07", "AC-08", "AC-09", "AC-15", "AC-16", "AC-19"]
files_hint: ["components/ui/ui_core.c", "components/ui/include/ui_core.h", "test/host/test_ui.c"]
owner: "Агент"
estimate: "M"
context_budget: "M"
status: "done"
step: "GATE (без коміту: CLAUDE.md)"
---

# T2 — Навчити ui_core подвійному біпу на вході в OBSTACLE_HOLD і на виході в ARMED, жовтому індикатору й пріоритетам сигналів

## Place in the sequence

- **Blocked by:** — · **Blocks:** T3 — Навчити ui_core блиманню фар при зайнятому передньому секторі й задніх ліхтарів при зайнятому задньому в OBSTACLE_HOLD, T7 — Підключити в ui_hal прапорці секторів, жовтий колір індикатора й колір у ui_hal_status_t · **Wave:** 1.
- **Lane:** shares `components/ui/include/ui_core.h, components/ui/ui_core.c, test/host/test_ui.c` with T3 — serialized.

## Why (user story)

> **As a** Розробник
> **I want** щоб вхід в OBSTACLE_HOLD і вихід з нього в ARMED супроводжувались подвійним бібом, а на час утримання індикатор плати світив жовтим
> **So that** я помічаю, що ровер не їде вперед через перешкоду, а не через поломку, навіть не дивлячись на нього
>
> — `spec.md §4, US-03, verbatim` · full text: [spec.md](../spec.md)

> **As a** Розробник
> **I want** щоб індикація й телеметрія не змінювали інваріантів безпеки, не затримували керування й не ламалися від відмови розширювача портів чи приймача
> **So that** корисна «лампочка» не стає ще одним способом зламати ровер
>
> — `spec.md §4, US-05, verbatim` · full text: [spec.md](../spec.md)

Задача дає звукову й кольорову частини індикації та заміну беззвучного переходу фази 6.

## Inlined context

> A5. Подвійний біп: звук 100 мс, пауза 100 мс, звук 100 мс (разом 300 мс) на частоті автоматичних сигналів 1000 Гц із журналу вимірювань (P9). Тривалість звуку дорівнює наявному сигналу переходу (100 мс).
>
> — `spec.md §1, A5, verbatim` · full text: [spec.md](../spec.md)

> A6. Подвійний біп лунає на кожному видимому для ui вході в OBSTACLE_HOLD, зокрема коли озброєння відбулося біля вже зайнятого сектору (ui бачить DISARMED → OBSTACLE_HOLD): тоді він замінює одинарний сигнал озброєння. На виході лунає лише при поверненні в ARMED; при виході в DISARMED лунає звичайний одинарний сигнал DISARMED, у FAILSAFE — звичайні сигнали FAILSAFE, а подвійний біп, що лунає в цей момент, переривається. Рішення власника: біп на виході лише в ARMED.
>
> — `spec.md §1, A6, verbatim` · full text: [spec.md](../spec.md)

> A7. Подвійні біпи не накладаються: якщо один уже звучить, нова подія подвійного біпа не стартує і не ставиться в чергу. Сигнали DISARMED і FAILSAFE мають пріоритет і замінюють подвійний біп. Подвійний біп для правила одного слота ручного `beep` — автоматичний сигнал, як сигнали переходів: ручний `beep`, поданий в ARMED під час нього, чекає в слоті й не вкорочує біп (в OBSTACLE_HOLD ручний `beep` відхиляється). Ручні команди зумера й світла в OBSTACLE_HOLD, як і в фазах 2 і 6, відхиляються.
>
> — `spec.md §1, A7, verbatim` · full text: [spec.md](../spec.md)

> A8. Індикатор плати в OBSTACLE_HOLD світить жовтим увесь час стану (червоний і зелений канали разом на перевіреному рівні 40, порядок байтів GRB із журналу вимірювань P8); поза утриманням гасне, у FAILSAFE світить червоним (червоний має пріоритет). Працює й тоді, коли розширювач портів недоступний.
>
> — `spec.md §1, A8, verbatim` · full text: [spec.md](../spec.md)

> A14. Ця специфікація замінює припущення A12 фази 6 та ті частини ADR-0004 phase6-tof, де перехід ARMED ↔ OBSTACLE_HOLD «не дає сигналу переходу» і де вхід DISARMED → OBSTACLE_HOLD «дає сигнал як озброєння» (тепер подвійний біп, A6); хостові тести ui (`test_ui.c`: «ARMED → OBSTACLE_HOLD без сигналу», «OBSTACLE_HOLD → ARMED без сигналу й без примусових фар», `test_disarmed_to_hold_is_arming`) змінюються разом із кодом. Частина ADR-0004 про відсутність примусового вмикання фар лишається в силі (A11). Новий ADR, що замінює відповідну частину, зафіксує `design`.
>
> — `spec.md §1, A14, verbatim` · full text: [spec.md](../spec.md)

> **Chosen:** варіант 1. `drive_hal` кладе `ctl.occ_front` і `ctl.occ_rear` у знімок статусу; `ui_hal` додає їх до `ui_in_t`. У `ui_core`: подвійний біп як автоматичний сигнал (послідовність за часом від старту, нова подія не стартує, поки звучить попередня), жовтий індикатор у стані OBSTACLE_HOLD, фаза блимання від входу в стан з півперіодом 250 мс; блимання перекриває вихід фар або задніх ліхтарів, а ручний стан фар зберігається й повертається. Ця зміна заміщає в ADR-0004 phase6-tof лише правила «ARMED ↔ OBSTACLE_HOLD без сигналу» і «DISARMED → OBSTACLE_HOLD дає сигнал як озброєння»; правило «не вмикає фари примусово» лишається.
>
> — `adr/0002-derive-hold-indication-in-ui-core-from-state-and-control-sector-flags.md, Decision outcome, verbatim` · full text: [adr/](../adr/)

> **Також (дослівно зі spec §6):** вплив виміру такту на період керування — 0 нових блокуючих викликів, період 20 мс тримається очікуванням до моменту (огляд коду; `check_delays.sh`); шина периферії 100 кГц (`check_bus_rules.sh`).
>
> — `sad.md §10, QG-1, verbatim` · full text: [sad.md](../sad.md)

**Fallback:** insufficient or contradicted by the code → read the named file in full ([spec.md](../spec.md) · [sad.md](../sad.md) · [adr/](../adr/)) and follow it. Do not guess.

## Data delta

No DB changes.

## API contract

Internal — no API surface.

## Acceptance criteria

### AC-06 — happy path

> **Given** ровер озброєний, їде вперед, передній сектор вільний
> **When** ровер наближається до перешкоди ближче за поріг перешкоди і переходить в OBSTACLE_HOLD
> **Then** зумер подає два короткі сигнали підряд, а індикатор плати світить жовтим весь час, поки ровер у цьому стані
>
> — `spec.md §5, AC-06, verbatim` · full text: [spec.md](../spec.md)

### AC-07 — happy path

> **Given** ровер в OBSTACLE_HOLD, індикатор плати жовтий
> **When** перешкода зникає, обидва сектори стають вільними і ровер повертається в ARMED
> **Then** зумер подає два короткі сигнали підряд, а індикатор плати гасне
>
> — `spec.md §5, AC-07, verbatim` · full text: [spec.md](../spec.md)

### AC-08 — domain invariant

> **Given** ровер в OBSTACLE_HOLD, індикатор плати жовтий
> **When** Розробник роззброює ровер, або пульт втрачає звʼязок довше за допустиме, або напруга падає нижче відсічки
> **Then** подвійний біп не лунає: на роззброєнні подається звичайний одинарний сигнал DISARMED, а в аварійній зупинці — звичайні сигнали FAILSAFE; індикатор плати в аварійній зупинці червоний, а не жовтий, і ніякий звук утримання не маскує сигналів аварійної зупинки
>
> — `spec.md §5, AC-08, verbatim` · full text: [spec.md](../spec.md)

### AC-09 — cross-context

> **Given** ровер у DISARMED і перед ним лежить перешкода ближче за поріг перешкоди
> **When** Розробник озброює ровер
> **Then** ровер одразу в OBSTACLE_HOLD і не їде вперед; зумер подає подвійний біп замість одинарного сигналу озброєння, індикатор плати світить жовтим, а фари блимають, бо зайнятий передній сектор
>
> — `spec.md §5, AC-09, verbatim` · full text: [spec.md](../spec.md)

### AC-15 — authorization

> **Given** ровер в OBSTACLE_HOLD з автоматичною індикацією
> **When** Розробник вводить з консолі команду світла чи зумера
> **Then** команду відхилено з поясненням, що в цьому стані ручне керування світлом і зумером заборонене, як і в фазі 6, а автоматична індикація не змінилась
>
> — `spec.md §5, AC-15, verbatim` · full text: [spec.md](../spec.md)

### AC-16 — cross-context

> **Given** ровер їде біля перешкоди на межі порога, і сектор кілька разів поспіль стає зайнятим та вільним
> **When** подвійний біп уже звучить, а виникає нова подія входу чи виходу
> **Then** нова подія не накладається на звучний біп і не вкорочує його, звуки не зливаються в один тривалий; ровер не зависає, а керування й захист не залежать від зумера
>
> — `spec.md §5, AC-16, verbatim` · full text: [spec.md](../spec.md)

### AC-19 — happy path

> **Given** Агент завершив зміну в межах фази 7
> **When** Агент запускає збірку проєкту і прогін хостових тестів
> **Then** збірка завершується без помилок і без нових попереджень, а прогін повідомляє кількість тестів і що всі пройдені; серед них перевірено: перетворення напруги в значення кадру (округлення до найближчого 0.1 В, межі, відсутній і застарілий знімок), побудову кадру з нульовими струмом, ємністю й відсотком, статистику часу кроку (перший вимір, найбільше, середнє, перевищення періоду), послідовність подвійного біпа (100 мс, пауза 100 мс, 100 мс), вхід, вихід в ARMED, відсутність подвійного біпа на виходах в DISARMED і FAILSAFE, заміну одинарного сигналу озброєння біля зайнятого сектору, відсутність накладання біпів, жовтий індикатор у утриманні й червоний у FAILSAFE, блимання фар за переднім сектором і задніх ліхтарів за заднім, синхронність при обох секторах, повернення ручного стану фар, роботу без розширювача, і те, що таблиця переходів автомата лишилась із 12 пар
>
> — `spec.md §5, AC-19, verbatim` · full text: [spec.md](../spec.md)

## Checklist

- [x] `components/ui/include/ui_core.h`: `UI_IND_YELLOW` у `ui_indicator_t`; константи подвійного біпа (звук 100 мс, пауза 100 мс) — частота `signal_hz` з `ui_calib.h`; стан послідовності в `ui_core_t`
- [x] `components/ui/ui_core.c`: подвійний біп на вході в OBSTACLE_HOLD (зокрема видимому з DISARMED, замість одинарного сигналу озброєння) і на виході в ARMED; не стартує, поки звучить подвійний біп; сигнали DISARMED і FAILSAFE його замінюють; ручний `beep` лягає в слот (подвійний біп — автоматичний сигнал)
- [x] Індикатор: жовтий весь час OBSTACLE_HOLD, червоний у FAILSAFE (пріоритет), інакше погашений
- [x] Змінити `test/host/test_ui.c`: тести «ARMED → OBSTACLE_HOLD без сигналу», «OBSTACLE_HOLD → ARMED без сигналу й без примусових фар» (фари: без змін), `test_disarmed_to_hold_is_arming` — під нові правила A6; нові тести послідовності, пріоритетів, накладання, слота; регресія AC-15 (ручні команди в OBSTACLE_HOLD відхилені)

## Edge cases

| Case | Behaviour |
|---|---|
| Вхід в OBSTACLE_HOLD, поки звучить подвійний біп | нова подія не стартує і не ставиться в чергу |
| Вихід у DISARMED під час подвійного біпа | біп перервано, звучить одинарний сигнал DISARMED |
| Вихід у FAILSAFE під час подвійного біпа | біп перервано, звучать сигнали FAILSAFE, індикатор червоний |
| Озброєння біля зайнятого сектору (DISARMED → OBSTACLE_HOLD) | подвійний біп замість одинарного сигналу озброєння; фари вмикаються як при вході в рух |
| Ручний `beep` в ARMED під час подвійного біпа | лягає в слот, біп не вкорочує; в OBSTACLE_HOLD відхиляється |
| Частота автосигналів не задана (0) | автоматичних звуків немає, як і раніше |

## Definition of Done

- [x] хостові тести ui проходять (оновлені й нові), `ui_core.c` без заголовків ESP-IDF, збірка без нових попереджень
- [x] кожне Hard Rule вище лишається дійсним (інваріанти п. 7 конституції не зачеплено)
- [x] збірка без нових попереджень
