12romis/esp32-elrs-rover/docs/features/phase6-tof/tasks/t11-tof-hal-sensors-task-snapshot-reinit.md

---
id: T11
title: "Додати в tof_hal задачу sensors: опитування раз на 50 мс, знімок під portMUX, відмова за 250 мс, tof reinit у DISARMED"
layer: "infra"
deps: ["T10"]
blocks: ["T12", "T13"]
acs: ["AC-06", "AC-08", "AC-09"]
files_hint: ["components/tof/tof_hal.c", "components/tof/include/tof_hal.h"]
owner: "Агент"
estimate: "M"
context_budget: "M"
status: "done"
step: "COMMIT"
---

# T11 — Додати в tof_hal задачу sensors: опитування раз на 50 мс, знімок під portMUX, відмова за 250 мс, tof reinit у DISARMED

## Place in the sequence

- **Blocked by:** T10 — Створити tof_hal: драйвер VL53L0X (порт p4_tof.c), послідовність XSHUT з новими адресами, виняток у check_delays · **Blocks:** T12 — Підключити далекоміри до drive_hal: знімок у кроці, запит OBSTACLE_HOLD ↔ ARMED без pid_hal_arm_begin, журнал, предикат у журналі й лічильнику затримки, T13 — Підключити в main старт tof і колбеки консолі tof_show та tof_reinit · **Wave:** 4.
- **Lane:** спільні файли: T10 (`components/tof/include/tof_hal.h`, `components/tof/tof_hal.c`) — серіалізовано.

## Why (user story)

> **As a** Розробник
> **I want** щоб вийнятий, непідключений чи завислий далекомір не зупиняв і не вішав прошивку, а я бачив це в консолі й міг повернути датчик у роботу в DISARMED
> **So that** одна відмова не виводить ровер з ладу, а сліпу зону я бачу і виправляю
>
> — `spec.md §4, US-03, verbatim` · full text: [spec.md](../spec.md)

Ця задача дає живе опитування далекомірів без впливу на такт керування та повернення відмовившого датчика командою.

## Inlined context

> **Chosen:** варіант 1. Затримка шини лишається на core 0; `control` лише копіює знімок і за віком (> 250 мс або `valid == false`) розуміє, що сектори не охороняються. Відмова датчика — 250 мс без валідного відліку (відлік «поза діапазоном» валідний), діагностується в `tof_core`;
>
> — `adr/0003-poll-rangefinders-in-a-separate-sensors-task-and-detect-failure-there.md, Decision outcome, abridged` · full text: [adr/0003-poll-rangefinders-in-a-separate-sensors-task-and-detect-failure-there.md](../adr/0003-poll-rangefinders-in-a-separate-sensors-task-and-detect-failure-there.md)

> - Задача `sensors`: core 0, prio 3, період 50 мс через `vTaskDelayUntil` (документ 02 §6.1), стек 4096; у Task WDT не підписана — Decision override у §1 (завислу задачу обробляє вік знімка).
>
> — `sad.md §4, журнал припущень design, bullet «Задача sensors», verbatim` · full text: [sad.md](../sad.md)

> - Повторна ініціалізація (`tof reinit`): консоль через колбек ставить запит у `sensors` і чекає до 3 с; на цей час опитування решти датчиків призупиняється (ініціалізація датчика містить очікування до 500 мс, P4), а після завершення лічильники відмови решти скидаються, щоб пауза не дала хибних відмов (послаблення spec AC-08, рішення власника на design); задача опускає XSHUT усіх відмовивших, потім піднімає їх по одному за тією ж послідовністю; між датчиками перевіряє `app_state_get() == DISARMED` і зупиняється, якщо стан змінився; світло не торкається, бо байт пише `ioexp` із збереженням біт світла.
>
> — `sad.md §4, журнал припущень design, bullet «Повторна ініціалізація», verbatim` · full text: [sad.md](../sad.md)

> Якщо `sensors` завис, `control` не чекає на нього: за віком знімка понад 250 мс він вважає сектори такими, що не охороняються, пише одне попередження і далі їде за стіком; ровер, що стояв в OBSTACLE_HOLD через завислі дані, повертається в ARMED. Свіжий знімок знімає це одним рядком про відновлення (гілка AC-06, ADR-0003).
>
> — `sad.md §6, «Flow 8: завислий sensors і застарілий знімок», потік 8, verbatim` · full text: [sad.md](../sad.md)

> | Затримка «кадр пульта → борти» | ≤ 20 мс максимум, зокрема з опитуванням далекомірів і трасуванням (фаза 4: макс 15 мс) | діагностичні мітки часу фази 3 в журналі монітора |
>
> — `spec.md §6, NFR «Затримка кадр → борти», verbatim` · full text: [spec.md](../spec.md)

> **Hard rule:** 14. Шина I²C працює на 100 кГц, підвищувати до 400 кГц заборонено (розділ 4.6 документа `02-FIRMWARE-CONTEXT.md`). Усі періодичні задачі використовують `vTaskDelayUntil`, а не `vTaskDelay` (розділ 8.5).
>
> — `constitution.md, п. 14, verbatim` · full text: [constitution.md](../../../constitution.md)

**Fallback:** insufficient or contradicted by the code → read the named file in full ([spec.md](../spec.md) · [sad.md](../sad.md) · [adr/](../adr/) · [measured.md](../../../measured.md)) and follow it. Do not guess.

## Data delta

No DB changes.

## API contract

Internal — no API surface.

## Acceptance criteria

### AC-06 (US-03) — error

> **Given** ровер їде вперед, озброєний з пульта, усі чотири далекоміри справні, перед ровером немає перешкод
> **When** Розробник на ходу виймає шлейф одного далекоміра, в окремих заїздах — по черзі кожного з чотирьох; в одному з заїздів після відмови одного переднього далекоміра ровер їде до стіни, яку бачить інший, справний передній
> **Then** прошивка не зависає й не перезавантажується (час від старту плати в `status` не скидається), затримка «кадр пульта → борти» лишається в межах §6, стіки, мотори й озброєння працюють; не пізніше ніж через 0.5 с у журналі зʼявляється одне попередження з назвою далекоміра та його місцем, команда `tof` показує «відмова», а сектор не вважається зайнятим через цей далекомір; перешкода перед справним далекоміром усе ще зупиняє ровер (AC-01); якщо ровер був у OBSTACLE_HOLD через цей далекомір, він повертається в ARMED без дій Розробника; поки сектор лишається без жодного справного далекоміра, попередження каже, що сектор не охороняється
>
> — `spec.md §5, AC-06, verbatim` · full text: [spec.md](../spec.md)

### AC-08 (US-03) — cross-context

> **Given** ровер у DISARMED, один далекомір у відмові (AC-06 чи AC-07), шлейф підключено назад; фари увімкнено вручну, а задній ліхтар вимкнено
> **When** Розробник подає команду повторної ініціалізації далекомірів
> **Then** далекомір повертається в роботу: консоль підтверджує, показ називає його справним з відстанню, а фари не гаснуть і не блимають, ліхтар не змінюється; на час команди (до 3 с, ровер стоїть) опитування решти справних далекомірів призупиняється, а після її завершення вони знову дають відстані без хибних відмов; якщо далекомір досі не відповідає, консоль називає його відмовившим, а все інше лишається без змін
>
> — `spec.md §5, AC-08, verbatim` · full text: [spec.md](../spec.md)

### AC-09 (US-03) — authorization

> **Given** ровер у будь-якому стані, крім DISARMED (BOOT, SELFTEST, ARMED, OBSTACLE_HOLD, FAILSAFE, FAULT)
> **When** Розробник подає команду повторної ініціалізації далекомірів
> **Then** команду відхилено з поясненням, що перезапуск далекомірів можливий лише в DISARMED, бо торкається ліній скидання на розширювачі портів; жоден далекомір, стан автомата, світло й команди бортам не змінюються
>
> — `spec.md §5, AC-09, verbatim` · full text: [spec.md](../spec.md)

## Checklist

- [ ] Задача `sensors`: core 0, prio 3, стек 4096, період 50 мс через `vTaskDelayUntil`; не підписана на Task WDT (Decision override у SAD §1) — `components/tof/tof_hal.c`
- [ ] У циклі: для кожного справного датчика прочитати готовий відлік → `tof_core_sample`; `tof_core_tick`; публікація `tof_view_t` під `portMUX` — `components/tof/tof_hal.c`
- [ ] `tof_snapshot_get` копіює знімок під `portMUX` — `components/tof/tof_hal.c`
- [ ] Одне попередження на зміну (відмова/повернення датчика); після п'яти циклів, у яких не відповів жоден датчик, `i2c_bus_reset` під мʼютексом — `components/tof/tof_hal.c`
- [ ] `tof_reinit()`: запит у `sensors`, очікування до 3 с; задача опускає лінії відмовивших, піднімає по одному за послідовністю T10, між датчиками перевіряє `app_state_get() == APP_STATE_DISARMED` і перериває; опитування решти на цей час призупинено, після завершення `tof_core_resume` — `components/tof/tof_hal.c`
- [ ] Попередження «захист вимкнено» при озброєнні без справних датчиків — функція для `drive_hal` (T12) — `components/tof/include/tof_hal.h`

## Edge cases

| Case | Behaviour |
|---|---|
| Вийнятий шлейф на ходу | За 250 мс відмова, одне попередження, рух триває, затримка кадр→борти не змінилась |
| `sensors` не стартувала або зависла | Знімок старіє; `control` бачить вік (T5), не чекає |
| `tof reinit` у DISARMED, шлейф підключено | Датчик повертається, світло й адреси справних не змінюються |
| `tof reinit`, шлейф досі не підключено | Датчик названо відмовившим, решта без змін |
| Ровер озброєно під час `tof reinit` | Реініціалізація переривається при виході з DISARMED |
| Поки триває `tof reinit` (до 3 с) | Опитування решти призупинено без хибних відмов після завершення |
| Шина не відповідає жодному датчику п'ять циклів | Один `i2c_bus_reset`, не частіше ніж раз на п'ять циклів |

## Definition of Done

- [ ] `idf.py build` без помилок і нових попереджень
- [ ] `check_delays.sh` чистий
- [ ] HAL — приймання на залізі T15 (AC-06, AC-08, AC-09); хостового моку немає (пункт 6 конституції)
- [ ] Вільна внутрішня памʼять після старту ≥ 345000 байт (`status`)
- [ ] every Hard Rule inlined above still holds
