12romis/esp32-elrs-rover/docs/features/phase6-tof/tasks/t2-tof-core-limit-and-text.md

---
id: T2
title: "Додати в tof_core обмеження тяги пари бортів і тексти: показ датчиків і рядок входу в утримання"
layer: "domain"
deps: ["T1"]
blocks: ["T5"]
acs: ["AC-02", "AC-04", "AC-05", "AC-10", "AC-17"]
files_hint: ["components/tof/tof_core.c", "components/tof/include/tof_core.h", "test/host/test_tof.c"]
owner: "Агент"
estimate: "M"
context_budget: "M"
status: "done"
step: "COMMIT"
---

# T2 — Додати в tof_core обмеження тяги пари бортів і тексти: показ датчиків і рядок входу в утримання

## Place in the sequence

- **Blocked by:** T1 — Створити tof_core: медіана, сектори, зайнятість, звільнення, відмова датчика і калібрувальну константу порогу · **Blocks:** T5 — Вбудувати в drive_ctl_step знімок далекомірів: обмеження тяги після мікшера, запити ARMED ↔ OBSTACLE_HOLD, застарілий знімок · **Wave:** 2.
- **Lane:** спільні файли: T1 (`components/tof/include/tof_core.h`, `components/tof/tof_core.c`, `test/host/test_tof.c`) — серіалізовано.

## Why (user story)

> **As a** Розробник
> **I want** щоб при зайнятому секторі ровер виїжджав у вільний бік і розвертався на місці, а сам повертався до руху вперед, коли сектор звільнився
> **So that** я вибираюся з-перед перешкоди тим самим стіком, без роззброєння
>
> — `spec.md §4, US-02, verbatim` · full text: [spec.md](../spec.md)

Ця задача дає чисту функцію, що в бік зайнятого сектору обнуляє тягу, лишає поворот і дозволяє протилежний бік, та тексти для консолі й журналу.

## Inlined context

> - Обмеження руху: `tof_limit_sides(ліве, праве, передній зайнятий, задній зайнятий)` обчислює тягу = (ліве + праве)/2 і поворот = (ліве − праве)/2, обрізає тягу знизу нулем (передній) або зверху (задній) і повертає нову пару. Модуль нової пари не перевищує модуль початкової, тож межа 0.75 і насичення не порушуються. Викликається у `drive_ctl_step` після `drive_mix` (пульт) і після відновлення пари з вікна стендової команди, до стелі заданої швидкості, розгону й регулятора.
>
> — `sad.md §4, журнал припущень design, bullet «Обмеження руху», verbatim` · full text: [sad.md](../sad.md)

> - **Обмеження руху.** Передній сектор зайнятий → «тяга» мікшера не менша за нуль; задній → не більша за нуль; «поворот» не змінюється. Обмежений вихід мікшера далі йде через стелю заданої швидкості, плавний розгін і регулятор як у фазі 5, тож зупинка негайна, а старт плавний.
>
> — `spec.md §5, «Поведінка захисту», Обмеження руху, verbatim` · full text: [spec.md](../spec.md)

> **Chosen:** варіант 1. Одна точка обмеження після мікшера й після відновлення пари з вікна стендової команди робить захист однаковим для обох джерел, тестується на хості разом з рештою кроку й не додає нового писача виходів. Перехід стану просить той самий `control`, тож відсічка, втрата зв'язку й роззброєння мають перевагу в тому ж такті.
>
> — `adr/0001-apply-obstacle-limit-inside-control-step-from-tof-snapshot.md, Decision outcome, abridged` · full text: [adr/0001-apply-obstacle-limit-inside-control-step-from-tof-snapshot.md](../adr/0001-apply-obstacle-limit-inside-control-step-from-tof-snapshot.md)

> | Реакція на перешкоду | обидва борти отримують нуль ≤ 250 мс після першого відліку, меншого за поріг (опитування ≤ 50 мс, медіана з 3, такт керування 20 мс) | мітки часу в журналі, приймання AC-01 |
>
> — `spec.md §6, NFR «Реакція на перешкоду», verbatim` · full text: [spec.md](../spec.md)

> - Журнал: один рядок на подію (вхід в OBSTACLE_HOLD з сектором, мм і порогом; звільнення; відмова й повернення датчика; знімок застарів/відновився; результат старту кожного датчика; «захист вимкнено» на старті й при озброєнні, коли немає жодного справного); без рядків на кожен такт.
>
> — `sad.md §4, журнал припущень design, bullet «Журнал», verbatim` · full text: [sad.md](../sad.md)

**Fallback:** insufficient or contradicted by the code → read the named file in full ([spec.md](../spec.md) · [sad.md](../sad.md) · [adr/](../adr/) · [measured.md](../../../measured.md)) and follow it. Do not guess.

## Data delta

No DB changes.

## API contract

Internal — no API surface.

## Acceptance criteria

### AC-02 (US-01) — happy path

> **Given** та сама підготовка, що в AC-01, але стіни прямо попереду немає; на шляху ліворуч-вперед стоїть коробка так, що її бачить лише лівий передній далекомір, а прямий далекомір її не бачить
> **When** Розробник їде вперед стіком, поки коробка не опиниться в зоні лівого переднього далекоміра, а потім так само з коробкою праворуч-вперед і правим переднім далекоміром
> **Then** в обох заїздах ровер зупиняється в OBSTACLE_HOLD, консоль називає передній сектор і далекомір, що побачив перешкоду, і ровер не торкається коробки; прямий далекомір, який перешкоди не бачить, зупинку не блокує й не запускає
>
> — `spec.md §5, AC-02, verbatim` · full text: [spec.md](../spec.md)

### AC-04 (US-02) — happy path

> **Given** ровер у OBSTACLE_HOLD, передній сектор зайнятий, ззаду вільно
> **When** Розробник тримає стік уперед і праворуч одночасно, а потім лише праворуч
> **Then** у першому випадку складова «тяга» дорівнює нулю, а «поворот» лишається: ровер розвертається на місці праворуч (лівий борт уперед, правий назад, однакові за модулем швидкості); у другому — так само; коли після повороту передній сектор вільний, автомат повертається в ARMED і стік уперед знову везе ровер уперед
>
> — `spec.md §5, AC-04, verbatim` · full text: [spec.md](../spec.md)

### AC-05 (US-02) — domain invariant

> **Given** ровер озброєний, зайнятий задній сектор (стіна позаду ближче за поріг), передній вільний; окремо — зайняті обидва сектори
> **When** Розробник відводить стік назад, потім уперед, потім стік тільки вбік
> **Then** при зайнятому задньому секторі рух назад заборонений (нуль обом бортам), а рух уперед дозволений; при двох зайнятих секторах тяга в обидва боки дорівнює нулю, а поворот на місці працює; заборона рухатися в бік зайнятого сектора ніколи не виконується частково — ні плавним гальмуванням до порогу, ні дозволом проїхати «ще трохи»
>
> — `spec.md §5, AC-05, verbatim` · full text: [spec.md](../spec.md)

### AC-10 (US-04) — happy path

> **Given** ровер у будь-якому стані автомата
> **When** Розробник подає команду показу далекомірів
> **Then** консоль друкує для кожного з чотирьох далекомірів його місце (ліворуч-вперед, вперед, праворуч-вперед, назад), стан (працює, поза діапазоном, відмова) і відфільтровану відстань у міліметрах; для кожного сектору — відстань, і чи він зайнятий, вільний чи не охороняється; поріг перешкоди в міліметрах; чи діє захист; стан автомата, озброєння й команди бортам не змінюються
>
> — `spec.md §5, AC-10, verbatim` · full text: [spec.md](../spec.md)

### AC-17 (US-06) — happy path

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

## Checklist

- [ ] Реалізувати `tof_limit_sides(l, r, front_occ, rear_occ, &l_out, &r_out)`: тяга = (l + r)/2, поворот = (l − r)/2, тяга обрізається знизу нулем (передній) або зверху (задній), поворот без змін; модуль нової пари не перевищує початкової — `components/tof/tof_core.c`
- [ ] Реалізувати `tof_fmt_show` (датчик: місце, стан, відстань; сектор: відстань і зайнятий/вільний/не охороняється; поріг; чи діє захист) і `tof_fmt_hold_line` (сектор, відстань, датчик, поріг) — `components/tof/tof_core.c`
- [ ] Оголосити обидва в заголовку — `components/tof/include/tof_core.h`
- [ ] Додати в `test/host/test_tof.c` випадки «Edge cases» — `test/host/test_tof.c`

## Edge cases

| Case | Behaviour |
|---|---|
| Передній зайнятий, пара (0.5, 0.5) | Результат (0, 0) |
| Передній зайнятий, пара (0.3, −0.3) — чистий поворот | Без змін: поворот на місці дозволений |
| Передній зайнятий, пара (1.0, 0.2) | Тяга 0.6 → 0, поворот 0.4 лишається: результат (0.4, −0.4) |
| Задній зайнятий, пара (−0.5, −0.5) | Результат (0, 0); рух уперед (0.5, 0.5) не змінюється |
| Обидва зайняті | Тяга в обидва боки нуль, поворот працює |
| Жоден не зайнятий | Пара без змін |
| Будь-яка пара зі значень у [−1, 1] | Модуль кожного борту не збільшується (межа потужності і насичення не порушуються) |
| Показ: датчик у відмові, сектор без справних | Рядок називає «відмова» і «не охороняється»; число для відмовившого не друкується |

## Definition of Done

- [ ] `test/host/run_tests.sh` зелений, серед тестів — усі рядки «Edge cases»
- [ ] `check_core_headers.sh` чистий
- [ ] `idf.py build` без помилок і нових попереджень
- [ ] every Hard Rule inlined above still holds
