12romis/esp32-elrs-rover/docs/features/phase6-tof/tasks/t4-ioexp-core-xshut-bits.md

---
id: T4
title: "Розширити ioexp_core: біти ліній скидання далекомірів у тіньовому регістрі і збирання байта зі збереженням"
layer: "domain"
deps: []
blocks: ["T9"]
acs: ["AC-08", "AC-16", "AC-17"]
files_hint: ["components/ioexp/ioexp_core.c", "components/ioexp/include/ioexp_core.h", "test/host/test_ioexp.c"]
owner: "Агент"
estimate: "S"
context_budget: "M"
status: "done"
step: "COMMIT"
---

# T4 — Розширити ioexp_core: біти ліній скидання далекомірів у тіньовому регістрі і збирання байта зі збереженням

## Place in the sequence

- **Blocked by:** — · **Blocks:** T9 — Додати в ioexp_hal операцію зміни лінії скидання і внутрішній мʼютекс запису байта · **Wave:** 1.
- **Lane:** власна лінія.

## Why (user story)

> **As a** Розробник
> **I want** щоб вийнятий, непідключений чи завислий далекомір не зупиняв і не вішав прошивку, а я бачив це в консолі й міг повернути датчик у роботу в DISARMED
> **So that** одна відмова не виводить ровер з ладу, а сліпу зону я бачу і виправляю
>
> — `spec.md §4, US-03, verbatim` · full text: [spec.md](../spec.md)

Ця задача дає чисту логіку байта розширювача, що тримає лінії скидання датчиків, поки пишеться світло, тож датчики не втрачають адрес.

## Inlined context

> **Chosen:** варіант 1. Лише так розряди скидання пережили б перезапис раз на секунду без нового механізму: байт збирається в одному місці з копії світла й копії розрядів скидання, а підтвердження запису й повтор після збою лишаються логікою `ioexp`.
>
> — `adr/0002-let-ioexp-own-the-whole-expander-byte-including-the-sensor-reset-lines.md, Decision outcome, abridged` · full text: [adr/0002-let-ioexp-own-the-whole-expander-byte-including-the-sensor-reset-lines.md](../adr/0002-let-ioexp-own-the-whole-expander-byte-including-the-sensor-reset-lines.md)

> - `ioexp`: у `ioexp_t` додається маска стану розрядів скидання; `ioexp_prepare` підставляє її в байт;
>
> — `sad.md §4, журнал припущень design, bullet «ioexp», abridged` · full text: [sad.md](../sad.md)

> | Запис світла чи перезапис байта знову скидає лінії датчиків, якщо маска `ioexp` лишиться стара | High | ADR-0002; хостовий тест, що біти скидання переживають запис світла й перезапис; приймання AC-16 | Розробник |
>
> — `sad.md §11, ризик 1, verbatim` · full text: [sad.md](../sad.md)

> **Hard rule:** 7. Інваріанти безпеки, сильніші за будь-яку функціональність:    - STBY піднімається тільки в стані ARMED і тільки свідомо;    - втрата кадрів CRSF довша за 500 мс → ШІМ у нуль, STBY вниз;    - перша операція по I²C після старту — запис `0x00` у PCF8574;    - VBAT < 6.0 В → мотори не запускаються.
>
> — `constitution.md, п. 7, verbatim` · full text: [constitution.md](../../../constitution.md)

**Fallback:** insufficient or contradicted by the code → read the named file in full ([spec.md](../spec.md) · [sad.md](../sad.md) · [adr/](../adr/) · [measured.md](../../../measured.md)) and follow it. Do not guess.

## Data delta

No DB changes.

## API contract

Internal — no API surface.

## Acceptance criteria

### AC-08 (US-03) — cross-context

> **Given** ровер у DISARMED, один далекомір у відмові (AC-06 чи AC-07), шлейф підключено назад; фари увімкнено вручну, а задній ліхтар вимкнено
> **When** Розробник подає команду повторної ініціалізації далекомірів
> **Then** далекомір повертається в роботу: консоль підтверджує, показ називає його справним з відстанню, а фари не гаснуть і не блимають, ліхтар не змінюється; на час команди (до 3 с, ровер стоїть) опитування решти справних далекомірів призупиняється, а після її завершення вони знову дають відстані без хибних відмов; якщо далекомір досі не відповідає, консоль називає його відмовившим, а все інше лишається без змін
>
> — `spec.md §5, AC-08, verbatim` · full text: [spec.md](../spec.md)

### AC-16 (US-05) — cross-context

> **Given** ровер озброєний, фари й задні ліхтарі працюють, далекоміри опитуються
> **When** Розробник їде 60 с, кілька разів зупиняючись перед перешкодою, і робить кілька повторних ініціалізацій у DISARMED
> **Then** світло не блимає без причини, у журналі немає жодного попередження про помилку шини чи розширювача портів, а затримка «кадр пульта → борти» не перевищує межу §6; шина працює на 100 кГц
>
> — `spec.md §5, AC-16, verbatim` · full text: [spec.md](../spec.md)

### AC-17 (US-06) — happy path

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

## Checklist

- [ ] Додати в `ioexp_t` поле бажаних розрядів скидання та `IOEXP_XSHUT_MASK` (біти 0, 1, 2, 4) — `components/ioexp/include/ioexp_core.h`
- [ ] Додати `ioexp_xshut_set(e, bit, high)` (лише чотири розряди, інакше false) і `ioexp_xshut_revert(e)` (повернути бажані розряди до підтверджених) — `components/ioexp/ioexp_core.c`
- [ ] Змінити `ioexp_prepare`: байт = біти світла під маскою | бажані розряди скидання; змінити `ioexp_needs_write` відповідно — `components/ioexp/ioexp_core.c`
- [ ] Оновити коментар про «розряди скидання завжди 0»: тепер лише до першого запису нуля — `components/ioexp/include/ioexp_core.h`
- [ ] Написати тести за «Edge cases» — `test/host/test_ioexp.c`

## Edge cases

| Case | Behaviour |
|---|---|
| Запис світла при піднятих розрядах скидання | Байт містить і біти світла, і розряди скидання без змін |
| Щосекундний перезапис | Той самий байт зі збереженням розрядів скидання |
| Старт: перший запис 0x00 | Усі розряди нуль; розряди скидання бажані 0 |
| `ioexp_xshut_set` для біта світла чи біта 7 | false, нічого не змінено |
| Запис не підтверджено після підняття розряду | `ioexp_xshut_revert` повертає бажані розряди до підтверджених |
| Розширювач недоступний | `ioexp_prepare` повертає false, як і раніше |

## Definition of Done

- [ ] `test/host/run_tests.sh` зелений, серед тестів — усі рядки «Edge cases»
- [ ] `check_core_headers.sh` чистий
- [ ] `idf.py build` без помилок і нових попереджень
- [ ] every Hard Rule inlined above still holds
