12romis/esp32-elrs-rover/docs/features/phase6-tof/tasks/t5-drive-core-limit-and-hold-transitions.md

---
id: T5
title: "Вбудувати в drive_ctl_step знімок далекомірів: обмеження тяги після мікшера, запити ARMED ↔ OBSTACLE_HOLD, застарілий знімок"
layer: "app"
deps: ["T2", "T3"]
blocks: ["T6", "T12"]
acs: ["AC-01", "AC-04", "AC-05", "AC-06"]
files_hint: ["components/drive/drive_core.c", "components/drive/include/drive_core.h", "components/drive/CMakeLists.txt", "test/host/test_drive.c"]
owner: "Агент"
estimate: "M"
context_budget: "M"
status: "done"
step: "COMMIT"
---

# T5 — Вбудувати в drive_ctl_step знімок далекомірів: обмеження тяги після мікшера, запити ARMED ↔ OBSTACLE_HOLD, застарілий знімок

## Place in the sequence

- **Blocked by:** T2 — Додати в tof_core обмеження тяги пари бортів і тексти: показ датчиків і рядок входу в утримання, T3 — Додати в app_state предикат «ровер їде» і пару OBSTACLE_HOLD → DISARMED (12 пар із 49) · **Blocks:** T6 — Перевести в drive_core усі перевірки «лише ARMED» на предикат: відсічка, втрата зв'язку, пульт, роззброєння, вікно команди, регулятор, T12 — Підключити далекоміри до drive_hal: знімок у кроці, запит OBSTACLE_HOLD ↔ ARMED без pid_hal_arm_begin, журнал, предикат у журналі й лічильнику затримки · **Wave:** 3.
- **Lane:** спільні файли: T6 (`components/drive/drive_core.c`, `components/drive/include/drive_core.h`, `test/host/test_drive.c`); T12 (`components/drive/CMakeLists.txt`) — серіалізовано.

## Why (user story)

> **As a** Розробник
> **I want** щоб озброєний ровер, який їде вперед, зупинявся перед стіною чи предметом, навіть якщо я тримаю стік уперед
> **So that** ровер не б'ється об перешкоди, коли я не встигаю відпустити стік
>
> — `spec.md §4, US-01, verbatim` · full text: [spec.md](../spec.md)

Ця задача робить так, що ровер, який їде вперед, зупиняється перед зайнятим сектором, а стан автомата сам іде в OBSTACLE_HOLD і назад.

## Inlined context

> **Chosen:** варіант 1. Одна точка обмеження після мікшера й після відновлення пари з вікна стендової команди робить захист однаковим для обох джерел, тестується на хості разом з рештою кроку й не додає нового писача виходів. Перехід стану просить той самий `control`, тож відсічка, втрата зв'язку й роззброєння мають перевагу в тому ж такті. Обмеження розкладає пару бортів на тягу й поворот, обрізає лише тягу в бік зайнятого сектору (нова пара за модулем не перевищує початкової, тож межа потужності не порушується) і лишає поворот.
>
> — `adr/0001-apply-obstacle-limit-inside-control-step-from-tof-snapshot.md, Decision outcome, verbatim` · full text: [adr/0001-apply-obstacle-limit-inside-control-step-from-tof-snapshot.md](../adr/0001-apply-obstacle-limit-inside-control-step-from-tof-snapshot.md)

> - Перехід стану: `drive_ctl_step` ставить запит OBSTACLE_HOLD, коли state == ARMED і зайнятий будь-який сектор, і запит ARMED, коли state == OBSTACLE_HOLD і обидва вільні; відсічка по напрузі, втрата звʼязку, нове зʼявлення пульта й роззброєння мають перевагу в тому ж такті. Запит ARMED з OBSTACLE_HOLD не йде через `pid_hal_arm_begin` (це не озброєння): HAL відрізняє його за станом «до».
>
> — `sad.md §4, журнал припущень design, bullet «Перехід стану», verbatim` · full text: [sad.md](../sad.md)

> - Інваріант ADR-0002 фази 1 «коли є запит стану, виходи вже вимкнені» стосується запитів DISARMED і FAILSAFE; запити OBSTACLE_HOLD і назад не вимикають виходів (рух у вільний бік триває).
>
> — `sad.md §4, журнал припущень design, bullet «Інваріант ADR-0002», verbatim` · full text: [sad.md](../sad.md)

> - Вік знімка: старший за 250 мс (або `valid == false`, задача не стартувала чи зависла) → обидва сектори «не охороняються» і не зайняті, одна подія журналу «знімок застарів», друга при відновленні; ровер їде далі, як при відмові всіх датчиків (spec AC-06, AC-07).
>
> — `sad.md §4, журнал припущень design, bullet «Вік знімка», verbatim` · full text: [sad.md](../sad.md)

> | Затримка «кадр пульта → борти» | ≤ 20 мс максимум, зокрема з опитуванням далекомірів і трасуванням (фаза 4: макс 15 мс) | діагностичні мітки часу фази 3 в журналі монітора |
>
> — `spec.md §6, NFR «Затримка кадр → борти», verbatim` · full text: [spec.md](../spec.md)

> **Hard rule:** 7. Інваріанти безпеки, сильніші за будь-яку функціональність:    - STBY піднімається тільки в стані ARMED і тільки свідомо;    - втрата кадрів CRSF довша за 500 мс → ШІМ у нуль, STBY вниз;    - перша операція по I²C після старту — запис `0x00` у PCF8574;    - VBAT < 6.0 В → мотори не запускаються.
>
> — `constitution.md, п. 7, verbatim` · full text: [constitution.md](../../../constitution.md)

**Fallback:** insufficient or contradicted by the code → read the named file in full ([spec.md](../spec.md) · [sad.md](../sad.md) · [adr/](../adr/) · [measured.md](../../../measured.md)) and follow it. Do not guess.

## Data delta

No DB changes.

## API contract

Internal — no API surface.

## Acceptance criteria

### AC-01 (US-01) — happy path

> **Given** ровер озброєний з пульта, колеса на підлозі, напруга не нижче 7.4 В, показ далекомірів називає всі чотири справними, а поріг перешкоди записано в журнал вимірювань і прошито; перед ровером на відстані понад 1 м стоїть плоска стіна (картон), перпендикулярна напрямку руху
> **When** Розробник тримає стік рівно вперед і їде до стіни; потім повторює заїзд на стіку 60 % і 30 % ходу
> **Then** у кожному заїзді ровер зупиняється, не торкнувшись стіни, а автомат переходить в OBSTACLE_HOLD; консоль одним рядком називає зайнятий сектор («передній»), відстань і поріг; обидва борти отримують нуль не пізніше ніж через 250 мс після першого відліку, меншого за поріг (мітки часу в журналі); поки Розробник тримає стік уперед, ровер не рухається вперед; відстань від переднього краю ровера до стіни після зупинки Розробник міряє рулеткою й записує в журнал вимірювань
>
> — `spec.md §5, AC-01, verbatim` · full text: [spec.md](../spec.md)

### AC-04 (US-02) — happy path

> **Given** ровер у OBSTACLE_HOLD, передній сектор зайнятий, ззаду вільно
> **When** Розробник тримає стік уперед і праворуч одночасно, а потім лише праворуч
> **Then** у першому випадку складова «тяга» дорівнює нулю, а «поворот» лишається: ровер розвертається на місці праворуч (лівий борт уперед, правий назад, однакові за модулем швидкості); у другому — так само; коли після повороту передній сектор вільний, автомат повертається в ARMED і стік уперед знову везе ровер уперед
>
> — `spec.md §5, AC-04, verbatim` · full text: [spec.md](../spec.md)

### AC-05 (US-02) — domain invariant

> **Given** ровер озброєний, зайнятий задній сектор (стіна позаду ближче за поріг), передній вільний; окремо — зайняті обидва сектори
> **When** Розробник відводить стік назад, потім уперед, потім стік тільки вбік
> **Then** при зайнятому задньому секторі рух назад заборонений (нуль обом бортам), а рух уперед дозволений; при двох зайнятих секторах тяга в обидва боки дорівнює нулю, а поворот на місці працює; заборона рухатися в бік зайнятого сектора ніколи не виконується частково — ні плавним гальмуванням до порогу, ні дозволом проїхати «ще трохи»
>
> — `spec.md §5, AC-05, verbatim` · full text: [spec.md](../spec.md)

### AC-06 (US-03) — error

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

## Checklist

- [ ] Додати в `drive_ctl_in_t` копію `tof_view_t` і вхід «знімок далекомірів отримано»; у `drive_ctl_out_t` — подію входу в утримання (сектор, мм, датчик) і подій «знімок застарів»/«відновився» (`DRIVE_EVT_TOF_*`) — `components/drive/include/drive_core.h`
- [ ] Обчислювати «охороняється/зайнятий» зі знімка; знімок старший за `TOF_STALE_MS` або без `valid` → обидва сектори не зайняті, подія один раз — `components/drive/drive_core.c`
- [ ] Після `drive_mix` і після відновлення пари з вікна стендової команди викликати `tof_limit_sides`; далі стеля, розгін, регулятор без змін — `components/drive/drive_core.c`
- [ ] Шлях виходів рахувати для `app_state_is_driving(state)`, а не лише для ARMED — `components/drive/drive_core.c`
- [ ] Запит OBSTACLE_HOLD, коли state == ARMED і зайнятий будь-який сектор; запит ARMED, коли state == OBSTACLE_HOLD і обидва вільні; відсічка, втрата зв'язку, нове зʼявлення пульта й роззброєння мають перевагу в тому ж такті; запити HOLD не вимикають виходів — `components/drive/drive_core.c`
- [ ] Додати `tof` у `PRIV_REQUIRES`/`REQUIRES` drive (лише `tof_core.h`) — `components/drive/CMakeLists.txt`
- [ ] Тести за «Edge cases» — `test/host/test_drive.c`

## Edge cases

| Case | Behaviour |
|---|---|
| Стік вперед, передній зайнятий | Обидва борти нуль у тому ж такті, запит OBSTACLE_HOLD, STBY піднятий |
| Стік вперед + вбік, передній зайнятий | Тяга нуль, поворот лишається: розворот на місці |
| OBSTACLE_HOLD, стік назад, задній вільний | Їде назад, STBY піднятий |
| Передній вільний три оновлення поспіль | Запит ARMED; не раніше |
| Задній зайнятий, стік назад | Нуль бортам; уперед дозволено |
| Знімок старший за 250 мс або `valid` хибне | Сектори не зайняті, одна подія «застарів», рух за стіком; ровер у HOLD → запит ARMED |
| Зайнятість і втрата зв'язку в одному такті | FAILSAFE має перевагу, запиту HOLD немає |
| Стендова команда руху у вікні 2 с, передній зайнятий | Обрізання діє щотакту, вікно спливає як раніше |
| Міжтактовий стрибок межі потужності | Модуль виходу ≤ 750 тисячних у 100 % тактів |

## Definition of Done

- [ ] `test/host/run_tests.sh` зелений, серед тестів — усі рядки «Edge cases»; тести фаз 1–5 не зламано
- [ ] `check_core_headers.sh` чистий
- [ ] `idf.py build` без помилок і нових попереджень
- [ ] Hard rule з п. 7 конституції (відсічка, втрата зв'язку) не порушено
- [ ] every Hard Rule inlined above still holds
