12romis/esp32-elrs-rover/docs/features/phase5-pid/tasks/t3-pid-core-text.md

---
id: T3
title: "Додати в pid_core кадр трасування і тексти: рядок трасування, показ стану регулятора"
layer: "domain"
deps: ["T2"]
blocks: ["T4", "T7"]
acs: ["AC-03", "AC-18"]
files_hint: ["components/pid/pid_core.c", "components/pid/include/pid_core.h", "test/host/test_pid.c"]
owner: "Агент (код); Розробник (приймання на залізі)"
estimate: "S"
context_budget: "M"
status: "done"
step: "GATE ✓ — без коміту (рішення Розробника)"
---

> **Рев'ю 2026-10-20, F5 (T11):** апаратні AC (AC-05) прибрано з `acs` цієї задачі. Вони приймаються на залізі в T10 (spec AC-20); блоки AC нижче лишаються як контекст для хостової логіки.

<!-- To the executing agent: work from what is inlined here. If a slice is insufficient, ambiguous, or contradicts the code in front of you, open the named file for the full text and follow that. Do not invent the missing part. -->

# T3 — Додати в pid_core кадр трасування і тексти: рядок трасування, показ стану регулятора

## Place in the sequence

- **Blocked by:** T2 — Додати в pid_core крок регулятора: задана з мікшера, розгін, P/I/D, вихід у напрямку цілі, швидкість борту · **Blocks:** T4 — Вбудувати регулятор у drive_ctl_step: задана щотакту, крок лише на новому знімку, фіксація режиму при озброєнні · T7 — Створити pid_hal: набір під portMUX, завантаження й збереження в NVS, задача pid_trace · **Wave:** 3 — після кроку T2 (той самий файл).
- **Lane:** shares `components/pid/include/pid_core.h`, `components/pid/pid_core.c`, `test/host/test_pid.c` with T1, T2 — serialized.

## Why (user story)

> **As a** Розробник
> **I want** змінювати коефіцієнти регулятора командами консолі на ходу, вмикати й вимикати регулятор і бачити трасування цілі, виміру й виходу кожного борту
> **So that** я підбираю набір коефіцієнтів на залізі без перепрошивки
>
> — `spec.md §4, US-03, verbatim` · full text: [spec.md](../spec.md)

Дає Розробнику видимість: що показує `pid` і що друкує трасування.

## Inlined context

> Трасування: `control` накопичує за 5 тактів суми заданої, швидкості й виходу по борту, кожні 100 мс публікує кадр (час від старту плати в мс, середні, вихід мікшера для борту без регулятора, режими бортів, ознака ARMED, номер кадру) під `portMUX`; задача `pid_trace` (prio 1, core 0, стек 3072, 100 мс через `vTaskDelayUntil`, Task WDT) друкує новий кадр, якщо трасування ввімкнене і ровер в ARMED (ADR-0003).
>
> — `sad.md §4, журнал припущень «Трасування», verbatim` · full text: [sad.md](../sad.md)

> **Перевірка допуску ±5 %.** Швидкість борту в рядку трасування — середнє за 100 мс цього рядка; допуск має виконуватись у кожному рядку, починаючи через 1 с після того, як задана швидкість досягла свого значення (закінчився розгін).
>
> — `spec.md §5, «Поведінка регулятора», перевірка допуску, verbatim` · full text: [spec.md](../spec.md)

> Рядок трасування містить час від старту плати (мс), а для лівого і правого борту — задану швидкість і швидкість борту в обертах колеса за хвилину з одним знаком після коми та вихід регулятора в частках від повної потужності зі знаком і двома знаками після коми; борт у режимі без регулятора має позначку режиму поруч зі швидкістю борту (замість заданої швидкості й виходу регулятора — вихід мікшера), а борт без жодного доступного енкодера — позначку режиму замість виміру.
>
> — `spec.md §5, «Вміст рядка трасування», verbatim` · full text: [spec.md](../spec.md)

> **Chosen:** варіант 1. Повільний USB блокує лише задачу трасування на ядрі 0, а `control` робить кілька додавань і одну публікацію кадру. Варіант 2 переносить форматування й вивід у задачу керування і може вивести затримку за 20 мс саме тоді, коли Розробник налаштовує регулятор.
>
> — `adr/0003, Decision outcome, verbatim` · full text: [adr/0003-print-regulator-trace-from-low-priority-task.md](../adr/0003-print-regulator-trace-from-low-priority-task.md)

> Кожен компонент ділиться на `<name>_core.c` (без жодного заголовка ESP-IDF) і `<name>_hal.c`. Логіка живе в core і покривається тестами на хості.
>
> — `docs/constitution.md, п. 6, abridged` · full text: [../../constitution.md](../../../constitution.md)

**Fallback:** insufficient or contradicted by the code → read the named file in full ([spec.md](../spec.md) · [sad.md](../sad.md) · [adr/](../adr/)) and follow it. Do not guess.

## Data delta

No DB changes.

## API contract

Internal — no API surface (консоль описано в spec §5).

## Acceptance criteria

### AC-03 (US-03) — happy path

> **Given** ровер у будь-якому стані автомата
> **When** Розробник змінює один коефіцієнт набору командою регулятора з числом (наприклад, Kp на 1.2), а потім показує стан регулятора
> **Then** консоль підтверджує зміну зі старим і новим значенням і нагадує, що набір не збережено; у ARMED нове значення діє з наступного такту керування (трасування показує зміну реакції без паузи); показ стану регулятора називає режим (увімкнений, вимкнений або не налаштований), усі чотири числа набору з позначкою, чи збережено їх, і для кожного борту задану швидкість, швидкість борту, вихід регулятора та режим борту (за двома колесами, за одним колесом із назвою недоступного, без регулятора); стан автомата, озброєння і команди бортам не змінюються самою командою
>
> — `spec.md §5, AC-03, verbatim` · full text: [spec.md](../spec.md)

### AC-05 (US-03) — happy path

> **Given** ровер у DISARMED, регулятор увімкнено
> **When** Розробник вмикає трасування регулятора, озброює ровер, їздить 10 с, роззброює і вимикає трасування
> **Then** поки ровер озброєний, консоль виводить рядок трасування 10 разів на секунду (за 10 с — 100 ± 2 рядки), кожен із часом від старту плати і для кожного борту задану швидкість, швидкість борту і вихід регулятора; поза ARMED рядки трасування не виводяться; після вимкнення трасування рядків немає в жодному стані; затримка «кадр пульта → борти» з увімкненим трасуванням не гірша за §6
>
> — `spec.md §5, AC-05, verbatim` · full text: [spec.md](../spec.md)

### AC-18 (US-08) — happy path

> **Given** Агент завершив зміну в межах фази 5
> **When** Агент запускає збірку проєкту і прогін хостових тестів
> **Then** збірка завершується без помилок і без нових попереджень, а прогін повідомляє кількість тестів і що всі пройдені; серед них перевірено з підставним годинником: крок регулятора з обмеженням виходу межею потужності й зупинкою накопичення на межі (зокрема довге насичення і вихід з нього), нульову ціль із негайним нулем і скиданням, розгін лише на зростання модуля цілі (зокрема зміну напрямку), перетворення виходу мікшера на задану швидкість зі стелею 150, швидкість борту за двома, одним і жодним доступним колесом, скидання при кожній зупинці фаз 1–3, дозволи команд регулятора за станом, відкат за застарілим вимірюванням швидкості (AC-12b), відмову озброєння під час збереження (AC-15), правила розділу «Поведінка регулятора» (одиниці, знак виходу, накопичення без стрибка, диференціальна складова від виміру, розгін лише з регулятором), збереження і завантаження режиму разом із набором, розбір команд з усіма відхиленнями AC-04 (зокрема спробу змінити межу потужності за AC-09), перевірку збереженого запису набору (повний, пошкоджений, неповний, відсутній) і формат трасування
>
> — `spec.md §5, AC-18, verbatim` · full text: [spec.md](../spec.md)

## Checklist

- [ ] Тип кадру трасування (час від старту в мс, суми й лічильник тактів за 100 мс, задана/швидкість/вихід по борту, вихід мікшера для борту без регулятора, режими бортів, ознака ARMED, номер кадру) і накопичення по такту — `components/pid/include/pid_core.h`, `components/pid/pid_core.c`
- [ ] Форматування рядка трасування за spec «Вміст рядка трасування» — `components/pid/pid_core.c`
- [ ] Форматування показу стану `pid`: режим, чотири числа з позначкою «збережено/не збережено», по борту задана, швидкість, вихід, режим борту з назвою недоступного колеса — `components/pid/pid_core.c`
- [ ] Хостові тести формату й середнього за 5 тактів — `test/host/test_pid.c`

## Edge cases

| Case | Behaviour |
|---|---|
| борт без регулятора | у рядку позначка режиму, швидкість борту і вихід мікшера замість заданої й виходу регулятора |
| борт без жодного доступного енкодера | позначка режиму замість виміру |
| набір не налаштований | показ стану: «регулятор не налаштований», незадані числа позначено |

## Definition of Done

- [ ] `test/host/run_tests.sh` зелений з тестами формату
- [ ] `idf.py build` без помилок і нових попереджень
- [ ] every Hard Rule inlined above still holds
- [ ] lint + vet clean (статичні перевірки `test/host/check_*.sh`)
