12romis/esp32-elrs-rover/docs/features/phase5-pid/tasks/t4-drive-core-regulate.md

---
id: T4
title: "Вбудувати регулятор у drive_ctl_step: задана щотакту, крок лише на новому знімку, фіксація режиму при озброєнні"
layer: "app"
deps: ["T2", "T3"]
blocks: ["T5"]
acs: ["AC-16"]
files_hint: ["components/drive/drive_core.c", "components/drive/include/drive_core.h", "components/drive/CMakeLists.txt", "test/host/test_drive.c"]
owner: "Агент (код); Розробник (приймання на залізі)"
estimate: "M"
context_budget: "M"
status: "done"
step: "GATE ✓ — без коміту (рішення Розробника)"
---

> **Рев'ю 2026-10-20, F5 (T11):** апаратні AC (AC-02, AC-13) прибрано з `acs` цієї задачі. Вони приймаються на залізі в T10 (spec AC-20); блоки AC нижче лишаються як контекст для хостової логіки.

<!-- To the executing agent: work from what is inlined here. If a slice is insufficient, ambiguous, or contradicts the code in front of you, open the named file for the full text and follow that. Do not invent the missing part. -->

# T4 — Вбудувати регулятор у drive_ctl_step: задана щотакту, крок лише на новому знімку, фіксація режиму при озброєнні

## Place in the sequence

- **Blocked by:** T2 — Додати в pid_core крок регулятора: задана з мікшера, розгін, P/I/D, вихід у напрямку цілі, швидкість борту · T3 — Додати в pid_core кадр трасування і тексти: рядок трасування, показ стану регулятора · **Blocks:** T5 — Додати в drive_ctl_step відкати і зупинки: недоступні енкодери, застарілий знімок, скидання при зупинках, відмова озброєння під час збереження · **Wave:** 4 — після кроку й кадру з T2–T3; паралельно з T6, T7.
- **Lane:** shares `components/drive/CMakeLists.txt`, `components/drive/drive_core.c`, `components/drive/include/drive_core.h`, `test/host/test_drive.c` with T5, T8 — serialized.

## Why (user story)

> **As a** Розробник
> **I want** щоб на прямому стіку обидва борти крутилися з однаковою швидкістю попри повільніший правий борт
> **So that** ровер їде по прямій без постійного підрулювання
>
> — `spec.md §4, US-02, verbatim` · full text: [spec.md](../spec.md)

Замикає контур у такті керування: однаковий стік дає однакову швидкість обох бортів, а без регулятора поведінка точно як у фазі 4.

## Inlined context

> **Chosen:** варіант 1. Він лишає одного писача виходів і поєднує регулятор зі зупинками в одному чистому кроці, який тестується на хості; не змінює відвантажену фазу 4 і такт `control` на `vTaskDelayUntil`. Щоб не рахувати той самий знімок двічі, P, I і D оновлюються лише на новому інтервалі енкодерів з dt з їхніх міток; нульова ціль і зупинки діють у кожному такті. Варіант 2 переробляє фазу 4 і вимагає повторного приймання енкодерів.
>
> — `adr/0001, Decision outcome, verbatim` · full text: [adr/0001-run-speed-regulator-inside-control-step-from-encoder-snapshot.md](../adr/0001-run-speed-regulator-inside-control-step-from-encoder-snapshot.md)

> Крок регулятора (spec «Поведінка регулятора», §6 «Такт регулятора»): P, I і D оновлюються лише тоді, коли у знімку енкодерів зʼявився новий інтервал (змінився лічильник інтервалів); між новими знімками вихід регулятора тримається, а нульова ціль і зупинки діють у кожному такті `control`. Похибка e = задана − швидкість борту (об/хв, зі знаком цілі); dt — різниця міток двох останніх інтервалів енкодерів у секундах, обмежена 10…40 мс; накопичена складова I += Ki·e·dt, а коли вихід уже на межі (чи на нулі) і e тисне далі в насичення, I не змінюється в цей бік; D = −Kd·(швидкість − попередня)/dt, у першому такті після скидання D = 0; вихід = Kp·e + I + D, обмежений [0, межа] у напрямку цілі. Нульова ціль → вихід 0 і скидання стану борту.
>
> — `sad.md §4, журнал припущень «Крок регулятора», verbatim` · full text: [sad.md](../sad.md)

> Режим борту: «за двома колесами» / «за одним колесом» / «без регулятора». Режим регулятора (увімкнений/вимкнений/не налаштований) фіксується в момент переходу в ARMED і до роззброєння не змінюється (spec AC-15 дозволяє перемикання лише в DISARMED; фіксація закриває гонку між перевіркою стану в консолі і переходом).
>
> — `sad.md §4, журнал припущень «Режим борту», verbatim` · full text: [sad.md](../sad.md)

> Стендова команда руху: `drive_ctl_t` зберігає вихід мікшера (ліве, праве) на вікно 2 с замість фіксованих виходів, і `control` перераховує виходи кожен такт (з регулятором чи без); у режимі без регулятора виходи дорівнюють фазі 4 (`drive_outputs_from` від виходу мікшера). Вихід регулятора (частка потужності зі знаком цілі, |v| ≤ межі) подається в той самий `drive_outputs_from`, тож нової функції виходів немає.
>
> — `sad.md §4, журнал припущень «Стендова команда руху», verbatim` · full text: [sad.md](../sad.md)

> Межа потужності: `DRIVE_PWM_MAX_PERMILLE` 750 лишається в `drive_core.h` (коментар посилається на spec AC-09); консоль її не змінює.
>
> — `sad.md §4, журнал припущень «Межа потужності», verbatim` · full text: [sad.md](../sad.md)

> | Такт регулятора | 20 мс, той самий такт керування, що й інтервал швидкості фази 4; регулятор використовує останній знімок енкодерів, не старший за один такт (20 мс), і оновлює P, I, D лише на новому знімку (рішення Розробника на design, 2026-10-20) | огляд коду; хостовий тест із підставним годинником |
>
> — `spec.md §6, «Такт регулятора», verbatim` · full text: [spec.md](../spec.md)

> | Межа потужності | вихід ≤ межі в 100 % тактів; межа 0.75 у фазі 5 (підняття винесено, §3) | хостовий тест; трасування AC-09 |
>
> — `spec.md §6, «Межа потужності», verbatim` · full text: [spec.md](../spec.md)

**Fallback:** insufficient or contradicted by the code → read the named file in full ([spec.md](../spec.md) · [sad.md](../sad.md) · [adr/](../adr/)) and follow it. Do not guess.

## Data delta

No DB changes.

## API contract

Internal — no API surface (консоль описано в spec §5).

## Acceptance criteria

### AC-02 (US-02) — happy path

> **Given** ровер стоїть на підлозі на початку прямого відрізка 2 м, відміряного рулеткою, напруга не нижче 7.4 В, регулятор увімкнено з набором, прийнятим за AC-01
> **When** Розробник озброює ровер з пульта і тримає стік прямо вперед так, що задана швидкість ≈ 75 обертів колеса за хвилину, без поворотного руху, до кінця відрізка; повторює на ≈ 120 обертах за хвилину; потім ті самі два заїзди з вимкненим регулятором (для порівняння)
> **Then** з увімкненим регулятором в обох заїздах ровер у кінці відрізка відходить від прямої не більше ніж на 10 см, а в трасуванні після розгону швидкості лівого і правого борту відрізняються між собою не більше ніж на 5 % і кожна лежить у ±5 % заданої; відхід без регулятора записують як вихідне значення для KPI §7
>
> — `spec.md §5, AC-02, verbatim` · full text: [spec.md](../spec.md)

### AC-13 (US-06) — happy path

> **Given** ровер озброєний з пульта, колеса в повітрі, регулятор увімкнено, темп розгону заданий у наборі, трасування ввімкнене
> **When** Розробник різко переводить стік з нейтралі на повний хід уперед, тримає 2 с, різко відпускає в нейтраль, а потім різко дає повний хід назад
> **Then** у трасуванні задана швидкість кожного борту зростає від нуля не швидше за темп розгону (з точністю до одного такту) до стелі заданої швидкості; після відпускання стіка задана швидкість і вихід регулятора обох бортів стають нулем у першому ж такті керування після кадру з нейтраллю, без розгону навпаки; при переході на хід назад ціль спершу одразу стає нулем, а потім зростає за модулем із тим самим темпом зі знаком «назад»
>
> — `spec.md §5, AC-13, verbatim` · full text: [spec.md](../spec.md)

### AC-16 (US-03) — cross-context

> **Given** ровер у DISARMED, усі чотири числа набору задано
> **When** Розробник вимикає регулятор, озброює ровер і їздить з пульта та в стендовому режимі
> **Then** ровер їде в режимі без регулятора точно як у фазі 4 (потужність борту пропорційна виходу мікшера, обмежена межею потужності), а показ стану називає режим «вимкнений»; після роззброєння і ввімкнення регулятора наступне озброєння знову регулює швидкість; стендова команда руху з консолі й пульт в обох режимах дають однакову задану швидкість для однакового виходу мікшера
>
> — `spec.md §5, AC-16, verbatim` · full text: [spec.md](../spec.md)

## Checklist

- [ ] Нові входи `drive_ctl_in_t`: знімок енкодерів (доступність, швидкість, лічильник інтервалів, мітка), копія `pid_set_t`; нульова ініціалізація (`drive_ctl_in_t in = {0}` у HAL) дає режим без регулятора — `components/drive/include/drive_core.h`
- [ ] `drive_ctl_t`: стан двох бортів регулятора, режим, зафіксований при переході в ARMED, номер останнього обробленого інтервалу; вікно стендової команди зберігає вихід мікшера замість фіксованих виходів — `components/drive/include/drive_core.h`
- [ ] У `drive_ctl_step`: щотакту вихід мікшера → задана; P/I/D лише при новому інтервалі енкодерів, dt з їхніх міток; між знімками вихід тримається; виходи через `drive_outputs_from` — `components/drive/drive_core.c`
- [ ] Коментар біля `DRIVE_PWM_MAX_PERMILLE` посилається на spec AC-09, а не на п. 7 конституції — `components/drive/include/drive_core.h`
- [ ] `components/drive/CMakeLists.txt`: REQUIRES `pid` і `encoders`
- [ ] Хостові тести: регулятор з пультом і зі стендовою командою, той самий знімок двічі не рахується, режим не змінюється до роззброєння, без регулятора виходи як у фазі 4 — `test/host/test_drive.c`

## Edge cases

| Case | Behaviour |
|---|---|
| той самий знімок у двох тактах | P/I/D оновлюються один раз, вихід тримається |
| `pid on` прийшов у ARMED | діє лише з наступного озброєння |
| регулятор вимкнений | виходи точно як у фазі 4 |
| стендова команда спливла | як у фазі 1: виходи вимкнено, ровер роззброєно |

## Definition of Done

- [ ] `test/host/run_tests.sh` зелений (наявні тести фаз 1–4 без змін у поведінці)
- [ ] `idf.py build` без помилок і нових попереджень
- [ ] every Hard Rule inlined above still holds
- [ ] lint + vet clean (статичні перевірки `test/host/check_*.sh`)
