12romis/esp32-elrs-rover/docs/features/phase5-pid/tasks/t7-pid-hal-store-trace.md

---
id: T7
title: "Створити pid_hal: набір під portMUX, завантаження й збереження в NVS, задача pid_trace"
layer: "infra"
deps: ["T1", "T3"]
blocks: ["T8"]
acs: ["AC-05", "AC-06", "AC-07", "AC-08"]
files_hint: ["components/pid/pid_hal.c", "components/pid/include/pid_hal.h", "components/pid/CMakeLists.txt"]
owner: "Агент (код); Розробник (приймання на залізі)"
estimate: "M"
context_budget: "M"
status: "review"
step: "REVIEW — гейт ✓; чекає приймання Розробника на залізі (spec AC-20)"
---

<!-- To the executing agent: work from what is inlined here. If a slice is insufficient, ambiguous, or contradicts the code in front of you, open the named file for the full text and follow that. Do not invent the missing part. -->

# T7 — Створити pid_hal: набір під portMUX, завантаження й збереження в NVS, задача pid_trace

## Place in the sequence

- **Blocked by:** T1 — Створити pid_core: набір коефіцієнтів, перевірка чисел, запис із версією і CRC32 · T3 — Додати в pid_core кадр трасування і тексти: рядок трасування, показ стану регулятора · **Blocks:** T8 — Підключити регулятор: drive_hal подає знімок і набір, main стартує pid_hal і pid_trace, колбеки консолі · **Wave:** 4 — після запису (T1) і кадру трасування (T3); паралельно з T4–T6.
- **Lane:** shares `components/pid/CMakeLists.txt` with T1 — serialized.

## Why (user story)

> **As a** Розробник
> **I want** зберегти підібраний набір коефіцієнтів у памʼяті плати і отримати безпечну поведінку фази 4, якщо набору немає чи він пошкоджений
> **So that** налаштування не губиться після перезапуску, а відсутність налаштування не робить ровер небезпечним
>
> — `spec.md §4, US-04, verbatim` · full text: [spec.md](../spec.md)

Дає памʼять набору між перезапусками і друк трасування поза тактом керування.

## Inlined context

> Обмін набором: `pid_hal` тримає поточний `pid_set_t` під `portMUX`; консоль змінює його через колбеки; `control` копіює набір кожен такт (зміна діє з наступного такту, spec AC-03). Бо накопичується Ki·e·dt, зміна Ki не дає стрибка (spec «Поведінка регулятора»).
>
> — `sad.md §4, журнал припущень «Обмін набором», verbatim` · full text: [sad.md](../sad.md)

> Збереження: `pid save` у задачі `console` — перевірка повноти набору, кодування в core, `nvs_set_blob` + `nvs_commit` у просторі `pid`, ключ `set`; збій — повідомлення з назвою помилки, набір у сеансі лишається «не збережено» (spec AC-08). Заборона в ARMED і OBSTACLE_HOLD — за матрицею (запис у флеш зупиняє кеш, тож пригальмував би такт керування). Щоб закрити гонку між перевіркою стану й записом, консоль під `portMUX` спершу ставить ознаку «триває збереження», потім перевіряє стан; поки ознака стоїть, `control` відхиляє озброєння (з пульта й консолі) з причиною «триває збереження набору»; ознака знімається після `nvs_commit` (spec AC-15).
>
> — `sad.md §4, журнал припущень «Збереження», verbatim` · full text: [sad.md](../sad.md)

> Старт: `pid_hal_init()` у `main` після `storage_init()` і до старту `control`: читає запис, `pid_core` перевіряє магію, версію, розмір, CRC32, скінченність і діапазони; невдача — «регулятор не налаштований» і рядок журналу з причиною (spec AC-07).
>
> — `sad.md §4, журнал припущень «Старт», verbatim` · full text: [sad.md](../sad.md)

> Трасування: `control` накопичує за 5 тактів суми заданої, швидкості й виходу по борту, кожні 100 мс публікує кадр (час від старту плати в мс, середні, вихід мікшера для борту без регулятора, режими бортів, ознака ARMED, номер кадру) під `portMUX`; задача `pid_trace` (prio 1, core 0, стек 3072, 100 мс через `vTaskDelayUntil`, Task WDT) друкує новий кадр, якщо трасування ввімкнене і ровер в ARMED (ADR-0003).
>
> — `sad.md §4, журнал припущень «Трасування», verbatim` · full text: [sad.md](../sad.md)

> **Chosen:** варіант 1. Запис атомарний: обрив живлення чи збій дають або старий, або новий запис цілком, а пошкодження, чужа версія чи неповний розмір ловляться однією перевіркою в core. У варіанті 2 частково записаний набір (частина нових, частина старих чисел) виглядає повним, і AC-07 його не відловить.
>
> — `adr/0002, Decision outcome, verbatim` · full text: [adr/0002-store-coefficient-set-as-one-versioned-crc-checked-nvs-record.md](../adr/0002-store-coefficient-set-as-one-versioned-crc-checked-nvs-record.md)

> **Chosen:** варіант 1. Повільний USB блокує лише задачу трасування на ядрі 0, а `control` робить кілька додавань і одну публікацію кадру. Варіант 2 переносить форматування й вивід у задачу керування і може вивести затримку за 20 мс саме тоді, коли Розробник налаштовує регулятор.
>
> — `adr/0003, Decision outcome, verbatim` · full text: [adr/0003-print-regulator-trace-from-low-priority-task.md](../adr/0003-print-regulator-trace-from-low-priority-task.md)

> Усі періодичні задачі використовують `vTaskDelayUntil`, а не `vTaskDelay` (розділ 8.5).
>
> — `docs/constitution.md, п. 14, abridged` · full text: [../../constitution.md](../../../constitution.md)

**Fallback:** insufficient or contradicted by the code → read the named file in full ([spec.md](../spec.md) · [sad.md](../sad.md) · [adr/](../adr/)) and follow it. Do not guess.

## Data delta

Читання й запис запису набору в NVS: простір `pid`, ключ `set`, blob з T1 (`nvs_get_blob`, `nvs_set_blob` + `nvs_commit`).

— `sad.md §6, «Схема даних», abridged` · full text: [sad.md](../sad.md)

## API contract

Internal — no API surface (консоль описано в spec §5).

## Acceptance criteria

### AC-05 (US-03) — happy path

> **Given** ровер у DISARMED, регулятор увімкнено
> **When** Розробник вмикає трасування регулятора, озброює ровер, їздить 10 с, роззброює і вимикає трасування
> **Then** поки ровер озброєний, консоль виводить рядок трасування 10 разів на секунду (за 10 с — 100 ± 2 рядки), кожен із часом від старту плати і для кожного борту задану швидкість, швидкість борту і вихід регулятора; поза ARMED рядки трасування не виводяться; після вимкнення трасування рядків немає в жодному стані; затримка «кадр пульта → борти» з увімкненим трасуванням не гірша за §6
>
> — `spec.md §5, AC-05, verbatim` · full text: [spec.md](../spec.md)

### AC-06 (US-04) — happy path

> **Given** ровер у DISARMED, Розробник задав усі чотири числа набору й увімкнув регулятор
> **When** Розробник зберігає набір командою збереження і перезапускає плату
> **Then** консоль підтверджує збереження; після старту журнал старту і показ стану регулятора називають збережений набір і режим «увімкнений», а позначка «не збережено» зникла; у наступному озброєнні регулятор працює з цим набором без жодних команд. Якщо набір збережено з вимкненим регулятором, після перезапуску показ стану називає збережений набір і режим «вимкнений», а ровер їздить у режимі без регулятора, доки Розробник не ввімкне його в DISARMED. Збереження неповного набору відхиляється з поясненням, які числа ще не задані, і запис у памʼяті плати не змінюється
>
> — `spec.md §5, AC-06, verbatim` · full text: [spec.md](../spec.md)

### AC-07 (US-04) — cross-context

> **Given** у памʼяті плати немає збереженого набору (перший старт після фази 4 чи очищення памʼяті) або збережений запис пошкоджений чи неповний (неповний запис відкидається повністю, жодне число з нього не завантажується)
> **When** плата стартує, а Розробник показує стан регулятора, озброює ровер і їздить з пульта
> **Then** журнал старту і показ стану кажуть «регулятор не налаштований» (для пошкодженого запису — ще й що запис відкинуто), а невідомі числа набору позначені як не задані; ровер озброюється і їздить у режимі без регулятора точно як у фазі 4; увімкнення регулятора відхиляється з поясненням, які числа набору ще не задані, доки всі чотири не задано з консолі. Пошкоджений запис на залізі не відтворити, тож ця гілка приймається хостовим тестом перевірки запису й оглядом коду
>
> — `spec.md §5, AC-07, verbatim` · full text: [spec.md](../spec.md)

### AC-08 (US-04) — error

> **Given** ровер у DISARMED, набір задано, а запис у памʼять плати не вдається (збій сховища)
> **When** Розробник зберігає набір
> **Then** консоль повідомляє, що набір не збережено, і називає причину збою сховища; набір і режим регулятора в поточному сеансі діють далі з позначкою «не збережено»; ровер не перезавантажується і стан автомата не змінюється. Збій сховища на залізі не відтворити, тож критерій приймається хостовим тестом і оглядом коду
>
> — `spec.md §5, AC-08, verbatim` · full text: [spec.md](../spec.md)

## Checklist

- [ ] Поточний `pid_set_t` під `portMUX`: копія для `control`, зміна числа (старе → нове), режим, ознака «збережено» — `components/pid/pid_hal.c`, `components/pid/include/pid_hal.h`
- [ ] `pid_hal_init()`: читання запису, перевірка в core, рядок журналу «набір завантажено» або причина відкидання — `components/pid/pid_hal.c`
- [ ] Збереження: ознака «триває збереження» під `portMUX` до перевірки стану, повнота набору, кодування в core, `nvs_set_blob` + `nvs_commit`, ознаку знято; збій — назва помилки, «не збережено» — `components/pid/pid_hal.c`
- [ ] Кадр трасування під `portMUX` і задача `pid_trace` (prio 1, core 0, стек 3072, 100 мс через `vTaskDelayUntil`, Task WDT): друкує новий кадр, якщо трасування ввімкнене і ровер в ARMED — `components/pid/pid_hal.c`
- [ ] `components/pid/CMakeLists.txt`: SRCS `pid_hal.c`, PRIV_REQUIRES `nvs_flash`, `freertos`, `esp_timer`, `log`

## Edge cases

| Case | Behaviour |
|---|---|
| запису немає | «регулятор не налаштований», ровер як у фазі 4 |
| запис пошкоджений | відкинуто повністю, причина в журналі |
| `nvs_commit` повертає помилку | «набір не збережено» з назвою помилки, сеанс діє далі |
| трасування ввімкнене поза ARMED | рядків немає |

## Definition of Done

- [ ] `idf.py build` без помилок і нових попереджень
- [ ] `check_delays.sh` чистий
- [ ] логіку перевірено хостовими тестами T1/T3; HAL приймається на залізі (T10)
- [ ] every Hard Rule inlined above still holds
- [ ] lint + vet clean (статичні перевірки `test/host/check_*.sh`)
