12romis/esp32-elrs-rover/docs/features/phase5-pid/tasks/t9-host-guardrails.md

---
id: T9
title: "Посилити хостові перевірки: межа потужності 750, core без ESP-IDF, повний прогін з test_pid.c"
layer: "tests"
deps: ["T8"]
blocks: []
acs: ["AC-18", "AC-19"]
files_hint: ["test/host/check_calib.sh", "test/host/run_tests.sh", "test/host/README.md"]
owner: "Агент (код); Розробник (приймання на залізі)"
estimate: "S"
context_budget: "S"
status: "done"
step: "GATE ✓ — без коміту (рішення Розробника)"
---

<!-- To the executing agent: work from what is inlined here. If a slice is insufficient, ambiguous, or contradicts the code in front of you, open the named file for the full text and follow that. Do not invent the missing part. -->

# T9 — Посилити хостові перевірки: межа потужності 750, core без ESP-IDF, повний прогін з test_pid.c

## Place in the sequence

- **Blocked by:** T8 — Підключити регулятор: drive_hal подає знімок і набір, main стартує pid_hal і pid_trace, колбеки консолі · **Blocks:** — · **Wave:** 7 — після підключення всього коду.
- **Lane:** own lane.

## Why (user story)

> **As a** Агент
> **I want** покрити логіку регулятора хостовими тестами і зібрати прошивку без попереджень
> **So that** помилки знака, обмеження і розгону ловляться без плати, а залізо перевіряє лише те, чого хост не бачить
>
> — `spec.md §4, US-08, verbatim` · full text: [spec.md](../spec.md)

Робить правила конституції машинною перевіркою, щоб задача не позначалась виконаною з порушенням.

## Inlined context

> | Межа потужності | вихід ≤ межі в 100 % тактів; межа 0.75 у фазі 5 (підняття винесено, §3) | хостовий тест; трасування AC-09 |
>
> — `spec.md §6, «Межа потужності», verbatim` · full text: [spec.md](../spec.md)

> Кожен компонент ділиться на `<name>_core.c` (без жодного заголовка ESP-IDF) і `<name>_hal.c`. Логіка живе в core і покривається тестами на хості.
>
> — `docs/constitution.md, п. 6, abridged` · full text: [../../constitution.md](../../../constitution.md)

> | Хостовий прогін тестів | ≤ 5 с, 100 % тестів пройдено | вивід хостового раннера |
>
> — `spec.md §6, «Хостовий прогін тестів», verbatim` · full text: [spec.md](../spec.md)

**Fallback:** insufficient or contradicted by the code → read the named file in full ([spec.md](../spec.md) · [sad.md](../sad.md) · [adr/](../adr/)) and follow it. Do not guess.

## Data delta

No DB changes.

## API contract

Internal — no API surface (консоль описано в spec §5).

## Acceptance criteria

### AC-18 (US-08) — happy path

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

### AC-19 (US-08) — error

> **Given** у зміні файл чистої логіки (з суфіксом core) підключив заголовок ESP-IDF чи FreeRTOS, або номер лінії зʼявився літералом поза єдиним файлом розпіновки, або межа потужності задана числом, відмінним від 0.75, або періодична задача чекає звичайною затримкою замість очікування до моменту, або зʼявилося нове попередження збірки
> **When** Агент запускає збірку і хостові перевірки
> **Then** задачу не вважають завершеною, Агент називає файл і причину та не позначає задачу виконаною
>
> — `spec.md §5, AC-19, verbatim` · full text: [spec.md](../spec.md)

## Checklist

- [ ] Перевірка, що `DRIVE_PWM_MAX_PERMILLE` дорівнює 750 і межу ніде не задано іншим числом — `test/host/check_calib.sh`
- [ ] `run_tests.sh` підхоплює `test_pid.c`; прогін ≤ 5 с — `test/host/run_tests.sh`
- [ ] Опис нових перевірок — `test/host/README.md`

## Edge cases

| Case | Behaviour |
|---|---|
| хтось підняв межу до 800 | перевірка падає з назвою файлу |
| `pid_core.c` підключив `esp_log.h` | `check_core_headers.sh` падає |

## Definition of Done

- [ ] усі `check_*.sh` і `run_tests.sh` зелені
- [ ] `idf.py build` без помилок і нових попереджень
- [ ] every Hard Rule inlined above still holds
- [ ] lint + vet clean (статичні перевірки `test/host/check_*.sh`)
