12romis/esp32-elrs-rover/docs/features/phase4-encoders/adr/0001-sample-encoders-in-a-dedicated-20ms-task-and-publish-a-snapshot.md

---
status: Accepted
owner: "Розробник проєкту"
reviewers: []
updated_at: "2026-10-19"
feature_size: "S"
ticket: "roadmap крок 4 — phase4-encoders"
---

# 0001 — Sample encoders in a dedicated 20 ms task and publish a snapshot

- **Status:** Accepted
- **Date:** 2026-10-19
- **Deciders:** Розробник проєкту, Агент (design, рівень easy)

## Context

Фаза 4 має знімати чотири апаратні лічильники енкодерів з номінальним інтервалом 20 мс і рахувати швидкість кожного колеса як приріст, поділений на фактичний час між вибірками (spec §1, уточнення clarify 2026-10-19). У фазі 4 швидкість лише показується в консолі; у фазі 5 її читатиме регулятор у задачі `control` (такт 20 мс). Документ 02 §7 «Фаза 4» пропонує відмірювати інтервал апаратним таймером, §6.1 окремої задачі для енкодерів не має. Задача `control` стартує лише тоді, коли пройшла ініціалізація виходів моторів (`drive_hal_init`, `main.c`), і навіть запущена може працювати без підписки на Task WDT (`drive_hal.c`), а spec AC-03 вимагає, щоб енкодери рахували в кожному стані, зокрема коли колесо крутять рукою.

## Decision drivers

- Spec §6: інтервал 20 мс, 500 ± 1 інтервалів за 10 с, нуль швидкості ≤ 40 мс після останнього імпульсу.
- Spec AC-03, AC-08: енкодери працюють незалежно від стану автомата й від того, чи працює керування; збій енкодерів не зупиняє ровер.
- Конституція, п. 6 і п. 14: логіка в core з тестами на хості, періодичні задачі на `vTaskDelayUntil`.
- Фаза 5 потребуватиме свіжої швидкості в `control`.

## Considered options

1. **Власна задача `encoders`** — періодична задача 20 мс (`vTaskDelayUntil`, пріоритет 4, ядро 1, Task WDT) читає чотири лічильники, ставить мітку `esp_timer_get_time()`, викликає чистий крок `encoders_core` і публікує знімок під `portMUX`; консоль (і у фазі 5 `control`) читає знімок.
2. **Вибірка в задачі `control`** — на кожному такті `control` читає лічильники й рахує швидкість у тому самому кроці, де у фазі 5 працюватиме регулятор. Запропоновано власнику як рекомендований варіант: швидкість без додаткової затримки в контурі, без нової задачі. Відхилено власником, бо енкодери тоді залежать від того, чи стартувала `control`.
3. **Апаратний таймер (як у документі 02 §7)** — переривання таймера кожні 20 мс читає лічильники. Найрівніший інтервал, але код у перериванні, а оскільки швидкість однаково ділиться на фактичний час, точність таймера нічого не додає до результату.

## Decision outcome

**Chosen:** варіант 1 (рішення власника, 2026-10-19). Енкодери стають самостійною підсистемою: рахують і показуються, навіть якщо `control` не запустилася, а їх збій нічого не ламає в керуванні (spec AC-08). Ділення на фактичний час знімає залежність від тремтіння такту, тож звичайної періодичної задачі досить.

## Consequences

**Positive**
- Знімок енкодерів доступний у кожному стані й незалежно від `control` (spec AC-03).
- Уся логіка вибірки — чистий крок `encoders_core` з підставними мітками на хості; HAL — лише читання лічильників і задача.
- Немає коду в перериваннях.

**Negative**
- Ще одна задача: стек 3072 байти й підписка на Task WDT; вплив на пам'ять перевіряє поріг ≥ 345000 байт (spec §6).
- У фазі 5 регулятор читатиме швидкість, зняту незалежним тактом: вона може бути до 20 мс старою відносно такту `control`. Фаза 5 вирішує, чи синхронізувати такти, чи прийняти затримку.
- Задача на ядрі 1, хоча документ 02 §6.1 радить ядро 0 для всього, крім керування й радіо: у фазі 5 вона — джерело швидкості для `control` на тому самому ядрі.
- Відхід від документа 02 §6.1 (немає задачі `encoders`) і §7 «Фаза 4» (апаратний таймер); документ оновлюється лише за вказівкою Розробника.

**Neutral**
- Якщо фаза 5 покаже, що затримка заважає, вибірку можна перенести в `control`, не змінюючи `encoders_core` (варіант 2 лишається відкритим).

## Links

- Spec: [[../spec.md]] AC-02, AC-03, AC-08, §6
- SAD: [[../sad.md]] §4 (пункт 1), §5, §6 (потоки 1 і 2), §11
- Related ADR: [[0002-accumulate-counts-by-modular-difference-in-encoders-core]]; фаза 3 — ADR-0001 (знімок під `portMUX`)
