12romis/esp32-elrs-rover/docs/features/phase4-encoders/tasks/t2-encoders-core-speed.md

---
id: T2
title: "Додати в encoders_core швидкість колеса: приріст на фактичний час, нуль на порожньому інтервалі, лічильник інтервалів"
layer: "domain"
deps: ["T1"]
blocks: ["T3"]
acs: ["AC-02", "AC-10"]
files_hint: ["components/encoders/encoders_core.c", "components/encoders/include/encoders_core.h", "test/host/test_encoders.c"]
owner: "Агент"
estimate: "S"
context_budget: "S"
status: "done"
step: "COMMIT"
---

<!-- To the executing agent: work from what is inlined here. If a slice is insufficient, ambiguous, or contradicts the code in front of you, open the named file for the full text and follow that. Do not invent the missing part. -->

# T2 — Додати в encoders_core швидкість колеса: приріст на фактичний час, нуль на порожньому інтервалі, лічильник інтервалів

## Place in the sequence

- **Blocked by:** T1 — Створити encoders_core: приріст за модулем 30000, знак колеса, 64-бітний накопичувач, обнулення через зсув · **Blocks:** T3 — Додати в encoders_core одиниці (оберти, об/хв, см, см/с), доступність коліс і тексти знімка, enc reset та рядка status · **Wave:** 2.
- **Lane:** спільні файли з T1, T3 — серіалізовано.

## Why (user story)

> **As a** Розробник
> **I want** бачити швидкість кожного колеса, поки ровер їде з пульта чи з консолі
> **So that** я бачу розкид між колесами й бортами числами і можу підготувати колеса до фази 5
>
> — `spec.md §4, US-02, verbatim` · full text: [spec.md](../spec.md)

Швидкість кожного колеса з номінальним інтервалом 20 мс — те, що Розробник бачить під час руху і що читатиме фаза 5.

## Inlined context

> Мітка вибірки — `esp_timer_get_time()` у мкс одразу після читання чотирьох лічильників; швидкість колеса = приріст останнього інтервалу / (мітка − попередня мітка), без утримання й усереднення; порожній інтервал одразу дає 0, тож нуль настає не пізніше ніж через 2 інтервали (40 мс) після останнього імпульсу (spec §6).
>
> — `sad.md §4, журнал припущень, verbatim` · full text: [sad.md](../sad.md)

> | Інтервал вимірювання швидкості | 20 мс (такт керування); відхилення окремого інтервалу ≤ 1 мс; за 10 с — 500 ± 1 інтервалів |
> | Нуль швидкості після зупинки | швидкість колеса = 0 не пізніше ніж через 2 інтервали (40 мс) після останнього імпульсу | хостовий тест із підставним годинником |
>
> — `spec.md §6, два рядки, abridged` · full text: [spec.md](../spec.md)

> **Hard rule:** Кожен компонент ділиться на `<name>_core.c` (без жодного заголовка ESP-IDF) і `<name>_hal.c`. Логіка живе в core і покривається тестами на хості.
>
> — `constitution.md, п. 6, abridged` · full text: [constitution.md](../../../constitution.md)

**Fallback:** insufficient or contradicted by the code → read the named file in full ([spec.md](../spec.md) · [sad.md](../sad.md) · [contracts/cli.md](../contracts/cli.md) · [adr/](../adr/)) and follow it. Do not guess.

## Data delta

No DB changes.

## API contract

Internal — no API surface.

## Acceptance criteria

### AC-02 (US-02) — happy path

> **Given** ровер озброєний з пульта, колеса в повітрі, напруга не нижче порога
> **When** Розробник тримає правий стік нерухомо повністю вперед (обидва борти на обмеженні потужності 0.75), показує щонайменше два знімки енкодерів під час руху, потім відпускає стік і, коли колеса зупинились, показує ще один знімок
> **Then** у знімках під час руху всі чотири колеса показують додатну швидкість в обертах колеса за хвилину, яка між знімками під час руху відрізняється не більше ніж на 10 %; у знімку після зупинки швидкість кожного колеса дорівнює нулю, а лічильники зберігають накопичене значення. Допуски діють для колеса, що дає щонайменше 20 імпульсів за інтервал вимірювання; колесо, яке на повному стіку не рушило або крутиться повільніше, — несправність заліза (§3), її записують у журнал bring-up, а не вважають провалом прошивки. Те, що швидкість стає нулем не пізніше ніж через два інтервали (40 мс) після останнього імпульсу, ручним знімком не видно — це перевіряє хостовий тест (AC-10)
>
> — `spec.md §5, AC-02, verbatim` · full text: [spec.md](../spec.md)

### AC-10 (US-06) — happy path

> **Given** Агент завершив зміну в межах фази 4
> **When** Агент запускає збірку проєкту і прогін хостових тестів
> **Then** збірка завершується без помилок і без нових попереджень, а прогін повідомляє кількість тестів і що всі пройдені; серед них перевірено: накопичення лічильника через апаратну межу в обидва боки (зокрема багаторазовий перехід і перехід з одночасним рухом), застосування знака кожного колеса, швидкість як приріст, поділений на фактичний час між вибірками, з підставним годинником (зокрема нерівні інтервали, нуль не пізніше ніж через два інтервали після останнього імпульсу й відсутність стрибка після обнулення), показ недоступного колеса поруч із доступними (AC-08), перерахунок в оберти, лінійну швидкість і відстань за виміряним діаметром і розбір команди енкодерів з усіма відхиленнями
>
> — `spec.md §5, AC-10, verbatim` · full text: [spec.md](../spec.md)

## Checklist

- [ ] Додати в стан мітку попередньої вибірки, лічильник інтервалів і швидкість в імпульсах за секунду на колесо — `encoders_core.h`
- [ ] Крок вибірки приймає мітку в мкс; швидкість = приріст / (мітка − попередня мітка); беззнакова різниця міток; нульовий проміжок не ділить на нуль — `encoders_core.c`
- [ ] Тести з підставними мітками: рівні й нерівні інтервали (19, 20, 21 мс), порожній інтервал → 0, зупинка → 0 не пізніше другого інтервалу, обнулення не змінює швидкість, лічильник інтервалів = 500 за 10 с — `test/host/test_encoders.c`

## Edge cases

| Case | Behaviour |
|---|---|
| дві вибірки з однаковою міткою | швидкість не обчислюється (лишається попередня), інтервал не рахується; без ділення на нуль |
| тремтіння такту 19–21 мс | швидкість однакова для однакового руху, бо ділиться на фактичний час |
| переповнення мітки в мкс | беззнакова різниця дає правильний проміжок |

## Definition of Done

- [ ] `test/host/run_tests.sh` зелений з тестами швидкості й лічильника інтервалів; `check_core_headers.sh` чистий; `idf.py build` без нових попереджень
- [ ] every Hard Rule inlined above still holds
- [ ] lint + vet clean (для C: збірка без нових попереджень і хостові скрипти)
