12romis/esp32-elrs-rover/docs/features/phase4-encoders/tasks/t3-encoders-core-units-format.md

---
id: T3
title: "Додати в encoders_core одиниці (оберти, об/хв, см, см/с), доступність коліс і тексти знімка, enc reset та рядка status"
layer: "domain"
deps: ["T2"]
blocks: ["T5"]
acs: ["AC-01", "AC-06", "AC-08"]
files_hint: ["components/encoders/encoders_core.c", "components/encoders/include/encoders_core.h", "test/host/test_encoders.c"]
owner: "Агент"
estimate: "M"
context_budget: "M"
status: "done"
step: "COMMIT"
---

<!-- To the executing agent: work from what is inlined here. If a slice is insufficient, ambiguous, or contradicts the code in front of you, open the named file for the full text and follow that. Do not invent the missing part. -->

# T3 — Додати в encoders_core одиниці (оберти, об/хв, см, см/с), доступність коліс і тексти знімка, enc reset та рядка status

## Place in the sequence

- **Blocked by:** T2 — Додати в encoders_core швидкість колеса: приріст на фактичний час, нуль на порожньому інтервалі, лічильник інтервалів · **Blocks:** T5 — Створити encoders_hal: 4 блоки лічильника з watch-point без callback, фільтр 1000 нс, задача 20 мс, стан під portMUX · **Wave:** 3.
- **Lane:** спільні файли з T1, T2 — серіалізовано.

## Why (user story)

> **As a** Розробник
> **I want** бачити лінійну швидкість і пройдену відстань кожного колеса
> **So that** я оцінюю рух ровера в сантиметрах, а не лише в обертах
>
> — `spec.md §4, US-04, verbatim` · full text: [spec.md](../spec.md)

Перерахунок у сантиметри й оберти та тексти, які Розробник читає в консолі, зокрема для недоступного колеса.

## Inlined context

> Знімок містить час від старту плати (мс) і лічильник інтервалів вимірювання від старту, а для кожного колеса (FL, FR, RL, RR) — лічильник у цілих імпульсах, оберти колеса з двома знаками після коми, швидкість в обертах колеса за хвилину з одним знаком, пройдену відстань у сантиметрах з одним знаком і лінійну швидкість у сантиметрах за секунду з одним знаком. Недоступне колесо замість значень має недоступність і причину (AC-08).
>
> — `spec.md §5, «Вміст знімка енкодерів», verbatim` · full text: [spec.md](../spec.md)

> | `enc reset` | частина коліс недоступна | що обнулено доступні колеса, і перелік недоступних |
> | жодне колесо не доступне | що обнуляти нічого, бо енкодери недоступні, з переліком |
> | `status` енкодери | «N з 4 доступні»; якщо N < 4 — назви недоступних коліс, без причини |
>
> — `contracts/cli.md, «Відповідь enc reset» і «status», abridged` · full text: [cli.md](../contracts/cli.md)

> **Hard rule:** Величини з розділу 9 документа `02-FIRMWARE-CONTEXT.md` не вигадуються. Якщо потрібна константа, якої немає в `docs/measured.md` — зупинитись і назвати, якого заміру бракує.
>
> — `constitution.md, п. 3, abridged` · full text: [constitution.md](../../../constitution.md)

> **Hard rule:** Кожен компонент ділиться на `<name>_core.c` (без жодного заголовка ESP-IDF) і `<name>_hal.c`. Логіка живе в core і покривається тестами на хості.
>
> — `constitution.md, п. 6, abridged` · full text: [constitution.md](../../../constitution.md)

**Fallback:** insufficient or contradicted by the code → read the named file in full ([spec.md](../spec.md) · [sad.md](../sad.md) · [contracts/cli.md](../contracts/cli.md) · [adr/](../adr/)) and follow it. Do not guess.

## Data delta

No DB changes.

## API contract

Internal — no API surface.

## Acceptance criteria

### AC-01 (US-01) — happy path

> **Given** ровер у DISARMED (мотори вимкнені, STBY внизу), Розробник обнулив лічильники командою енкодерів
> **When** Розробник прокручує одне колесо рукою рівно на 10 обертів у напрямку «ровер їде вперед», показує знімок енкодерів, а потім прокручує те саме колесо на 10 обертів назад і знову показує знімок
> **Then** після руху вперед лічильник цього колеса показує +27720 імпульсів з допуском ±2 % (10.0 обертів ± 0.2), після руху назад повертається до нуля з тим самим допуском; лічильники трьох інших коліс лишаються в нулі; так для кожного з чотирьох коліс, а колеса в знімку названі як FL, FR, RL, RR відповідно до свого положення на шасі
>
> — `spec.md §5, AC-01, verbatim` · full text: [spec.md](../spec.md)

### AC-06 (US-04) — happy path

> **Given** діаметр колеса взято з журналу вимірювань (44 мм), ровер стоїть на підлозі на початку відрізка 1 м, відміряного рулеткою, лічильники обнулено
> **When** Розробник проїжджає з пульта по прямій на малій тязі до кінця відрізка й показує знімок енкодерів
> **Then** знімок для кожного колеса показує пройдену відстань і лінійну швидкість; середнє з пройдених відстаней чотирьох коліс відрізняється від 1 м не більше ніж на 5 %; під час руху лінійна швидкість кожного колеса дорівнює його швидкості в обертах, помноженій на довжину кола колеса
>
> — `spec.md §5, AC-06, verbatim` · full text: [spec.md](../spec.md)

### AC-08 (US-05) — error

> **Given** при старті плати хоча б один енкодер не вдалося налаштувати (збій ініціалізації лічильника чи фільтра завад)
> **When** плата завершує старт, а Розробник показує стан, знімок енкодерів і озброює ровер
> **Then** недоступним вважається лише колесо, енкодер якого не налаштувався: журнал старту називає це колесо і причину збою, показ стану — скільки енкодерів доступно і які колеса недоступні (без причини), а у знімку енкодерів рядок такого колеса пише недоступність і причину замість значень (жодних хибних нулів, що виглядають як виміряні), тоді як решта коліс показують свої значення як звичайно; обнулення лічильників обнуляє доступні колеса і нагадує, які недоступні; ровер не перезавантажується, озброюється й їздить як у фазі 3, бо в цій фазі енкодери не беруть участі в керуванні. Викликати такий збій на залізі нічим, тож цей критерій приймається хостовим тестом логіки показу й оглядом коду, а не на залізі
>
> — `spec.md §5, AC-08, verbatim` · full text: [spec.md](../spec.md)

## Checklist

- [ ] Ознака доступності й рядок причини на колесо; функція позначення колеса недоступним — `encoders_core.h`, `encoders_core.c`
- [ ] Перерахунок: оберти = лічильник / 2772; об/хв = швидкість × 60 / 2772; см = оберти × π × 44 / 10; см/с — так само від швидкості — `encoders_core.c`
- [ ] Форматування знімка у буфер виклику: заголовок, далі FL, FR, RL, RR; недоступне колесо — «недоступне» і причина, без нулів — `encoders_core.c`
- [ ] Тексти відповіді `enc reset` (усі доступні / частина / жодне) і рядка `status` — `encoders_core.c`
- [ ] Тести: 27720 імпульсів = 10.00 оберта і ≈ 138.2 см, точність форматів, недоступне колесо поруч із доступними, три варіанти `enc reset`, рядок `status`, обрізання за малим буфером — `test/host/test_encoders.c`

## Edge cases

| Case | Behaviour |
|---|---|
| буфер менший за знімок | текст обрізається без виходу за межі буфера, функція повертає записану довжину |
| усі колеса недоступні | знімок має чотири рядки недоступності; `enc reset` — «обнуляти нічого» |
| від'ємні значення при русі назад | знак мінус у всіх полях колеса |

## Definition of Done

- [ ] `test/host/run_tests.sh` зелений з тестами одиниць, форматів і недоступності; `check_core_headers.sh` чистий; `idf.py build` без нових попереджень
- [ ] every Hard Rule inlined above still holds
- [ ] lint + vet clean (для C: збірка без нових попереджень і хостові скрипти)
