12romis/esp32-elrs-rover/docs/features/phase3-crsf/_review/review-2026-10-18.md

# Review — phase3-crsf — 2026-10-18

- **Gate:** CHANGES REQUESTED — 4 знахідки stage-1 (F2–F5) і 2 stage-2 (F1, F6), усі «Fix now»
- **Reviewer:** незалежний `sdd:reviewer` (clean context, read-only), модель opus, effort high (розмір S, маршрут quick)
- **Base:** `f2597b5` (точка відгалуження від `main`) → `96e5840` (HEAD гілки `feature/phase3-crsf`)

## Scope

Diff `f2597b5..96e5840`: 55 файлів, +5142 / −48. Код і тести — 27 файлів, +2221 / −44:

- нові: `components/crsf/crsf_core.c`, `crsf_hal.c`, `include/crsf_core.h`, `crsf_hal.h`, `crsf_calib.h`; `test/host/test_crsf.c`, `test/host/check_delays.sh`;
- змінені: `components/app_state/*`, `components/drive/*`, `components/rover_console/*`, `components/ui/ui_core.c`, `main/main.c`, `test/host/test_app_state.c`, `test_console.c`, `test_drive.c`, `test_ui.c`, `test/host/README.md`.

Решта — документи фічі (`spec.md`, `sad.md`, ADR-0001…0003, `contracts/`, `tasks/`, `tasks.json`, `acceptance.md`), `docs/measured.md`, `docs/roadmap.md`.

Поза оглядом: незакомічена зміна `tools/bringup/main/main.c` (`BRINGUP_TEST 7 → 5`) у робочому дереві — не частина фічі.

Задачі T7, T9, T10 у трекері мають статус `review` — очікують приймання на залізі за `acceptance.md` (AC-20).

## Findings
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
