12romis/esp32-elrs-rover/docs/features/phase2-io/adr/0001-own-i2c-bus-in-separate-component-with-testable-scan-logic.md

---
status: Accepted
owner: "Розробник проєкту"
reviewers: ["Розробник проєкту"]
updated_at: "2026-10-18"
feature_size: "S"
ticket: "roadmap, крок 2 (phase2-io)"
---

# 0001 — Own the I2C bus in a separate component with testable scan logic

- **Status:** Accepted
- **Date:** 2026-10-18
- **Deciders:** Архітектор + Розробник (відповідь на питання design, 2026-10-18)

## Context

Шину периферії фаза 2 піднімає вперше (розширювач портів), а фаза 6 підключить до неї чотири далекоміри; документ 02 (§6.2) вимагає один мʼютекс `m_i2c` на всіх. Власника шини треба вибрати зараз, бо від цього залежать залежності між компонентами. Конституція (п. 6) вимагає для кожного компонента окремих core і HAL.

## Decision drivers

- Шина 100 кГц і спільний мʼютекс на всіх користувачів (конституція, п. 14; документ 02, §4.6, §6.2).
- Кожен компонент ділиться на core без заголовків ESP-IDF і HAL (конституція, п. 6).
- `tof` у фазі 6 не повинен залежати від розширювача заради шини.

## Considered options

1. **Окремий компонент `i2c_bus`:** HAL дає шину й мʼютекс, core — логіка результату скану; `ioexp` і `tof` користуються нею.
2. **Шина в `ioexp`:** `ioexp_hal` створює шину й мʼютекс і передає їх `tof` пізніше.

## Decision outcome

**Chosen:** Option 1. `i2c_bus_hal` створює шину 100 кГц і мʼютекс `m_i2c`; `i2c_bus_core` розбирає результат скану (чи є очікувана адреса, рядок журналу) і тестується на хості, тож компонент має справжню core-частину. Варіант 2 змусив би `tof` залежати від компонента світла заради шини й змішав би двох власників.

## Consequences

**Positive**
- `tof` у фазі 6 підключається до готової шини без залежності від `ioexp`.
- Логіка скану перевіряється на хості.

**Negative**
- Ще один компонент, якого немає в переліку документа 02 §6.4.

**Neutral**
- Рядок про `i2c_bus` у документі 02 додається за вказівкою Розробника.

## Links

- Spec: [[../spec.md]] (AC-02, AC-14, §6)
- SAD: [[../sad.md]] §4, §5
- Related ADR: [[0003-write-zero-first-and-degrade-when-expander-unconfirmed]]
