12romis/esp32-elrs-rover/BOM_rover_PCB_vs_noPCB.xlsx

Sheet: BOM
# | Категорія | Позиція | Варіант Б — З PCB (плата-носій) | К-ть | Тип монтажу | Як паяти | Складність 1-5 | Статус | Коментар
1 | Привід | Мотор-редуктор з енкодером | Те саме | 4 | Дріт / роз'єм ZH1.5 6-pin | Не паяється (роз'єм) | 1 | Отримано (https://www.aliexpress.com/item/1005010035624141.html) | Механіка не залежить від того, як зроблена електроніка. Енкодер живимо 3.3V.
2 | Привід | Колеса | Те саме | 4 | Механіка | — | 1 | Отримано (https://www.aliexpress.com/item/32640734784.html) | Механіка.
3 | Керування | Передавач ELRS | Те саме | 1 | Готовий пристрій | — | 1 | Наявний | Пульт. До плати відношення не має.
4 | Ввід | Тактова кнопка 6x6 | Впаюється в плату (THT) | 1 | THT | Паяльник | 1 | Отримано (https://www.aliexpress.com/item/1005010503427014.html) | Reset / вибір режиму. 4 виводи в отвори — найпростіша пайка.
5 | Живлення | Плата заряджання 2S Type-C | Окремим модулем (не на PCB) | 1 | Дріт | Паяльник (дроти) | 1 | Отримано (https://www.aliexpress.com/item/1005012178315741.html) | Захисту розряду НЕ має — окремий BMS обов'язковий. Варто підключити ntc трансмітор – чорна смола на двох дротах в наборі від beetroot
6 | Контролер | Головний MCU | ESP32-S3 DevKitC-1 у ГНІЗДА (female header 1x22 x2) | 1 | Модуль на гребінці | Паяльник (тільки гребінки) | 1 | Отримано (https://www.aliexpress.com/item/1005012382216180.html) | НЕ інтегруємо WROOM-1 на плату: це тягне USB-C, LDO, ESD, boot-схему = 6+ SMD. DevKit у гніздах знімається і замінюється за 10 сек.
7 | Керування | ELRS приймач CRSF | Той самий, у роз'єм 4-pin (5V/GND/TX/RX) | 1 | Модуль на роз'ємі | Паяльник (роз'єм) | 1 | Отримано (https://www.aliexpress.com/item/1005011758967854.html) | Екранований і сертифікований — інтегрувати немає сенсу. UART2 (GPIO16/17).
8 | Привід | Драйвер моторів | Модуль TB6612FNG у гнізда (1x8 female x2 на модуль) | 2 | Модуль на гребінці | Паяльник | 1 | Отримано (https://www.aliexpress.com/item/1005009897969818.html?) | Чип TB6612 = SSOP-24, крок 0.65 мм.
9 | Сенсори | ToF далекомір | Той самий, у роз'єм 5-pin (VCC/GND/SDA/SCL/XSHUT) | 4 | Модуль на роз'ємі | Паяльник (роз'єм) | 1 | Отримано (https://www.aliexpress.com/item/1005012456139246.html) | Голий VL53L0X — оптичний LGA12, тільки піч + ІЧ-прозоре вікно. Вдома НЕМОЖЛИВО. Модуль виносимо на бампер шлейфом.
10 | Живлення | Понижувач 5V | Той самий модуль у гнізда, АБО модуль з фікс. 5V без підстроєчника | 1 | Модуль на гребінці | Паяльник | 1 | Отримано (https://www.aliexpress.com/item/1005009121517851.html) | Чип MP1584EN = SOIC-8 з тепловим пятаком під корпусом — паяльником не береться. Модуль вирішує питання. Фіксований 5V надійніший (підстроєчник може зсунутись від вібрації).
11 | Живлення | Li-ion банки 18650 | Те саме | 2 | Холдер | Не паяти напряму! | 2 | ЗАМОВИТИ | Купуєш локально. Паяти банки напряму — тільки точковим зварюванням або через холдер.
12 | Живлення | Холдер 2S 18650 | З дротами -> XT30 | 1 | Дріт | Паяльник | 1 | Наявний | Є 2 шт 1s, треба буде поєднати
13 | Живлення | BMS 2S >=5A | Те саме | 1 | Дріт | Паяльник | 2 | Отримано (https://www.aliexpress.com/item/1005006041486774.html)
15 | Живлення | Роз'єм живлення | XT30 male THT на плату | 1 | THT | Паяльник (жало-ніж, 350°C) | 2 | Отримано (https://www.aliexpress.com/item/1005003079741038.html) | XT30 механічно ПОЛЯРИЗОВАНИЙ -> захист від переполюсовки не потрібен, економимо MOSFET. Великі падси — грій довше.
16 | Живлення | Тримач запобіжника + запобіжник 5A | THT тримач на платі | 1 | THT | Паяльник | 1 | Отримано (https://www.aliexpress.com/item/1005002366366037.html)
17 | Живлення | Провід силовий 22AWG | Те саме, коротші відрізки | 2 | — | Паяльник | 1 | Отримано (https://www.aliexpress.com/item/1005001698292417.html?) | 26AWG занадто тонкий — підтверджено раніше.
ПАСИВНІ КОМПОНЕНТИ — для варіанту з PCB беремо ВИВІДНІ (THT), а не SMD
18 | Фільтрація | Електроліт 1000uF 16V | THT на плату, біля драйверів | 2 | THT | Паяльник | 1 | Наявний | Буфер моторної шини проти просадки при старті (brown-out ESP32). Заміню на мій 1000 мкФ 35 В, головне врахувати розміри
19 | Фільтрація | Кераміка 10uF | THT на шини 5V і 3.3V | 6 | THT | Паяльник | 1 | Отримано (https://www.aliexpress.com/item/1005007464553853.html) | взято 0805 10uF X7R 16V
20 | Фільтрація | Кераміка 100nF (X7R) 2.54 | THT біля кожного VCC | 10 | THT | Паяльник | 1 | Отримано (https://www.aliexpress.com/item/1005012442289329.html) | Не формальність — 90% зависань MCU лікуються цим.
21 | Фільтрація | Кераміка 100nF на клеми моторів | Припаяти ПРЯМО на мотор (не на плату!) | 4 | Навісний | Паяльник | 2 | У кошику алі (https://www.aliexpress.com/item/1005012442289329.html) | На платі вони майже не працюють — придушувати іскріння щіток треба в точці виникнення.
22 | I2C | Резистор 4.7k 0.25W | THT, підтяжка SDA/SCL | 2 | THT | Паяльник | 1 | Не треба | На далекомірах вони уже є, також можна підтягнути з esp, проте варто на платі передбачити посадкові місця. 10 кОм як заміна підійде
23 | Індикація | Резистор 220 Ом | THT, обмеження струму LED | 2 | THT | Паяльник | 1 | Наявний
24 | Логіка | Резистор 10k | THT, підтяжки STBY / кнопка | 4 | THT | Паяльник | 1 | Наявний
25 | Телеметрія | Дільник напруги: резистори 100k + 33k | THT -> на ADC ESP32 | 1 | THT | Паяльник | 1 | Наявний | НОВЕ: моніторинг напруги батареї. Дешевий бал за телеметрію і за критерій 'обробка аварійних станів'.
26 | Індикація | LED 5мм (2 кольори) | THT на плату | 2 | THT | Паяльник | 1 | Наявний | armed / failsafe. RGB на ісп для індикації, можливо вивести фари
27 | Індикація | Зумер пасивний THT + транзистор 2N3904 + резистор 1k | THT на плату | 1 | THT | Паяльник | 1 | Отримано (https://www.aliexpress.com/item/1005010400627387.html) | НОВЕ: звуковий failsafe / lost model alarm. Дуже виграшно виглядає на захисті.
 |  | транзистор 2N3904 для зумера | THT на плату | 1 | THT | Паяльник | 1 | Наявний | Можна замінити BC547 або ST2N2222A із комплекту beetroot
 |  | резистор 1k для зумера | THT на плату | 1 | THT | Паяльник | 1 | Наявний
28 | Захист | TVS-діод P6KE12A (виводний) | THT на вході живлення | 1 | THT | Паяльник | 1 | Отримано (https://www.aliexpress.com/item/1005007996072434.html) | Гасить викиди від моторів. Виводний корпус — паяльник, без варіантів.
29 | Захист | Діод Шотткі SS34 (40V 3A) | SMA послідовно на виході 5V MP1584, катодом до плати | 3 | SMD SMA (2 великі падси) | Паяльник, 320 °C | 2 | Отримано (https://www.aliexpress.com/item/1005012302055887.html) | Розв'язка USB і батареї: не дає струму текти назад у понижувач при одночасному підключенні. НЕ плутати з TVS — той стоїть паралельно на вході, цей послідовно на виході. УВАГА: падіння ~0.35 В, тому MP1584 виставляти на 5.4 В, а не 5.0 В — після діода вийде 5.05 В. Виводна альтернатива: 1N5822 (DO-41).
33 | PCB | Друкована плата 2 шари | JLCPCB, ~100x100 мм, 1.6 мм, HASL, 5 шт | 5 | — | — | 3 | ЗАМОВИТИ | ~$2 за 5 шт + доставка. Замовляй 5 — одна піде на помилки. Термін в Україну 2-3 тижні.
34 | PCB | Гнізда female header 2.54, 1x22 | Під ESP32-S3 DevKitC-1 | 2 | THT | Паяльник | 2 | Отримано (https://www.aliexpress.com/item/4001198421663.html) | Лайфхак: вставити DevKit у гнізда, потім паяти — гарантія співвісності.
35 | PCB | Гнізда female header 2.54, 1x8 | Під модулі TB6612 (2 на модуль) | 4 | THT | Паяльник | 2 | У кошику алі
36 | PCB | Гребінка male header 2.54 (набір) | MP1584, ELRS, тест-поїнти, перемички | 1 | THT | Паяльник | 1 | Ідуть із модулями
37 | PCB | Роз'єм ZH1.5 6-pin THT (top entry) | Під шлейфи моторів з енкодерами | 4 | THT | Паяльник, жало-голка | 3 | Ідуть з моторами
38 | PCB | Клемник гвинтовий 2-pin 3.5/5.08 мм | Резерв замість ZH1.5, або живлення | 4 | THT | Паяльник | 1 | ОПЦІЙНО | Це для моторів планувалось, але або напряму до плати підпаяю а розєм буде біля мотору або візьму гніздо ph2.0, якого замовив більше
39 | PCB | Роз'єм 5-pin 2.54 (JST-XH або гребінка) | Під ToF-модулі далекоміри (VCC/GND/SDA/SCL/XSHUT) | 3 | THT | Паяльник | 1 | Отримано (https://www.aliexpress.com/item/1005007390256653.html) | це для далекомірів, взяв 5 Sets Micro JST 2.0mm PH2.0
40 | PCB | Стійки нейлонові M3 + гвинти | Кріплення плати до шасі (Onshape) | 4 | Механіка | — | 1 | Перевірити | Отвори M3 закласти в KiCad і звірити зі STEP-моделлю шасі.
41 | FPV | AIO камера + відеопередавач 5.8 ГГц (аналог) | Окремий модуль на щоглі, живлення від власного MP1584EN | 1 | Дріт / пігтейл | Паяльник (дроти) | 1 | Отримано | Повністю незалежний від ESP32 тракт: камера -> VTX -> окуляри. ПЕРЕВІРИТИ вхідну напругу в описі: є версії 7-24 В — тоді другий понижувач не потрібен взагалі. Струм 0.25 А (25 мВт) ... 0.6 А (400 мВт). Антену рознести з ELRS мінімум на 8-10 см.
42 | FPV | Понижувач MP1584EN #2 (РЕГУЛЬОВАНИЙ) | Модуль у гнізда, виставити рівно 5.0 В | 1 | Модуль на гребінці | Паяльник | 1 | Отримано | Окрема рейка для VTX: ВЧ-шум і кидки струму передавача не повинні лізти на шину I2C далекомірів. Виставити ДО підключення VTX, під навантаженням. Тут 5.0 В, а не 5.4 В — діода SS34 в цій гілці немає.
43 | FPV | P-MOSFET AO3401A (SOT-23) | SMD на плату, ключ у ПЛЮСІ 8.4 В | 2 | SMD SOT-23 | Паяльник, 320 °C | 2 | ЗАМОВИТИ | Верхнє плече. Ключ у мінусі тут НЕ працює: MP1584EN неізольований, вхідна і вихідна земля — один вузол, струм піде повз транзистор. Брати 2 шт (одна на помилку).
44 | FPV | Транзистор BC547 — драйвер затвора VTX | THT, поруч із AO3401A | 1 | THT | Паяльник | 1 | Наявний | Інвертує 3.3 В з GPIO42 у Vgs = −8.4 В. З комплекту Beetroot. Другий екземпляр окрім того, що на зумері.
45 | FPV | Резистор 10k (Rgs + база BC547) | THT | 2 | THT | Паяльник | 1 | Наявний | 10k затвор-витік тримає P-MOSFET закритим при відсутності сигналу; 10k послідовно в базі BC547.
46 | FPV | Резистор 100k (база — GND) | THT | 1 | THT | Паяльник | 1 | Наявний | Визначений стан ключа, поки ESP32 у ресеті або не прошитий. Без нього база 'висить' і VTX може ввімкнутись самовільно.
47 | FPV | Електроліт 470-1000 uF 16V (вхід MP1584 #2) | THT, ПІСЛЯ ключа | 1 | THT | Паяльник | 1 | Наявний | Ставити саме після MOSFET, інакше конденсатор заряджається постійно і ключ не вимикає навантаження. Кидок струму при вмиканні AO3401A тримає спокійно.
48 | FPV | Роз'єм живлення VTX (PH2.0 2-pin або XT30) | THT на плату, вихід 5.0 В | 1 | THT | Паяльник | 1 | Отримано | Під пігтейл AIO-модуля. Промаркувати полярність на шовкографії — переполюсовка вбиває VTX миттєво.
49 | Логіка | Розширювач портів PCF8574 (модуль I2C) | Модуль у гнізда, адреса 0x20 (A0/A1/A2 = GND) | 1 | Модуль на гребінці | Паяльник | 1 | Отримано | КЛЮЧОВА ДОДАНА ПОЗИЦІЯ. Звільняє 4 GPIO: усі лінії XSHUT переїжджають на нього. Сідає на існуючу шину I2C — жодного нового піна ESP32. Окрема компетенція 'розширення I/O по I2C' для захисту. Виходи квазідвонаправлені (~100 мкА у '1') — для XSHUT достатньо, для затвора MOSFET ні.
50 | PCB | Гнізда female header 2.54, 1x8 (під PCF8574) | +2 шт понад ті, що для TB6612 | 2 | THT | Паяльник | 2 | Отримано | Модуль PCF8574 має два ряди по 8. Разом із TB6612 виходить 6 шт 1x8.
53 | Індикація | Фари: LED білий 5мм + резистор 220 Ом | Винос на передній бампер, керування з PCF8574 P4 | 2 | THT | Паяльник | 1 | Наявний | Перепризначити ті 2 LED, що вже в BOM (поз. 26). PCF8574 у режимі СТОКУ тягне до 25 мА на пін — зовнішній ключ не потрібен, LED катодом до піна, анодом через резистор до 3.3 В.
54 | Індикація | Стоп-сигнал / задній LED червоний + резистор | Задній бампер, PCF8574 P5 | 1 | THT | Паяльник | 1 | Отримано | Вмикається при гальмуванні і реверсі. Дешевий, але помітний пункт на демонстрації.
56 | Фільтрація | Кераміка 100nF THT — дозамовити | +5 до наявних | 5 | THT | Паяльник | 1 | Отримано | Додались точки: MP1584 #2 (вхід і вихід), PCF8574, VTX-роз'єм, 4-й ToF.

Sheet: Інструменти
# | Інструмент / витратник | Навіщо | Обов'язково? | У тебе є? | Приблизна ціна | Коментар
1 | Паяльник з набором жал | Основне | ОБОВ'ЯЗКОВО | Є | — | Для THT потрібне жало-скос (C4) або міні-хвиля. Голка — тільки для ZH1.5.
2 | Припій | Основне | ОБОВ'ЯЗКОВО | Є | — | Sn60Pb40 0.8 мм для THT. Безсвинцевий не бери — важче.
3 | Флюс | Основне | ОБОВ'ЯЗКОВО | Є | — | Уточни який: рідкий підійде для THT.
4 | Гелевий флюс no-clean у шприці (Amtech/MECHANIC) | Роз'єми ZH1.5, будь-який SMD, виправлення | ОБОВ'ЯЗКОВО | НІ | $3-5 | Гель не розтікається — критично для дрібних роз'ємів. Рідкий флюс тут гірший.
5 | Оплетка для видалення припою 2.0 мм | Прибрати перемички між пінами | ОБОВ'ЯЗКОВО | НІ | $2 | Найдешевша страховка від зіпсованої плати.
6 | Мультиметр з прозвонкою | Прозвонка КЗ ДО подачі живлення, налаштування 5.0V на MP1584 | ОБОВ'ЯЗКОВО | ? | $10-20 | Без нього першу подачу живлення робити не можна.
7 | Лупа: USB-мікроскоп 1000x АБО настільна лупа з LED | Контроль пайки, читання маркування | ОБОВ'ЯЗКОВО | НІ | $15-25 | USB-мікроскоп кращий за лупу: руки вільні, можна знімати фото для звіту/презентації.
8 | Пінцет ESD (прямий + загнутий) | Утримання деталей | ОБОВ'ЯЗКОВО | НІ | $3
9 | Бокорізи flush cutters | Відкусити виводи THT врівень з платою | ОБОВ'ЯЗКОВО | НІ | $4 | Звичайні кусачки залишають 'пеньки' і рвуть падси.
10 | Ізопропанол 99% + щіточка | Змити флюс після пайки | ОБОВ'ЯЗКОВО | НІ | $3 | Незмитий флюс = витік струму по I2C, плаваючі глюки.
11 | Тримач плати / 'третя рука' з затискачами | Фіксація плати | Дуже бажано | НІ | $5-10
12 | Силіконовий термокилимок | Не спалити стіл, лунки для гвинтів | Бажано | НІ | $5
13 | Каптонова стрічка | Тимчасова фіксація деталей і роз'ємів | Бажано | НІ | $2
14 | Лабораторний БЖ з обмеженням струму | Перше вмикання плати | Дуже бажано | НІ | $30-50 | АЛЬТЕРНАТИВА БЕЗКОШТОВНО: увімкнути через резистор 10 Ом 5W послідовно з плюсом. Якщо КЗ — резистор обмежить струм замість того, щоб згоріли доріжки.
15 | Вентилятор / витяжка на стіл | Не дихати каніфоллю і свинцем | Бажано | НІ | $0-20 | Здоров'я. Хоч звичайний настільний вентилятор убік.
16 | Помпа-відсмоктувач олова | Розпаяти THT-деталь | Опційно | НІ | $3 | Якщо є оплетка — можна без неї.
17 | Паяльна паста Sn63Pb37 у шприці | SMD феном або трафаретом | НЕ ПОТРІБНА для обраного варіанту | НІ | $8 | Потрібна ТІЛЬКИ якщо паяєш SMD феном. Для THT і гребінок — марна. Зберігати в холодильнику, термін ~6 міс.
18 | Фен паяльної станції (858D / 8858 тощо) | SMD-монтаж і демонтаж | НЕ ПОТРІБЕН для обраного варіанту | ? | $25-40 | Див. відповідь про твій фен у чаті. Промисловий фен для термоусадки НЕ підходить для SMD.

Sheet: План робіт
Етап | Що робимо | Термін | Блокує наступний етап? | Ризик / примітка
0 | Зібрати робочий прототип на макетці. Прошивка: CRSF, PWM 75%, енкодери, 3x ToF з XSHUT, arm/disarm, failsafe | 1-2 тижні | ТАК — критично | PCB фіксує розпіновку назавжди. Помилка тут = +3 тижні очікування нової плати.
1 | Схема в KiCad: блоки живлення / MCU / драйвери / сенсори / роз'єми. ERC до нуля | 2-3 дні | ТАК | Модулі малюємо як гребінки — символи прості.
2 | Футпринти: звірити КОЖЕН по datasheet, згенерувати 3D | 1 день | ТАК | Дзеркальний або неправильний крок роз'єму — найчастіша помилка новачка.
3 | Розводка 2 шари: моторні доріжки >=1.5 мм, логіка 0.25 мм, полігон GND, 100nF впритул до VCC | 3-5 днів | ТАК | DRC до нуля. Розділити силову і логічну землі, з'єднати в одній точці.
4 | Експорт STEP -> вставити в збірку Onshape, звірити отвори M3 і габарити роз'ємів | 0.5 дня | ТАК | Дешево зловити механічний конфлікт саме тут.
5 | Gerber -> JLCPCB, 5 шт. Замовити паралельно всю дрібноту з таблиці 'Інструменти' | 1 день + 2-3 тижні очікування | — | Поки їде плата — доводиш прошивку на макетці.
6 | Bring-up за порядком: прозвонка КЗ -> живлення без модулів -> заміряти 5V/3.3V -> MCU -> периферія | 1 день | ТАК | НІКОЛИ не вставляй ESP32 у плату, поки не заміряв 5.0V на гніздах мультиметром.
7 | Перенос прошивки, калібрування, errata v1 -> перемички МГТФ | 3-5 днів | — | Задокументовану errata на захисті сприймають ДОБРЕ — це показує інженерне мислення.
8 | README, схема в PDF, фото плати під мікроскопом, презентація, документ самоперевірки >=80% | 2-3 дні | — | Фото з USB-мікроскопа сильно прикрашають презентацію.
