12romis/esp32-elrs-rover/kicad-rover/bom-kicad-rover.csv

Reference | Qty | Value | DNP | Exclude from BOM | Exclude from Board | Exclude from Simulation | Exclude from Position Files | Footprint | Datasheet
BZ1 | 1 | Buzzer |  |  |  |  | ${EXCLUDE_FROM_POS_FILES} | Buzzer_Beeper:Buzzer_12x9.5RM7.6
C1,C4,C5,C6,C10,C11,C14,C15,C16,C18,C20,C21,C24,C25,C26,C28,C29 | 17 | 100nF |  |  |  |  | ${EXCLUDE_FROM_POS_FILES} | Capacitor_THT:C_Disc_D5.0mm_W2.5mm_P5.00mm
C3 | 1 | 1000µF/35V |  |  |  |  | ${EXCLUDE_FROM_POS_FILES} | Capacitor_THT:CP_Radial_D12.5mm_P5.00mm
C8,C12,C13,C23 | 4 | 10µF |  |  |  |  | ${EXCLUDE_FROM_POS_FILES} | Capacitor_SMD:C_0805_2012Metric
C27 | 1 | 470µF |  |  |  |  | ${EXCLUDE_FROM_POS_FILES} | Capacitor_THT:CP_Radial_D12.5mm_P5.00mm
D1 | 1 | P6KE12A |  |  |  |  | ${EXCLUDE_FROM_POS_FILES} | Diode_THT:D_DO-15_P12.70mm_Horizontal
D2 | 1 | SS34 |  |  |  |  | ${EXCLUDE_FROM_POS_FILES} | Diode_SMD:D_SMA
D3 | 1 | 1N4007 |  |  |  |  | ${EXCLUDE_FROM_POS_FILES} | Diode_THT:D_DO-41_SOD81_P10.16mm_Horizontal | http://www.vishay.com/docs/88503/1n4001.pdf
J1 | 1 | XT30_8V4 |  |  |  |  | ${EXCLUDE_FROM_POS_FILES} | Connector_Wire:SolderWire-2.5sqmm_1x02_P8.8mm_D2.4mm_OD4.4mm
J2 | 1 | LED_L |  |  |  |  | ${EXCLUDE_FROM_POS_FILES} | Connector_JST:JST_PH_B2B-PH-K_1x02_P2.00mm_Vertical
J3 | 1 | LED_R |  |  |  |  | ${EXCLUDE_FROM_POS_FILES} | Connector_JST:JST_PH_B2B-PH-K_1x02_P2.00mm_Vertical
J4 | 1 | VTX_8V4 |  |  |  |  | ${EXCLUDE_FROM_POS_FILES} | Connector_JST:JST_PH_B2B-PH-K_1x02_P2.00mm_Vertical
J5 | 1 | REAR_LED_L |  |  |  |  | ${EXCLUDE_FROM_POS_FILES} | Connector_JST:JST_PH_B3B-PH-K_1x03_P2.00mm_Vertical
J6 | 1 | REAR_LED_R |  |  |  |  | ${EXCLUDE_FROM_POS_FILES} | Connector_JST:JST_PH_B3B-PH-K_1x03_P2.00mm_Vertical
J7 | 1 | ELRS |  |  |  |  | ${EXCLUDE_FROM_POS_FILES} | Connector_JST:JST_PH_B4B-PH-K_1x04_P2.00mm_Vertical
J8 | 1 | SPARE GPIO |  |  |  |  | ${EXCLUDE_FROM_POS_FILES} | Connector_PinHeader_2.54mm:PinHeader_1x06_P2.54mm_Vertical
M1 | 1 | front_left |  |  |  |  | ${EXCLUDE_FROM_POS_FILES} | Connector_JST:JST_PH_B6B-PH-K_1x06_P2.00mm_Vertical
M2 | 1 | back_left |  |  |  |  | ${EXCLUDE_FROM_POS_FILES} | Connector_JST:JST_PH_B6B-PH-K_1x06_P2.00mm_Vertical
M3 | 1 | front_right |  |  |  |  | ${EXCLUDE_FROM_POS_FILES} | Connector_JST:JST_PH_B6B-PH-K_1x06_P2.00mm_Vertical
M4 | 1 | back_right |  |  |  |  | ${EXCLUDE_FROM_POS_FILES} | Connector_JST:JST_PH_B6B-PH-K_1x06_P2.00mm_Vertical
Q3,Q4,Q5,Q6 | 4 | BC547 |  |  |  |  | ${EXCLUDE_FROM_POS_FILES} | Package_TO_SOT_THT:TO-92_Inline
R1 | 1 | 100k |  |  |  |  | ${EXCLUDE_FROM_POS_FILES} | Resistor_THT:R_Axial_DIN0207_L6.3mm_D2.5mm_P7.62mm_Horizontal
R4 | 1 | 33k |  |  |  |  | ${EXCLUDE_FROM_POS_FILES} | Resistor_THT:R_Axial_DIN0207_L6.3mm_D2.5mm_P7.62mm_Horizontal
R7 | 1 | 4.7k |  |  |  |  | ${EXCLUDE_FROM_POS_FILES} | Resistor_THT:R_Axial_DIN0207_L6.3mm_D2.5mm_P7.62mm_Horizontal
R8,R9,R14,R15 | 4 | 220 |  |  |  |  | ${EXCLUDE_FROM_POS_FILES} | Resistor_THT:R_Axial_DIN0207_L6.3mm_D2.5mm_P7.62mm_Horizontal
R10,R13 | 2 | 2.2k |  |  |  |  | ${EXCLUDE_FROM_POS_FILES} | Resistor_THT:R_Axial_DIN0207_L6.3mm_D2.5mm_P7.62mm_Horizontal
R11,R12 | 2 | 150 |  |  |  |  | ${EXCLUDE_FROM_POS_FILES} | Resistor_THT:R_Axial_DIN0207_L6.3mm_D2.5mm_P7.62mm_Horizontal
R16 | 1 | 10k |  |  |  |  | ${EXCLUDE_FROM_POS_FILES} | Resistor_THT:R_Axial_DIN0207_L6.3mm_D2.5mm_P7.62mm_Horizontal
R17,R19 | 2 | 4.7k | DNP |  |  |  | ${EXCLUDE_FROM_POS_FILES} | Resistor_THT:R_Axial_DIN0207_L6.3mm_D2.5mm_P7.62mm_Horizontal
R18 | 1 | 1k |  |  |  |  | ${EXCLUDE_FROM_POS_FILES} | Resistor_THT:R_Axial_DIN0207_L6.3mm_D2.5mm_P7.62mm_Horizontal
TP1 | 1 | +VBAT |  |  |  |  | ${EXCLUDE_FROM_POS_FILES} | TestPoint:TestPoint_THTPad_D1.5mm_Drill0.7mm
TP2 | 1 | +5V |  |  |  |  | ${EXCLUDE_FROM_POS_FILES} | TestPoint:TestPoint_THTPad_D1.5mm_Drill0.7mm
TP3 | 1 | +3V3_MCU |  |  |  |  | ${EXCLUDE_FROM_POS_FILES} | TestPoint:TestPoint_THTPad_D1.5mm_Drill0.7mm
TP4,TP5 | 2 | GND |  |  |  |  | ${EXCLUDE_FROM_POS_FILES} | TestPoint:TestPoint_THTPad_D1.5mm_Drill0.7mm
TP6 | 1 | SDA |  |  |  |  | ${EXCLUDE_FROM_POS_FILES} | TestPoint:TestPoint_THTPad_D1.5mm_Drill0.7mm
TP7 | 1 | SCL |  |  |  |  | ${EXCLUDE_FROM_POS_FILES} | TestPoint:TestPoint_THTPad_D1.5mm_Drill0.7mm
TP9 | 1 | +3V3_PERIPH |  |  |  |  | ${EXCLUDE_FROM_POS_FILES} | TestPoint:TestPoint_THTPad_D1.5mm_Drill0.7mm
U1,U2 | 2 | MP1584EN |  |  |  |  | ${EXCLUDE_FROM_POS_FILES} | rover_footprints:MP1584EN_Module
U3 | 1 | YD-ESP32-S3 |  |  |  |  | ${EXCLUDE_FROM_POS_FILES} | YD-ESP32-S3-main:YD-ESP32-S3
U4,U5 | 2 | TB6612FNG_Module |  |  |  |  | ${EXCLUDE_FROM_POS_FILES} | rover_footprints:TB6612FNG_Module
U6 | 1 | PCF8574_Module |  |  |  |  | ${EXCLUDE_FROM_POS_FILES} | rover_footprints:PCF8574_IO_Expansion_Module_1
U7,U8,U9,U10 | 4 | VL53L0X |  |  |  |  | ${EXCLUDE_FROM_POS_FILES} | Connector_JST:JST_PH_B6B-PH-K_1x06_P2.00mm_Vertical
