12romis/esp32-elrs-rover/docs/features/phase7-telemetry/tasks/t1-telemetry-core-frame-and-step-stats.md

---
id: T1
title: "Створити telemetry_core: кадр датчика батареї, рішення «слати чи ні», детектор зміни збою, статистика часу кроку й рядок status"
layer: "domain"
deps: []
blocks: ["T4", "T6", "T8"]
acs: ["AC-01", "AC-02", "AC-04", "AC-05", "AC-19"]
files_hint: ["components/telemetry/telemetry_core.c", "components/telemetry/include/telemetry_core.h", "components/telemetry/CMakeLists.txt", "test/host/test_telemetry.c"]
owner: "Агент"
estimate: "M"
context_budget: "M"
status: "done"
step: "GATE (без коміту: CLAUDE.md)"
---

# T1 — Створити telemetry_core: кадр датчика батареї, рішення «слати чи ні», детектор зміни збою, статистика часу кроку й рядок status

## Place in the sequence

- **Blocked by:** — · **Blocks:** T4 — Додати в drive_status_t прапорці секторів і дві відмітки часу навколо кроку control з записом у telemetry_step_record, T6 — Створити telemetry_hal: задача telemetry (200 мс) читає знімок напруги й передає кадр через crsf_hal_send, T8 — Підключити в main старт telemetry і колбек step_status, показати колір індикатора й час кроку в status · **Wave:** 1.
- **Lane:** shares `components/telemetry/CMakeLists.txt` with T6 — serialized.

## Why (user story)

> **As a** Розробник
> **I want** бачити на екрані телеметрії пульта напругу акумулятора ровера
> **So that** я помічаю розряд до того, як спрацює відсічка, не підключаючи USB
>
> — `spec.md §4, US-01, verbatim` · full text: [spec.md](../spec.md)

> **As a** Розробник
> **I want** командою `status` бачити, скільки триває крок керування і чи не перевищує він свій період
> **So that** я відрізняю перевантаження процесора від проблем регулятора й заліза
>
> — `spec.md §4, US-02, verbatim` · full text: [spec.md](../spec.md)

Задача дає чисту логіку обох історій: що саме йде на пульт і як рахується час кроку; HAL лише викликає її.

## Inlined context

> A1. Кадр телеметрії — тип датчика батареї; передається лише напруга з розв'язністю 0.1 В, округлена до найближчого 0.1 В; струм, ємність і відсоток заряду дорівнюють нулю і означають «немає даних» (README це називає). Напруга береться зі знімка компонента батареї, а не з другого вимірювання.
>
> — `spec.md §1, A1, verbatim` · full text: [spec.md](../spec.md)

> A2. Період передачі 200 мс (документ 02 §6.1, таблиця задач). Якщо знімка напруги немає або він застарів, кадр не надсилається, а вигаданого значення немає. Кадри йдуть у всіх станах автомата й у стендовому режимі, доки працює лінія до приймача.
>
> — `spec.md §1, A2, verbatim` · full text: [spec.md](../spec.md)

> A3. Телеметрія нічого не вирішує: помилка передачі або відсутність приймача не змінює стан автомата, моторів і світла й не затримує такт керування; в журнал іде одне попередження на кожну зміну (збій, відновлення), а не на кожен період.
>
> — `spec.md §1, A3, verbatim` · full text: [spec.md](../spec.md)

> A4. «Час такту керування» — тривалість виконання одного кроку керування (від початку до кінця його роботи, без очікування наступного періоду). Статистика від старту плати: останнє, середнє й найбільше значення в мікросекундах і число кроків, що тривали довше за період 20 мс. Показується лише в `status`; на пульт не йде, бо стандартний кадр CRSF не має для цього поля (розбіжність з документом 02 §7, див. нижче).
>
> — `spec.md §1, A4, verbatim` · full text: [spec.md](../spec.md)

> **Chosen:** варіант 1. `telemetry_core` будує кадр (тип датчика батареї: напруга з розв'язністю 0.1 В, струм, ємність і відсоток — нулі; CRC8 через `crsf_crc8`) вирішує, чи слати (знімок придатний за `battery_snapshot_usable`), і виявляє зміну «збій / відновлення» передачі (чиста логіка, тест на хості). `telemetry_hal` тримає задачу (core 0, пріоритет 2, `vTaskDelayUntil`, 200 мс), читає `battery_get_snapshot`, викликає `crsf_hal_send` і лише пише `ESP_LOGW` на зміну, яку повідомив core. `crsf_hal_send` повертає false, якщо драйвер не встановлено чи запис не вдався, і ніколи не блокує довше за запис кількох байтів у FIFO.
>
> — `adr/0001-send-battery-telemetry-as-a-crsf-battery-frame-from-a-telemetry-task-through-the-crsf-uart-owner.md, Decision outcome, verbatim` · full text: [adr/](../adr/)

> **Chosen:** варіант 1. Відмітки беруться на початку циклу після пробудження й перед `esp_task_wdt_reset` (вимір кроку без очікування наступного періоду). `telemetry_step_record` — короткий критичний блок із чотирма полями; читає `main` для рядка `status` через новий колбек `step_status`. До першого виміру рядок каже «вимірів ще немає».
>
> — `adr/0003-measure-the-control-step-in-drive-hal-and-keep-the-statistics-in-telemetry-core.md, Decision outcome, verbatim` · full text: [adr/](../adr/)

**Fallback:** insufficient or contradicted by the code → read the named file in full ([spec.md](../spec.md) · [sad.md](../sad.md) · [adr/](../adr/)) and follow it. Do not guess.

## Data delta

No DB changes.

## API contract

Internal — no API surface.

## Acceptance criteria

### AC-01 — happy path

> **Given** ровер увімкнений, акумулятор підключений, приймач привʼязаний до пульта, а напруга акумулятора виміряна
> **When** Розробник відкриває на пульті екран телеметрії
> **Then** він бачить напругу акумулятора, яка відрізняється від показу `status` не більше ніж на 0.1 В і оновлюється не рідше ніж раз на секунду; струм, ємність і відсоток заряду не несуть даних і описані в README як «немає даних»
>
> — `spec.md §5, AC-01, verbatim` · full text: [spec.md](../spec.md)

### AC-02 — error

> **Given** придатної напруги немає: акумулятор ще не виміряно або останній вимір застарів
> **When** настає час передати телеметрію
> **Then** пульт не отримує вигаданого значення (датчик напруги на пульті не оновлюється), а в журналі зʼявляється одне попередження про зміну стану, а не по рядку на кожен період
>
> — `spec.md §5, AC-02, verbatim` · full text: [spec.md](../spec.md)

### AC-04 — happy path

> **Given** ровер працює щонайменше 60 с, частину часу озброєний і їде
> **When** Розробник вводить команду `status`
> **Then** вона показує для кроку керування останній, середній і найбільший час виконання в мікросекундах, період кроку та число кроків, що тривали довше за період
>
> — `spec.md §5, AC-04, verbatim` · full text: [spec.md](../spec.md)

### AC-05 — error

> **Given** плата щойно стартувала і жодного кроку керування ще не виконано
> **When** Розробник вводить `status`
> **Then** замість нулів команда каже, що вимірів ще немає
>
> — `spec.md §5, AC-05, verbatim` · full text: [spec.md](../spec.md)

### AC-19 — happy path

> **Given** Агент завершив зміну в межах фази 7
> **When** Агент запускає збірку проєкту і прогін хостових тестів
> **Then** збірка завершується без помилок і без нових попереджень, а прогін повідомляє кількість тестів і що всі пройдені; серед них перевірено: перетворення напруги в значення кадру (округлення до найближчого 0.1 В, межі, відсутній і застарілий знімок), побудову кадру з нульовими струмом, ємністю й відсотком, статистику часу кроку (перший вимір, найбільше, середнє, перевищення періоду), послідовність подвійного біпа (100 мс, пауза 100 мс, 100 мс), вхід, вихід в ARMED, відсутність подвійного біпа на виходах в DISARMED і FAILSAFE, заміну одинарного сигналу озброєння біля зайнятого сектору, відсутність накладання біпів, жовтий індикатор у утриманні й червоний у FAILSAFE, блимання фар за переднім сектором і задніх ліхтарів за заднім, синхронність при обох секторах, повернення ручного стану фар, роботу без розширювача, і те, що таблиця переходів автомата лишилась із 12 пар
>
> — `spec.md §5, AC-19, verbatim` · full text: [spec.md](../spec.md)

## Checklist

- [x] Створити `components/telemetry/include/telemetry_core.h` і `telemetry_core.c`: структура статистики кроку (останній, середній, найбільший, число кроків понад період, лічильник вимірів) і `telemetry_core_step_record`; формат рядка `status` («вимірів ще немає» до першого кроку)
- [x] `telemetry_core_build_battery_frame`: тип датчика батареї, напруга з розв’язністю 0.1 В (округлення до найближчого від мВ), струм, ємність і відсоток — нулі, CRC8 через `crsf_crc8` (`components/crsf/crsf_core.c`)
- [x] `telemetry_core_should_send` за `battery_snapshot_usable`; детектор зміни «збій / відновлення» повертає подію лише на зміну
- [x] Оновити `components/telemetry/CMakeLists.txt`: SRCS і REQUIRES `crsf` `battery`
- [x] Хостові тести `test/host/test_telemetry.c`: округлення (межі), відсутній і застарілий знімок, нульові поля, CRC, статистика, перший вимір, перевищення періоду, детектор зміни

## Edge cases

| Case | Behaviour |
|---|---|
| Напруга 7449 мВ / 7450 мВ | округлюється до найближчого 0.1 В (74 і 75 десятків; межа в тесті) |
| Знімок невалідний або застарів | кадр не будується; сигнал «не слати»; одне попередження на зміну, а не на період |
| Жодного кроку ще не виміряно | рядок каже «вимірів ще немає», не нулі |
| Крок довший за період 20 мс | лічильник перевищень зростає; середнє й найбільше оновлюються |
| Переповнення 32-бітного часу | різниця беззнакова, статистика не ламається |

## Definition of Done

- [x] тести `test_telemetry.c` проходять, `telemetry_core.c` без заголовків ESP-IDF, збірка без нових попереджень
- [x] кожне Hard Rule вище лишається дійсним (інваріанти п. 7 конституції не зачеплено)
- [x] збірка без нових попереджень
