12romis/esp32-elrs-rover/docs/features/phase7-telemetry/tasks/t7-ui-hal-hold-wiring.md

---
id: T7
title: "Підключити в ui_hal прапорці секторів, жовтий колір індикатора й колір у ui_hal_status_t"
layer: "infra"
deps: ["T2", "T3", "T4"]
blocks: ["T8"]
acs: ["AC-06", "AC-07", "AC-09", "AC-13", "AC-14"]
files_hint: ["components/ui/ui_hal.c", "components/ui/include/ui_hal.h"]
owner: "Агент"
estimate: "S"
context_budget: "M"
status: "review"
step: "GATE (без коміту: CLAUDE.md)"
---

# T7 — Підключити в ui_hal прапорці секторів, жовтий колір індикатора й колір у ui_hal_status_t

## Place in the sequence

- **Blocked by:** T2 — Навчити ui_core подвійному біпу на вході в OBSTACLE_HOLD і на виході в ARMED, жовтому індикатору й пріоритетам сигналів, T3 — Навчити ui_core блиманню фар при зайнятому передньому секторі й задніх ліхтарів при зайнятому задньому в OBSTACLE_HOLD, T4 — Додати в drive_status_t прапорці секторів і дві відмітки часу навколо кроку control з записом у telemetry_step_record · **Blocks:** T8 — Підключити в main старт telemetry і колбек step_status, показати колір індикатора й час кроку в status · **Wave:** 3.
- **Lane:** власна лінія.

## Why (user story)

> **As a** Розробник
> **I want** щоб вхід в OBSTACLE_HOLD і вихід з нього в ARMED супроводжувались подвійним бібом, а на час утримання індикатор плати світив жовтим
> **So that** я помічаю, що ровер не їде вперед через перешкоду, а не через поломку, навіть не дивлячись на нього
>
> — `spec.md §4, US-03, verbatim` · full text: [spec.md](../spec.md)

> **As a** Розробник
> **I want** щоб фари блимали, коли перешкода спереду, а задні ліхтарі блимали, коли перешкода ззаду
> **So that** я одразу знаю, куди ровер може їхати, а куди ні
>
> — `spec.md §4, US-04, verbatim` · full text: [spec.md](../spec.md)

> **As a** Розробник
> **I want** щоб індикація й телеметрія не змінювали інваріантів безпеки, не затримували керування й не ламалися від відмови розширювача портів чи приймача
> **So that** корисна «лампочка» не стає ще одним способом зламати ровер
>
> — `spec.md §4, US-05, verbatim` · full text: [spec.md](../spec.md)

Задача виводить рішення ui_core на зумер, індикатор і світло та віддає колір індикатора для status.

## Inlined context

> **Chosen:** варіант 1. `drive_hal` кладе `ctl.occ_front` і `ctl.occ_rear` у знімок статусу; `ui_hal` додає їх до `ui_in_t`. У `ui_core`: подвійний біп як автоматичний сигнал (послідовність за часом від старту, нова подія не стартує, поки звучить попередня), жовтий індикатор у стані OBSTACLE_HOLD, фаза блимання від входу в стан з півперіодом 250 мс; блимання перекриває вихід фар або задніх ліхтарів, а ручний стан фар зберігається й повертається. Ця зміна заміщає в ADR-0004 phase6-tof лише правила «ARMED ↔ OBSTACLE_HOLD без сигналу» і «DISARMED → OBSTACLE_HOLD дає сигнал як озброєння»; правило «не вмикає фари примусово» лишається.
>
> — `adr/0002-derive-hold-indication-in-ui-core-from-state-and-control-sector-flags.md, Decision outcome, verbatim` · full text: [adr/](../adr/)

> A8. Індикатор плати в OBSTACLE_HOLD світить жовтим увесь час стану (червоний і зелений канали разом на перевіреному рівні 40, порядок байтів GRB із журналу вимірювань P8); поза утриманням гасне, у FAILSAFE світить червоним (червоний має пріоритет). Працює й тоді, коли розширювач портів недоступний.
>
> — `spec.md §1, A8, verbatim` · full text: [spec.md](../spec.md)

> A12. Розширювач портів недоступний (деградація, фаза 2): світло не керується, зумер і індикатор плати діють; нових попереджень на кожен такт немає.
>
> — `spec.md §1, A12, verbatim` · full text: [spec.md](../spec.md)

> ├── ui/                   ui_core: подвійний біп, жовтий, блимання, фаза утримання; ui_hal: жовтий колір індикатора; ui_hal_status_t.indicator_red → колір індикатора (enum)
>
> — `sad.md §5, «Internal decomposition», verbatim` · full text: [sad.md](../sad.md)

**Fallback:** insufficient or contradicted by the code → read the named file in full ([spec.md](../spec.md) · [sad.md](../sad.md) · [adr/](../adr/)) and follow it. Do not guess.

## Data delta

No DB changes.

## API contract

Internal — no API surface.

## Acceptance criteria

### AC-06 — happy path

> **Given** ровер озброєний, їде вперед, передній сектор вільний
> **When** ровер наближається до перешкоди ближче за поріг перешкоди і переходить в OBSTACLE_HOLD
> **Then** зумер подає два короткі сигнали підряд, а індикатор плати світить жовтим весь час, поки ровер у цьому стані
>
> — `spec.md §5, AC-06, verbatim` · full text: [spec.md](../spec.md)

### AC-07 — happy path

> **Given** ровер в OBSTACLE_HOLD, індикатор плати жовтий
> **When** перешкода зникає, обидва сектори стають вільними і ровер повертається в ARMED
> **Then** зумер подає два короткі сигнали підряд, а індикатор плати гасне
>
> — `spec.md §5, AC-07, verbatim` · full text: [spec.md](../spec.md)

### AC-09 — cross-context

> **Given** ровер у DISARMED і перед ним лежить перешкода ближче за поріг перешкоди
> **When** Розробник озброює ровер
> **Then** ровер одразу в OBSTACLE_HOLD і не їде вперед; зумер подає подвійний біп замість одинарного сигналу озброєння, індикатор плати світить жовтим, а фари блимають, бо зайнятий передній сектор
>
> — `spec.md §5, AC-09, verbatim` · full text: [spec.md](../spec.md)

### AC-13 — error

> **Given** розширювач портів недоступний (деградація), ровер озброєний
> **When** ровер переходить в OBSTACLE_HOLD і назад
> **Then** світло не змінюється й не блимає, але подвійні біпи звучать, індикатор плати жовтий під час утримання, а ровер їде й зупиняється як зазвичай; нових попереджень на кожен такт у журналі немає
>
> — `spec.md §5, AC-13, verbatim` · full text: [spec.md](../spec.md)

### AC-14 — domain invariant

> **Given** ровер в OBSTACLE_HOLD із повною індикацією
> **When** пульт втрачає звʼязок довше за допустиме, або напруга падає нижче відсічки, або Розробник роззброює ровер
> **Then** мотори отримують нуль і STBY опускається в тих самих межах часу, що й без індикації; індикація не затримує реакції і не вмикає STBY
>
> — `spec.md §5, AC-14, verbatim` · full text: [spec.md](../spec.md)

## Checklist

- [x] `ui_hal.c` `run_tick`: заповнити `front_occupied`/`rear_occupied` з `drive_hal_status` (`occ_front`/`occ_rear`) в `ui_in_t`
- [x] Індикатор: колір enum (`indicator_set` приймає `ui_indicator_t`): червоний (0,40,0), жовтий (40,40,0) у порядку GRB, рівень `UI_INDICATOR_LEVEL`; повторна спроба, як зараз
- [x] `ui_hal.h`: у `ui_hal_status_t` додати поле `indicator` (enum); `indicator_red` лишити до T8

## Edge cases

| Case | Behaviour |
|---|---|
| Передача на індикатор не вдалася | повторюється на наступному такті; ровер не залежить |
| Індикатор не налаштовано | індикації кольору немає, зумер і світло працюють |
| Прапорці секторів із попереднього такту control | ui показує те, що control бачила на останньому такті |

## Definition of Done

- [ ] збірка без нових попереджень; жовтий і блимання перевіряє Розробник — T12 (приймання на залізі: acceptance.md)
- [x] кожне Hard Rule вище лишається дійсним (інваріанти п. 7 конституції не зачеплено)
- [x] збірка без нових попереджень
