12romis/esp32-elrs-rover/docs/features/phase3-crsf/adr/0003-turn-channels-into-pilot-intent-in-crsf-core-and-arbitrate-source-in-control-step.md

---
status: Accepted
owner: "Розробник проєкту"
reviewers: []
updated_at: "2026-10-18"
feature_size: "S"
ticket: "roadmap крок 3 — phase3-crsf"
---

# 0003 — Turn channels into pilot intent in crsf core and arbitrate the source in the control step

- **Status:** Accepted
- **Date:** 2026-10-18
- **Deciders:** Розробник проєкту (прийнято в журналі припущень design 2026-10-18), Агент

## Context

Сирі канали приймача треба перетворити на тягу, поворот і події тумблера (мертва зона, фронт DISARM → ARM із «невідомою» базою після втрати зв'язку), а потім вирішити, чиї команди виконувати: консолі (стендовий режим, до першого кадру) чи пульта. Консоль фази 1 подає `arm`, `drive`, `disarm` чергою в `control`; матриця дозволів `rover_console` перевіряє лише стан автомата.

## Decision drivers

- Spec AC-01…AC-04, AC-13…AC-16: озброєння лише фронтом, стендовий режим закінчується першим кадром, консольні `arm` і `drive` після нього відхиляються, `disarm` працює завжди.
- Перевірюваність (spec AC-18): нормалізація, мертва зона, фронт, закінчення стенду, матриця 126 пар — на хості.
- Один вирішувач безпеки (ADR-0001).

## Considered options

1. **Намір у `crsf_core`, розведення в `drive_ctl_step`** — `crsf_core` дає чисті функції «канали → намір пілота» (нормалізація, мертва зона, тумблер, фронт); стан пілота (база фронту) живе в `drive_ctl_t`; `drive_ctl_step` отримує знімок як вхід, веде стендовий режим і відповідає консолі причиною «керує пульт».
2. **Уся логіка пульта в `drive_core`** — нормалізацію, мертву зону й фронт пише `drive_core`, `crsf` лише розбирає кадри.
3. **Розведення в консолі** — `rover_console` знає режим керування й відхиляє `arm` і `drive` сама; `control` приймає лише намір пульта.

## Decision outcome

**Chosen:** варіант 1. Перетворення каналів лишається поруч із протоколом (і тестується разом із розбором), а рішення про те, чиїм командам вірити, — у тому самому чистому кроці, що вирішує про виходи й стан, тож розведення неможливо обійти, оминувши консоль. Варіант 2 роздуває `drive_core` знанням протоколу; варіант 3 дублює рішення безпеки поза `control`.

## Consequences

**Positive**
- `drive_ctl_step` — єдине місце, де визначено, хто керує; консоль лише показує відповідь.
- Матриця дозволів `rover_console` за станом не змінюється; режим додає `control` (126 пар перевіряє тест кроку разом із тестом консолі).
- `crsf_core` повторно використовується фазою 7 (телеметрія) без залежності від `drive`.

**Negative**
- `drive` починає залежати від заголовка `crsf_core.h` (лише чиста логіка, без HAL).
- Відмова консолі «керує пульт» приходить відповіддю з черги `control`, а не одразу з консолі (затримка ≤ один такт, 20 мс).

**Neutral**
- Знаки осей (`CRSF_THROTTLE_SIGN`, `CRSF_STEER_SIGN` = +1, виміряно 2026-10-18) — константи в `crsf_calib.h`; зміна налаштувань пульта змінює лише їх.

## Links

- Spec: [[../spec.md]] AC-01…AC-04, AC-07, AC-13…AC-16, матриця дозволів
- SAD: [[../sad.md]] §4 (пункт 3), §5, §6 (потік 1)
- Related ADR: [[0001-decide-link-loss-in-control-task-from-receiver-snapshot]]
