12romis/esp32-elrs-rover/docs/features/phase1-drive/adr/0003-measure-battery-in-own-task-with-stale-reading-failsafe.md

---
status: Accepted
owner: "Розробник проєкту"
reviewers: ["Розробник проєкту"]
updated_at: "2026-10-18"
feature_size: "M"
ticket: "roadmap, крок 1 (phase1-drive)"
---

# 0003 — Measure battery in its own task with stale-reading failsafe

- **Status:** Accepted
- **Date:** 2026-10-18
- **Deciders:** Архітектор + Розробник (журнал припущень design, рівень easy)

## Context

Відсічка по VBAT має спрацювати не пізніше 1 с після падіння під 6.0 В, а озброєння відхиляється, доки немає першого вимірювання (spec AC-13, AC-14, NFR). Вимірювання напруги використовують фаза 1 (відсічка) і фаза 7 (телеметрія). АЦП-усереднення 16–64 відліків дозволене не частіше 5 Гц (документ 02, §3.1), тож його не можна робити в кожному такті `control` на 20 мс.

## Decision drivers

- Затримка відсічки ≤ 1 с; частота вимірювання ≤ 5 Гц, усереднення 16–64 відліків (spec §6).
- Компонент `battery` має бути перевикористаний у фазі 7 без переробки.
- Збій вимірювання не має лишати ровер їхати наосліп.

## Considered options

1. **Окрема задача `battery` (200 мс), що публікує останній знімок «мВ, час, валідність»; `control` читає знімок і вважає його застарілим після 600 мс.**
2. **Вимірювати в самій задачі `control`** кожні N тактів.

## Decision outcome

**Chosen:** Option 1. Знімок захищений коротким критичним блоком; `battery_core` рахує мВ (масштаб і зсув з `battery_calib.h`) і порівнює з порогом 6000 мВ. Знімок старший за 600 мс (три періоди) або невалідний: `arm` відхиляється, а в ARMED `control` зупиняє мотори й просить FAILSAFE. Варіант 2 виконує довгий пакет відліків у критичній задачі.

## Consequences

**Positive**
- Затримка відсічки ≈ 200 мс + такт 20 мс, з великим запасом до 1 с.
- Компонент перевикористовується телеметрією без змін.

**Negative**
- Додаткова задача й спільний знімок; 600 мс — нове проєктне число, яке підтверджується прийманням на залізі.

**Neutral**
- Просадка під навантаженням може хибно спрацювати відсічку; поки без витримки й гістерезису, спостерігається на прийманні (spec OQ-3, §11).

## Links

- Spec: [[../spec.md]] (AC-13, AC-14, AC-15, AC-22)
- SAD: [[../sad.md]] §4, §5, §6
- Related ADR: [[0001-run-motor-safety-logic-in-a-dedicated-control-task]]
