12romis/esp32-elrs-rover/docs/measured.md

# Виміряні величини

Правило: передфаза пройдена, лише коли число записане тут.

| Константа | Значення | Як отримано | Дата |
|---|---|---|---|
| Чіп / ревізія | ESP32-S3, rev v0.2, 2 ядра | P0, `tools/bringup` (`P0 chip`), IDF v6.1 | 2026-10-16 |
| Флеш | 16 MB (Boya, DIO) | P0 (`P0 flash`) | 2026-10-16 |
| PSRAM | 8388608 байт (octal, тест пам'яті OK) | P0 (`P0 psram`) | 2026-10-16 |
| Free heap після старту | 8779327 (internal 393135) | P0 (`P0 free heap`) | 2026-10-16 |
| `PCF8574_ADDR` | **0x20** (A0–A2 = GND; на шині рівно один пристрій) | P1, `tools/bringup`, скан 0x08–0x77 при 100 кГц | 2026-10-16 |
| Карта бітів PCF8574 (2.1): P3 фари, P5 червоний, P6 зелений | підтверджена; після запису `0x00` світла немає, кожен канал вмикається незалежно, всі разом горять без просідання. Червоний і зелений — два кристали в одному світлодіоді (RG): разом дають жовтий | P2, `tools/bringup`, візуально + лог `0x08/0x20/0x40/0x68` | 2026-10-16 |
| `VBAT_SCALE` / `VBAT_OFFSET` (точка 1 з 2, **попередньо**) | друк прошивки 8231 мВ (стабільно ±8 мВ, raw 2450) ↔ вольтметр на TP1 8260 мВ; похибка −29 мВ (−0.35 %); коефіцієнт k 4.033 → 4.047, зсув 0. Друга точка нижче 7 В ще не знята, приймання ±50 мВ на 6.0–8.4 В **не закрите** | P3, `tools/bringup` | 2026-10-16 |
| Послідовність XSHUT і перепризначення адрес VL53L0X | 10 з 10 запусків успішно; на шині 0x20 (PCF8574) і 0x30, 0x31, 0x32, 0x33; слабка підтяжка PCF8574 тримає XSHUT (ризик §4.4 знято) | P4, `tools/bringup`, `P4_MODE 1` | 2026-10-16 |
| Драйвер VL53L0X | підтверджено мінімальний власний (варіант 3 з §10.3): усі чотири датчики віддають відстань; значення 8190 мм = поза діапазоном. Стенд: 133–177 мм на трьох, 1126–1178 мм на U10 | P4 | 2026-10-16 |
| `TOF_OBSTACLE_MM` | **190** мм — рішення Розробника (коміт bc4aedd, 2026-10-21; було 170 за розрахунком: вибіг ≤ 30 + реакція ≈ 86 + похибка датчика ≈ 12 = ≈ 128 мм, зазор після зупинки в найгіршому випадку ≈ 42 мм (лише трохи вище 40 мм, OQ-2). Підлягає перевірці рулеткою при прийманні AC-01 фази 6; змінюється правкою константи | вибіг (рядок нижче) + рішення Розробника | 2026-10-21 |
| Вибіг ровера після нейтралі стіка (для порогу `TOF_OBSTACLE_MM`) | не більше 30 мм у всіх заїздах на стіку 100 %, 60 % і 30 % (фаза 5, регулятор; точних значень і кількості заїздів не записано). Далекомір майже врівень із корпусом, окремої поправки на винос датчика не робимо. Розрахунковий мінімум порогу ≈ 128 мм = вибіг 30 + шлях за час реакції 250 мс на 100 % стіка ≈ 86 + похибка датчика ≈ 12; поріг вибрано рядком вище (170 мм, 2026-10-21; пізніше змінено на 190 мм рішенням Розробника, коміт bc4aedd) | рулетка, зі слів Розробника | 2026-10-21 |
| Реакція далекомірів на долоню | усі чотири реагують: U7 160→66…79 мм, U8 125→41…44 мм, U9 167→84…93 мм, U10 300→42…63 мм; значення повертаються до фону після прибирання долоні | P4, `P4_MODE 1`, візуально + лог | 2026-10-17 |
| Розташування далекомірів на шасі | U7 — вперед ліворуч під 45°, U8 — рівно вперед, U9 — вперед праворуч під 45°, U10 — рівно назад. Праворуч-ліворуч і ззаду-боків покриття немає | P4, зі слів користувача, зібране шасі | 2026-10-17 |
| Далекоміри без перепон і над підлогою | усі чотири: поза діапазоном (0/30 валідних відліків) — власного перекриття корпусом і хибних відліків підлоги немає | P4, `P4_MODE 2` на шасі | 2026-10-17 |
| Точність далекомірів на 100 мм (одна точка) | стіна на 100 мм по лінійці: U7=118, U8=93…95, U9=140, U10=112…114 мм. U8 і U10 (перпендикулярно до стіни) показують +12…−7 мм відносно лінійки. U7 і U9 стоять під 45°, очікується ~141 мм вздовж осі: U9=140 збігається, U7=118 — не пояснено | P4, `P4_MODE 1` і `2` | 2026-10-17 |
| `CRSF_BAUD` | **420000** (8N1, UART2; RX=GPIO17, TX=GPIO16). Конфлікт §10.2 закрито: 416666 пробувати не потрібно | P5, `tools/bringup`, ELRS Nano RX привʼязаний до TX12 | 2026-10-17 |
| Якість CRSF-каналу | 9918 кадрів, `CRC fail` = 1 (0.01 %, норма < 1 %); типи кадрів 0x16 (RC_CHANNELS) і 0x14 (link statistics); частота RC ≈ 100 кадрів/с (за лічильниками, ~50 кадрів за 0.5 с) | P5, лог | 2026-10-17 |
| Карта каналів CRSF (частково) | CH1 (idx 0) і CH2 (idx 1) — правий стік X і Y, мають лише по одному каналу; CH5 (idx 4) — тумблер, дві позиції 191 і 1792. Спокій: CH1≈982, CH2≈978, CH4≈1000 (не рівно 992, потрібна мертва зона), CH3=180 (лівий стік Y внизу, не центрується), CH6 і CH7 = 172, CH8 і CH9 = 992, CH10…CH14 = 0, CH15 і CH16 = 1811. **Не підтверджено**: CH3, CH4 (лівий стік), CH6, CH7 (тумблери) не рухались у логу; тест вимкнення пульта не показано | P5 | 2026-10-17 |
| Карта каналів CRSF, доповнення | підтверджено: CH3 (idx 2) — лівий стік Y (180…1810, лишається там, де відпустили, без повернення в центр); CH4 (idx 3) — лівий стік X (428…1802, спокій ≈1000); CH5 (idx 4) — тумблер з фіксацією, 191 і 1792 (після перемикання тримається). Якість: 29481 кадр, `CRC fail` = 2 (0.01 %). **Досі не підтверджено**: CH6 і CH7 (тумблери SB, SC) лишались 172 увесь час; тест вимкнення пульта (`silent` ні разу не вийшов із 0) | P5 | 2026-10-17 |
| Вимкнення пульта (поведінка приймача) | кадри RC_CHANNELS (0x16) припиняються одразу (лічильник `rc` застиг між двома виводами, 0.5 с); кадри link statistics (0x14) ще ≈ 3.5 с надходять із приймача (10 Гц), потім усе мовчить. Тому таймер failsafe треба скидати **лише кадром 0x16**, а не будь-яким валідним кадром: `silent` у P5 (до цієї правки коду) рахувався від останнього будь-якого кадру | P5, лог | 2026-10-17 |
| Карта каналів CRSF, перемикачі | CH5 (idx 4) — двопозиційний, 191 і 1792; CH8 (idx 7) — **трипозиційний**, 172 / 992 / 1810; CH6 (idx 5) і CH7 (idx 6) — не рухались (172 увесь час). Фізичні перемикачі EdgeTX для CH6–CH8 не названі | P5, лог | 2026-10-17 |
| Рішення щодо каналів (P5 закрито) | CH1 поворот, CH2 тяга, CH5 ARM/DISARM, **CH8 фари** (трипозиційний перемикач, замість CH6 із плану); CH3, CH4, CH6, CH7 не використовуються. Перемикачі TX12: трипозиційні SE, SB, SC, SF; кнопки SA, SD; слайдери S1, S2. Спокій стіків не рівно 992 (≈ 978…1000), потрібна мертва зона | P5, за погодженням користувача | 2026-10-17 |
| Енкодер M3 (перед-правий, лічильник FR), `P6_PULLUP 0` | 3 прогони по 10 обертів колеса вперед: 27647, 27874, 27599 імпульсів (×4); середнє 27707, ≈ 2771 імпульс/оберт колеса; розбіжність між прогонами 0.99 % (норма < 2 %); лічильник додатний при обертанні «вперед». Без внутрішніх підтяжок рахує нормально. Інші три канали лишались 0, бо інші мотори не під'єднані. Підтверджує відповідність M3 → FR (§2.2). **Не виміряно**: M1, M2, M4; зворотний напрямок; прогін з `P6_PULLUP 1` | P6, `tools/bringup`, ручне обертання | 2026-10-17 |
| Позначки на моторі JGA12-N20 (барвні дроти) | M1 білий, GND синій, C1 зелений, C2 жовтий, VCC чорний, M2 червоний. Обмотка M1–M2: 12 Ом ± 0.6 на всіх чотирьох моторах, ізоляція від енкодера в мегаомах | зі слів користувача, крок A | 2026-10-17 |
| Енкодер M4 (зад-праве, лічильник RR), `P6_PULLUP 0` | 3 прогони по 10 обертів колеса: −27832, −27664, −27730 імпульсів (×4); середнє 27742, ≈ 2774 імпульс/оберт колеса; розбіжність між прогонами 0.61 % (норма < 2 %); **лічильник від'ємний** при тому напрямку обертання, який користувач позначив для запису. Зворотне обертання (≈ 5 обертів) дало +13978, тобто знак змінюється. Рахує без підтяжок. Не уточнено: чи це той самий фізичний напрямок «вперед», що й для M3 (там було додатне) | P6 | 2026-10-17 |
| Енкодер M3, зворотне обертання | приріст −13622 (при обертанні в протилежний бік, ≈ 5 обертів): знак змінюється, умова приймання виконана | P6 | 2026-10-17 |
| Енкодер M1 (перед-ліве, лічильник FL), `P6_PULLUP 0` | 3 прогони по 10 обертів: −27767, −27621, −27746; середнє 27711, ≈ 2771 імпульс/оберт; розбіжність 0.53 %; лічильник від'ємний при записаному обертанні; зворотне обертання +13844 (знак змінюється); рахує без підтяжок | P6 | 2026-10-17 |
| Енкодер M2 (зад-ліве, лічильник RL), `P6_PULLUP 0` | 3 прогони по 10 обертів: +27701, +27872, +27578; середнє 27717, ≈ 2772 імпульс/оберт; розбіжність 1.06 %; лічильник додатний при записаному обертанні; зворотне обертання −13862 (знак змінюється); рахує без підтяжок | P6 | 2026-10-17 |
| `ENC_PULSES_PER_REV` | **2772** імпульси на оберт колеса (×4 квадратурна роздільність): середнє по чотирьох моторах 2771.9, розкид між моторами 0.13 %. Збігається з 28 × 99 (7 імпульсів на оберт вала × 4 × передавальне число 99), але склад не підтверджено окремим виміром | P6, ручне обертання, 3 × 10 обертів на мотор | 2026-10-17 |
| `ENC_NEEDS_PULLUP` | **0**: усі чотири енкодери рахують з `P6_PULLUP 0`, прогін з підтяжками не потрібен | P6 | 2026-10-17 |
| Відповідність коліс лічильникам | M1 → FL, M2 → RL, M3 → FR, M4 → RR (збігається з §2.2): при обертанні кожного колеса змінюється лише очікуваний лічильник | P6 | 2026-10-17 |
| Знаки лічильників при записаному обертанні (попередньо; **до перестановки A/B на M1 і M3**) | FL −, RL +, FR +, RR −. **Фізичний напрямок «вперед» для M1 і M2 користувач не підтвердив** (для M3 і M4 підтверджено один і той самий). Остаточний `ENC_DIR_SIGN[4]` визначається в P7 на ходу | P6 | 2026-10-17 |
| `ENC_DIR_SIGN[4]` (з P6, **замінено наступним рядком після перестановки A/B на M1 і M3**) | користувач крутив усі чотири колеса в напрямку «ровер їде вперед»: сирий знак лічильника FL −, FR +, RL +, RR −. Множник, що робить рух вперед додатним: **FL = −1, FR = +1, RL = +1, RR = −1** (порядок FL, FR, RL, RR). P7 підтвердить на ходу і окремо перевірить полярність підключення обмоток моторів | P6, ручне обертання | 2026-10-17 |
| Перестановка дротів A і B енкодера на M1 і M3 | користувач поміняв C1 і C2 місцями на M1 (FL) і M3 (FR), щоб лівий і правий борти мали однаковий знак усередині борту. Рядки з приростами по M1 і M3 вище (знаки −27767… і +27707…) виміряні **до** перестановки, модулі (≈ 2771 імпульс/оберт) від неї не залежать. Очікуваний знак при русі вперед після перестановки: FL +, RL +, FR −, RR −, тобто `ENC_DIR_SIGN` (множник, що робить рух вперед додатним) у порядку FL, FR, RL, RR: **+1, −1, +1, −1**. Значення виведене з перестановки, а не виміряне заново | P6, зі слів користувача | 2026-10-17 |
| `ENC_DIR_SIGN[4]` підтверджено | ручне обертання в напрямку «ровер їде вперед» послідовно M1→M4 після перестановки A/B: FL +3638, RL +5472, FR −4036, RR −5180 (≈ 1.3 … 2 оберти). Сирий знак при русі вперед: FL +, FR −, RL +, RR −. Множник, що робить рух вперед додатним, у порядку FL, FR, RL, RR: **+1, −1, +1, −1**. Лівий борт має однаковий знак, правий протилежний, як і очікується для дзеркально встановлених моторів. P7 перевірить це на ходу | P6, ручне обертання | 2026-10-17 |
| Прозвонка моторних шлейфів з боку плати (D1) | усі чотири шлейфи в порядку: пін 1–2 — обмотка (≈ 12 Ом), ізоляція до пінів 3–6 в мегаомах. Блокер p. 12 конституції знято | зі слів користувача, крок A документа 01 | 2026-10-17 |
| P7: лівий борт (U4) на 25 % ШІМ, 2 с, колеса в повітрі | вперед: FL +4456…+4460, RL +4136…+4167; назад: FL −4173…−4215, RL −4067…−4083 (два цикли). Знаки збігаються з `ENC_DIR_SIGN` (+1, +1), обидва колеса борту крутяться в один бік. Правий борт не рухався (FR, RR = 0). **Лівий борт пройшов** | P7, `tools/bringup`, автовердикт | 2026-10-17 |
| P7: правий борт (U5) на 25 % ШІМ, 2 с, колеса в повітрі | вперед: FR +1166…+1233, RR +2149…+2186; назад: FR −1225…−1313, RR −2286…−2305 (два цикли). Обидва колеса борту крутяться в один бік, але **знак протилежний очікуваному**: за P6 рух вперед дає FR −, RR −, а команда «правий вперед» дала + на обох. Тест видав `P7 FAIL` для FR і RR. Лівий борт не рухався (FL, RL = 0). Висновок (за умови, що знак енкодера не змінився): на команду «правий вперед» обидва правих колеса крутяться **назад**, тобто полярність підключення моторів правого борту інвертована відносно лівого. Фізичний напрямок обертання ще не підтверджено візуально | P7 | 2026-10-17 |
| Розкид швидкості при 25 % ШІМ без навантаження | за 2 с: лівий борт ≈ 4100…4460 імпульсів на колесо, правий FR ≈ 1170…1310 і RR ≈ 2150…2300. Правий борт, особливо FR, рухається помітно повільніше. 25 % від 8.4 В ≈ 2.1 В середньої напруги, поблизу порога рушання N20; розбіжність може бути в мінімальній напрузі рушання моторів. Для PID (фаза 5) це означає різну мертву зону на колесо | P7 | 2026-10-17 |
| P7 після перестановки контактів обмотки (пін 1 і 2) на роз'ємах M3 і M4 | цикл 2: лівий вперед FL +4599, RL +4027; лівий назад FL −4617, RL −4158; правий вперед FR −1666, RR −2416; правий назад FR +1666, RR +2145 — усі чотири запуски `P7 OK`. Цикл 1: правий вперед FR −18 (колесо не рушило), RR −2322 → `P7 FAIL` для FR; правий назад FR +1654, RR +2028 → OK. Колесо ніде не крутилось у протилежний бік. Приймання P7 за напрямками виконано | P7, `tools/bringup`, колеса в повітрі, 25 % ШІМ | 2026-10-17 |
| Підтвердження `ENC_DIR_SIGN[4]` на ходу | **+1, −1, +1, −1** (FL, FR, RL, RR). Правий вперед тепер дає від'ємний приріст, як і ручне обертання вперед у P6, тож знак енкодера не залежить від полярності обмотки. Прив'язка моторів до борту (§2.2) підтверджена: ліві колеса на U4, праві на U5 | P7 | 2026-10-17 |
| Механічне спостереження | FR (праве переднє) крутиться «наче під напругою», повільніше за інші; правий борт у цілому повільніший за лівий (≈ 1650…2400 проти ≈ 4000…4600 імпульсів за 2 с при 25 %). У першому запуску FR узагалі не рушив. Причину не з'ясовано (механічне тертя, поріг рушання, або електрика U5). Потрібна перевірка перед фазою 1 | P7, зі слів користувача | 2026-10-17 |
| Фаза 0: вільна внутрішня памʼять після старту	| 385 639 байт (baseline P0 393135, різниця −7496)	| команда status, образ 98d6cc8	|  2026-10-18 |
| Фаза 0: затримка перезавантаження після wdt-test	| ≈ 4,67 с (вимога ≤ 6 с), причина TASK_WDT |	секундомір, монітор |	2026-10-18 |
| Фаза 1: вільна внутрішня памʼять після старту | 375 607 байт (кінець фази 0: 385 639, різниця −10 032; P0: 393 135) | `status`, приймання фази 1, крок 1 | 2026-10-18 |
| Фаза 1: напруга на старті й під навантаженням (колеса в повітрі, ≈ 0.3–0.75 тяги) | на старті 7806 мВ; мінімум за час команд руху 7729…7758 мВ (просадка ≈ 50…80 мВ); відсічка не спрацьовувала. Калібрування попереднє (k 4.047, зсув 0, OQ-1) — значення орієнтовні | `status` і журнал «мінімальна напруга за час руху», приймання фази 1 | 2026-10-18 |
| Фаза 1: STBY у DISARMED | 0 В (під час старту, `help`/`status`/`arm`/`disarm` — за відповіддю Розробника «так, 0 В») | мультиметр, приймання фази 1, крок 2 | 2026-10-18 |
| Фаза 1: arm, drive, спливання команди, disarm | `arm` → `drive 0.3 0` → автоматичне ARMED→DISARMED із повідомленням «команда руху спливла…»; `drive 0 0.4` → «ліве 0.40, праве −0.40»; `drive 0.8 0.5` → «ліве 0.75, праве 0.23»; `disarm` під час руху — мотори зупинились швидко. Секундоміром час зупинки не міряли, напрямки коліс окремо не записано | журнал монітора, приймання фази 1, кроки 3–5 | 2026-10-18 |
| Фаза 1: відʼєднання USB під час руху | мотори завершили крутіння (до 2 с), після повторного підключення рух не відновився, `status` → DISARMED, плата не перезавантажувалась (час роботи 613 с). У `status` причини зупинки не видно (історія містить лише переходи) — відхилення від AC-12 | журнал монітора, приймання фази 1, крок 6 | 2026-10-18 |
| Фаза 1: відмови команд | `drive` не в ARMED, повторний `arm`, `drive 1.5 0`, `drive nan 0`, `drive 0,3 0` відхилено з поясненням, колеса не рушали. Двічі перша команда після підключення/старту (`status`, `drive 0.3 0`) відповіла «Невідома команда» — причину не з'ясовано (можливо, сміттєві байти від монітора при підключенні) | журнал монітора, приймання фази 1, крок 7 | 2026-10-18 |
| Фаза 1: відсічка по напрузі (попередньо) | акумулятор відʼєднано в ARMED без руху → ARMED→FAILSAFE, у журналі «напруга 4803 мВ нижча за поріг»; `arm` у FAILSAFE відхилено з підказкою про апаратне скидання. Затримку відсічки не міряли; AC-13, AC-14, AC-22 остаточно — після закриття OQ-1 (друга точка калібрування, блок живлення відсутній) | журнал монітора, приймання фази 1, крок 8 | 2026-10-18 |
| Фаза 1: серія з 10 циклів | «все ок» за відповіддю Розробника: без неочікуваних скидань і без руху поза командою | спостереження Розробника, крок 11 | 2026-10-18 |
| Фаза 1: повторне приймання після review (кроки 3, 5, 6) | `arm` → `drive 0.3 0` → спливання → DISARMED; `drive 0 0.4` → «ліве 0.40, праве −0.40»; `disarm` під час руху — мотори вимкнено; відʼєднання USB під час руху — після повторного підключення `arm` прийнято зі стану DISARMED (отже ровер зупинився й роззброївся без хоста). Мінімальна напруга за час руху 7717…7721 мВ. Відсічка при відʼєднанні акумулятора в ARMED: FAILSAFE, «напруга 2934 мВ нижча за поріг». **Не перевірено:** рядок «остання зупинка» в `status` після повторного підключення, відповідь `disarm` у DISARMED | журнал монітора, приймання фази 1 | 2026-10-18 |
| Фаза 1: AC-12 і AC-09 після виправлень review | після відʼєднання/підключення USB під час руху `status` показує «остання зупинка: команда руху спливла, ровер роззброєно; мінімальна напруга: 7713 мВ; час: 35949 мс від старту», історія містить перехід ARMED→DISARMED; `disarm` у DISARMED відповідає «стан DISARMED не змінено: DISARMED досяжний лише з ARMED». Вільна памʼять 375 575 байт | журнал монітора, приймання фази 1 | 2026-10-18 |
| Фаза 2, P8: вбудований RGB-індикатор модуля (лінія `PIN_STATUS_RGB`) | керується як адресований світлодіод однією лінією даних (RMT, 10 МГц, біти 0: 0.4/0.8 мкс, 1: 0.8/0.5 мкс); **порядок байтів GRB**: байти (40,0,0) → зелений, (0,40,0) → червоний, (0,0,40) → синій, (0,0,0) → погас; рівень 40 видно добре. Тип «адресований» підтверджено роботою, а не маркуванням | P8, `tools/bringup`, візуально | 2026-10-18 |
| Фаза 2, P9: частота зумера | найгучніше чути на **1000 Гц** (зумер пасивний, «12085, 42 Ом»); це частота автоматичних сигналів (`UI_SIGNAL_HZ`). Інших гучних частот Розробник не називав | P9, `tools/bringup`, слух | 2026-10-18 |
| Фаза 2: приймання на залізі, кроки 1–12 і 15 (Розробник, 2026-10-18) | старт: фари вимкнені, `status` показує розширювач доступний, світло/індикатор/зумер за очікуванням; вільна внутрішня памʼять 362911 байт (≥ 340000, поріг виконано); `reboot` при ввімкнених фарах — фари вимкнені; канали вмикаються незалежно, жовтий; відмови `light`/`beep` з поясненням; межі beep 200/5000 Гц прийняті; звуки чутно; `red`/`green` у ARMED відхилено, `head` і `beep` дозволені; зумер і світло не заважають руху; задні ліхтарі за рухом ок; FAILSAFE: індикатор червоний, зумер періодично пищить, при відʼєднаному акумуляторі зумер ледь чутний і задні не блимали (немає живлення 5 В) — прийнято; після повернення живлення задні світили жовтим без блимання (PCF після втрати живлення піднімається з усіма виходами, шина не відновлювалась до `шина відновилась` через ~5 хв) — **виправлено в коді (періодичний перезапис байта щосекунди і скидання шини після 5 невдач), потребує повторної перевірки**; повтор `arm`/`disarm` без сигналу як очікувалось; перша команда після підключення монітора інколи «Невідома команда» (як у фазі 1); короткочасне світіння фар і задніх ліхтарів після подачі живлення до завантаження МК — очікуване (OQ-1). Кроки 13 і 14 (відмова розширювача при старті й обрив шини) пропущено: розширювач запаяний, зняти його неможливо; AC-14 і AC-15 підтверджені лише хостовими тестами та частково кроком 11 (повідомлення про збій і відновлення шини в журналі) | журнал монітора, acceptance.md | 2026-10-18 |
| Фаза 2: нові вимоги власника за результатами приймання (крок 6) | в ARMED фари вмикаються самі, задні ліхтарі жовті (стоїть чи вперед) або зелені (назад); у DISARMED задні червоні; при виході з ARMED фари гаснуть; реалізовано, перевірка на залізі — повторне приймання | зі слів Розробника | 2026-10-18 |
| Фаза 2: повторне приймання після правок (кроки 1, 3, 6, 9, 10, 11) | після старту `status`: розширювач доступний, фари вимкнені, задній червоний ввімкнений, ліхтарі «керує вручну», індикатор вимкнений, зумер мовчить, вільна памʼять 362911 байт; кроки 3, 6, 9, 10 — «все ок»; крок 11 (відсічка з відʼєднаним і знову підключеним акумулятором) — ок, задні ліхтарі блимають після відновлення без ручної команди. Кроки 13 і 14 (відмова розширювача при старті, обрив шини) не виконані: розширювач запаяний | журнал монітора, acceptance.md | 2026-10-18 |
| Фаза 3, OQ-1: крайні значення правого стіка | CH2 (idx 1, тяга): 172…1808, спокій 974…980; CH1 (idx 0, поворот): 180…1792, спокій 980…992 (одноразово 1016 при поверненні). Стік не доходить до 1811 по CH2 і до 172/1811 по CH1: максимум нормалізованого відхилення ≥ 0.977 від центру 992, тобто обмеження потужності 0.75 досягається задовго до упору; шкалу 172…1811 з протоколу лишаємо без перерахунку. Якість: 0 битих кадрів із ≈ 1600. CH5 у цьому прогоні = 1792 (тумблер у ARM) | P5, `tools/bringup`, лог Розробника | 2026-10-18 |
| Фаза 3, OQ-1: напрямок правого стіка | стік **вгору** (від себе) → CH2 ≈ 1808, тобто більше значення = вперед: **`CRSF_THROTTLE_SIGN` = +1**; стік **праворуч** → CH1 ≈ 1792, більше значення = праворуч: **`CRSF_STEER_SIGN` = +1** (з мікшером фази 1 «ліве = тяга + поворот» це дає розворот праворуч) | P5, зі слів Розробника за логом | 2026-10-18 |
| `VBAT_SCALE` / `VBAT_OFFSET`, точка 2 з 2 | мультиметр 6047 мВ ↔ на піні АЦП 1484 мВ (raw 1774, стабільно, P3 друкує VBAT 5984 мВ з k = 4.033). Точка 1 (2026-10-16): 8260 мВ ↔ ≈ 2041 мВ на піні (виведено з друку 8231 мВ при k = 4.033). Чинне калібрування прошивки (k = 4.047, зсув 0) на 6047 мВ показує 6005 мВ — похибка −42 мВ; на 6.0–8.4 В |похибка| ≤ 42 мВ, допуск ±50 мВ (фаза 1, OQ-1) **виконано**; знак безпечний (відсічка при реальних ≈ 6.04 В). Двоточкове калібрування за цими точками: k = 3.973, зсув +151 мВ (похибка в обох точках ≈ 0) | P3, `tools/bringup`, мультиметр | 2026-10-18 |
| Фаза 3: приймання на залізі, кроки 1–3 (журнал) | старт: «приймач CRSF: UART2, 420000 бод 8N1»; стенд: `arm`, `drive 0.3 0`, спливання через 2 с; пульт увімкнено в DISARMED → «з'явився пульт — стендовий режим закінчено…», далі `arm` → «керує пульт; консоль — після перезапуску без нього»; відмова озброєння «стік не в нейтралі» (один рядок на фронт), озброєння й роззброєння тумблером; втрата звʼязку в DISARMED виявлена на 513 і 515 мс від останнього кадру, «звʼязок з пультом відновлено»; `disarm` у ARMED з тумблером у ARM — підказка повернути тумблер, повторного озброєння немає. **Не показано в журналі:** поява пульта саме під час консольного руху (AC-14, зупинка моторів) — пульт увімкнено, коли ровер уже був у DISARMED | журнал монітора, acceptance.md | 2026-10-18 |
| Фаза 3: приймання, кроки 4–12 | «ок» за відповіддю Розробника. Значення B − A кроку 7 (час від останнього кадру до FAILSAFE) не надіслано; режим failsafe приймача (OQ-2) не записано, але поведінка (FAILSAFE при вимкненні пульта) підтверджує, що кадри припиняються | зі слів Розробника | 2026-10-18 |
| Фаза 3: `status` у ARMED з пульта | вільна внутрішня памʼять 358843 байт (поріг ≥ 345000 — виконано); кадрів каналів 18358, CRC-помилок 0, інші 1879, переповнень 0; спокій стіка CH1 = 958, CH2 = 978 → тяга й поворот +0.00 (мертва зона ±41 від 992). **Запас CH1 до краю мертвої зони — лише 7 одиниць** (раніше спокій ≈ 982) | `status`, журнал монітора | 2026-10-18 |
| Калібрування напруги в прошивці (рішення Розробника) | застосовано двоточкове: `BATTERY_SCALE_PPM` 3973, `BATTERY_OFFSET_MV` 151 (`battery_calib.h`); на виміряних точках прошивка дає 6046 і 8259 мВ (похибка ≤ 1 мВ). Межа відсічки 6000 мВ — між 1472 і 1473 мВ на піні. Перевірка на залізі: `status` при відомій напрузі мультиметром | рішення Розробника, хостові тести | 2026-10-18 |
| `WHEEL_DIAMETER_MM` | **44** мм (зовнішній діаметр шини по виступах протектора; паспорт продавця колеса K346 — 43 мм). Довжина кола ≈ 138.2 мм, ≈ 0.0499 мм на імпульс при 2772 імпульсах на оберт. Радіус кочення під вагою ровера не міряли — точність перевіряє AC-06 фази 4 (1 м по рулетці, ±5 %) | штангенциркуль, зі слів Розробника | 2026-10-19 |
| Фаза 4: приймання на залізі, кроки 1–13 (журнал) | енкодери 4 з 4; 10 обертів рукою: RR +27728 / −26, FR +27736 / −99 імп; FL +29128, RL +28431 — поза ±2 %, прийнято як похибку ручного обертання (рух назад ≈ 10.0 об, на підлозі колеса нарівні). Повний стік: лише зростання й понад 100 000 імп на кожному колесі за 17.9 с, ≈ 10 переходів межі ±30000 без стрибків — **скидання лічильника на ±30000 при watch-point підтверджено (ADR-0002)**. Нерухомий борт під наведенням — 0 імп. Інтервалів +2041 за 40820 мс. FAILSAFE: колесо рукою дає +2436 імп. Затримка «кадр → борти» макс 15 мс за 51 с (не більше 20 мс за всі кроки). Докладно — `docs/features/phase4-encoders/acceptance.md`, «Результати приймання» | журнал монітора, Розробник | 2026-10-19 |
| Фаза 4: вільна внутрішня памʼять | **353635** байт після старту, 353607 в ARMED і в FAILSAFE (поріг ≥ 345000 — виконано; фаза 3 — 358843) | `status` | 2026-10-19 |
| Фаза 4: відстань 1 м на підлозі (AC-06) | FL 99.7, FR 97.8, RL 99.4, RR 98.6 см; середнє **98.9 см** (−1.1 %, допуск ±5 %) при `WHEEL_DIAMETER_MM` 44 | крок 9, рулетка | 2026-10-19 |
| Фаза 4, KPI: швидкість коліс (стенд, `drive <тяга> 0`), об/хв FL / FR / RL / RR | 0.25: **48.7 / 30.3 / 45.5 / 30.3**; 0.5: **101.7 / 80.1 / 98.5 / 86.6**; 0.75: **155.8 / 134.2 / 153.7 / 140.7**. Найбільша за модулем на 0.75 (кроки 3–5, 10): FL 157.0, FR 146.1, RL 158.0, RR 145.0. Правий борт повільніший за лівий: на 0.75 ≈ 11 %, на 0.5 ≈ 17 %, на 0.25 ≈ 36 % (вхід для регулятора фази 5) | крок 10 і кроки 3–5, `enc` | 2026-10-19 |
