12romis/esp32-elrs-rover/docs/01-ASSEMBLY-BRINGUP.md

# Ровер — монтаж і поетапний bring-up плати

**Версія:** 2026-10-11
**Джерело істини:** `kicad-rover.net` (експорт 2026-10-11T14:36), `bom-kicad-rover.csv`
**Стан на 11.10.2026:** запаяні резистори, транзистори, керамічні конденсатори, діоди (D1, D2, D3),
гнізда під модулі та всі роз'єми JST. Модулі в гнізда не вставлені, шлейфи не під'єднані.
**Не запаяні: C3, C27 (електроліти) і J1 (XT30).**

---

## 0. Головне правило

**Жоден модуль не вставляється в гніздо, доки напруга в цьому гнізді не виміряна мультиметром.**

Причина конкретна: якщо підстроєчник U2 (понижувач 3.3 В) приїхав з заводу в положенні 20 В, то перше ж вмикання з усіма вставленими модулями вб'є одночасно ESP32, PCF8574 і чотири далекоміри. Це приблизно 40 доларів і три тижні очікування нової партії.

Тому порядок нижче побудований так, що на кожному кроці під напругою опиняється мінімум заліза.

---

## 1. Що лишилось запаяти

Усе інше з BOM уже стоїть. Лишилось три позиції, і всі три полярні або критичні.

| | Поз. | Деталь | Примітка |
|---|---|---|---|
| ☐ | **C3** | 1000 мкФ / 35 В, D12.5 | на `+VBAT` |
| ☐ | **C27** | 470 мкФ, D12.5 | на `+5V` |
| ☐ | **J1** | XT30, дроти 18 AWG до пʼятачків | **останнім, після розділу 3** |

**R17 і R19 не паяємо** — вони DNP (підтяжки I²C, далекоміри мають власні).

Перевір заодно, що на місці й правильно орієнтовані вже встановлені полярні деталі:

| Поз. | Перевірка |
|---|---|
| D1 (P6KE12A) | смуга-катод → до `+VBAT`, анод на GND. Навпаки він стає провідником і коротить батарею |
| D2 (SS34, SMA) | смуга-катод → до шини `+5V`. Навпаки живлення не буде взагалі |
| D3 (1N4007) | смуга-катод → до `+5V`, анод на колектор Q6. Навпаки не гаситиме викид зумера і згорить сам |
| BZ1 | `+` на корпусі → до `+5V` |
| Q3–Q6 (BC547) | пласка грань за шовкографією. Порядок C-B-E, не E-B-C як у 2N3904 |
| J2–J7, M1–M4, U7–U10 | защіпки JST дивляться назовні, до краю плати |

---

## 2. Порядок пайки

### Крок 2.1 — електроліти C3 і C27

**Полярність.** Довга ніжка — плюс; на корпусі смуга позначає мінус. У символі `Device:C_Polarized` **вивід 1 = плюс**, і на шовкодруку плати плюс позначений.

Ми вже один раз ловили перевернутий C3 у схемі — не повтори це в залізі. Перевернутий електроліт на 8.4 В розкривається по насічці за кілька хвилин роботи, з електролітом на плату.

C3 стоїть у колі `+VBAT`, C27 — у колі `+5V`. Переплутати їх місцями не можна: 470 мкФ на 8.4 В дасть слабкіший буфер для моторів, а 1000 мкФ на 5 В створить помітний кидок при встромлянні USB.

### Крок 2.2 — J1 (XT30), у самому кінці

Дроти 18 AWG до пʼятачків. **Великий чіткий маркер `+` і `−`** — XT30 полярний, а пʼятачки ні, і переплутати можна тільки тут.

Паяти J1 **тільки після того, як пройдено весь розділ 3**. Доки роз'єму живлення немає, плату неможливо випадково запитати.

---

## 3. Холодна перевірка — повністю без живлення

Модулі **не вставлені**. Мультиметр у режимі омметра.

### 3.1 Шини до землі

Щуп на TP4 або TP5 (GND), другий по черзі:

| Точка | Очікування | Що означає інше |
|---|---|---|
| TP1 (`+VBAT`) | **≈ 133 кОм** | це R1 (100k) + R4 (33k) послідовно. Обрив → R1 або R4 не пропаяні. Одиниці Ом → коротке |
| TP2 (`+5V`) | обрив (після заряду ємностей) | одиниці-десятки Ом → коротке під U1 або C27 |
| TP3 (`+3V3_MCU`) | обрив | коротке під U3 |
| TP9 (`+3V3_PERIPH`) | > 100 кОм | низький опір → коротке під U2 або U6 |

Стрілка/цифри спершу стрибнуть і поповзуть — це заряджаються конденсатори через щупи. Чекай стабілізації.

Замір TP1 ≈ 133 кОм — **найкорисніший у всьому списку**: він одним дотиком підтверджує, що дільник вимірювання напруги батареї зібраний правильно. Без нього прошивка показуватиме дурню, і ти шукатимеш баг у коді замість непропаяного резистора.

### 3.2 Шини між собою

Усе має бути обрив:

```
TP1 ↔ TP2      (VBAT ↔ 5V)
TP2 ↔ TP3      (5V ↔ 3V3_MCU)
TP3 ↔ TP9      (3V3_MCU ↔ 3V3_PERIPH)
TP2 ↔ TP9      (5V ↔ 3V3_PERIPH)
```

### 3.3 Точкові перевірки номіналів у схемі

| Між чим | Очікування | Перевіряє |
|---|---|---|
| гніздо U3 вивід 27 (GPIO21) ↔ GND | **10 кОм** | R16 — притяжка STBY. Це failsafe драйверів; без неї мотори можуть смикнутись до прошивки |
| гніздо U3 вивід 41 (GPIO1) ↔ GND | **33 кОм** | R4 — нижнє плече дільника |

### 3.4 Полігон землі

Від TP4 прозвони GND у чотирьох далеких точках: біля U7 (перед), біля U10 (зад), біля M1 (лівий борт), біля M4 (правий борт). Скрізь має бути нуль-одиниці Ом.

### 3.5 Під лупою

- містки припою між сусідніми контактами гребінок (у U3 їх 44 — пройдись по всіх парах);
- непропаї: матові, опуклі краплі замість увігнутих конусів;
- залишки флюсу між контактами роз'ємів.

**Не йди далі, поки 3.1–3.4 не чисті.**

---

## 4. Окремо: прозвонка моторних шлейфів

**Це єдина невідомість, здатна за секунду вбити чотири далекоміри, енкодери й PCF8574 одночасно.** Робиться без живлення, займає пʼять хвилин, і досі не зроблена.

У схемі розпіновка роз'ємів M1–M4 така:

```
пін 1 = M+        (вихід драйвера)
пін 2 = M−        (вихід драйвера)
пін 3 = ENC_VCC   (+3V3_PERIPH)
пін 4 = ENC_GND   (GND)
пін 5 = ENC_A
пін 6 = ENC_B
```

У частини партій JGA12-N20 фізичний порядок дротів інший — моторні контакти рознесені по краях роз'єму. Якщо так, то вихід драйвера (до 8.4 В із ШІМ) потрапить прямо на шину `+3V3_PERIPH`.

**Як перевірити.** Мультиметр в омметр, щупи в контакти роз'єму мотора (сам мотор, не плата):
- два контакти з опором **5–15 Ом** між собою — це обмотка двигуна. Вони мають стояти на пінах **1 і 2**.
- решта чотири — енкодер.

Зроби на всіх чотирьох моторах. Якщо порядок не збігається — переставляй контакти в корпусі роз'єму (піддівається голкою), а не переробляй плату.

### Заодно — характер енкодера

Подай на ENC_VCC / ENC_GND мотора **3.3 В від лабораторного блока** (не від плати), покрути вал рукою і подивись вольтметром на A і B:

- чітко перемикається **0 ↔ 3.3 В** → двотактний вихід, усе гаразд;
- сидить біля нуля й не змінюється → **відкритий колектор**. Це не поломка і не вимагає переробки плати — лікується увімкненням внутрішніх підтяжок ESP32 у прошивці. Але знати треба зараз;
- на 3.3 В мовчить взагалі → енкодеру потрібні 5 В. **Це проблема**: його виходи стануть 5-вольтовими і спалять GPIO. Зупинись і напиши мені.

Запиши результат — він піде в прошивку як константа.

---

## 5. Перше подання живлення

### 5.1 Чим живити

BMS уже є, але акумулятор на перші кроки все одно не під'єднуємо: 2S-пак віддає десятки ампер у коротке і випалює дорожку раніше, ніж ти встигнеш смикнути щуп. Варіанти за спаданням зручності:

1. **Лабораторний блок** 8.4 В з обмеженням струму **100 мА**. Ідеально: при короткому він просто не дасть струму.
2. Акумулятор через BMS + **лампочка розжарювання 12 В послідовно в плюсовий дріт**. При замиканні лампа спалахує на повну й обмежує струм до ~0.5 А. Плата виживає.
3. Акумулятор напряму — **тільки після того, як пройдені 5.2–5.4 на обмеженому джерелі**.

Перед першим під'єднанням нової BMS повтори перевірку, яка зловила попередню: напруга на P+/P− під навантаженням 470 Ом має бути **не нижче ніж на 0.05 В** за напругу на B+/B−. Падіння на 0.3 В і більше означає, що ключі BMS не відкриваються — така плата до ровера не йде.

### 5.2 Плата без жодного модуля

Подати живлення. Заміряти:

| Точка | Очікування |
|---|---|
| TP1 | напруга джерела (8.4 В) |
| TP2, TP3, TP9 | **0 В** — понижувачів ще немає |

Струм споживання має бути **< 1 мА** (це тільки дільник R1/R4: 8.4 / 133k = 63 мкА). Якщо блок показує десятки мА — десь коротке, шукай.

### 5.3 U1 — понижувач 5.4 В

**Виставляти поза платою.** Під'єднай U1 окремими дротами до джерела 8.4 В, крути підстроєчник **повільно** (він багатообертовий), виведи **5.40 В**. Зафіксуй тример краплею лаку або термоклею — на ровері вібрація.

**Фіксатор зсуває напругу.** Термоклей при застиганні стягується і тисне на бігунок — типово +0.1…0.15 В. Тому: виставив → приклеїв → **заміряв ще раз після повного охолодження**. Лак дає менший зсув, ніж термоклей, і наносити його краще на корпус тримера збоку, а не в шліц.

**Вікно тут широке — не муч тример.** Допустимий вихід U1 — **5.1…5.6 В**, що дає на шині 4.7…5.3 В. Усе, що висить на +5 В, у цих межах працює без зауважень, тож 5.13 нічим не гірше за 5.40.

**Чому тример скаче саме у верхній частині діапазону.** Підстроєчник на модулі MP1584EN стоїть нижнім плечем дільника зворотного зв'язку: `Vout = 0.8 × (1 + R1/R2)`, де 0.8 В — внутрішній опорник, а R2 — тример. Чутливість іде як `1/R2²`, тому що вище напруга, то дрібніший хід дає більший стрибок. Це властивість схеми, а не дефект модуля. Виставляй **знизу вгору**, підходячи до цілі з боку меншої напруги.

Вставити U1 у гніздо. Подати живлення. Заміряти:

- **TP2 = 4.7…5.25 В**

Чому не 5.4: між виходом U1 і шиною +5 В стоїть діод D2 (SS34), на якому падає 0.3–0.4 В залежно від струму. Це зроблено навмисно — діод не дає живленню з USB текти назад у понижувач.

Стеля на шині +5 В — **5.3 В**. Її задає приймач ELRS (J7.1, паспортні 5 В, на платі LDO із входом до ~6 В); решта споживачів — 5-вольтовий вивід YD-плати, бузер і світлодіоди через резистори — терплять більше.

Підлога — **4.6 В**. Її задає LDO на платі YD (AMS1117-3.3, dropout ~1.1 В при 0.5 А): нижче 4.6 В ESP32 почне просідати на піках Wi-Fi.

**Якщо бігунок крутиться з провалами й не тримає положення** (буває, коли в механізм затік термоклей), то налаштування не витримає вібрації на ровері. Тоді тример замінюється постійним резистором: ще до випаювання заміряти опір між усіма трьома парами виводів і записати, випаяти, і на ті два виводи, що були задіяні, впаяти постійний резистор відповідного номіналу. Після цього напруга не зсунеться вже ніколи.

Якщо TP2 ≈ напруга виходу U1 без падіння — D2 закорочений або не той бік.
Якщо TP2 = 0 — D2 навпаки.

### 5.4 U2 — понижувач 3.30 В

**Найнебезпечніший крок усього bring-up.**

Так само поза платою виставити напругу і зафіксувати тример — але **порядок дій інший, ніж на U1**, і це важливо.

На U1 зсув від фіксатора (+0.1…0.15 В) нешкідливий, бо вікно там широке. Тут вікно — 0.05 В, і той самий зсув виносить напругу за межу. Тому:

1. виставити **3.20–3.22 В** — свідомо нижче цілі, із запасом на зсув;
2. нанести фіксатор;
3. дати повністю застигнути й охолонути, **заміряти знову**;
4. результат мусить бути **≤ 3.30 В**. Якщо вийшло вище — розігріти термоклей феном до мʼякості, підкрутити назад, охолодити, заміряти ще раз. Не крути тример через застиглий клей: бігунок відламається.

Чому стеля жорстка: абсолютний максимум на виводах ESP32 — VDD + 0.3 В, а VDD самого ESP32 під навантаженням просідає до 3.25 В. Далекоміри підтягують I²C саме до `+3V3_PERIPH`, і ця напруга приходить на GPIO8/GPIO9.

Вставити U2. Заміряти:

- **TP9 = 3.15–3.30 В**

Перевір ще раз, перш ніж іти далі. Якщо тут 20 В — наступний крок коштує тобі ESP32.

### 5.5 U3 — ESP32

Вставити. Заміряти **TP3 під навантаженням** (залий будь-яку прошивку з увімкненим Wi-Fi або просто дай поробити хвилину):

- **TP3 ≥ 3.25 В**

Якщо просіло нижче — на платці YD між виводом 5V і входом її LDO може стояти діод, що шунтується перемичкою `IN-OUT`. Замкни її.

Перевір, що USB-C доступний і плата визначається компʼютером. Залий `hello_world` — це перевіряє ланцюг живлення цілком.

### 5.6 U6 — PCF8574

Вставити. Залити скетч/прошивку зі скануванням I²C.

**Очікувана адреса — відкрите питання, але діапазон вузький.** Чіп на модулі — **PCF8574T** (перевірено візуально 15.10.2026), базовий варіант, тому адреса лежить у `0x20…0x27` і ніде більше; «A»-діапазон 0x38…0x3F виключений. У схемі записано `0x20 (A0..A2=GND)`, але модулі цього типу часто приходять з A0–A2 підтягнутими вгору, тобто `0x27`.

**Не хардкодь адресу. Проскануй шину і запиши, що знайшлось.** Це значення потім іде в прошивку.

### 5.7 Далекоміри — по одному

Вставити U7, подати живлення, просканувати I²C → має зʼявитись **0x29**.

Потім по черзі U8, U9, U10. Після кожного — скан.

**Важливо:** усі чотири мають заводську адресу 0x29. Доки прошивка не вміє розводити їх по різних адресах через XSHUT, **тримай вставленим тільки один**. Два одночасно = конфлікт на шині, скан покаже або нічого, або сміття.

### 5.8 U4, U5 — драйвери моторів

Вставити **без під'єднаних моторів**. Заміряти на гніздах:

- вивід 9 (VM) = напруга батареї
- вивід 10 (VCC) = 3.30 В
- вивід 4 (STBY) = **0 В** ← це failsafe: драйвери в standby, виходи Hi-Z

Останній замір найважливіший. Він підтверджує, що R16 працює і мотори не смикнуться до того, як прошивка свідомо підніме STBY.

### 5.9 Мотори — в самому кінці

Тільки після того, як прозвонка шлейфів (розділ 4) зроблена і прошивка вміє arm/disarm.

**Перший запуск — колеса в повітрі.** Шасі на підставці, колеса не торкаються столу.

### 5.10 Швидкий самоконтроль, коли всі модулі вже в гніздах

Робиться **без жодного рядка прошивки**, за 15 хвилин, тільки мультиметром і лабораторним блоком. Мотори на цьому етапі **не під'єднані**.

**Крок 1 — холодна перевірка з модулями (живлення вимкнене).**

Орієнтація кожного модуля: знайди пін 1 на платі й на модулі, перевір усі вісім. Перевернутий на 180° модуль — найчастіша причина смерті в такій архітектурі, і єдина, яку видно оком.

Опір шин до GND вже не буде «обрив», бо модулі самі є навантаженням. Критерій простий: **одиниці кілоом — норма, одиниці ом або нуль — коротке**.

**Крок 2 — подача живлення з обмеженням 400 мА.**

Дивись на амперметр у момент увімкнення. Якщо струм упирається в обмеження — вимикай одразу. Робочий струм (усі модулі, мотори не під'єднані, прошивки немає) — **приблизно 100–250 мА**. Абсолютне значення тут менш важливе, ніж те, що воно стабільне й не наростає; запиши своє число в журнал — воно стане еталоном для майбутніх порівнянь.

**Крок 3 — чотири напруги.**

| Точка | Очікування |
|---|---|
| TP1 | напруга джерела |
| TP2 (+5 В) | 4.7…5.25 В |
| TP9 (+3V3_PERIPH) | 3.15…3.35 В, **не просіло** проти заміру без модулів |
| TP3 (+3V3_MCU) | ≥ 3.25 В |

**Крок 4 — фари мусять загорітися самі.** Це безкоштовний тест усього світлового ланцюга.

Q3, Q4, Q5 — NPN, і база кожного підтягнута до `+3V3_PERIPH` резистором (R7, R10, R13 відповідно). PCF8574 після подачі живлення тримає всі виводи у стані «1», тобто не стягує базу вниз. Отже **без прошивки всі три транзистори відкриті**:

- Q3 → фари на J2 і J3 **горять**;
- Q5 → червоні на J5/J6 (через R14, R15) **горять**;
- Q4 → зелені на J5/J6 (через R11, R12) **горять**.

Якщо під'єднати світлодіоди зараз, вони засвітяться самі при подачі живлення. Це перевіряє одразу: живлення PCF8574, усі три транзистори, базові резистори, струмозадаючі резистори, полярність і розпаювання самих світлодіодів.

Не горить один колір → дивись його транзистор і резистори. Не горить нічого → PCF8574 без живлення або всі три бази стягнуті. Горить, але ледь → не той номінал резистора.

Саме через це в прошивці **найперша операція по I²C — записати в PCF8574 `0x00`**, інакше ровер стартує з усім світлом увімкненим (див. 4.3).

**Крок 5 — STBY на драйверах.** Шукати пін не обов'язково: `/STBY` — це одна спільна лінія, на якій сидять **R16, GPIO21 ESP32, вивід 4 U4 і вивід 4 U5**. Тому міряти найзручніше там, де підписано:

- **вивід GPIO21 на гнізді ESP32** — це найпростіше, напис є на самій платі YD;
- або пін, підписаний `STBY` на шовкографії модуля TB6612 (рахувати ніжки не треба).

Очікування: **0 В** (приймається до 0.1 В). Тримає його R16 (10 кОм на GND), і це єдине, що не дає моторам смикнутись до того, як прошивка свідомо підніме STBY. Перевірку достатньо зробити в одній точці — лінія спільна.

**Крок 6 — шина I²C жива.** Заміряти постійну напругу на TP6 (SDA) і TP7 (SCL):

- **обидві ≈ 3.2…3.3 В** — норма. Підтяжки дають самі далекоміри (R17/R19 на платі не встановлені навмисно);
- **одна з них 0 В** — лінію хтось тримає. Виймай далекоміри по одному, доки напруга не підніметься: останній вийнятий і є винуватець;
- **обидві 0 В** — немає `+3V3_PERIPH` або коротке на шині.

**Крок 7 — калібрування дільника батареї.** Заміряти напругу на TP1 і на виводі GPIO1, поділити:

```
k = V(TP1) / V(GPIO1)
```

Розрахункове значення — **4.0303** (R1 = 100 кОм, R4 = 33 кОм). Реально вийде 3.9…4.1 через допуски резисторів. **Запиши своє число** — воно піде в прошивку константою замість розрахункової.

**Крок 8 — термоконтроль.** Через дві хвилини роботи торкнись пальцем: U1, U2, екран ESP32, обидва TB6612, усі чотири далекоміри. Усе має бути **холодним або трохи теплим**. Будь-що гаряче — вимикай і шукай причину саме там; струм при частковому замиканні може лишатися в нормі, а нагрів покаже.

**Крок 9 — ESP32 відповідає без прошивки.** Під'єднати USB-C і виконати:

```bash
esptool.py --port /dev/ttyACM0 flash_id
```

`esptool` говорить із ROM-завантажувачем, власна прошивка для цього не потрібна. Має відповісти `ESP32-S3` і показати 16 МБ флешу. Це перевіряє USB-тракт, живлення MCU і сам чип.

Що цей самоконтроль **не перевіряє** і що лишається до прошивки: адресу PCF8574 (скан шини, п. 5.6), далекоміри по одному (5.7), енкодери, і — окремо й найважливіше — **розпіновку моторних шлейфів (розділ 4)**. Мотори в роз'єми не вставляти, доки вона не прозвонена.

---

## 6. Що зробити паралельно

- **Прозвонити моторні шлейфи** (розділ 4) — не потребує нічого, крім мультиметра
- **Перевірити нову BMS під навантаженням** (див. 5.1) — поки вона ще не в корпусі й до неї легко дістатись
- **Замовити запасну BMS** — вони по два долари й їдуть три тижні, одна вже згоріла
- **Почати прошивку** — фази 0–2 з документа `02-FIRMWARE-CONTEXT.md` налагоджуються від USB без акумулятора взагалі

---

## 7. Журнал bring-up — заповнювати по ходу

Ці числа потім підуть у прошивку й у README для захисту.

| Що | Виміряно | Дата |
|---|---|---|
| TP1 ↔ GND (холодна, очік. 133 кОм) | | |
| Вихід U1 поза платою (вікно 5.1–5.6 В) | 5.130 В | 15.10.2026 |
| TP2 (+5V, очік. 4.7–5.25 В) | **4.893 В** | 15.10.2026 |
| TP9 (+3V3_PERIPH, очік. 3.15–3.35 В) | **3.305 В** | 15.10.2026 |
| TP3 (+3V3_MCU, очік. ≥3.25 В) | **3.295 В** | 15.10.2026 |
| TP6 / TP7 (SDA / SCL, очік. 3.2–3.3 В) | обидві в нормі | 15.10.2026 |
| Струм спокою без модулів | | |
| Струм спокою з усіма модулями (очік. 100–250 мА) | | |
| **Коефіцієнт дільника k = V(TP1)/V(GPIO1)** | виміряно **4.0433** → у код **4.033** | 15.10.2026 |
| **Адреса PCF8574 (скан)** | | |
| Адреса VL53L0X до перепризначення | 0x29 | |
| Розпіновка шлейфу M1 збігається зі схемою? | | |
| Розпіновка шлейфу M2 | | |
| Розпіновка шлейфу M3 | | |
| Розпіновка шлейфу M4 | | |
| **Енкодер: двотактний чи відкритий колектор?** | | |
| Енкодер працює від 3.3 В? | | |
| Висота гнізд-гребінок (штангенциркуль) | | |
| Фаза 0, запис 1/4 — старт і стан (AC-01) | BOOT → SELFTEST → DISARMED, переходи в журналі (14 і 15 мс), та сама історія в `status`; образ 98d6cc8 | 18.10.2026 |
| Фаза 0, запис 2/4 — консоль (AC-02, AC-03, AC-13) | `help`, `status`, `foo`, `HELP`, `status foo`, рядок із пробілів, рядок довший за 64 символи, `reboot` — усе як очікувалось; після `reboot` причина скидання `SW`; зайвих порожніх рядків немає | 18.10.2026 |
| Фаза 0, запис 3/4 — сторожовий таймер (AC-04) | `wdt-test` → перезавантаження ≈ **4.67 с** (вимога ≤ 6 с), причина після старту `TASK_WDT`; після перепрошивки з виправленням heartbeat помилки `task not found` у журналі немає | 18.10.2026 |
| Фаза 0, запис 4/4 — STBY низький (AC-07) | STBY низький (мультиметр); прошивка не налаштовує ліній моторів; 10 хв безперервної роботи без скидань | 18.10.2026 |
