12romis/esp32-elrs-rover/docs/features/phase5-pid/tasks/t15-review-remote-stop-tests.md

---
id: T15
title: "Хостові тести регулятора на шляху пульта і при всіх зупинках (review F6)"
layer: "tests"
deps: ["T12"]
acs: ["AC-16", "AC-18"]
files_hint: ["test/host/test_drive.c"]
owner: "Агент"
estimate: "S"
source: "_review/review-2026-10-20.md"
status: "done"
step: "GATE ✓ — без коміту (рішення Розробника); мутаційна перевірка: обидві мутації спіймано"
---

# T15 — Хостові тести регулятора на шляху пульта і при всіх зупинках (review F6)

Рев'ю F6: тести регулятора покривали лише стенд, тож бракує тестів на:
- шлях пульта (стік → регульований вихід, нейтраль → 0 у тому ж такті);
- скидання при тумблері DISARM, втраті звʼязку, кінці вікна стенду й `outputs_inhibited`;
- рівність заданої «пульт = стенд» для однакового виходу мікшера.

**Done when:** усі ці випадки покриті в `test_drive.c` і зелені.

**DoD:** `run_tests.sh` зелений з тестами: стік → регульований вихід, нейтраль → 0, тумблер DISARM, втрата звʼязку, кінець вікна, outputs_inhibited, «пульт = стенд»
