12romis/esp32-elrs-rover/docs/features/phase2-io/adr/0004-hide-board-indicator-behind-two-colour-port-until-measured.md

---
status: Accepted
owner: "Розробник проєкту"
reviewers: ["Розробник проєкту"]
updated_at: "2026-10-18"
feature_size: "S"
ticket: "roadmap, крок 2 (phase2-io)"
---

# 0004 — Hide the board indicator behind a two-colour port until measured

- **Status:** Accepted
- **Date:** 2026-10-18
- **Deciders:** Архітектор + Розробник (відповідь на питання design, 2026-10-18)

## Context

Власник вимагає, щоб у FAILSAFE горів вбудований RGB-індикатор модуля. Його тип, порядок кольорів і спосіб керування не виміряно (spec OQ-3); на фото модуля біля світлодіода є підписана перемичка IN-OUT, що натякає на адресований світлодіод, але модель не підтверджено. Пункт 3 конституції забороняє підставляти «типове значення».

## Decision drivers

- Пункт 3 і 4 конституції: невиміряна величина не вигадується.
- `ui_core` має лишатися чистою логікою без знання про тип світлодіода.
- Індикатор не має затримувати зупинку моторів (spec §6).

## Considered options

1. **Порт із двома кольорами, драйвер після виміру:** `ui_core` просить «вимкнено» або «червоний»; `ui_hal` має заглушку, а реальний драйвер обирається окремим ADR після виміру.
2. **Драйвер адресованого світлодіода одразу:** припустити тип за фото й керувати через RMT.

## Decision outcome

**Chosen:** Option 1. Варіант 2 спирається на невиміряне припущення, що суперечить пункту 3 конституції; якщо тип інший, ADR доведеться переписувати. Діагностичний тест P8 у `tools/bringup` дає Розробнику виміри, після яких фіксується драйвер.

## Consequences

**Positive**
- `ui_core` і його тести не залежать від типу світлодіода.
- Нічого не вгадано.

**Negative**
- Задача «індикатор» не розбивається на кроки до виміру OQ-3; до того в збірці заглушка.

**Neutral**
- Лінія індикатора з'явиться в єдиному файлі розпіновки разом із виміром.

## Links

- Spec: [[../spec.md]] (AC-19, AC-20, OQ-3)
- SAD: [[../sad.md]] §4, §11
- Related ADR: [[0002-apply-ui-commands-under-mutex-and-poll-state-every-100ms]]
