12romis/esp32-elrs-rover/docs/features/phase2-io/tasks/t13-host-tests-guardrails.md

---
id: T13
title: "Зібрати хостовий раннер і перевірки конституції для phase2-io"
layer: "tests"
deps: ["T1", "T2", "T4", "T5"]
blocks: ["T14"]
acs: ["AC-24", "AC-25"]
files_hint: ["test/host/", "test/host/run_tests.sh"]
owner: "Агент (код і хостові тести)"
estimate: "S"
context_budget: "S"
status: "done"
step: "COMMIT"
---

# T13 — Зібрати хостовий раннер і перевірки конституції для phase2-io

## Place in the sequence

- **Blocked by:** T1 — Створити i2c_bus_core: оцінка результату скану й рядок журналу, T2 — Створити ioexp_core: тіньовий регістр, маска розрядів світла, підтвердження запису, доступність, T4 — Доповнити ui_core: ручний beep, відкладений слот, сигнали переходів, FAILSAFE-блимання й писк, T5 — Розширити console_core: розбір light і beep, порядок перевірок, help і status · **Blocks:** T14 — Підготувати чекліст приймання фази 2 на залізі і запис у журнал bring-up · **Wave:** 4, за графом залежностей.
- **Lane:** власна.

## Why (user story)

> **As a** Агент
> **I want** доводити розбір команд, межі зумера, дозволи за станом, запамʼятований стан розширювача, вибір кольору ліхтарів та індикатора й відлік звучання тестами на хості
> **So that** логіка перевірена до того, як Розробник подасть живлення на світло
>
> — `spec.md §4, US-10, verbatim` · full text: [spec.md](../spec.md)

Цей task дає частину цієї історії: зібрати хостовий раннер і перевірки конституції для phase2-io.

## Inlined context

> **Hard rule:** Будь-яка задача вважається завершеною лише якщо `idf.py build` проходить без помилок і без нових попереджень.
>
> — `constitution.md, п. 8, abridged` · full text: [constitution.md](../../../constitution.md)

> **Hard rule:** Кожен компонент ділиться на `<name>_core.c` (без жодного заголовка ESP-IDF) і `<name>_hal.c`. Логіка живе в core і покривається тестами на хості. Для HAL тести на моках не пишуться: критерій приймання — перевірка на залізі, записана в журнал bring-up.
>
> — `constitution.md, п. 6, verbatim` · full text: [constitution.md](../../../constitution.md)

> **Hard rule:** Номери GPIO існують рівно в одному файлі: `components/board/include/board_pins.h`. Літерал номера піна будь-де ще — дефект, навіть якщо значення правильне.
>
> — `constitution.md, п. 2, verbatim` · full text: [constitution.md](../../../constitution.md)

> **Hard rule:** хостовий прогін ≤ 5 с, 100 % тестів пройдено; збірка 0 помилок, 0 нових попереджень; покриття дозволів: 63 з 63 пар «команда × стан», 21 з 21 пар «канал × стан» для `light`, 49 з 49 пар станів.
>
> — `spec.md §6, «Покриття дозволів команд», «Хостовий прогін тестів», «Збірка», abridged` · full text: [spec.md](../spec.md)

**Fallback:** insufficient or contradicted by the code → read the named file in full ([spec.md](../spec.md) · [sad.md](../sad.md) · [cli.md](../contracts/cli.md) · [adr/](../adr/) · [constitution](../../../constitution.md)) and follow it. Do not guess.

## Data delta

No DB changes.

## API contract

Internal — no API surface.

## Acceptance criteria

### AC-24 — happy path

> **Given** Агент завершив зміну в межах фази 2
> **When** Агент запускає збірку проєкту і прогін хостових тестів
> **Then** збірка завершується без помилок і без нових попереджень, а прогін повідомляє кількість тестів і що всі пройдені; серед них перевірено розбір команд світла й зумера (канали, дії, межі діапазону, неціле, зайві аргументи), запамʼятану копію розширювача (незалежність каналів, маска розрядів, відмова запису не змінює копію), вибір кольору задніх ліхтарів за знаком середнього значень бортів, вибір кольору індикатора для всіх семи станів, вибір автоматичного сигналу зумера за переходами (зокрема злиття стартового ланцюга в один сигнал) і за станом FAILSAFE, відлік закінчення, заміну й періодичний повтор звучання за підставним годинником, вибір режиму блимання задніх ліхтарів у FAILSAFE, матрицю дозволів усіх дев'яти команд у всіх семи станах і для кожного каналу світла
>
> — `spec.md §5, AC-24, verbatim` · full text: [spec.md](../spec.md)

### AC-25 — error

> **Given** у зміні файл чистої логіки (з суфіксом core) підключив заголовок ESP-IDF чи FreeRTOS, або номер лінії чи розряду розширювача зʼявився літералом поза єдиним файлом розпіновки, або підключено застарілий драйвер шини, або швидкість шини піднято вище 100 кГц, або зʼявилося нове попередження збірки
> **When** Агент запускає збірку і хостові перевірки
> **Then** задачу не вважають завершеною, Агент називає файл і причину та не позначає задачу виконаною
>
> — `spec.md §5, AC-25, verbatim` · full text: [spec.md](../spec.md)

## Checklist

- [x] Додати нові тестові файли (`test_i2c_bus.c`, `test_ioexp.c`, `test_ui.c`, розширений `test_console.c`) у наявний хостовий раннер.
- [x] Перевірки конституції: у `*_core.c` немає заголовків ESP-IDF і FreeRTOS; літерали пінів і розрядів — лише в `board_pins.h`; немає застарілого драйвера шини; швидкість шини не вище 100 кГц.
- [x] Раннер друкує кількість тестів, що всі пройдені й покриття пар.

## Edge cases

| Case | Behaviour |
|---|---|
| У core зʼявився заголовок ESP-IDF | перевірка падає, називає файл і причину |
| Номер лінії літералом поза `board_pins.h` | перевірка падає |

## Definition of Done

- [x] Перевірки розрядів, застарілих драйверів шини й швидкості — `test/host/check_bus_rules.sh` (із самоперевіркою в `selftest_tools.sh`).
- [x] Раннер повідомляє кількість тестів і що всі пройдені, ≤ 5 с.
- [x] Покриття 63/63, 21/21, 49/49 виведено.
- [x] Hard rules вище виконуються.
- [x] lint + vet clean
