12romis/esp32-elrs-rover/docs/features/phase2-io/tasks/t7-bringup-p8-p9-indicator-buzzer.md

---
id: T7
title: "Додати діагностичні тести P8 (індикатор плати) і P9 (зумер) у tools/bringup"
layer: "tests"
deps: []
blocks: ["T10", "T11"]
acs: ["AC-08", "AC-20"]
files_hint: ["tools/bringup/main/p8_indicator.c", "tools/bringup/main/p9_buzzer.c", "tools/bringup/main/bringup.h", "tools/bringup/main/main.c", "tools/bringup/main/CMakeLists.txt"]
owner: "Агент (код), Розробник (приймання на залізі)"
estimate: "S"
context_budget: "M"
status: "done"
step: "COMMIT"
---

# T7 — Додати діагностичні тести P8 (індикатор плати) і P9 (зумер) у tools/bringup

## Place in the sequence

- **Blocked by:** — · **Blocks:** T10 — Зафіксувати частоту автоматичних сигналів у ui_calib.h за результатом P9, T11 — Реалізувати драйвер індикатора плати за результатом P8 (окремий ADR) · **Wave:** 1, за графом залежностей.
- **Lane:** власна.

## Why (user story)

> **As a** Розробник
> **I want** командою задати частоту й тривалість сигналу зумера
> **So that** я чую, що зумер працює на заданій частоті, а консоль у цей час відповідає
>
> — `spec.md §4, US-03, verbatim` · full text: [spec.md](../spec.md)

> **As a** Розробник
> **I want** щоб у FAILSAFE задні ліхтарі блимали червоним, вбудований індикатор плати горів червоним, а зумер періодично пищав
> **So that** я помічаю відсічку чи аварійну зупинку, навіть якщо консоль не відкрита, а розширювач недоступний
>
> — `spec.md §4, US-08, verbatim` · full text: [spec.md](../spec.md)

Цей task дає частину цієї історії: додати діагностичні тести P8 (індикатор плати) і P9 (зумер) у tools/bringup.

## Inlined context

> **Hard rule:** Результат кожної передфази записується в `docs/measured.md` до того, як будь-який код чи специфікація використає це значення. Незаписане число для пунктів 3 і 4 не існує.
>
> — `constitution.md, п. 13, verbatim` · full text: [constitution.md](../../../constitution.md)

> **OQ-3.** Який саме вбудований RGB-індикатор на модулі керуючої плати (тип світлодіода, лінія, порядок кольорів, спосіб керування, яскравість)? Від Розробника потрібно: напис/маркування світлодіода або фото, а також прогін діагностичного тесту, що по черзі запалює червоний, зелений і синій і гасить; результат записується у `docs/measured.md`. Фото власника (2026-10-18): біля світлодіода є підписана перемичка «IN-OUT».
>
> — `spec.md §8, OQ-3, abridged` · full text: [spec.md](../spec.md)

> **OQ-2.** Які частоти зумера реально гучні? Розробник під час перевірки записує у `docs/measured.md`, на яких частотах зумер чути найкраще, і обирає з них частоту сигналів.
>
> — `spec.md §8, OQ-2, abridged` · full text: [spec.md](../spec.md)

> Діагностичні прошивки P0–P7 — окремий проєкт `tools/bringup/` (перемикач `BRINGUP_TEST` у `main.c`), збирається там само; прошивку на плату робить Розробник.
>
> — `CLAUDE.md, «Команди», abridged` · full text: [CLAUDE.md](../../../../CLAUDE.md)

**Fallback:** insufficient or contradicted by the code → read the named file in full ([spec.md](../spec.md) · [sad.md](../sad.md) · [cli.md](../contracts/cli.md) · [adr/](../adr/) · [constitution](../../../constitution.md)) and follow it. Do not guess.

## Data delta

No DB changes.

## API contract

Internal — no API surface.

## Acceptance criteria

### AC-08 — happy path

> **Given** ровер у DISARMED або ARMED, зумер мовчить
> **When** Розробник вводить команду зумера з частотою 1000 Гц і тривалістю 300 мс
> **Then** зумер звучить на заданій частоті приблизно задану тривалість і замовкає сам; консоль підтверджує прийняті частоту й тривалість і відповідає на цю та наступні команди одразу, не чекаючи кінця звуку
>
> — `spec.md §5, AC-08, verbatim` · full text: [spec.md](../spec.md)

### AC-20 — domain invariant

> **Given** автомат у довільному з семи станів
> **When** ровер перебуває в цьому стані
> **Then** вбудований індикатор плати світить червоним лише у FAILSAFE і вимкнений в усіх інших станах, зокрема в DISARMED, ARMED і BOOT: червоний індикатор не може бути хибним сигналом тривоги
>
> — `spec.md §5, AC-20, verbatim` · full text: [spec.md](../spec.md)

## Checklist

- [x] P8: по черзі запалює вбудований індикатор червоним, зеленим, синім і гасить, друкує в журнал, що саме подано; перша гіпотеза про спосіб керування береться з фото (адресований світлодіод), але прошивка нічого не вважає підтвердженим; лінія — лише через `board_pins.h` (додається Розробником за вимірюванням).
- [x] P9: послідовно подає на зумер частоти з діапазону 200–5000 Гц (крок і тривалість у тесті), друкує поточну частоту, щоб Розробник міг записати найгучніші.
- [x] Додати значення до перемикача `BRINGUP_TEST`; зібрати `tools/bringup` (`idf.py build`).

## Edge cases

| Case | Behaviour |
|---|---|
| Індикатор не реагує | Розробник записує це в `docs/measured.md`; драйвер не вибирається |
| Усі частоти однаково тихі | записується як результат; діапазон переглядається окремим рішенням |

## Definition of Done

- [x] `tools/bringup` збирається без помилок і нових попереджень.
- [x] Розробник прошиває, проганяє P8 і P9 і записує результат у `docs/measured.md` (OQ-3, OQ-2).
- [x] Агент не прошиває плату.
- [x] lint + vet clean
