12romis/esp32-elrs-rover/docs/features/phase7-telemetry/changelog.md

# Changelog — phase7-telemetry

## phase7-telemetry — телеметрія напруги на пульт, індикація OBSTACLE_HOLD, час кроку керування, README і чекліст

**What:** ровер раз на 200 мс надсилає на пульт кадр датчика батареї CRSF: напруга акумулятора з розв'язністю 0.1 В (струм, ємність і відсоток нульові — «немає даних»); без придатного знімка напруги кадр не йде, а збій передачі пишеться в журнал раз на зміну й ні на що не впливає. Стан OBSTACLE_HOLD тепер чути й видно: подвійний біп (100/100/100 мс, 1000 Гц) на вході та на виході в ARMED, жовтий вбудований індикатор плати, фари блимають при зайнятому передньому секторі, задні ліхтарі — при зайнятому задньому (півперіод 250 мс; ручний стан фар зберігається). `status` показує час кроку керування (останній, середній, найбільший, перевищення періоду 20 мс) і колір індикатора. Додано `README.md`, блок-схему `docs/architecture.md` і чекліст `docs/self-check.md`.

**Why:** після фази 6 напругу було видно лише в USB-консолі, а утримання перед перешкодою не відрізнялося від поломки ([spec](spec.md) §1–§2). Ключові рішення:
- [ADR-0001](adr/0001-send-battery-telemetry-as-a-crsf-battery-frame-from-a-telemetry-task-through-the-crsf-uart-owner.md) — окрема задача `telemetry`; запис у UART2 через `crsf_hal_send` власника лінії.
- [ADR-0002](adr/0002-derive-hold-indication-in-ui-core-from-state-and-control-sector-flags.md) — індикація рахується в `ui_core` зі стану і прапорців секторів `control`; частково замінює «беззвучний» перехід з ADR-0004 phase6-tof.
- [ADR-0003](adr/0003-measure-the-control-step-in-drive-hal-and-keep-the-statistics-in-telemetry-core.md) — відмітки часу навколо кроку `control`, статистика в `telemetry_core`.

**How to use:** прошити плату з VS Code. На пульті має зʼявитися датчик напруги (на модулі передавача співвідношення телеметрії не «вимкнено»). Підʼїхати до стіни — OBSTACLE_HOLD з подвійним бібом, жовтим індикатором і блиманням; `status` показує рядок «крок керування: …». Процедура приймання — [acceptance.md](acceptance.md).

**Acceptance criteria delivered:** AC-01…AC-21 реалізовано; логіка покрита хостовими тестами (15125, таблиця переходів лишилась із 12 пар); документація AC-17, AC-18 готова.

**Відкладено — приймання на залізі (Розробник, [acceptance.md](acceptance.md)):** AC-01…AC-16 на залізі (напруга на екрані пульта, звук, колір, блимання, затримка «кадр → борти», вільна памʼять) і KPI зі spec §7; відкриті питання OQ-1 (чи доходить кадр до пульта), OQ-3 (дребезг біпів на межі порога), OQ-4 (чи справді жовтий колір). Чекліст [self-check.md](../../self-check.md) чесно позначає, що фази 1–7 частково не перевірені на залізі.

**Operational notes:**
- `sdkconfig.defaults` і корінь `CMakeLists.txt` не змінено. Нова задача `telemetry` (core 0, prio 2, стек 4096); шина лишається на 100 кГц. Образ 0x5a960 байтів, 65 % розділу вільно.
- `drive_status_t` отримав `occ_front`/`occ_rear`; `ui_hal_status_t.indicator_red` замінено на колір; `console_ops_t` отримав `step_status`.
- Хостові тести фази 6 про беззвучний перехід у `test_ui.c` змінено під нові правила (spec A14).
- Rollback: прошити попередній образ або revert PR; нових даних у NVS немає.
