12romis/esp32-elrs-rover/docs/features/phase5-pid/changelog.md

# Changelog — phase5-pid

## phase5-pid — регулятор швидкості бортів: PID на швидкості коліс, коефіцієнти з консолі, збереження в NVS

**What:** кожен борт тримає задану швидкість під навантаженням. Крок керування (20 мс) бере задану з мікшера (стік → об/хв колеса, стеля 150), порівнює зі швидкістю борту з енкодерів фази 4 (середнє доступних коліс) і рахує вихід PID: Kp, Ki, Kd і темп розгону `ramp` (об/хв за секунду). Вихід обмежено межею потужності 0.75, накопичена складова на межі не росте, вихід має лише напрямок цілі, диференціальна складова береться від виміру (без удару від стрибка цілі). Розгін обмежує лише зростання модуля цілі; зменшення й нуль діють одразу. Регулятор рахується лише на новому знімку енкодерів; режим (увімкнений / вимкнений) фіксується при озброєнні. Нова консольна команда `pid`: показ стану, `pid kp|ki|kd|ramp <число>` (на ходу, діє з наступного такту), `pid on|off` (лише DISARMED), `pid save` (не в ARMED / OBSTACLE_HOLD), `pid trace on|off` (10 рядків за секунду в ARMED). Набір пишеться одним записом із версією й CRC32; пошкоджений чи неповний запис → «не налаштований». Без налаштованого набору або з `pid off` ровер їде як у фазі 4. Недоступні енкодери, застарілий знімок і будь-яка зупинка фаз 1–3 скидають регулятор і дають відкат на пряме керування / нуль потужності. Межа потужності 0.75 не піднімається.

**Why:** вимір фази 4 показав, що правий борт повільніший (на 0.75 ≈ 11 %, на 0.25 ≈ 36 %); без замкненого контуру ровер веде вбік і втрачає хід під навантаженням ([spec](spec.md) §1–§2). Ключові рішення:
- [ADR-0001](adr/0001-run-speed-regulator-inside-control-step-from-encoder-snapshot.md) — регулятор усередині кроку керування за знімком енкодерів;
- [ADR-0002](adr/0002-store-coefficient-set-as-one-versioned-crc-checked-nvs-record.md) — набір як один версійований запис NVS із CRC32;
- [ADR-0003](adr/0003-print-regulator-trace-from-low-priority-task.md) — трасування з окремої задачі низького пріоритету.

**How to use:** прошити плату з VS Code. DISARMED: `pid kp …`, `pid ki …`, `pid kd …`, `pid ramp …`, `pid on`, `pid save`. `pid trace on` — рядки «pid T мс: ліве задана/швидкість ±вихід | праве …». Процедура приймання на залізі — [acceptance.md](acceptance.md).

**Acceptance criteria delivered:** AC-01…AC-20 реалізовано й покрито хостовими тестами (6704; покриття пар «форма pid × стан» 49/49, «команда × стан × режим» 140/140). Винесено зі scope (§3): AC-11, AC-17, US-07 — захист від заклинення й підняття межі 0.75.

**Відкладено — приймання на залізі (Розробник, [acceptance.md](acceptance.md), spec AC-20):** AC-01, AC-02, AC-05, AC-06, AC-10, AC-13, AC-14 і KPI зі spec §7 (вихідні значення без регулятора, підібраний набір) на залізі **не перевірені**; хостові тести покривають лише логіку на моделі борту. Задачі T7, T8, T10 лишаються у стані `review`. AC-07, AC-08, AC-12, AC-12b відтворити на залізі нічим — лише хост і огляд коду.

**Operational notes:**
- `sdkconfig.defaults` і корінь `CMakeLists.txt` не змінено. Нова задача `pid_trace` (низький пріоритет); нове NVS-сховище набору (одне значення). Образ 0x54c70 байтів, 67 % розділу вільно.
- Конституція: з п. 7 вилучено рядок «ШІМ обмежений 0.75 до завершення фази 5» — межу тепер стереже `test/host/check_power_limit.sh` (єдине визначення `DRIVE_PWM_MAX_PERMILLE 750`).
- Rollback: прошити попередній образ або revert PR; запис набору в NVS лишається в сховищі.
