12romis/esp32-elrs-rover/docs/features/phase6-tof/changelog.md

# Changelog — phase6-tof

## phase6-tof — далекоміри й протизіткнення: ровер зупиняється перед перешкодою, виїжджає назад, переживає відмову датчика

**What:** чотири далекоміри VL53L0X (U7 ліворуч-вперед, U8 вперед, U9 праворуч-вперед, U10 назад) зведено в два сектори — передній і задній. Задача `sensors` (core 0, 50 мс) фільтрує відліки медіаною з трьох; сектор зайнятий, коли відстань строго менша за поріг **170 мм** (`TOF_OBSTACLE_MM`, `docs/measured.md`, 2026-10-21). Крок керування після мікшера обнуляє тягу в бік зайнятого сектору, лишає поворот на місці й рух у вільний бік, а автомат станів іде ARMED ↔ **OBSTACLE_HOLD** (стан, що досі був недосяжним). Відмова датчика (250 мс без відліку або не відповів на старті) не зупиняє й не вішає прошивку: сектор не вважається зайнятим через нього, у журналі одне попередження, повернути датчик можна командою `tof reinit` лише в DISARMED. Нова команда `tof` показує датчики, сектори, поріг і режим захисту.

**Why:** після фази 5 ровер тримав швидкість, але на повному стіку в'їжджав у стіну ([spec](spec.md) §1–§2). Ключові рішення:
- [ADR-0001](adr/0001-apply-obstacle-limit-inside-control-step-from-tof-snapshot.md) — обмеження тяги в кроці `control` зі знімка далекомірів (єдина точка для пульта й консолі);
- [ADR-0002](adr/0002-let-ioexp-own-the-whole-expander-byte-including-the-sensor-reset-lines.md) — `ioexp` володіє всім байтом розширювача, включно з лініями скидання датчиків (інакше запис світла скидав би датчики й збивав адреси);
- [ADR-0003](adr/0003-poll-rangefinders-in-a-separate-sensors-task-and-detect-failure-there.md) — окрема задача `sensors` з власним виявленням відмови;
- [ADR-0004](adr/0004-treat-obstacle-hold-as-a-driving-state-through-one-predicate.md) — OBSTACLE_HOLD як стан руху через один предикат і 12-та пара переходів OBSTACLE_HOLD → DISARMED.

**How to use:** прошити плату з VS Code. Їхати як зазвичай: перед стіною ровер зупиняється (рядок «OBSTACLE_HOLD: … поріг 170 мм; перший відлік менше порога … різниця N мс»), стіком назад чи вбік виїжджає, а сам повертається в ARMED, коли сектор вільний три оновлення поспіль. Консоль: `tof` (будь-який стан), `tof reinit` (лише DISARMED, ≤ 3 с, опитування решти датчиків на цей час призупиняється), `drive` приймається й в OBSTACLE_HOLD. Поріг змінюється лише правкою `components/tof/include/tof_calib.h` після запису в `docs/measured.md`.

**Acceptance criteria delivered:** AC-01…AC-19 реалізовано й покрито хостовими тестами (15001; таблиця переходів — 12 пар із 49, матриці «форма tof × стан» 14/14 і «команда × стан × режим» 140/140). Рішення Розробника в процесі: STBY піднімає лише свідома команда руху (стік чи `drive`) в ARMED або OBSTACLE_HOLD, перехід станів його не піднімає (spec A10, OQ-3); AC-08 послаблено — на час `tof reinit` опитування решти датчиків призупиняється; `sensors` не підписана на Task WDT (Decision override у [sad.md](sad.md) §1).

**Відкладено — приймання на залізі (Розробник, [acceptance.md](acceptance.md), spec AC-19):** AC-01…AC-12, AC-14…AC-16 і KPI зі spec §7 (відстані зупинки на 100 %, 60 %, 30 %, Δ реакції ≤ 250 мс, 4 вийняті шлейфи з 4, 4 повернення з 4). Також **OQ-2** — поведінка далекоміра ближче 40 мм не виміряна. Розрахунковий зазор після зупинки в найгіршому випадку ≈ 42 мм (170 − 128), лише трохи вище 40 мм. HAL (`tof_hal`, `ioexp_hal`, `drive_hal`, `console_hal`, `main`) перевірено лише збіркою, без заліза.

**Operational notes:**
- `sdkconfig.defaults` і корінь `CMakeLists.txt` не змінено. Нова задача `sensors` (стек 4096, core 0, prio 3); шина лишається на 100 кГц. Образ 0x59b40 байтів, 65 % розділу вільно; вільну внутрішню пам'ять після старту записати зі `status` (поріг ≥ 345000 байт).
- Таблиця переходів автомата тепер має 12 пар (було 11): діаграма в `docs/02-FIRMWARE-CONTEXT.md` §6.3 оновлена. Хостовий раннер переписано на паралельну збірку (≈ 0.7 с замість 5.1 с).
- Конституція не змінювалась; тлумачення п. 7 щодо STBY записано в spec A10 / OQ-3.
- Rollback: прошити попередній образ або revert PR; нових даних у NVS немає.
