12romis/esp32-elrs-rover/kicad-rover/kicad-rover.kicad_pcb

## KiCad design kicad-rover/kicad-rover.kicad_pcb (2026-10-16)

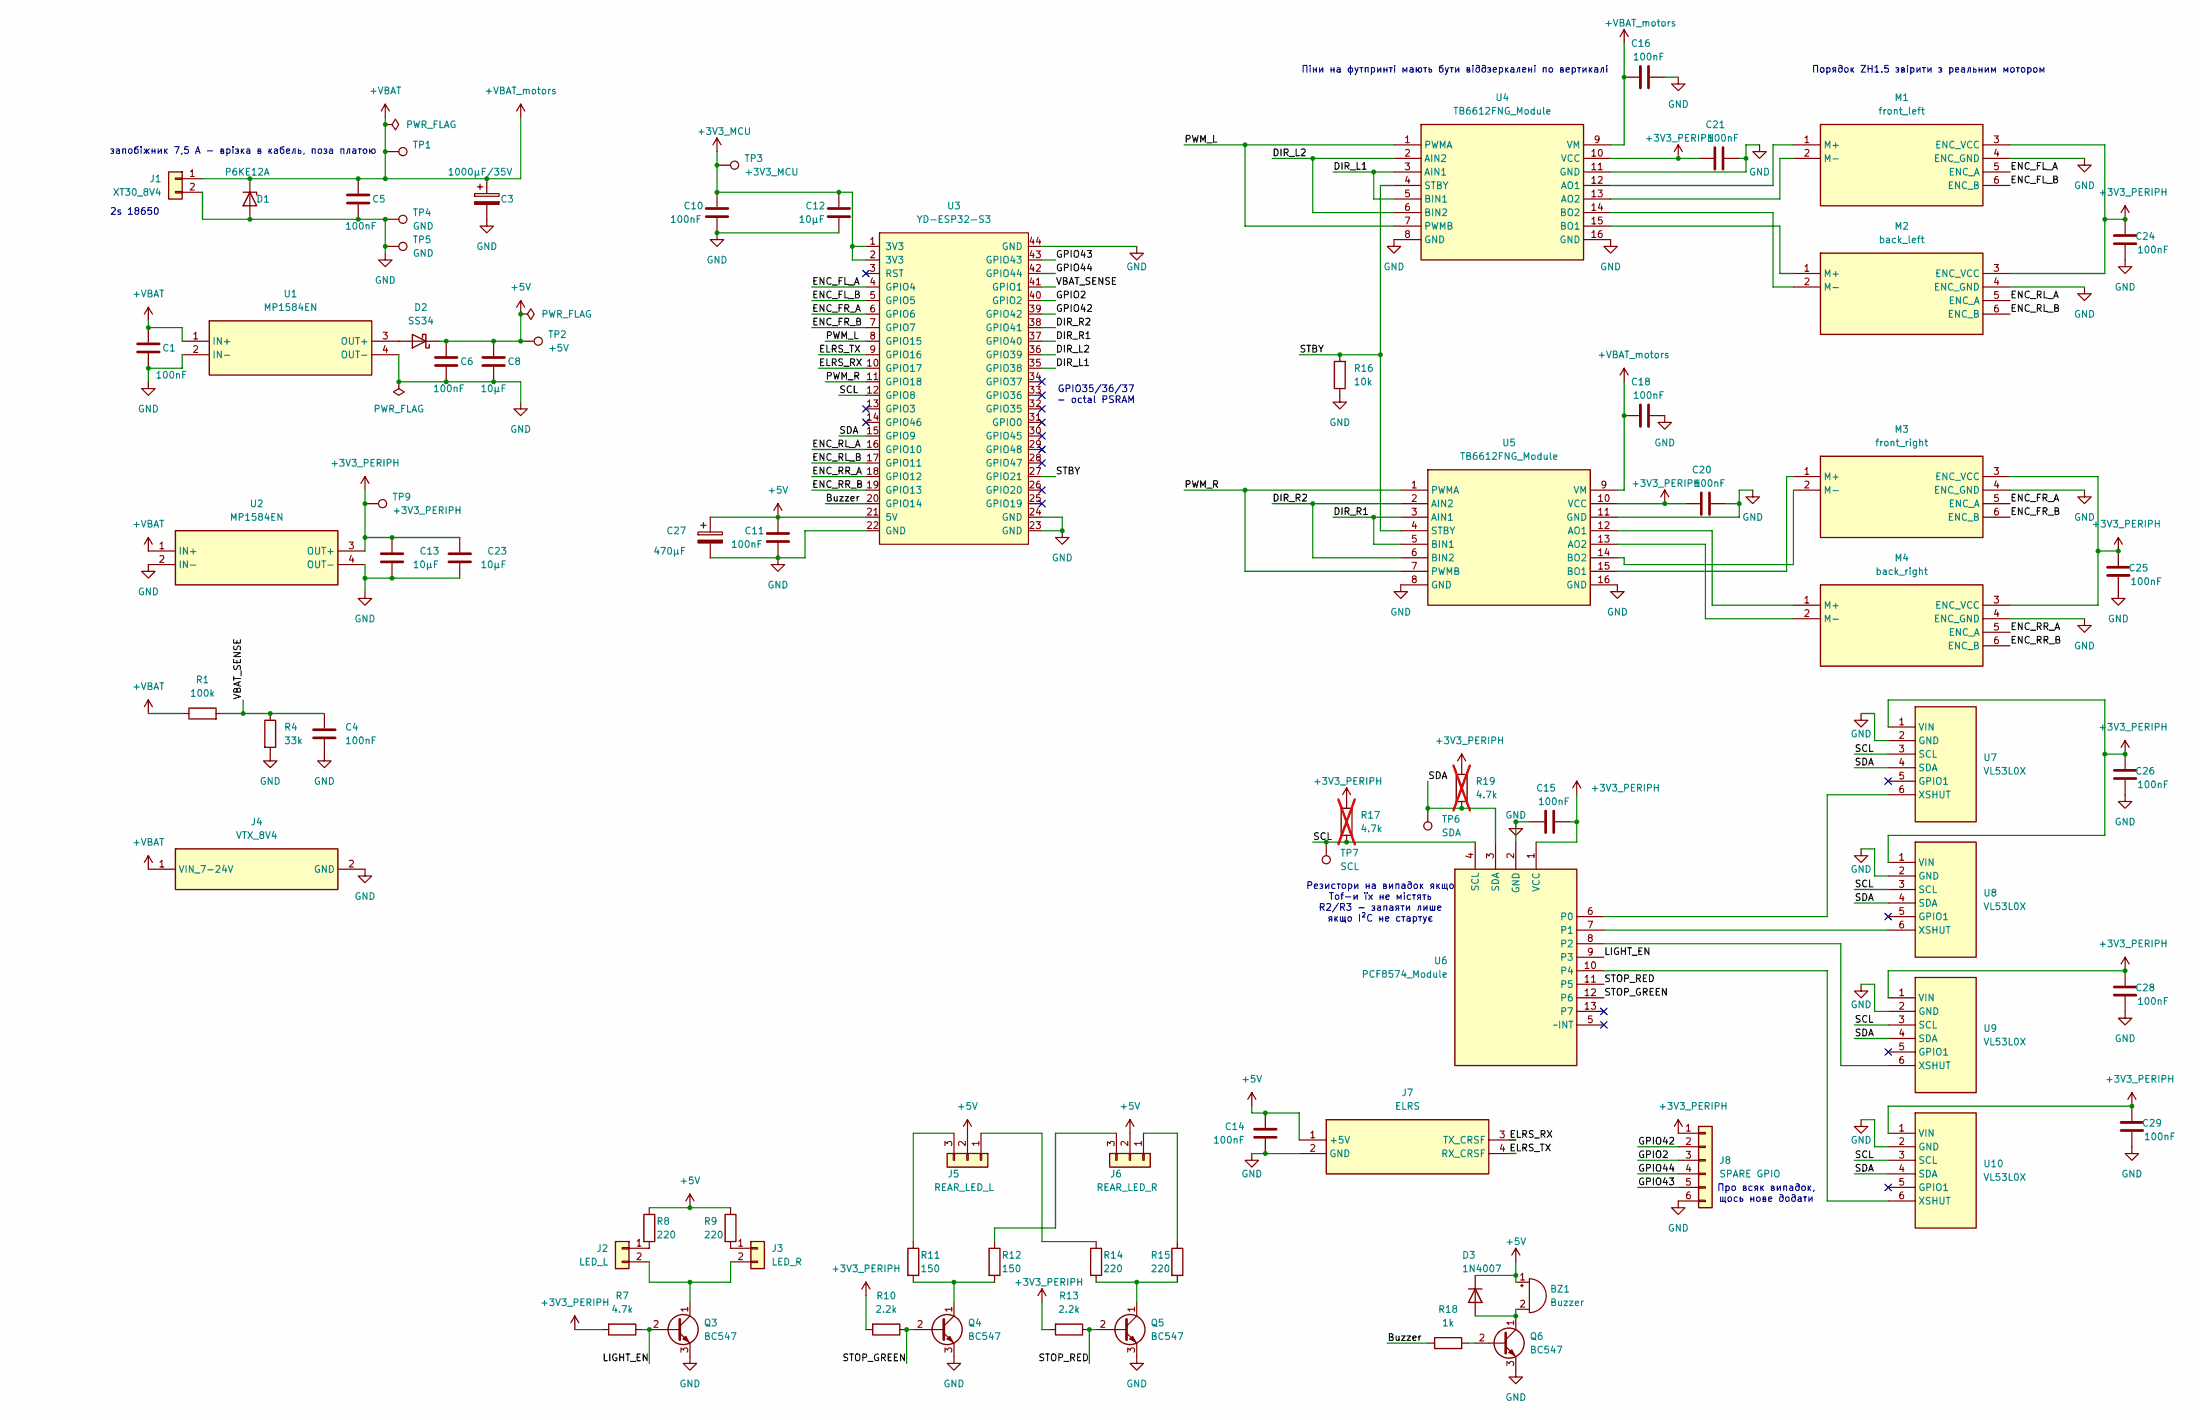
[picture p2: schematic kicad-rover.kicad_sch, Ihor Romanenko's ROVER]

Parts:
BZ1: Buzzer; Buzzer_12x9.5RM7.6
C1, C4, C5, C6, C10, C11, C14, C15, C16, C18, C20, C21, C24, C25, C26, C28, C29: 100nF; C_Disc_D5.0mm_W2.5mm_P5.00mm
C3: 1000µF/35V; CP_Radial_D12.5mm_P5.00mm
C8, C12, C13, C23: 10µF; C_0805_2012Metric
C27: 470µF; CP_Radial_D12.5mm_P5.00mm
D1: P6KE12A; D_DO-15_P12.70mm_Horizontal
D2: SS34; D_SMA
D3: 1N4007; D_DO-41_SOD81_P10.16mm_Horizontal
J1: XT30_8V4; SolderWire-2.5sqmm_1x02_P8.8mm_D2.4mm_OD4.4mm
J2: LED_L; JST_PH_B2B-PH-K_1x02_P2.00mm_Vertical
J3: LED_R; JST_PH_B2B-PH-K_1x02_P2.00mm_Vertical
J4: VTX_8V4; JST_PH_B2B-PH-K_1x02_P2.00mm_Vertical
J5: REAR_LED_L; JST_PH_B3B-PH-K_1x03_P2.00mm_Vertical
J6: REAR_LED_R; JST_PH_B3B-PH-K_1x03_P2.00mm_Vertical
J7: ELRS; JST_PH_B4B-PH-K_1x04_P2.00mm_Vertical
J8: SPARE GPIO; PinHeader_1x06_P2.54mm_Vertical
M1: front_left; JST_PH_B6B-PH-K_1x06_P2.00mm_Vertical
M2: back_left; JST_PH_B6B-PH-K_1x06_P2.00mm_Vertical
M3: front_right; JST_PH_B6B-PH-K_1x06_P2.00mm_Vertical
M4: back_right; JST_PH_B6B-PH-K_1x06_P2.00mm_Vertical
Q3, Q4, Q5, Q6: BC547; TO-92_Inline
R1: 100k; R_Axial_DIN0207_L6.3mm_D2.5mm_P7.62mm_Horizontal
R4: 33k; R_Axial_DIN0207_L6.3mm_D2.5mm_P7.62mm_Horizontal
R7: 4.7k; R_Axial_DIN0207_L6.3mm_D2.5mm_P7.62mm_Horizontal
R8, R9, R14, R15: 220; R_Axial_DIN0207_L6.3mm_D2.5mm_P7.62mm_Horizontal
R10, R13: 2.2k; R_Axial_DIN0207_L6.3mm_D2.5mm_P7.62mm_Horizontal
R11, R12: 150; R_Axial_DIN0207_L6.3mm_D2.5mm_P7.62mm_Horizontal
R16: 10k; R_Axial_DIN0207_L6.3mm_D2.5mm_P7.62mm_Horizontal
R17, R19: 4.7k; R_Axial_DIN0207_L6.3mm_D2.5mm_P7.62mm_Horizontal; not fitted
R18: 1k; R_Axial_DIN0207_L6.3mm_D2.5mm_P7.62mm_Horizontal
TP1: +VBAT; TestPoint_THTPad_D1.5mm_Drill0.7mm
TP2: +5V; TestPoint_THTPad_D1.5mm_Drill0.7mm
TP3: +3V3_MCU; TestPoint_THTPad_D1.5mm_Drill0.7mm
TP4, TP5: GND; TestPoint_THTPad_D1.5mm_Drill0.7mm
TP6: SDA; TestPoint_THTPad_D1.5mm_Drill0.7mm
TP7: SCL; TestPoint_THTPad_D1.5mm_Drill0.7mm
TP9: +3V3_PERIPH; TestPoint_THTPad_D1.5mm_Drill0.7mm
U1, U2: MP1584EN; MP1584EN_Module
U3: YD-ESP32-S3
U4, U5: TB6612FNG_Module
U6: PCF8574_Module; PCF8574_IO_Expansion_Module_1
U7, U8, U9, U10: VL53L0X; JST_PH_B6B-PH-K_1x06_P2.00mm_Vertical

Connections:
+3V3_MCU: C10.2, C12.2, TP3.1 (1_1), U3.1 (3V3), U3.2 (3V3)
+3V3_PERIPH: C13.2, C15.1, C20.2, C21.2, C23.2, C24.2, C25.2, C26.2, C28.2, C29.2, J8.1, M1.3 (ENC_VCC), M2.3 (ENC_VCC), M3.3 (ENC_VCC), M4.3 (ENC_VCC), R7.2, R10.2, R13.2, R17.1, R19.1, TP9.1 (1_1), U2.3 (OUT+), U4.10 (VCC), U5.10 (VCC), U6.1 (VCC), U7.1 (VIN), U8.1 (VIN), U9.1 (VIN), U10.1 (VIN)
+5V: BZ1.1 (+), C6.2, C8.2, C11.2, C14.2, C27.1, D2.1 (K), D3.1 (K), J5.2, J6.2, J7.1 (+5V), R8.1, R9.1, TP2.1 (1_1), U3.21 (5V)
+VBAT: C1.2, C3.1, C5.2, C16.2, C18.2, D1.1 (K), J1.1, J4.1 (VIN_7-24V), R1.1, TP1.1 (1_1), U1.1 (IN+), U2.1 (IN+), U4.9 (VM), U5.9 (VM)
/Buzzer: R18.1, U3.20 (GPIO14)
/DIR_L1: U3.35 (GPIO38), U4.3 (AIN1), U4.5 (BIN1)
/DIR_L2: U3.36 (GPIO39), U4.2 (AIN2), U4.6 (BIN2)
/DIR_R1: U3.37 (GPIO40), U5.3 (AIN1), U5.5 (BIN1)
/DIR_R2: U3.38 (GPIO41), U5.2 (AIN2), U5.6 (BIN2)
/ELRS_RX: J7.3 (TX_CRSF), U3.10 (GPIO17)
/ELRS_TX: J7.4 (RX_CRSF), U3.9 (GPIO16)
/ENC_FL_A: M1.5 (ENC_A), U3.4 (GPIO4)
/ENC_FL_B: M1.6 (ENC_B), U3.5 (GPIO5)
/ENC_FR_A: M3.5 (ENC_A), U3.6 (GPIO6)
/ENC_FR_B: M3.6 (ENC_B), U3.7 (GPIO7)
/ENC_RL_A: M2.5 (ENC_A), U3.16 (GPIO10)
/ENC_RL_B: M2.6 (ENC_B), U3.17 (GPIO11)
/ENC_RR_A: M4.5 (ENC_A), U3.18 (GPIO12)
/ENC_RR_B: M4.6 (ENC_B), U3.19 (GPIO13)
/GPIO2: J8.3, U3.40 (GPIO2)
/GPIO42: J8.2, U3.39 (GPIO42)
/GPIO43: J8.5, U3.43 (GPIO43)
/GPIO44: J8.4, U3.42 (GPIO44)
/LIGHT_EN: Q3.2 (B), R7.1, U6.9 (P3)
/PWM_L: U3.8 (GPIO15), U4.1 (PWMA), U4.7 (PWMB)
/PWM_R: U3.11 (GPIO18), U5.1 (PWMA), U5.7 (PWMB)
/SCL: R17.2, TP7.1 (1_1), U3.12 (GPIO8), U6.4 (SCL), U7.3 (SCL), U8.3 (SCL), U9.3 (SCL), U10.3 (SCL)
/SDA: R19.2, TP6.1 (1_1), U3.15 (GPIO9), U6.3 (SDA), U7.4 (SDA), U8.4 (SDA), U9.4 (SDA), U10.4 (SDA)
/STBY: R16.2, U3.27 (GPIO21), U4.4 (STBY), U5.4 (STBY)
/STOP_GREEN: Q4.2 (B), R10.1, U6.12 (P6)
/STOP_RED: Q5.2 (B), R13.1, U6.11 (P5)
/VBAT_SENSE: C4.2, R1.2, R4.1, U3.41 (GPIO1)
GND: C1.1, C3.2, C4.1, C5.1, C6.1, C8.1, C10.1, C11.1, C12.1, C13.1, C14.1, C15.2, C16.1, C18.1, C20.1, C21.1, C23.1, C24.1, C25.1, C26.1, C27.2, C28.1, C29.1, D1.2 (A), J1.2, J4.2 (GND), J7.2 (GND), J8.6, M1.4 (ENC_GND), M2.4 (ENC_GND), M3.4 (ENC_GND), M4.4 (ENC_GND), Q3.3 (E), Q4.3 (E), Q5.3 (E), Q6.3 (E), R4.2, R16.1, TP4.1 (1_1), TP5.1 (1_1), U1.2 (IN-), U1.4 (OUT-), U2.2 (IN-), U2.4 (OUT-), U3.22 (GND), U3.23 (GND), U3.24 (GND), U3.44 (GND), U4.8 (GND), U4.11 (GND), U4.16 (GND), U5.8 (GND), U5.11 (GND), U5.16 (GND), U6.2 (GND), U7.2 (GND), U8.2 (GND), U9.2 (GND), U10.2 (GND)
unnamed: BZ1.2 (-), D3.2 (A), Q6.1 (C)
unnamed: D2.2 (A), U1.3 (OUT+)
unnamed: J2.1, R8.2
unnamed: J2.2, J3.2, Q3.1 (C)
unnamed: J3.1, R9.2
unnamed: J5.1, R14.1
unnamed: J5.3, R11.1
unnamed: J6.1, R15.1
unnamed: J6.3, R12.1
unnamed: M1.1 (M+), U4.12 (AO1)
unnamed: M1.2 (M-), U4.13 (AO2)
unnamed: M2.1 (M+), U4.15 (BO1)
unnamed: M2.2 (M-), U4.14 (BO2)
unnamed: M3.1 (M+), U5.15 (BO1)
unnamed: M3.2 (M-), U5.14 (BO2)
unnamed: M4.1 (M+), U5.12 (AO1)
unnamed: M4.2 (M-), U5.13 (AO2)
unnamed: Q4.1 (C), R11.2, R12.2
unnamed: Q5.1 (C), R14.2, R15.2
unnamed: Q6.2 (B), R18.2
unnamed: U6.6 (P0), U7.6 (XSHUT)
unnamed: U6.7 (P1), U8.6 (XSHUT)
unnamed: U6.8 (P2), U9.6 (XSHUT)
unnamed: U6.10 (P4), U10.6 (XSHUT)

Notes on the sheet:
Порядок ZH1.5 звірити з реальним мотором
Піни на футпринті мають бути віддзеркалені по вертикалі
GPIO35/36/37 - octal PSRAM
2s 18650
запобіжник 7,5 А - врізка в кабель, поза платою
Про всяк випадок, щось нове додати
Резистори на випадок якщо Tof-и їх не містять R2/R3 - запаяти лише якщо I²C не стартує

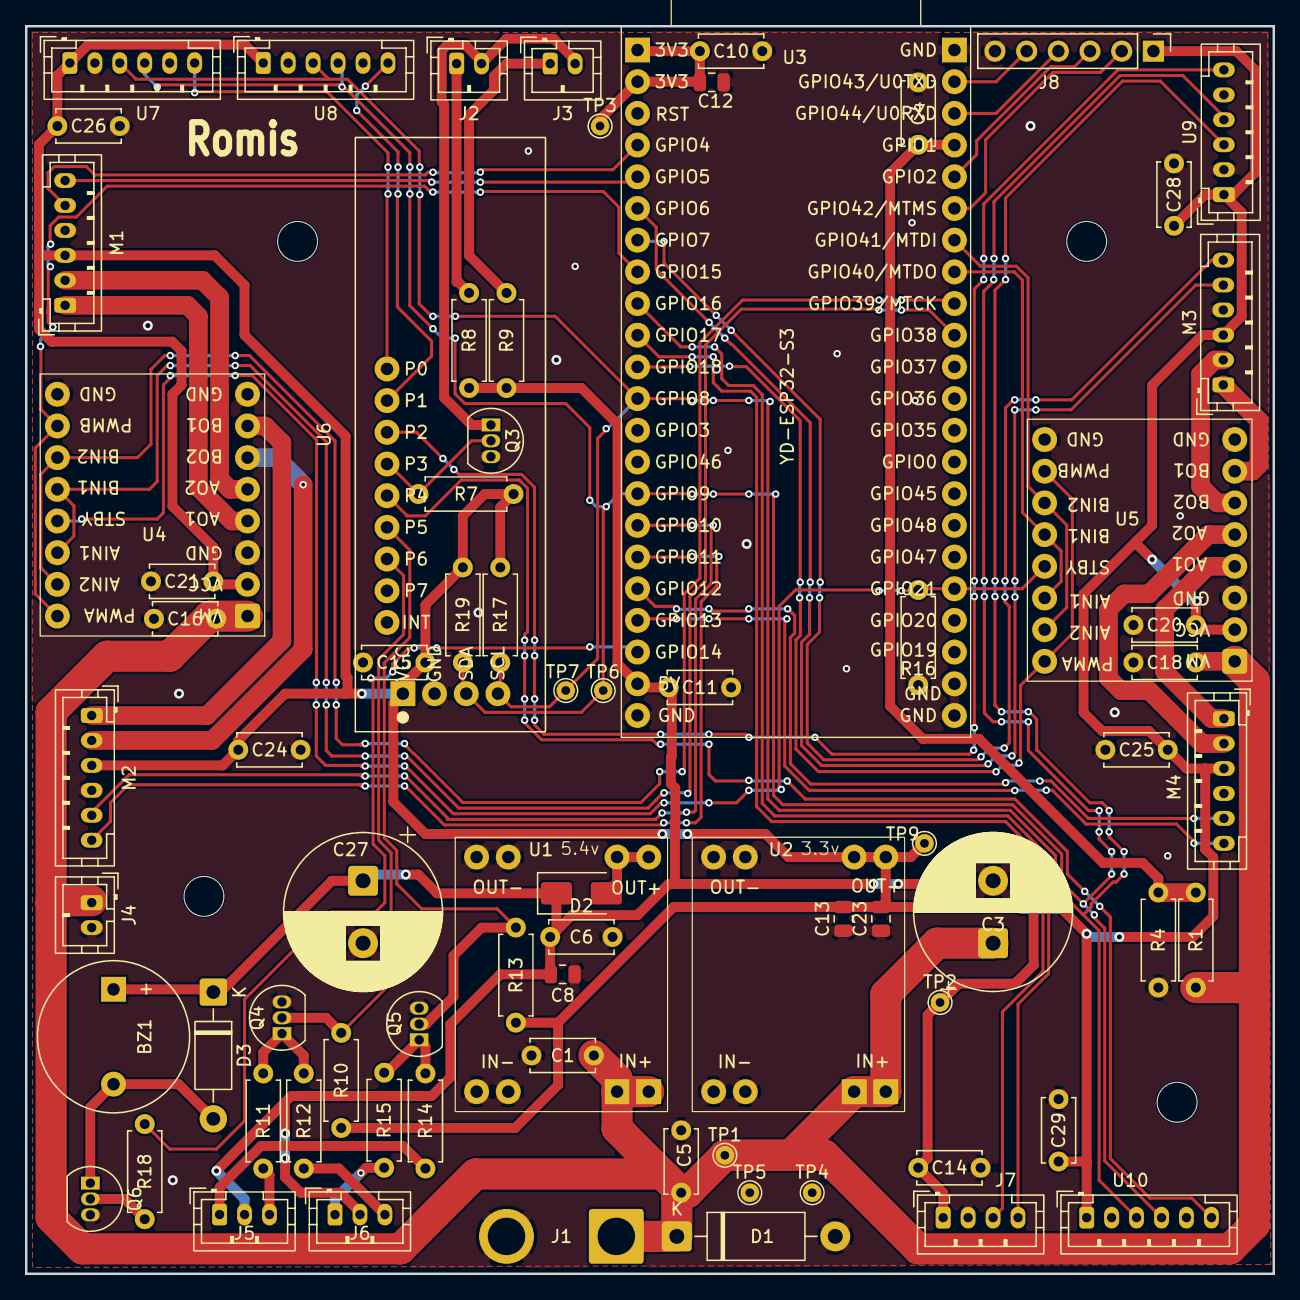
[picture p3: board kicad-rover.kicad_pcb from above]

Board: 2 copper layers, 100.0 x 100.0 mm, 80 parts (0 on the bottom side), 57 nets.

Other parts of the board:
H1, H2, H3, H4: MountingHole_3.2mm_M3
