12romis/esp32-elrs-rover/components/drive/drive_hal.c

// HAL руху: виконує рішення drive_core. Єдиний власник ліній моторів (ADR-0001).
#include "drive_hal.h"

#include "app_state_hal.h"
#include "battery_hal.h"
#include "board_pins.h"
#include "crsf_hal.h"
#include "driver/gpio.h"
#include "driver/ledc.h"
#include "encoders_hal.h"
#include "esp_log.h"
#include "esp_task_wdt.h"
#include "esp_timer.h"
#include "freertos/FreeRTOS.h"
#include "freertos/queue.h"
#include "freertos/semphr.h"
#include "freertos/task.h"
#include "pid_hal.h"
#include "session_hal.h"
#include "telemetry_hal.h"
#include "tof_hal.h"

#define CONTROL_STACK 4096
#define CONTROL_PRIORITY 5
#define CONTROL_CORE 1
#define CONTROL_PERIOD_MS 20
#define REQUEST_MAX_AGE_MS 150   // запит старший за це control відкидає; менший за REPLY_TIMEOUT_MS із запасом (ADR-0001)
#define LAT_LOG_PERIOD_MS 5000   // підсумок затримки «кадр → борти» в журналі раз на 5 с їзди з пульта
#define REPLY_TIMEOUT_MS 200
#define QUEUE_LEN 4

#define PWM_FREQ_HZ 20000
#define PWM_RES LEDC_TIMER_10_BIT
#define PWM_DUTY_MAX 1023
#define LEDC_MODE LEDC_LOW_SPEED_MODE
#define LEDC_TIMER_MOTORS LEDC_TIMER_0
#define LEDC_CH_LEFT LEDC_CHANNEL_0
#define LEDC_CH_RIGHT LEDC_CHANNEL_1

static const char *TAG = "drive";

typedef struct {
    drive_req_t req;
    uint32_t t_ms;
    uint32_t seq;
} queued_req_t;

static bool s_init_ok;
static volatile bool s_running;   // true лише після успішної підписки control на Task WDT (ADR-0004)
static QueueHandle_t s_queue;
static SemaphoreHandle_t s_submit_lock;
static SemaphoreHandle_t s_reply_sem;
static drive_reply_t s_reply;
static uint32_t s_reply_seq;
static uint32_t s_next_seq;

static portMUX_TYPE s_lock = portMUX_INITIALIZER_UNLOCKED;
static drive_status_t s_status;

static uint32_t now_ms(void)
{
    return (uint32_t)(esp_timer_get_time() / 1000);
}

static void gpio_out_low(int pin)
{
    gpio_set_level(pin, 0);
    gpio_config_t cfg = {
        .pin_bit_mask = 1ULL << pin,
        .mode = GPIO_MODE_OUTPUT,
        .pull_up_en = GPIO_PULLUP_DISABLE,
        .pull_down_en = GPIO_PULLDOWN_DISABLE,
        .intr_type = GPIO_INTR_DISABLE,
    };
    gpio_config(&cfg);
    gpio_set_level(pin, 0);
}

static void set_duty(ledc_channel_t ch, uint32_t permille)
{
    uint32_t duty = permille * PWM_DUTY_MAX / 1000;
    ledc_set_duty(LEDC_MODE, ch, duty);
    ledc_update_duty(LEDC_MODE, ch);
}

// Застосовує виходи. Вимкнення: ШІМ і напрямок, потім STBY; ввімкнення: напрямок і ШІМ, STBY останньою.
static void apply_outputs(const drive_outputs_t *o)
{
    if (!o->stby) {
        set_duty(LEDC_CH_LEFT, 0);
        set_duty(LEDC_CH_RIGHT, 0);
        gpio_set_level(PIN_DIR_L1, 0);
        gpio_set_level(PIN_DIR_L2, 0);
        gpio_set_level(PIN_DIR_R1, 0);
        gpio_set_level(PIN_DIR_R2, 0);
        gpio_set_level(PIN_STBY, 0);
        return;
    }
    gpio_set_level(PIN_DIR_L1, o->left.dir1);
    gpio_set_level(PIN_DIR_L2, o->left.dir2);
    gpio_set_level(PIN_DIR_R1, o->right.dir1);
    gpio_set_level(PIN_DIR_R2, o->right.dir2);
    set_duty(LEDC_CH_LEFT, o->left.duty_permille);
    set_duty(LEDC_CH_RIGHT, o->right.duty_permille);
    gpio_set_level(PIN_STBY, 1);
}

esp_err_t drive_hal_init(void)
{
    // Лінії напрямку й STBY — виходи з низьким рівнем (STBY до цього тримала притяжка R16).
    gpio_out_low(PIN_STBY);
    gpio_out_low(PIN_DIR_L1);
    gpio_out_low(PIN_DIR_L2);
    gpio_out_low(PIN_DIR_R1);
    gpio_out_low(PIN_DIR_R2);

    ledc_timer_config_t timer = {
        .speed_mode = LEDC_MODE,
        .timer_num = LEDC_TIMER_MOTORS,
        .duty_resolution = PWM_RES,
        .freq_hz = PWM_FREQ_HZ,
        .clk_cfg = LEDC_AUTO_CLK,
    };
    esp_err_t err = ledc_timer_config(&timer);
    if (err != ESP_OK) {
        ESP_LOGE(TAG, "ledc_timer_config: %s — моторів не запущено", esp_err_to_name(err));
        return err;
    }
    ledc_channel_config_t left = {
        .gpio_num = PIN_PWM_L,
        .speed_mode = LEDC_MODE,
        .channel = LEDC_CH_LEFT,
        .timer_sel = LEDC_TIMER_MOTORS,
        .duty = 0,
        .hpoint = 0,
    };
    ledc_channel_config_t right = left;
    right.gpio_num = PIN_PWM_R;
    right.channel = LEDC_CH_RIGHT;
    err = ledc_channel_config(&left);
    if (err == ESP_OK) {
        err = ledc_channel_config(&right);
    }
    if (err != ESP_OK) {
        ESP_LOGE(TAG, "ledc_channel_config: %s — моторів не запущено", esp_err_to_name(err));
        return err;
    }
    drive_outputs_t off = drive_outputs_off();
    apply_outputs(&off);
    s_init_ok = true;
    ESP_LOGI(TAG, "лінії моторів у вимкненому стані (ШІМ 20 кГц, 10 біт)");
    return ESP_OK;
}

bool drive_hal_running(void)
{
    return s_running;
}

void drive_hal_status(drive_status_t *s)
{
    portENTER_CRITICAL(&s_lock);
    *s = s_status;
    portEXIT_CRITICAL(&s_lock);
}

bool drive_hal_submit(const drive_req_t *req, drive_reply_t *reply)
{
    if (!s_running) {
        return false;
    }
    xSemaphoreTake(s_submit_lock, portMAX_DELAY);
    while (xSemaphoreTake(s_reply_sem, 0) == pdTRUE) {
    }  // прибрати прострочену відповідь попереднього запиту
    queued_req_t item = {.req = *req, .t_ms = now_ms(), .seq = ++s_next_seq};
    bool ok = false;
    if (xQueueSend(s_queue, &item, 0) == pdTRUE) {
        TickType_t deadline = xTaskGetTickCount() + pdMS_TO_TICKS(REPLY_TIMEOUT_MS);
        for (;;) {
            TickType_t now = xTaskGetTickCount();
            if ((int32_t)(deadline - now) <= 0 ||
                xSemaphoreTake(s_reply_sem, deadline - now) != pdTRUE) {
                break;
            }
            if (s_reply_seq == item.seq) {
                *reply = s_reply;
                ok = true;
                break;
            }
        }
    }
    xSemaphoreGive(s_submit_lock);
    return ok;
}

static void log_stop(const drive_ctl_out_t *o, const drive_ctl_in_t *in, uint32_t now)
{
    switch (o->stop) {
    case DRIVE_STOP_WINDOW_EXPIRED:
        ESP_LOGI(TAG, "команда руху спливла — мотори вимкнено, ровер роззброєно; мінімальна напруга за час руху: %u мВ",
                 (unsigned)o->min_mv);
        break;
    case DRIVE_STOP_LOW_VOLTAGE:
        ESP_LOGW(TAG, "напруга %u мВ нижча за поріг — мотори вимкнено, FAILSAFE (вихід лише апаратним скиданням)",
                 (unsigned)o->mv);
        break;
    case DRIVE_STOP_STALE_VOLTAGE:
        ESP_LOGW(TAG, "вимірювання напруги застаріло або відсутнє — мотори вимкнено, FAILSAFE");
        break;
    case DRIVE_STOP_DISARM:
        if (app_state_is_driving(in->state)) {
            ESP_LOGI(TAG, "роззброєно — мотори вимкнено");
        }
        break;
    case DRIVE_STOP_LINK_LOST:
        // Мітка останнього кадру й мітка переходу — для перевірки ≤ 520 мс під час приймання (spec §6).
        ESP_LOGW(TAG, "%s — мотори вимкнено, FAILSAFE (причина: втрата звʼязку); останній кадр: %u мс, перехід: %u мс",
                 drive_stop_text(o->stop), (unsigned)in->rc.t_ms, (unsigned)now);
        break;
    case DRIVE_STOP_REMOTE_APPEARED:
    case DRIVE_STOP_SWITCH_DISARM:
        ESP_LOGI(TAG, "%s", drive_stop_text(o->stop));
        break;
    case DRIVE_STOP_NONE:
        break;
    }
}

// Події кроку для журналу: по одному рядку на подію, не на такт (contracts/cli.md, «Журнал без команд»).
static void log_events(const drive_ctl_out_t *o, const drive_ctl_in_t *in, uint32_t now, bool occ_front, bool occ_rear)
{
    if (o->events & DRIVE_EVT_REMOTE_APPEARED) {
        ESP_LOGI(TAG, "з'явився пульт — стендовий режим закінчено; консольні arm і drive вимкнено до перезапуску плати");
    }
    if ((o->events & DRIVE_EVT_LINK_LOST) && o->stop != DRIVE_STOP_LINK_LOST) {
        ESP_LOGW(TAG, "звʼязок з пультом втрачено (%u мс від останнього кадру)", (unsigned)(now - in->rc.t_ms));
    }
    if (o->events & DRIVE_EVT_LINK_RESTORED) {
        ESP_LOGI(TAG, "звʼязок з пультом відновлено");
    }
    if (o->events & DRIVE_EVT_REMOTE_ARMED) {
        ESP_LOGI(TAG, "озброєння з пульта: тумблер перемкнуто в ARM (джерело: пульт)");
    }
    if (o->events & DRIVE_EVT_ARM_REFUSED) {
        ESP_LOGW(TAG, "озброєння з пульта відхилено: %s", drive_block_text(o->arm_block));
    }
    if (o->events & DRIVE_EVT_FAILSAFE_EXIT) {
        ESP_LOGI(TAG, "вихід із FAILSAFE: звʼязок стабільний, тумблер у DISARM");
    }
    if (o->events & DRIVE_EVT_ENC_STALE) {
        ESP_LOGW(TAG, "вимірювання швидкості коліс не оновлюється понад %u мс — обидва борти без регулятора",
                 (unsigned)DRIVE_ENC_STALE_MS);
    }
    if (o->events & DRIVE_EVT_HOLD_ENTER) {   // утримання перед перешкодою (phase6-tof): сектор, відстань, датчик, поріг
        char line[320];   // рядок входу в утримання з мітками ≈ 280 байтів (UTF-8)
        tof_fmt_hold_line(line, sizeof(line), (tof_sector_t)o->hold_sector, o->hold_mm, o->hold_nearest, o->hold_has_first,
                          o->hold_first_ms, now);
        // Усі датчики зайнятих секторів, що бачать перешкоду, з відстанями (phase8 A4): один рядок на вхід в утримання.
        char sensors[120];
        if (tof_fmt_hold_sensors(sensors, sizeof(sensors), &in->tof, occ_front, occ_rear) > 0) {
            ESP_LOGW(TAG, "OBSTACLE_HOLD: %s; датчики нижче порога: %s", line, sensors);
        } else {
            ESP_LOGW(TAG, "OBSTACLE_HOLD: %s", line);
        }
    }
    if (o->events & DRIVE_EVT_HOLD_EXIT) {
        if (o->tof_control_on) {
            ESP_LOGI(TAG, "сектор вільний — повернення в ARMED");
        } else {
            ESP_LOGI(TAG, "контроль перешкод вимкнено — повернення в ARMED");   // перешкода може лишатися перед ровером
        }
    }
    if (o->events & DRIVE_EVT_TOF_STALE) {
        ESP_LOGW(TAG, "знімок далекомірів застарів або не отримано — сектори не охороняються, захист від зіткнень вимкнено");
    }
    if (o->events & DRIVE_EVT_TOF_RESTORED) {
        ESP_LOGI(TAG, "знімок далекомірів знову оновлюється — захист від зіткнень відновлено");
    }
    if (o->events & DRIVE_EVT_TOF_CONTROL_OFF) {
        ESP_LOGW(TAG, "контроль перешкод вимкнено (CH9): сектори не зупиняють ровер");
    }
    if (o->events & DRIVE_EVT_TOF_CONTROL_ON) {
        ESP_LOGI(TAG, "контроль перешкод ввімкнено (CH9)");
    }
    if (o->events & DRIVE_EVT_PROTECTION_LOST) {
        ESP_LOGW(TAG, "захист від зіткнень не діє: жоден далекомір не охороняє");
    }
    if (o->events & DRIVE_EVT_PROTECTION_RESTORED) {
        ESP_LOGI(TAG, "захист відновлено");
    }
    if (o->events & DRIVE_EVT_ENC_RESTORED) {
        ESP_LOGI(TAG, "вимірювання швидкості коліс відновилось — регулятор бортів з нуля");
    }
}

// Знімок енкодерів для регулятора (ADR-0001 фази 5): швидкість коліс в об/хв, доступність, лічильник і мітка інтервалу.
// Задача encoders, що не стартувала, дає лічильник 0 — drive_core трактує це як застарілий знімок (spec AC-12b).
static void enc_input(drive_enc_in_t *e)
{
    enc_state_t st;
    encoders_state_get(&st);
    e->valid = true;
    for (int i = 0; i < ENC_WHEELS; i++) {
        e->avail[i] = st.w[i].available;
        e->rpm[i] = (float)enc_core_rpm(st.w[i].speed_pps);
    }
    e->intervals = st.intervals;
    e->t_us = st.last_us;
}

static void control_task(void *arg)
{
    (void)arg;
    esp_err_t err = esp_task_wdt_add(NULL);
    if (err != ESP_OK) {
        // Без Task WDT зависання control лишило б мотори без захисту (ADR-0004): консоль не приймає запитів (s_running),
        // а крок керування з outputs_inhibited не озброює з пульта й тримає виходи вимкненими (review F1).
        ESP_LOGE(TAG, "esp_task_wdt_add: %s — моторів не запущено, озброєння з консолі й пульта недоступне", esp_err_to_name(err));
    } else {
        s_running = true;
    }
    drive_ctl_t ctl;
    drive_ctl_init(&ctl);
    drive_lat_t lat;            // затримка «кадр → борти» для NFR ≤ 50 мс (spec §6; review F5)
    drive_lat_reset(&lat);
    uint32_t lat_seq = 0;
    uint32_t lat_start_ms = now_ms();
    TickType_t last = xTaskGetTickCount();
    for (;;) {
        int64_t step_t0_us = esp_timer_get_time();   // початок кроку після пробудження (phase7-telemetry, ADR-0003)
        queued_req_t item;
        drive_ctl_in_t in = {0};
        bool have_req = false;
        uint32_t seq = 0;
        bool got = xQueueReceive(s_queue, &item, 0) == pdTRUE;
        in.state = app_state_get();
        in.failsafe_cause = app_state_failsafe_cause();
        in.outputs_inhibited = !s_running;
        battery_get_snapshot(&in.battery);
        crsf_snapshot_get(&in.rc);   // без приймача знімок порожній: стендовий режим (ADR-0001)
        tof_snapshot_get(&in.tof);    // далекоміри (phase6-tof, ADR-0001): валідність і вік перевіряє drive_ctl_step
        in.tof_control_on = crsf_tof_control_effective(&in.rc, ctl.link_alive);   // CH9 (phase8, ADR-0005): без кадру й зв'язку — увімкнено
        enc_input(&in.enc);           // регулятор (phase5-pid, ADR-0001): швидкість коліс зі знімка encoders
        pid_hal_get(&in.pid, &in.pid_saving);
        uint32_t now = now_ms();  // час беремо ПІСЛЯ зчитування черги й знімка: вік не стає відʼємним
        in.now_ms = now;
        if (got && (int32_t)(now - item.t_ms) <= REQUEST_MAX_AGE_MS) {
            in.req = item.req;
            have_req = true;
            seq = item.seq;
        }

        drive_ctl_out_t out;
        drive_ctl_step(&ctl, &in, &out);

        apply_outputs(&out.out);  // спершу виходи (ADR-0002)
        pid_hal_publish_view(out.pid_view);   // показ `pid` і кадр трасування (ADR-0003): друкує задача pid_trace
        if (out.trace_ready) {
            pid_hal_publish_trace(&out.trace);
        }
        uint32_t applied_ms = now_ms();
        // Новий кадр, що керує бортами з пульта (ARMED, без запиту переходу): мітка кадру від crsf_rx → мітка запису.
        if (app_state_is_driving(in.state) && ctl.remote_active && ctl.link_alive && !out.has_state_request &&
            in.rc.have_frame && in.rc.seq != lat_seq) {
            drive_lat_add(&lat, in.rc.t_ms, applied_ms);
        }
        lat_seq = in.rc.seq;
        if ((uint32_t)(applied_ms - lat_start_ms) >= LAT_LOG_PERIOD_MS) {
            if (lat.n > 0) {
                char line[160];
                drive_lat_fmt(&lat, line, sizeof(line));
                ESP_LOGI(TAG, "%s", line);
            }
            drive_lat_reset(&lat);
            lat_start_ms = applied_ms;
        }
        bool transition_ok = true;
        if (out.has_state_request) {
            if (out.state_request == APP_STATE_FAILSAFE) {
                // Вхід у FAILSAFE завжди з причиною; повторне повідомлення «напруга» підвищує причину (ADR-0002).
                transition_ok = app_state_enter_failsafe(out.failsafe_cause) == APP_SM_OK;
            } else if (out.state_request == APP_STATE_ARMED && in.state == APP_STATE_OBSTACLE_HOLD) {
                // Повернення з утримання — не озброєння: pid_hal_arm_begin і фіксація режиму регулятора не потрібні (ADR-0004).
                transition_ok = app_state_request(out.state_request) == APP_SM_OK;
            } else if (out.state_request == APP_STATE_ARMED) {
                // Дозвіл на ARMED береться атомарно проти запису набору і зміни режиму (spec AC-15, рев'ю F1, R1):
                // ознака «триває збереження» на початку такту могла застаріти, поки такт ішов.
                pid_busy_t busy;
                if (pid_hal_arm_begin(&busy)) {
                    transition_ok = app_state_request(out.state_request) == APP_SM_OK;
                    pid_hal_arm_end();
                    if (transition_ok && (!in.tof.valid || !in.tof.protection)) {   // озброєно без захисту: одне попередження на озброєння
                        ESP_LOGW(TAG, "озброєно без захисту від зіткнень: %s", in.tof.valid ? "жоден далекомір не працює"
                                                                                          : "далекоміри ще не готові");
                    }
                } else {
                    transition_ok = false;
                    drive_arm_refused(&out, have_req, busy);   // рішення й причина — у drive_core (рев'ю S1)
                }
            } else {
                transition_ok = app_state_request(out.state_request) == APP_SM_OK;
            }
        }

        // Знімок стану керування з пульта для status: тяга, поворот, тумблер, що блокує озброєння, вихід з FAILSAFE.
        crsf_intent_t intent;
        crsf_intent(&in.rc, &intent);
        drive_block_t blk = drive_arm_block(&ctl, in.state, &in.battery, &intent, now);
        drive_fsx_t fsx = drive_failsafe_exit_state(&ctl, in.failsafe_cause, &intent, now);

        portENTER_CRITICAL(&s_lock);
        s_status.stby = out.out.stby;
        s_status.left_permille = out.left_permille;
        s_status.right_permille = out.right_permille;
        s_status.remaining_ms = out.remaining_ms;
        s_status.remote_active = ctl.remote_active;
        s_status.link_alive = ctl.link_alive;
        s_status.since_last_ms = in.rc.have_frame ? (uint32_t)(now - in.rc.t_ms) : 0;
        s_status.intent = intent;
        s_status.sw_shown = drive_switch_shown(&ctl);
        s_status.arm_block = blk;
        s_status.failsafe_cause = in.failsafe_cause;
        s_status.fsx = fsx;
        s_status.occ_front = ctl.occ_front;
        s_status.occ_rear = ctl.occ_rear;
        s_status.tof_control_on = out.tof_control_on;
        s_status.tof_guarding = out.tof_guarding;
        s_status.tof_control_default = !(in.rc.have_frame && ctl.link_alive);
        if (out.stop != DRIVE_STOP_NONE && !(out.stop == DRIVE_STOP_DISARM && !app_state_is_driving(in.state))) {
            s_status.last_stop = out.stop;  // зупинка справжня: запам'ятати для status (AC-12)
            s_status.last_stop_min_mv = out.min_mv;
            s_status.last_stop_t_ms = now;
        }
        portEXIT_CRITICAL(&s_lock);

        if (have_req) {
            bool accepted = out.accepted && transition_ok;
            s_reply = (drive_reply_t){.accepted = accepted,
                                      .reason = (out.accepted && !transition_ok) ? DRIVE_REASON_TRANSITION_REFUSED : out.reason,
                                      .state_before = in.state,
                                      .has_state_request = out.has_state_request,
                                      .state_request = out.state_request,
                                      .stop = out.stop,
                                      .mv = out.mv,
                                      .left_permille = out.left_permille,
                                      .right_permille = out.right_permille,
                                      .failsafe_cause = in.failsafe_cause,
                                      .fsx = fsx,
                                      .switch_arm = intent.sw == CRSF_SW_ARM,
                                      .tof_clamped = out.accepted && out.tof_clamped};
            s_reply_seq = seq;
            xSemaphoreGive(s_reply_sem);
        }
        log_stop(&out, &in, now);  // лог — після вимкнення виходів і запиту стану
        log_events(&out, &in, now, ctl.occ_front, ctl.occ_rear);

        // Статистика сесії (phase8, ADR-0001): наприкінці кроку, без блокувань; стан — той, який бачив цей крок.
        {
            session_hal_in_t sin = {
                .now_ms = now,
                .state = in.state,
                .failsafe_cause = in.failsafe_cause,
                .battery = in.battery,
                .tof_control_on = out.tof_control_on,
                .hold_enter = (out.events & DRIVE_EVT_HOLD_ENTER) != 0,
                .hold_mm = out.hold_mm,
                .hold_nearest = out.hold_nearest,
                .left_permille = out.left_permille,
                .right_permille = out.right_permille,
                .cmd_left = out.pid_view[0].mix,
                .cmd_right = out.pid_view[1].mix,
            };
            if (sin.hold_enter) {
                sin.hold_below_mask = (uint8_t)((ctl.occ_front ? tof_below_mask(&in.tof, TOF_SECTOR_FRONT) : 0u) |
                                                (ctl.occ_rear ? tof_below_mask(&in.tof, TOF_SECTOR_REAR) : 0u));
            }
            enc_state_t enc_snap;
            encoders_state_get(&enc_snap);
            session_hal_step(&sin, &enc_snap);
        }

        int64_t step_us = esp_timer_get_time() - step_t0_us;   // тривалість кроку без очікування наступного періоду
        telemetry_step_record(step_us > 0 ? (uint32_t)step_us : 0u, CONTROL_PERIOD_MS * 1000u);
        esp_task_wdt_reset();
        vTaskDelayUntil(&last, pdMS_TO_TICKS(CONTROL_PERIOD_MS));
    }
}

esp_err_t drive_start(void)
{
    if (!s_init_ok) {
        ESP_LOGE(TAG, "drive_hal_init не пройшла — control не стартує, моторів не запущено");
        return ESP_ERR_INVALID_STATE;
    }
    s_queue = xQueueCreate(QUEUE_LEN, sizeof(queued_req_t));
    s_submit_lock = xSemaphoreCreateMutex();
    s_reply_sem = xSemaphoreCreateBinary();
    if (s_queue == NULL || s_submit_lock == NULL || s_reply_sem == NULL) {
        return ESP_ERR_NO_MEM;
    }
    if (xTaskCreatePinnedToCore(control_task, "control", CONTROL_STACK, NULL, CONTROL_PRIORITY, NULL,
                                CONTROL_CORE) != pdPASS) {
        ESP_LOGE(TAG, "не вдалося створити задачу control");
        return ESP_ERR_NO_MEM;
    }
    return ESP_OK;  // s_running виставляє сама задача після підписки на Task WDT
}
