12romis/esp32-elrs-rover/components/rover_console/console_core.c

// Логіка консолі: збирання рядка, розбір команд, права за станом.
// Без заголовків ESP-IDF і FreeRTOS; дії виконує console_hal.
#include <stdio.h>
#include <stdarg.h>
#include <string.h>

#include "console_core.h"

void console_init(console_t *c)
{
    memset(c, 0, sizeof(*c));
}

console_event_t console_feed(console_t *c, char ch)
{
    if (c->line_ready) {  // попередній рядок уже забрано
        c->len = 0;
        c->buf[0] = '\0';
        c->overflowed = false;
        c->line_ready = false;
    }

    bool after_cr = c->last_was_cr;
    c->last_was_cr = (ch == '\r');
    if (ch == '\n' && after_cr) {  // другий символ пари CR LF
        return CONSOLE_EVENT_NONE;
    }

    if (ch == '\r' || ch == '\n') {
        c->line_ready = true;
        if (c->overflowed) {
            c->len = 0;
            c->buf[0] = '\0';
            return CONSOLE_EVENT_OVERFLOW;
        }
        return CONSOLE_EVENT_LINE;
    }
    if (ch == 0x08 || ch == 0x7F) {  // BS, DEL
        if (!c->overflowed && c->len > 0) {
            c->len--;
            c->buf[c->len] = '\0';
        }
        return CONSOLE_EVENT_NONE;
    }
    if (ch != '\t' && (unsigned char)ch < 0x20) {  // інші керівні символи ігноруємо
        return CONSOLE_EVENT_NONE;
    }
    if (c->overflowed) {
        return CONSOLE_EVENT_NONE;
    }
    if (c->len >= CONSOLE_LINE_MAX) {
        c->overflowed = true;  // рядок відкидається повністю, до кінця рядка
        return CONSOLE_EVENT_NONE;
    }
    c->buf[c->len++] = ch;
    c->buf[c->len] = '\0';
    return CONSOLE_EVENT_NONE;
}

const char *console_line(const console_t *c)
{
    return c->buf;
}

static bool is_space(char ch)
{
    return ch == ' ' || ch == '\t';
}

// Розбирає перше слово: повертає команду, а в *rest — початок решти рядка (після пробілів).
static console_cmd_t first_word(const char *line, const char **rest)
{
    const char *p = line;
    while (is_space(*p)) p++;
    if (*p == '\0') {
        *rest = p;
        return CONSOLE_CMD_EMPTY;
    }
    const char *start = p;
    while (*p != '\0' && !is_space(*p)) p++;
    size_t n = (size_t)(p - start);
    while (is_space(*p)) p++;
    *rest = p;

    if (n == 4 && strncmp(start, "help", n) == 0) return CONSOLE_CMD_HELP;
    if (n == 6 && strncmp(start, "status", n) == 0) return CONSOLE_CMD_STATUS;
    if (n == 6 && strncmp(start, "reboot", n) == 0) return CONSOLE_CMD_REBOOT;
    if (n == 8 && strncmp(start, "wdt-test", n) == 0) return CONSOLE_CMD_WDT_TEST;
    if (n == 3 && strncmp(start, "arm", n) == 0) return CONSOLE_CMD_ARM;
    if (n == 6 && strncmp(start, "disarm", n) == 0) return CONSOLE_CMD_DISARM;
    if (n == 5 && strncmp(start, "drive", n) == 0) return CONSOLE_CMD_DRIVE;
    if (n == 5 && strncmp(start, "light", n) == 0) return CONSOLE_CMD_LIGHT;
    if (n == 4 && strncmp(start, "beep", n) == 0) return CONSOLE_CMD_BEEP;
    if (n == 3 && strncmp(start, "enc", n) == 0) return CONSOLE_CMD_ENC;
    if (n == 3 && strncmp(start, "pid", n) == 0) return CONSOLE_CMD_PID;
    if (n == 3 && strncmp(start, "tof", n) == 0) return CONSOLE_CMD_TOF;
    if (n == 6 && strncmp(start, "report", n) == 0) return CONSOLE_CMD_REPORT;
    return CONSOLE_CMD_UNKNOWN;
}

console_cmd_t console_identify(const char *line)
{
    const char *rest;
    return first_word(line, &rest);
}

console_cmd_t console_parse(const char *line, app_state_t state)
{
    const char *rest;
    console_cmd_t cmd = first_word(line, &rest);
    if (cmd == CONSOLE_CMD_EMPTY || cmd == CONSOLE_CMD_UNKNOWN) {
        return cmd;
    }
    bool has_args = (*rest != '\0');

    if (cmd == CONSOLE_CMD_DRIVE) {  // аргументи перевіряються раніше за право за станом
        float t, s;
        if (console_parse_drive(line, &t, &s) != CONSOLE_DRIVE_OK) {
            return CONSOLE_CMD_BAD_ARGS;
        }
        return app_state_is_driving(state) ? CONSOLE_CMD_DRIVE : CONSOLE_CMD_DENIED_STATE;   // ARMED і OBSTACLE_HOLD
    }
    if (cmd == CONSOLE_CMD_LIGHT || cmd == CONSOLE_CMD_BEEP) {
        // порядок перевірок: спершу стан (клітинка «ні» завжди відмовляє за станом), потім синтаксис і діапазон
        if (!ui_core_state_allows(state)) {
            return CONSOLE_CMD_DENIED_STATE;
        }
        ui_channel_t ch;
        bool on;
        uint32_t hz, dur;
        console_ui_result_t r = cmd == CONSOLE_CMD_LIGHT ? console_parse_light(line, &ch, &on)
                                                          : console_parse_beep(line, &hz, &dur);
        return r == CONSOLE_UI_OK ? cmd : CONSOLE_CMD_BAD_ARGS;
    }
    if (cmd == CONSOLE_CMD_ENC) {
        // Дозволена в усіх станах (моторами не керує); форми лише «enc» і «enc reset» (contracts/cli.md).
        switch (console_parse_enc(line)) {
        case CONSOLE_ENC_SNAPSHOT: return CONSOLE_CMD_ENC;
        case CONSOLE_ENC_RESET:    return CONSOLE_CMD_ENC_RESET;
        default:                   return CONSOLE_CMD_BAD_ARGS;
        }
    }
    if (cmd == CONSOLE_CMD_TOF) {
        // Хибна форма відмовляє раніше за стан (spec AC-11: у будь-якому стані); далі матриця дозволів (AC-09).
        console_tof_t p = console_parse_tof(line);
        if (p.form >= CONSOLE_TOF_ERR_WORD) return CONSOLE_CMD_BAD_ARGS;
        if (!console_tof_allowed(p.form, state)) return CONSOLE_CMD_DENIED_STATE;
        return p.form == CONSOLE_TOF_REINIT ? CONSOLE_CMD_TOF_REINIT : CONSOLE_CMD_TOF;
    }
    if (cmd == CONSOLE_CMD_PID) {
        // Хибна форма відмовляє раніше за стан (spec AC-04: у будь-якому стані); далі матриця дозволів.
        console_pid_t p = console_parse_pid(line);
        if (p.form >= CONSOLE_PID_ERR_WORD) return CONSOLE_CMD_BAD_ARGS;
        if (!console_pid_allowed(p.form, state)) return CONSOLE_CMD_DENIED_STATE;
        switch (p.form) {
        case CONSOLE_PID_SET:       return CONSOLE_CMD_PID_SET;
        case CONSOLE_PID_ON:
        case CONSOLE_PID_OFF:       return CONSOLE_CMD_PID_MODE;
        case CONSOLE_PID_SAVE:      return CONSOLE_CMD_PID_SAVE;
        case CONSOLE_PID_TRACE_ON:
        case CONSOLE_PID_TRACE_OFF: return CONSOLE_CMD_PID_TRACE;
        default:                    return CONSOLE_CMD_PID;
        }
    }
    if (has_args) {
        return CONSOLE_CMD_EXTRA_ARGS;
    }
    if (cmd == CONSOLE_CMD_REBOOT && state != APP_STATE_DISARMED && state != APP_STATE_BOOT) {
        return CONSOLE_CMD_DENIED_STATE;
    }
    if (cmd == CONSOLE_CMD_WDT_TEST && state != APP_STATE_DISARMED) {
        return CONSOLE_CMD_DENIED_STATE;
    }
    if (cmd == CONSOLE_CMD_ARM && state != APP_STATE_DISARMED) {
        return CONSOLE_CMD_DENIED_STATE;
    }
    return cmd;  // disarm дозволена в усіх станах
}

const char *console_help_text(void)
{
    return "Доступні команди:\n"
           "  help      — ця довідка\n"
           "  status    — стан, час роботи, вільна памʼять, причина скидання, сховище, історія переходів\n"
           "  reboot    — перезавантажити плату (лише в станах DISARMED і BOOT)\n"
           "  wdt-test  — перевірка сторожового таймера: навмисне зависання (лише в стані DISARMED)\n"
           "  arm       — озброїти ровер (лише в стані DISARMED за напруги не нижче порога; лише в стендовому режимі, до появи пульта)\n"
           "  disarm    — вимкнути мотори й роззброїти (у будь-якому стані)\n"
           "  drive <тяга> <поворот> — рух, значення від -1 до 1, діє 2 с (лише в станах ARMED і OBSTACLE_HOLD і в стендовому режимі, до появи пульта)\n"
           "  light <head|red|green> <on|off> — світло: фари, червоний чи зелений задній ліхтар (DISARMED; в ARMED лише head)\n"
           "  beep <Гц> <мс> — сигнал зумера, цілі числа: 200–5000 Гц і 1–2000 мс (DISARMED і ARMED)\n"
           "  enc [reset] — знімок енкодерів коліс; reset обнуляє лічильники й відстань (у будь-якому стані)\n"
           "  pid [kp|ki|kd|ramp <число> | on | off | save | trace on|off] — регулятор швидкості бортів: стан, "
           "зміна числа, увімкнення (DISARMED), збереження (не під час руху), трасування\n"
           "  tof [reinit] — далекоміри: стан, відстані, сектори, поріг (у будь-якому стані); reinit повертає відмовивші далекоміри в роботу (лише DISARMED)\n"
           "  report    — звіти сесій: черга, режим контролю перешкод, мережа; у DISARMED запускає передачу негайно";
}

const char *console_msg_unknown(void)
{
    return "Невідома команда. Наберіть help, щоб побачити список команд.";
}

const char *console_msg_extra_args(void)
{
    return "Команда не приймає аргументів. Наберіть help, щоб побачити список команд.";
}

const char *console_msg_overflow(void)
{
    return "Рядок задовгий (максимум 64 символи) — відкинуто повністю, нічого не виконано.";
}

#define ENC_USAGE " Допустимо: «enc» — знімок енкодерів, «enc reset» — обнулити лічильники й відстань."

const char *console_msg_enc_error(console_enc_result_t r)
{
    switch (r) {
    case CONSOLE_ENC_UNKNOWN_WORD:
        return "Команда enc: невідоме друге слово." ENC_USAGE;
    case CONSOLE_ENC_RESET_TYPO:
        return "Команда enc: друге слово схоже на reset, але записане інакше — має бути саме reset малими літерами (регістр має значення)." ENC_USAGE;
    case CONSOLE_ENC_EXTRA_WORD:
        return "Команда enc: зайве третє слово — після enc можна лише одне слово reset." ENC_USAGE;
    case CONSOLE_ENC_SNAPSHOT:
    case CONSOLE_ENC_RESET:
        break;
    }
    return "Хибна форма команди enc." ENC_USAGE;
}

const char *console_msg_denied(console_cmd_t cmd)
{
    if (cmd == CONSOLE_CMD_REBOOT) {
        return "Команда reboot дозволена лише в станах DISARMED і BOOT.";
    }
    if (cmd == CONSOLE_CMD_WDT_TEST) {
        return "Команда wdt-test дозволена лише в стані DISARMED.";
    }
    return "Команду відхилено.";
}

// ---------- Команди руху ----------

// Розбирає один токен за граматикою [+-]цифри[.цифри]; повертає false, якщо граматика порушена.
static bool parse_number(const char *tok, size_t n, double *out)
{
    size_t i = 0;
    bool neg = false;
    if (i < n && (tok[i] == '+' || tok[i] == '-')) {
        neg = tok[i] == '-';
        i++;
    }
    size_t int_start = i;
    double v = 0.0;
    while (i < n && tok[i] >= '0' && tok[i] <= '9') {
        v = v * 10.0 + (tok[i] - '0');
        i++;
    }
    if (i == int_start) {
        return false;
    }
    if (i < n && tok[i] == '.') {
        i++;
        size_t frac_start = i;
        double scale = 0.1;
        while (i < n && tok[i] >= '0' && tok[i] <= '9') {
            v += (tok[i] - '0') * scale;
            scale /= 10.0;
            i++;
        }
        if (i == frac_start) {
            return false;
        }
    }
    if (i != n) {
        return false;
    }
    *out = neg ? -v : v;
    return true;
}

console_drive_result_t console_parse_drive(const char *line, float *throttle, float *steer)
{
    const char *p = line;
    while (is_space(*p)) p++;
    while (*p != '\0' && !is_space(*p)) p++;  // слово drive

    const char *tok[3];
    size_t len[3];
    int count = 0;
    for (;;) {
        while (is_space(*p)) p++;
        if (*p == '\0') {
            break;
        }
        const char *start = p;
        while (*p != '\0' && !is_space(*p)) p++;
        if (count < 3) {
            tok[count] = start;
            len[count] = (size_t)(p - start);
        }
        count++;
    }
    if (count < 2) {
        return CONSOLE_DRIVE_MISSING_ARGS;
    }
    if (count > 2) {
        return CONSOLE_DRIVE_EXTRA_ARGS;
    }
    double a, b;
    if (!parse_number(tok[0], len[0], &a) || !parse_number(tok[1], len[1], &b)) {
        return CONSOLE_DRIVE_BAD_NUMBER;
    }
    if (a < -1.0 || a > 1.0 || b < -1.0 || b > 1.0) {
        return CONSOLE_DRIVE_RANGE;
    }
    *throttle = (float)a;
    *steer = (float)b;
    return CONSOLE_DRIVE_OK;
}

const char *console_msg_drive_error(console_drive_result_t r)
{
    switch (r) {
    case CONSOLE_DRIVE_MISSING_ARGS:
        return "Команда drive потребує двох чисел: drive <тяга> <поворот>.";
    case CONSOLE_DRIVE_EXTRA_ARGS:
        return "Забагато аргументів: drive приймає рівно два числа — тягу й поворот.";
    case CONSOLE_DRIVE_BAD_NUMBER:
        return "Значення має бути десятковим числом (наприклад 0.3 або -1); експонента, nan, inf, кома та зайві символи не приймаються.";
    case CONSOLE_DRIVE_RANGE:
        return "Значення мають бути в діапазоні від −1 до +1 (межі входять); команду відхилено.";
    case CONSOLE_DRIVE_OK:
        break;
    }
    return "Команду drive відхилено.";
}

// Підказка про вихід із FAILSAFE за причиною (contracts/cli.md, клас 1; spec AC-08, AC-09). Поза FAILSAFE — порожньо.
static const char *failsafe_hint(app_state_t state, app_failsafe_cause_t cause)
{
    if (state != APP_STATE_FAILSAFE) {
        return "";
    }
    if (cause == APP_FS_LINK_LOST) {
        return " Вихід із FAILSAFE: пультом (звʼязок 1 с без втрат, тумблер у DISARM) або апаратним скиданням плати.";
    }
    return " Вихід із FAILSAFE можливий лише апаратним скиданням плати або перемиканням живлення.";
}

void console_fmt_denied(char *buf, size_t n, console_cmd_t cmd, app_state_t state, app_failsafe_cause_t cause)
{
    const char *rule;
    switch (cmd) {
    case CONSOLE_CMD_ARM:      rule = "Команда arm дозволена лише в стані DISARMED"; break;
    case CONSOLE_CMD_DRIVE:    rule = "Команда drive дозволена лише в станах ARMED і OBSTACLE_HOLD"; break;
    case CONSOLE_CMD_REBOOT:   rule = "Команда reboot дозволена лише в станах DISARMED і BOOT"; break;
    case CONSOLE_CMD_WDT_TEST: rule = "Команда wdt-test дозволена лише в стані DISARMED"; break;
    case CONSOLE_CMD_LIGHT:    rule = "Команда light дозволена лише в станах DISARMED і ARMED"; break;
    case CONSOLE_CMD_BEEP:     rule = "Команда beep дозволена лише в станах DISARMED і ARMED"; break;
    default:                   rule = "Команду відхилено"; break;
    }
    snprintf(buf, n, "%s, поточний стан: %s.%s", rule, app_state_name(state), failsafe_hint(state, cause));
}

const char *console_msg_arm_ok(void)
{
    return "Ровер озброєно, джерело керування: стенд. Рух — командою drive <тяга> <поворот>.";
}

void console_fmt_permille(char *buf, size_t n, int16_t permille)
{
    int v = permille < 0 ? -(int)permille : (int)permille;
    int hundredths = (v + 5) / 10;
    snprintf(buf, n, "%s%d.%02d", (permille < 0 && hundredths != 0) ? "-" : "", hundredths / 100, hundredths % 100);
}

void console_fmt_motor_status(char *buf, size_t n, uint32_t mv, bool mv_valid, int stby, int16_t left_pm,
                              int16_t right_pm, uint32_t remaining_ms)
{
    char l[16], r[16], v[48];
    console_fmt_permille(l, sizeof l, left_pm);
    console_fmt_permille(r, sizeof r, right_pm);
    if (mv_valid) {
        snprintf(v, sizeof v, "%u мВ", (unsigned)mv);
    } else {
        snprintf(v, sizeof v, "немає вимірювання");
    }
    snprintf(buf, n, "напруга: %s; STBY: %d; ліве: %s; праве: %s; залишок команди: %u мс", v, stby, l, r,
             (unsigned)remaining_ms);
}

void console_fmt_last_stop(char *buf, size_t n, const char *reason, uint32_t min_mv, uint32_t t_ms)
{
    if (reason == NULL) {
        snprintf(buf, n, "остання зупинка: немає");
        return;
    }
    char v[32];
    if (min_mv == 0) {
        snprintf(v, sizeof v, "немає даних");
    } else {
        snprintf(v, sizeof v, "%u мВ", (unsigned)min_mv);
    }
    snprintf(buf, n, "остання зупинка: %s; мінімальна напруга: %s; час: %u мс від старту", reason, v, (unsigned)t_ms);
}


// ---------- Команди світла й зумера ----------

// Розбиває решту рядка після першого слова на токени (до max); повертає кількість слів, яка могла перевищити max.
static int split_args(const char *line, const char **tok, size_t *len, int max)
{
    const char *p = line;
    while (is_space(*p)) p++;
    while (*p != '\0' && !is_space(*p)) p++;  // назва команди
    int count = 0;
    for (;;) {
        while (is_space(*p)) p++;
        if (*p == '\0') {
            break;
        }
        const char *start = p;
        while (*p != '\0' && !is_space(*p)) p++;
        if (count < max) {
            tok[count] = start;
            len[count] = (size_t)(p - start);
        }
        count++;
    }
    return count;
}

static bool tok_is(const char *t, size_t n, const char *word)
{
    return strlen(word) == n && strncmp(t, word, n) == 0;
}

console_ui_result_t console_parse_light(const char *line, ui_channel_t *ch, bool *on)
{
    const char *tok[3];
    size_t len[3];
    int n = split_args(line, tok, len, 3);
    if (n < 2) {
        return CONSOLE_UI_MISSING_ARGS;
    }
    if (n > 2) {
        return CONSOLE_UI_EXTRA_ARGS;
    }
    ui_channel_t c;
    if (tok_is(tok[0], len[0], "head")) {
        c = UI_CH_HEAD;
    } else if (tok_is(tok[0], len[0], "red")) {
        c = UI_CH_RED;
    } else if (tok_is(tok[0], len[0], "green")) {
        c = UI_CH_GREEN;
    } else {
        return CONSOLE_UI_UNKNOWN_CHANNEL;
    }
    bool v;
    if (tok_is(tok[1], len[1], "on")) {
        v = true;
    } else if (tok_is(tok[1], len[1], "off")) {
        v = false;
    } else {
        return CONSOLE_UI_UNKNOWN_ACTION;
    }
    *ch = c;
    *on = v;
    return CONSOLE_UI_OK;
}

// Лише десяткові цифри. Значення насичується на 1000000, щоб довгий ввід не переповнив і читався як «поза діапазоном».
static bool parse_digits(const char *t, size_t n, uint32_t *out)
{
    if (n == 0) {
        return false;
    }
    uint32_t v = 0;
    for (size_t i = 0; i < n; i++) {
        if (t[i] < '0' || t[i] > '9') {
            return false;
        }
        v = v * 10u + (uint32_t)(t[i] - '0');
        if (v > 1000000u) {
            v = 1000000u;
        }
    }
    *out = v;
    return true;
}

// Слово схоже на reset: той самий текст без урахування регістру, або одне з двох — початок іншого (щонайменше 3 літери).
static bool like_reset(const char *t, size_t n)
{
    static const char word[] = "reset";
    size_t common = n < 5 ? n : 5;
    if (common < 3) {
        return false;
    }
    for (size_t i = 0; i < common; i++) {
        char c = t[i];
        if (c >= 'A' && c <= 'Z') c = (char)(c - 'A' + 'a');
        if (c != word[i]) {
            return false;
        }
    }
    return true;
}

console_enc_result_t console_parse_enc(const char *line)
{
    const char *tok[1];
    size_t len[1];
    int n = split_args(line, tok, len, 1);
    if (n == 0) {
        return CONSOLE_ENC_SNAPSHOT;
    }
    if (n > 1) {
        return CONSOLE_ENC_EXTRA_WORD;
    }
    if (tok_is(tok[0], len[0], "reset")) {
        return CONSOLE_ENC_RESET;
    }
    return like_reset(tok[0], len[0]) ? CONSOLE_ENC_RESET_TYPO : CONSOLE_ENC_UNKNOWN_WORD;
}

console_ui_result_t console_parse_beep(const char *line, uint32_t *hz, uint32_t *dur_ms)
{
    const char *tok[3];
    size_t len[3];
    int n = split_args(line, tok, len, 3);
    if (n < 2) {
        return CONSOLE_UI_MISSING_ARGS;
    }
    if (n > 2) {
        return CONSOLE_UI_EXTRA_ARGS;
    }
    uint32_t a, b;
    if (!parse_digits(tok[0], len[0], &a) || !parse_digits(tok[1], len[1], &b)) {
        return CONSOLE_UI_NOT_INTEGER;  // формат важливіший за діапазон
    }
    if (a < UI_BEEP_FREQ_MIN_HZ || a > UI_BEEP_FREQ_MAX_HZ || b < UI_BEEP_DUR_MIN_MS || b > UI_BEEP_DUR_MAX_MS) {
        return CONSOLE_UI_RANGE;
    }
    *hz = a;
    *dur_ms = b;
    return CONSOLE_UI_OK;
}

#define LIGHT_USAGE " Формат: light <канал> <дія>; канали: head (фари), red і green (задні ліхтарі); дії: on, off. Команду відхилено, світло не змінилось."

const char *console_msg_light_error(console_ui_result_t r)
{
    switch (r) {
    case CONSOLE_UI_MISSING_ARGS:
        return "Команді light бракує аргументів: потрібні канал і дія." LIGHT_USAGE;
    case CONSOLE_UI_EXTRA_ARGS:
        return "У команді light зайві аргументи: потрібні лише канал і дія." LIGHT_USAGE;
    case CONSOLE_UI_UNKNOWN_CHANNEL:
        return "Невідомий канал (регістр має значення)." LIGHT_USAGE;
    case CONSOLE_UI_UNKNOWN_ACTION:
        return "Невідома дія (регістр має значення)." LIGHT_USAGE;
    case CONSOLE_UI_NOT_INTEGER:
    case CONSOLE_UI_RANGE:
    case CONSOLE_UI_OK:
        break;
    }
    return "Команду light відхилено." LIGHT_USAGE;
}

const char *console_msg_beep_error(console_ui_result_t r)
{
    switch (r) {
    case CONSOLE_UI_NOT_INTEGER:
        return "Значення має бути цілим числом лише з цифр (без знака, дробу, експоненти, 0x і коми); команду відхилено, звучання не змінилось.";
    case CONSOLE_UI_RANGE:
        return "Частота має бути від 200 до 5000 Гц, тривалість — від 1 до 2000 мс (межі входять); команду відхилено, звучання не змінилось.";
    case CONSOLE_UI_MISSING_ARGS:
        return "Команді beep бракує аргументів: потрібні рівно два цілих числа, beep <частота_Гц> <тривалість_мс>; команду відхилено.";
    case CONSOLE_UI_EXTRA_ARGS:
        return "У команді beep зайві аргументи: потрібні рівно два цілих числа, beep <частота_Гц> <тривалість_мс>; команду відхилено.";
    case CONSOLE_UI_UNKNOWN_CHANNEL:
    case CONSOLE_UI_UNKNOWN_ACTION:
    case CONSOLE_UI_OK:
        break;
    }
    return "Команду beep відхилено: beep <частота_Гц> <тривалість_мс>.";
}

void console_fmt_ui_denied(char *buf, size_t n, ui_result_t r, app_state_t state, app_failsafe_cause_t cause)
{
    switch (r) {
    case UI_DENY_STATE:
        snprintf(buf, n, "Світло й зумер дозволені лише в станах DISARMED і ARMED, поточний стан: %s.%s",
                 app_state_name(state), failsafe_hint(state, cause));
        break;
    case UI_DENY_MOTION:
        snprintf(buf, n, "У стані ARMED задні ліхтарі керуються рухом; вручну червоний і зелений можна вмикати лише в стані DISARMED.");
        break;
    case UI_DENY_EXPANDER:
        snprintf(buf, n, "Світло недоступне: розширювач не підтвердився на старті або шина не відповідає; після відновлення зʼєднання світло працює знову, а недоступний на старті розширювач потребує перезапуску плати.");
        break;
    case UI_DENY_RANGE:
        snprintf(buf, n, "Частота має бути від %d до %d Гц, тривалість — від %d до %d мс (межі входять).", UI_BEEP_FREQ_MIN_HZ,
                 UI_BEEP_FREQ_MAX_HZ, UI_BEEP_DUR_MIN_MS, UI_BEEP_DUR_MAX_MS);
        break;
    case UI_OK:
        snprintf(buf, n, "Готово.");
        break;
    }
}

void console_fmt_ui_status(char *buf, size_t n, bool expander_ok, bool head, bool red, bool green, bool rear_auto,
                           ui_indicator_t indicator, bool buzzer_on, uint32_t remaining_ms)
{
    const char *colour = indicator == UI_IND_RED ? "червоний"
                       : (indicator == UI_IND_YELLOW ? "жовтий" : (indicator == UI_IND_GREEN ? "зелений" : "вимкнений"));
    snprintf(buf, n, "розширювач: %s; світло: head %s, red %s, green %s; задні ліхтарі: керує %s; індикатор плати: %s; зумер: %s, залишок: %u мс",
             expander_ok ? "доступний" : "недоступний", head ? "ввімкнено" : "вимкнено", red ? "ввімкнено" : "вимкнено",
             green ? "ввімкнено" : "вимкнено", rear_auto ? "рух" : "вручну", colour,
             buzzer_on ? "звучить" : "мовчить", (unsigned)remaining_ms);
}

// ---------- Команда регулятора pid (phase5-pid; spec AC-03, AC-04, AC-09, AC-15) ----------

static bool tok_eq(const char *tok, size_t len, const char *word)
{
    return strlen(word) == len && strncmp(tok, word, len) == 0;
}

// Назви, якими можна спробувати змінити межу потужності (spec AC-09: окрема відмова).
static bool is_limit_word(const char *tok, size_t len)
{
    return tok_eq(tok, len, "limit") || tok_eq(tok, len, "pwm") || tok_eq(tok, len, "max") || tok_eq(tok, len, "межа");
}

console_pid_t console_parse_pid(const char *line)
{
    console_pid_t r = {CONSOLE_PID_SHOW, PID_PARAM_KP, 0.0f, NULL};
    const char *p = line;
    while (is_space(*p)) p++;
    while (*p != '\0' && !is_space(*p)) p++;   // слово pid

    const char *tok[4];
    size_t len[4];
    int count = 0;
    for (;;) {
        while (is_space(*p)) p++;
        if (*p == '\0') break;
        const char *start = p;
        while (*p != '\0' && !is_space(*p)) p++;
        if (count < 4) {
            tok[count] = start;
            len[count] = (size_t)(p - start);
        }
        count++;
    }
    if (count == 0) return r;

    if (is_limit_word(tok[0], len[0])) {
        r.form = CONSOLE_PID_ERR_LIMIT;
        return r;
    }
    if (tok_eq(tok[0], len[0], "on") || tok_eq(tok[0], len[0], "off") || tok_eq(tok[0], len[0], "save")) {
        if (count > 1) {
            r.form = CONSOLE_PID_ERR_EXTRA;
        } else {
            r.form = tok_eq(tok[0], len[0], "on") ? CONSOLE_PID_ON
                   : tok_eq(tok[0], len[0], "off") ? CONSOLE_PID_OFF : CONSOLE_PID_SAVE;
        }
        return r;
    }
    if (tok_eq(tok[0], len[0], "trace")) {
        if (count < 2) {
            r.form = CONSOLE_PID_ERR_MISSING;
        } else if (count > 2) {
            r.form = CONSOLE_PID_ERR_EXTRA;
        } else if (tok_eq(tok[1], len[1], "on")) {
            r.form = CONSOLE_PID_TRACE_ON;
        } else if (tok_eq(tok[1], len[1], "off")) {
            r.form = CONSOLE_PID_TRACE_OFF;
        } else {
            r.form = CONSOLE_PID_ERR_WORD;
        }
        return r;
    }
    pid_param_t param;
    if (!pid_param_parse(tok[0], len[0], &param)) {
        r.form = CONSOLE_PID_ERR_WORD;
        return r;
    }
    r.param = param;
    if (count < 2) {
        r.form = CONSOLE_PID_ERR_MISSING;
        return r;
    }
    if (count > 2) {
        r.form = CONSOLE_PID_ERR_EXTRA;
        return r;
    }
    double v;
    if (!parse_number(tok[1], len[1], &v)) {
        r.form = CONSOLE_PID_ERR_NUMBER;
        return r;
    }
    const char *why = pid_value_check(param, (float)v);
    if (why) {
        r.form = CONSOLE_PID_ERR_VALUE;
        r.why = why;
        return r;
    }
    r.form = CONSOLE_PID_SET;
    r.value = (float)v;
    return r;
}

console_tof_t console_parse_tof(const char *line)
{
    console_tof_t r = {CONSOLE_TOF_SHOW};
    const char *rest;
    first_word(line, &rest);
    if (*rest == '\0') {
        return r;
    }
    const char *p = rest;
    while (*p != '\0' && !is_space(*p)) p++;
    size_t n = (size_t)(p - rest);
    while (is_space(*p)) p++;
    bool more = (*p != '\0');
    if (n == 6 && strncmp(rest, "reinit", n) == 0) {
        r.form = more ? CONSOLE_TOF_ERR_EXTRA : CONSOLE_TOF_REINIT;
        return r;
    }
    static const char *const thr_words[] = {"thr", "threshold", "limit", "mm", "set", "поріг"};
    char c = rest[0];
    bool thr = (c >= '0' && c <= '9') || c == '+' || c == '-' || c == '.';
    for (size_t i = 0; i < sizeof(thr_words) / sizeof(thr_words[0]) && !thr; i++) {
        thr = strlen(thr_words[i]) == n && strncmp(rest, thr_words[i], n) == 0;
    }
    r.form = thr ? CONSOLE_TOF_ERR_THRESHOLD : CONSOLE_TOF_ERR_WORD;
    return r;
}

bool console_tof_allowed(console_tof_form_t form, app_state_t state)
{
    return form != CONSOLE_TOF_REINIT || state == APP_STATE_DISARMED;
}

#define TOF_USAGE " Допустимо: «tof» — показ далекомірів і секторів (у будь-якому стані); «tof reinit» — повторна " \
                  "ініціалізація відмовивших далекомірів (лише в DISARMED). Поріг перешкоди з консолі не змінюється."

void console_fmt_tof_error(char *buf, size_t n, const console_tof_t *p)
{
    switch (p->form) {
    case CONSOLE_TOF_ERR_THRESHOLD:
        snprintf(buf, n, "Команда tof: поріг перешкоди з консолі не змінюється — це виміряна величина, її змінює лише "
                         "правка прошивки після запису в журнал вимірювань." TOF_USAGE);
        return;
    case CONSOLE_TOF_ERR_EXTRA:
        snprintf(buf, n, "Команда tof: зайві слова." TOF_USAGE);
        return;
    case CONSOLE_TOF_ERR_WORD:
        snprintf(buf, n, "Команда tof: невідоме слово." TOF_USAGE);
        return;
    default:
        snprintf(buf, n, "Хибна форма команди tof." TOF_USAGE);
        return;
    }
}

void console_fmt_tof_denied(char *buf, size_t n, app_state_t state)
{
    snprintf(buf, n, "Стан %s: повторна ініціалізація далекомірів можлива лише в DISARMED — вона торкається ліній скидання "
                     "датчиків на розширювачі портів, а під час руху чи аварії скидання заборонене (роззброїти: disarm).",
             app_state_name(state));
}

bool console_pid_allowed(console_pid_form_t form, app_state_t state)
{
    switch (form) {
    case CONSOLE_PID_ON:
    case CONSOLE_PID_OFF:
        return state == APP_STATE_DISARMED;
    case CONSOLE_PID_SAVE:
        return state != APP_STATE_ARMED && state != APP_STATE_OBSTACLE_HOLD;
    default:
        return true;
    }
}

#define PID_USAGE " Допустимо: «pid» — стан; «pid kp|ki|kd|ramp <число>» — змінити число (kp, ki, kd — скінченні й " \
                  "невідʼємні, ramp — додатний, десяткова крапка); «pid on», «pid off» — увімкнути чи вимкнути " \
                  "(лише в DISARMED); «pid save» — зберегти (не під час руху); «pid trace on», «pid trace off» — трасування."

void console_fmt_pid_error(char *buf, size_t n, const console_pid_t *p)
{
    switch (p->form) {
    case CONSOLE_PID_ERR_LIMIT:
        snprintf(buf, n, "Межу потужності з консолі не змінити: межа потужності — виміряна величина, її змінює лише "
                         "правка прошивки після запису в журнал вимірювань.");
        return;
    case CONSOLE_PID_ERR_VALUE:
        snprintf(buf, n, "Команда pid: %s — %s." PID_USAGE, pid_param_name(p->param), p->why ? p->why : "недопустиме число");
        return;
    case CONSOLE_PID_ERR_NUMBER:
        snprintf(buf, n, "Команда pid: значення не число — потрібні цифри з десятковою крапкою (не кома), без nan, inf і "
                         "експоненти." PID_USAGE);
        return;
    case CONSOLE_PID_ERR_MISSING:
        snprintf(buf, n, "Команда pid: бракує значення." PID_USAGE);
        return;
    case CONSOLE_PID_ERR_EXTRA:
        snprintf(buf, n, "Команда pid: зайві слова." PID_USAGE);
        return;
    case CONSOLE_PID_ERR_WORD:
        snprintf(buf, n, "Команда pid: невідоме слово." PID_USAGE);
        return;
    default:
        snprintf(buf, n, "Хибна форма команди pid." PID_USAGE);
        return;
    }
}

void console_fmt_pid_denied(char *buf, size_t n, console_pid_form_t form, app_state_t state)
{
    if (form == CONSOLE_PID_SAVE) {
        snprintf(buf, n, "Стан %s: запис набору в памʼять плати під час руху заборонений — збережіть поза ARMED і "
                         "OBSTACLE_HOLD (роззброївши ровер).", app_state_name(state));
    } else {
        snprintf(buf, n, "Стан %s: вмикати й вимикати регулятор можна лише в стані DISARMED.", app_state_name(state));
    }
}

// ---------- Команда report і поля status (phase8-session-report) ----------

static void cat(char *buf, size_t n, size_t *pos, const char *fmt, ...) __attribute__((format(printf, 4, 5)));
static void cat(char *buf, size_t n, size_t *pos, const char *fmt, ...)
{
    if (*pos + 1 >= n) {
        return;
    }
    va_list ap;
    va_start(ap, fmt);
    int w = vsnprintf(buf + *pos, n - *pos, fmt, ap);
    va_end(ap);
    if (w < 0) {
        buf[*pos] = '\0';
    } else if ((size_t)w >= n - *pos) {
        *pos = n - 1;
    } else {
        *pos += (size_t)w;
    }
}

static void fmt_queue(char *buf, size_t n, size_t *pos, const console_report_view_t *v)
{
    if (v->queued == 0) {
        cat(buf, n, pos, "звіти: черга порожня");
        return;
    }
    cat(buf, n, pos, "звіти: у черзі %u:", (unsigned)v->queued);
    for (uint8_t i = 0; i < v->queued && i < REPORT_Q_SLOTS; i++) {
        cat(buf, n, pos, "%s сесія %lu (%s)", i ? "," : "", (unsigned long)v->q_seq[i], report_end_reason_text(v->q_reason[i]));
    }
}

static void fmt_mode(char *buf, size_t n, size_t *pos, const console_report_view_t *v)
{
    if (!v->ctl_on) {
        cat(buf, n, pos, "контроль перешкод: вимкнено");
        return;
    }
    cat(buf, n, pos, "контроль перешкод: увімкнено%s, %s", v->ctl_default ? " (за замовчуванням, пульт не підтвердив)" : "",
        v->guarding ? "охороняє" : "не охороняє");
}

void console_fmt_report(char *buf, size_t n, const console_report_view_t *v)
{
    if (buf == NULL || n == 0) {
        return;
    }
    buf[0] = '\0';
    if (v == NULL) {
        return;
    }
    size_t pos = 0;
    fmt_queue(buf, n, &pos, v);
    cat(buf, n, &pos, "\n");
    fmt_mode(buf, n, &pos, v);
    cat(buf, n, &pos, "\nмережа: налаштування %s; остання спроба: %s", v->config_ok ? "задано" : "не задано",
        report_outcome_text(v->last_outcome));
    if (v->last_outcome != REPORT_OUT_NONE) {
        cat(buf, n, &pos, " (%lu мс від старту)", (unsigned long)v->last_outcome_ms);
    }
    if (!v->acted) {
        return;
    }
    switch (v->gate) {
    case REPORT_GO:
        cat(buf, n, &pos, "\nспробу запущено");
        break;
    case REPORT_DENY_BUSY:
        cat(buf, n, &pos, "\nпередача вже триває");
        break;
    case REPORT_DENY_EMPTY:
        cat(buf, n, &pos, "\nнічого надсилати, Wi-Fi не вмикається");
        break;
    case REPORT_DENY_NO_CONFIG:
        cat(buf, n, &pos, "\nналаштування мережі не задано, передача не починається%s%s%s",
            v->config_problem && v->config_problem[0] ? " (" : "", v->config_problem ? v->config_problem : "",
            v->config_problem && v->config_problem[0] ? ")" : "");
        break;
    case REPORT_DENY_STATE:
        cat(buf, n, &pos, "\nпередача можлива лише в DISARMED (зараз %s)", app_state_name(v->state));
        break;
    }
}

void console_fmt_tof_control_status(char *buf, size_t n, const console_report_view_t *v)
{
    if (buf == NULL || n == 0) {
        return;
    }
    buf[0] = '\0';
    size_t pos = 0;
    if (v != NULL) {
        fmt_mode(buf, n, &pos, v);
    }
}

void console_fmt_report_status(char *buf, size_t n, const console_report_view_t *v)
{
    if (buf == NULL || n == 0) {
        return;
    }
    buf[0] = '\0';
    if (v == NULL) {
        return;
    }
    size_t pos = 0;
    cat(buf, n, &pos, "звіти: у черзі %u, остання спроба: %s, налаштування мережі: %s, радіо: %s", (unsigned)v->queued,
        report_outcome_text(v->last_outcome), v->config_ok ? "задано" : "не задано", v->busy ? "спроба триває" : "вимкнено");
}
