12romis/esp32-elrs-rover/(commit log)

2026-10-16 init kicad
2026-10-18 Фаза 0: консоль, сторожовий таймер, автомат станів (phase0-skeleton) (#1)
    * phase0_sad
    * tasks: phase0-skeleton breakdown + tasks.json; reboot дозволено в BOOT (AC-05)
    Розбиття фази 0 на 9 задач (T1–T9), tasks.json; за рішенням Розробника
    команда reboot дозволена також у стані BOOT, wdt-test лише в DISARMED.
    * implement: phase0-skeleton roadmap.md building
    * feat(phase0-skeleton): хостовий раннер і скрипти перевірок test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
2026-10-18 Специфікація фази 1: консольне керування моторами (phase1-drive)
2026-10-18 Розмір M і маршрут standard для phase1-drive
2026-10-18 Глосарій: борт, відсічка по напрузі, команда руху, мікшер
2026-10-18 Роадмап: крок 1 phase1-drive має специфікацію
2026-10-18 Фаза 1: специфікація, дизайн, ADR і розбиття на задачі (phase1-drive)
2026-10-18 Фаза 1: battery — вимірювання напруги, поріг 6000 мВ, знімок
2026-10-18 Фаза 1: drive — мікшер, вікно команди 2 с, відсічка, задача control
2026-10-18 Фаза 1: консоль (arm, disarm, drive, остання зупинка) і старт у main
2026-10-18 Фаза 1: приймання на залізі, review і виміри
2026-10-18 ship: phase1-drive changelog і тіло PR
2026-10-18 Фаза 2: шина I2C, світло, зумер, індикація станів
    i2c_bus, ioexp, ui (core і HAL), команди light і beep, задні ліхтарі й фари
    за станом, FAILSAFE-індикація, сигнали переходів, діагностика P8 і P9,
    хостові тести й перевірка check_bus_rules.sh.
2026-10-18 Фаза 2: специфікація, SAD, ADR, контракт, задачі, приймання і review
2026-10-18 ship: phase2-io changelog і тіло PR
2026-10-18 design: phase3-crsf ADR-0001 рішення про втрату звʼязку в control
2026-10-18 design: phase3-crsf ADR-0002 причина FAILSAFE в автоматі
2026-10-18 design: phase3-crsf ADR-0003 намір пілота і розведення джерел
2026-10-18 measured: фаза 3 OQ-1 знаки і крайні значення стіка
2026-10-18 T1: crsf_core — збирач кадрів, CRC8, розпакування каналів, лічильники
    SDD-Task: T1
    SDD-AC: AC-06
    SDD-AC: AC-10
    SDD-AC: AC-11
2026-10-18 T3: app_state — причина FAILSAFE, підвищення до «напруга», охорона виходу FAILSAFE → DISARMED
    SDD-Task: T3
    SDD-AC: AC-08
    SDD-AC: AC-09
    SDD-AC: AC-17
2026-10-18 T8: ui_core — вихід із FAILSAFE гасить блимання й періодичний писк (виправлено прапорець failsafe)
    SDD-Task: T8
    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
2026-10-18 T2: crsf_core — намір пілота (мертва зона, тумблер, фронт) і рядки status
    SDD-Task: T2
    SDD-AC: AC-02
    SDD-AC: AC-12
    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
2026-10-18 T4: drive_ctl_step — стендовий режим, таймер звʼязку, FAILSAFE при втраті звʼязку, відмова «керує пульт»
    SDD-Task: T4
    SDD-AC: AC-05
    SDD-AC: AC-07
    SDD-AC: AC-13
    SDD-AC: AC-14
    SDD-AC: AC-15
    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
2026-10-18 T7: crsf_hal — UART2 420000 8N1, задача crsf_rx, знімок під portMUX, Task WDT
    SDD-Task: T7
    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
2026-10-18 T5: drive_ctl_step — озброєння фронтом тумблера, рух стіком, роззброєння тумблером і з консолі
    SDD-Task: T5
    SDD-AC: AC-01
    SDD-AC: AC-03
    SDD-AC: AC-04
    SDD-AC: AC-16
    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
2026-10-18 T6: drive_ctl_step — вихід із FAILSAFE після ≥ 1 с стабільного звʼязку, відсічка у FAILSAFE через звʼязок
    SDD-Task: T6
    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
2026-10-18 T9: drive_hal — знімок приймача, причина FAILSAFE, журнал подій звʼязку; crsf_start у main
    SDD-Task: T9
    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
2026-10-18 T10: консоль — help, пояснення disarm за причиною FAILSAFE, рядки status про пульт
    SDD-Task: T10
    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
2026-10-18 T11: матриця 126 пар «команда × стан × режим» і перевірка vTaskDelay у періодичних задачах
    SDD-Task: T11
    SDD-AC: AC-18
    SDD-AC: AC-19
2026-10-18 T12: чекліст приймання фази 3 на залізі
    SDD-Task: T12
    SDD-AC: AC-20
2026-10-18 Фаза 3: результати приймання на залізі, друга точка калібрування напруги (OQ-3)
2026-10-18 battery: двоточкове калібрування напруги (k 3.973, зсув +151 мВ) за P3
2026-10-18 T13: drive_core — беззнакове порівняння віку кадру й тривалості звʼязку (огляд F6)
    Задачі T13–T18 додано за оглядом 2026-10-18. Знакова різниця ламалась через 2^31 мс без кадрів: звʼязок ставав «живим».
    SDD-Task: T13
    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
2026-10-18 T14: status показує тумблер «невідомо», поки база фронту невідома (огляд F4)
    Показ береться з бази фронту кроку керування (drive_switch_shown): у стенді й після втрати звʼязку — «невідомо», а не DISARM.
    SDD-Task: T14
    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
2026-10-18 T15: пояснення виходу з FAILSAFE за причиною у відмовах консолі й у status (огляд F2)
    Після втрати звʼязку відмова класу 1 називає вихід пультом або скиданням, після відсічки — лише скиданням; status показує, чого бракує для виходу. Буфер status — статичний, 800 байтів.
    SDD-Task: T15
    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
2026-10-18 T16: відповідь arm у стенді називає джерело керування «стенд» (огляд F3)
    SDD-Task: T16
    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
2026-10-18 T17: без підписки control на Task WDT мотори не вмикаються й з пульта (огляд F1)
    Крок керування з outputs_inhibited тримає виходи вимкненими й не запитує ARMED; зупинки (DISARMED, FAILSAFE) лишаються.
    SDD-Task: T17
    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
2026-10-18 T18: журнал затримки «кадр → борти» для NFR ≤ 50 мс і крок виміру в приймання (огляд F5)
    control рахує затримку від мітки кадру crsf_rx до запису команди бортам і раз на 5 с їзди з пульта друкує мін/сер/макс; acceptance.md — крок 13 замість оцінки «на око».
    SDD-Task: T18
    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
2026-10-18 review: phase3-crsf spec.md — OQ-2 закрито за залізом, чинне калібрування в OQ-3
2026-10-18 review: phase3-crsf acceptance.md — залишок OQ-2 закрито
2026-10-18 review: phase1-drive spec.md — OQ-1 закрито (двоточкове калібрування напруги)
2026-10-18 specify: phase4-encoders spec.md
2026-10-18 specify: phase4-encoders .size+.route (S, route quick)
2026-10-18 specify: phase4-encoders CONTEXT.md
2026-10-18 specify: roadmap.md (крок 4 spec'd, розмір S; D3 закрито за ENC_NEEDS_PULLUP = 0)
2026-10-18 measured: WHEEL_DIAMETER_MM = 44 мм (штангенциркуль)
2026-10-18 clarify: phase4-encoders spec.md (11 resolved, 0 deferred; OQ-1 закрито)
2026-10-18 clarify: phase4-encoders CONTEXT.md
2026-10-19 design: phase4-encoders ADR-0001 sample-encoders-in-a-dedicated-20ms-task-and-publish-a-snapshot
2026-10-19 design: phase4-encoders ADR-0002 accumulate-counts-by-modular-difference-in-encoders-core
2026-10-19 design: phase4-encoders sad.md
2026-10-19 api: phase4-encoders cli.md
2026-10-19 api: phase4-encoders api-sync-report.md
2026-10-19 tasks: phase4-encoders breakdown + tasks.json
2026-10-19 implement: phase4-encoders roadmap.md building
2026-10-19 implement: phase4-encoders T1 encoders_core — приріст за модулем, знак колеса, накопичувач, обнулення
    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
2026-10-19 implement: phase4-encoders T2 швидкість колеса — приріст на фактичний час, лічильник інтервалів
    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
2026-10-19 implement: phase4-encoders T3 одиниці, доступність коліс, тексти знімка, enc reset і status
    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
2026-10-19 implement: phase4-encoders T4 команда enc у консолі — дві форми, хибні аргументи, усі стани, help
    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
2026-10-19 implement: phase4-encoders T5 encoders_hal — 4 блоки лічильника, фільтр 1000 нс, задача 20 мс, стан під portMUX
    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
2026-10-19 implement: phase4-encoders T6 encoders_start і колбеки консолі в main
    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
2026-10-19 implement: phase4-encoders T7 check_calib.sh — константи енкодерів проти measured.md, прогін запобіжників
    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
2026-10-19 implement: phase4-encoders T8 acceptance.md — процедура приймання на залізі
    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
2026-10-19 review: phase4-encoders review-2026-10-19.md
2026-10-19 review: phase4-encoders spec.md deferred findings
2026-10-19 implement: phase4-encoders задачі-виправлення T9–T12 за review-2026-10-19
2026-10-19 implement: phase4-encoders T9 швидкість лише за інтервал ≥ половини номіналу, рух коротких вибірок не губиться (review F1)
    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
2026-10-19 implement: phase4-encoders T10 причина недоступності — вказівник на статичний рядок, стан 184 байти (review F5)
    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
2026-10-19 implement: phase4-encoders T11 відмова enc називає причину — невідоме слово, помилка в reset, зайве слово (review F2)
    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
2026-10-19 implement: phase4-encoders T12 acceptance.md — крок AC-03 у FAILSAFE, час хостового прогону (review F3, F4)
    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
2026-10-19 review: phase4-encoders review-2026-10-19-r2.md
2026-10-19 review: phase4-encoders spec.md — OQ-2 закрито виміром
2026-10-19 review: phase4-encoders sad.md — правило мінімального інтервалу (N1)
2026-10-19 review: phase4-encoders encoders_core.h — коментар last_us (N2)
2026-10-19 review: phase4-encoders acceptance.md — OQ-2 закрито
2026-10-19 ship: phase4-encoders acceptance.md — результати приймання на залізі, кроки 1–13
2026-10-19 ship: phase4-encoders measured.md — приймання фази 4, памʼять, відстань 1 м, KPI швидкостей коліс
2026-10-19 ship: phase4-encoders T5, T6, T8 done — приймання записано
2026-10-19 ship: phase4-encoders changelog
2026-10-19 ship: phase4-encoders _pr-body.md
2026-10-19 ship: phase4-encoders roadmap.md shipped
2026-10-19 specify: phase5-pid spec.md
2026-10-19 specify: phase5-pid .size+.route
2026-10-19 specify: phase5-pid CONTEXT.md
2026-10-20 clarify: phase5-pid spec.md (11 resolved, 0 deferred; OQ-3 closed)
2026-10-20 clarify: phase5-pid CONTEXT.md
2026-10-20 design: phase5-pid ADR-0001 run-speed-regulator-inside-control-step-from-encoder-snapshot
2026-10-20 design: phase5-pid ADR-0002 store-coefficient-set-as-one-versioned-crc-checked-nvs-record
2026-10-20 design: phase5-pid ADR-0003 print-regulator-trace-from-low-priority-task
2026-10-20 design: phase5-pid sad.md
2026-10-20 design: phase5-pid spec.md (AC-12b, такт регулятора, AC-15)
2026-10-20 sequences: phase5-pid sad.md runtime flows (потік 5, без заклинювання)
2026-10-20 sequences: phase5-pid spec.md (заклинювання й підняття межі винесено)
2026-10-20 sequences: phase5-pid CONTEXT.md
2026-10-20 sequences: roadmap.md (заклинювання й межа — Not yet specified)
2026-10-20 tasks: phase5-pid breakdown + tasks.json
2026-10-20 review: phase5-pid review-2026-10-20.md
2026-10-20 review: phase5-pid review-2026-10-20-r2.md
2026-10-20 review: phase5-pid review-2026-10-20-r3.md
2026-10-20 review: phase5-pid review-2026-10-20-r4.md
2026-10-20 review: phase5-pid review-2026-10-20-r5.md
2026-10-20 implement: phase5-pid регулятор швидкості бортів, команда pid, збереження набору в NVS
    pid_core/pid_hal, регулятор у drive_ctl_step, команда pid у консолі,
    хостові тести (6704) і check_power_limit.sh. Апаратне приймання — за acceptance.md.
    SDD-Task: T11-T23
    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
2026-10-20 implement: phase5-pid задачі T1–T23, tracker і acceptance.md
    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
2026-10-20 docs: конституція — прибрано рядок про межу 0.75 до завершення фази 5 (review F7)
    Межу стереже test/host/check_power_limit.sh; підняття винесено з фази 5.
2026-10-20 ship: phase5-pid changelog
2026-10-20 ship: phase5-pid roadmap.md shipped
2026-10-20 specify: roadmap.md (крок 6 spec'd, розмір S)
2026-10-20 measured: вибіг ровера ≤ 30 мм, мінімум порогу ≈ 128 мм
2026-10-20 specify: phase6-tof spec.md (OQ-3 закрито, OQ-1 частково)
2026-10-20 measured: TOF_OBSTACLE_MM = 170 мм
2026-10-20 specify: phase6-tof spec.md (OQ-1 закрито)
2026-10-20 design: phase6-tof ADR-0002 let ioexp own the whole expander byte including the sensor reset lines
2026-10-20 design: phase6-tof ADR-0003 poll rangefinders in a separate sensors task and detect failure there
2026-10-20 design: phase6-tof spec.md (AC-08 послаблено: пауза опитування під час reinit)
2026-10-20 sequences: phase6-tof sad.md runtime flows
2026-10-20 implement: phase6-tof T1 tof_core: медіана, сектори, зайнятість, звільнення, відмова, поріг 170 мм
    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
2026-10-20 implement: phase6-tof T3 app_state: предикат «ровер їде» і пара OBSTACLE_HOLD → DISARMED (12 пар)
    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
2026-10-20 implement: phase6-tof T4 ioexp_core: розряди скидання далекомірів у тіньовому регістрі, збирання байта зі збереженням
    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
2026-10-20 implement: phase6-tof T2 tof_core: обмеження тяги пари бортів, тексти показу і входу в утримання
    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
2026-10-20 design: phase6-tof sad.md та ADR-0001 (уточнення: найбільший модуль борту не зростає)
2026-10-20 implement: phase6-tof T7 ui_core: OBSTACLE_HOLD — задні ліхтарі авто, вхід у рух вмикає фари й сигнал, ARMED ↔ HOLD тихий
    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
2026-10-20 implement: phase6-tof T8 console_core: команда tof (показ, reinit), матриця дозволів, drive в OBSTACLE_HOLD; диспетчер у console_hal
    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
2026-10-20 implement: phase6-tof T9 ioexp_hal: ioexp_hal_xshut і внутрішній мʼютекс запису байта
    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
2026-10-20 implement: phase6-tof T5 drive_core: знімок далекомірів, обмеження тяги після мікшера, запити ARMED ↔ OBSTACLE_HOLD, застарілий знімок
    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
2026-10-20 implement: phase6-tof T6 drive_core: відсічка, втрата звʼязку, пульт, роззброєння, вікно, регулятор і трасування діють і в OBSTACLE_HOLD
    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
2026-10-21 implement: phase6-tof T10 tof_hal: драйвер VL53L0X (порт p4_tof.c) і послідовність лінії скидання з новими адресами
    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
2026-10-21 implement: phase6-tof T11 tof_hal: задача sensors, знімок під portMUX, відмова за 250 мс, tof reinit у DISARMED
    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
2026-10-21 implement: phase6-tof T12 drive_hal: знімок далекомірів, OBSTACLE_HOLD ↔ ARMED без pid_hal_arm_begin, журнал, предикат руху
    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
2026-10-21 implement: phase6-tof T13 main: старт tof після ioexp і encoders, колбеки консолі tof_show і tof_reinit
    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
2026-10-21 implement: phase6-tof T14 тести: паралельний хостовий раннер (≈ 0.7 с), selftest check_calib для tof і check_delays
    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
2026-10-21 implement: phase6-tof T15 acceptance.md: процедура приймання фази 6 на залізі
    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
2026-10-21 review: phase6-tof R4 acceptance.md (pid on до озброєння, drive -0.4 0)
2026-10-21 review: phase6-tof R8 measured.md (застаріла фраза про поріг)
2026-10-21 review: phase6-tof R1 STBY — рішення Розробника, spec A10/AC-13/OQ-3, ADR-0004, тест
2026-10-21 review: phase6-tof R2 пояснення про перешкоду на прийняту команду drive (AC-15), тест
2026-10-21 review: phase6-tof R3 мітка першого відліку менше порога в рядку OBSTACLE_HOLD (AC-01), тести
2026-10-21 review: phase6-tof R5–R7 спільна обробка запису в ioexp_hal, бюджет tof reinit, перевірка опускання XSHUT
2026-10-21 review: phase6-tof раунд 2 — прапорець XSHUT скидається в reinit, буфер і бюджет reinit, пояснення AC-15 раз на епізод, тести, документи задач
2026-10-21 ship: phase6-tof roadmap.md (форматування списку рішень)
2026-10-21 implement: phase7-telemetry — телеметрія напруги, індикація OBSTACLE_HOLD, час кроку керування
    - telemetry: кадр датчика батареї CRSF раз на 200 мс (crsf_hal_send), статистика кроку, детектор зміни
    - ui: подвійний біп на вході в OBSTACLE_HOLD і виході в ARMED, жовтий індикатор, блимання фар і задніх ліхтарів
    - drive: прапорці секторів у drive_status_t, відмітки часу навколо кроку control
    - console: рядок «крок керування» і колір індикатора в status
    C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
2026-10-21 design: phase7-telemetry — специфікація, SAD, ADR, задачі, приймання, рев'ю, документація
2026-10-21 ship: phase7-telemetry changelog і roadmap shipped
2026-10-21 changed power, indicator colour
2026-10-22 тести: узгодити очікування з комітом bc4aedd (ШІМ 950, поріг ToF 190 мм, сигнал виходу з утримання)
    Хостові тести test_drive, test_tof, test_ui і check_power_limit.sh (разом із selftest) досі
    очікували старі значення 750/170, тому базовий прогін був червоний. Поріг 190 мм записано в
    docs/measured.md як рішення Розробника. Не частина фази 8.
2026-10-22 фаза 8: контроль перешкод (CH9), індикатор, сесія і звіт сесії (код і тести)
    CH9 вмикає/вимикає зупинку перед перешкодою (за замовчуванням увімкнено), зеленуватий індикатор,
    усі датчики перешкоди в рядку консолі. Нові компоненти session (статистика в кроці керування) і
    report (JSON-звіт, власний MQTT 3.1.1 поверх TLS із закріпленим сертифікатом, черга з двох слотів
    у NVS, задача на core 0 лише в DISARMED), команда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
2026-10-22 фаза 8: документація, журнал задач, рев'ю, приймання, changelog; roadmap shipped
    README, архітектура, самоперевірка, чекліст приймання на залізі, журнал змін захищених файлів,
    запис рев'ю (PASS), changelog, оновлення контрактів і специфікації (OQ-7), roadmap.
    SDD-Task: T16 T17
2026-10-22 фаза 8: нормалізація адреси сервера, причина відключення Wi-Fi, менше логів бібліотеки Wi-Fi
    Виявлено під час приймання на залізі: REPORT_MQTT_HOST зі схемою mqtts:// ламав DNS (getaddrinfo 202).
    mqtt_core_host_normalize відкидає схему, порт і шлях; у журнал додано причину відключення Wi-Fi без SSID;
    теги wifi, wifi_init, pp, net80211, esp_netif_handlers піднято до WARN.
2026-10-22 ship: phase8-session-report changelog з результатами приймання на залізі
2026-10-22 тести: прибрати реальну адресу сервера з test_mqtt.c (check_secrets.sh)
